hoglet67/RGBtoHDMI/kicad_AmigaAdapter/V2/deniseadapter_bom.ods

Manufacturer | Manufacturer Number | Designator | Qty | Description | Case | SMD/TH
Texas Instruments | SN74LVC86APWR | U1 | 1 | Quad XOR | TSSOP-14 | SMD
Texas Instruments | SN74LVC574APWRG4 | U2,U3 | 2 | Octal Flip-Flop | TSSOP-20 | SMD
Texas Instruments | TLV74333PDBVR | U4 | 1 | LDO Voltage Regulator | SOT-23-5 | SMD
any |  | R1 | 1 | Thick film resistor, 3.3k Ohm, 1% | 2012 | SMD
any |  | C1,C2,C3 | 3 | Ceramic capacitor 100nF | 1608 | SMD
any |  | C4 | 1 | Ceramic capacitor 1uF | 2012 | SMD
any |  | Jdenise1,JDenise2 | 2 | Precision IC-Socket, 24 pn | DIP-24 | TH
any |  | Jbutton1 | 1 | Angled pin header, 2 pins | RM 2.54 | TH
any |  | JP1 | 1 | Angled pin header, 3 pins | RM 2.54 | TH
any |  | JraspberryPiZero1 | 1 | Female pin header 20x2 pins | RM 2.54 | TH
Assmann | WSW AR 24-ST/T | JmainBoard1,JMainBoard2 | 2 | IC socket adapter | DIP-24 | TH
Remarks: Cut away the interconnects on the IC socket adapters before soldering. This allows you to reach the the solder points for the other side.
