hoglet67/RGBtoHDMI/src/scripts/Profiles/6-12_BIT_RGB/_Test/Test_12BPP-Composite.txt

sampling=6,6,6,6,6,6,6,0,1,0,4,0,0,0,0,0,0,5,0,0,100,256,100,256,100,256,0,256
geometry=188,33,640,256,720,280,1,2,1,2,16000000,1024,15000,312,4,0,0
hdmi_standby=1
palette=RrGgBb_(EGA)
overclock_core=50
powerup_message=0
