hoglet67/RGBtoHDMI/src/scripts/Profiles/3-12_BIT_BBC/_Test/Test_3BPP-Comp(B).txt

sampling=5,5,5,5,5,5,5,0,1,0,4,0,0,0,0,0,0,0,0,0,100,256,100,256,100,256,0,256
geometry=188,33,640,256,720,280,1,2,1,2,16000000,1024,15000,312,4,0,0
powerup_message=0
