hoglet67/RGBtoHDMI/src/scripts/Profiles/3-12_BIT_BBC_Analog/_Test/Test_3LVL_Term.txt

sampling=6,6,6,6,6,6,6,0,1,0,4,0,0,0,0,0,0,1,1,0,55,16,55,16,100,256,256,17
geometry=188,33,640,256,720,280,1,2,1,2,16000000,1024,15000,312,4,0,0
palette=RGBrgb_(Amstrad)
powerup_message=0
