hoglet67/RGBtoHDMI/src/scripts/Profiles/6-12_BIT_YUV_Analog/_Test/Test_3LVL_Term+Clamp.txt

sampling=4,4,4,4,4,4,4,0,1,0,4,0,0,0,0,0,0,1,1,1,65,26,55,16,100,256,10,17
geometry=188,33,640,256,720,280,1,2,1,2,16000000,1024,15000,312,4,0,0
palette=RGBrgb_(Amstrad)
powerup_message=0
