hoglet67/RGBtoHDMI/src/scripts/Profiles/6-12_BIT_YUV_Analog/_Test/Test_4LVL_Term.txt

sampling=4,4,4,4,4,4,4,0,1,0,4,0,0,0,0,3,0,2,1,0,55,34,55,34,100,15,15,15
geometry=188,33,640,256,720,280,1,2,1,2,16000000,1024,15000,312,4,0,0
palette=RrGgBb_(EGA)
powerup_message=0
