hoglet67/RGBtoHDMI/src/scripts/Profiles/6-12_BIT_RGB_Analog/_Test_/Multi_Test_Mono_/Mode3_3LVL_NoTerm-C.txt

sampling=6,6,6,6,6,6,6,0,1,0,4,0,0,0,0,0,1,1,0,0,122,60,256,256,256,10,256,256
geometry=180,35,640,256,720,280,1,2,1,2,16000000,1024,5000,314,4,6,0
palette=Mono_(3_level)
powerup_message=0
