hoglet67/RGBtoHDMI/src/scripts/Profiles/6-12_BIT_RGB_Analog/_Test_/Multi_Test_Colour/Mode3_3LVL_NoTerm-C.txt

sampling=6,6,6,6,6,6,6,0,1,0,4,0,0,0,0,0,0,1,0,0,134,68,134,68,100,256,256,87
geometry=188,35,640,256,720,280,1,2,1,2,16000000,1024,5000,314,4,6,0
palette=RGBrgb_(Amstrad)
powerup_message=0
