hoglet67/RGBtoHDMI/src/scripts/Profiles/6-12_BIT_RGB_Analog/_Test_/Multi_Test_Colour/ModeF_192Mhz_Test.txt

sampling=0,0,0,0,0,0,0,0,5,0,8,0,0,0,0,0,0,7,1,0,65,32,65,32,100,48,48,48
geometry=132,39,480,256,576,288,3,4,1,1,12000000,768,5000,318,4,6,0
palette=RrGgBb_(EGA)
powerup_message=0
