hoglet67/RGBtoHDMI/src/scripts/Profiles/6-12_BIT_RGB_Analog/_Test_/Multi_Test_Mono_/ModeF_192Mhz_Test.txt

sampling=4,4,4,4,4,4,4,0,5,0,8,0,0,0,0,0,1,1,1,0,65,36,256,256,256,12,256,256
geometry=132,39,480,256,576,288,3,4,1,1,12000000,768,5000,318,4,6,0
palette=Mono_(3_level)
powerup_message=0
