hoglet67/RGBtoHDMI/src/scripts/Profiles/6-12_BIT_RGB/_Test/Multi_Test/modeD_192Mhz_Test.txt

sampling=1,1,1,1,1,1,1,0,5,0,8,0,0,0,0,0,0,5,0,0,120,256,120,256,120,256,256,256
geometry=128,32,480,256,576,288,3,4,1,2,12000000,768,5000,314,0,6,0
palette=RrGgBb_(EGA)
teletext_deinterlace=2
teletext_scaling=0
powerup_message=0
