hoglet67/RGBtoHDMI/src/scripts/Profiles/6-12_BIT_RGB_Analog/_Test_/Multi_Test_/modeD_192Mhz_Test.txt

sampling=1,1,1,1,1,1,1,0,5,0,8,0,0,0,0,0,0,7,1,0,55,16,55,16,100,34,34,34
geometry=132,35,480,256,576,288,3,4,1,1,12000000,768,5000,314,5,6,0
palette=RrGgBb_(EGA)
powerup_message=0
