hoglet67/RGBtoHDMI/src/scripts/Profiles/6-12_BIT_RGB/_Test/Multi_Test/ModeC_TS9347_80-8LVL_NoTerm.txt

sampling=6,6,6,6,6,6,6,0,1,0,4,0,0,0,0,3,0,4,0,0,227,53,192,18,100,157,124,88
geometry=124,32,480,256,584,288,3,4,1,2,14318181,768,5000,312,0,6,0
palette=Mono_(8_level_RGB)
powerup_message=0
