hoglet67/RGBtoHDMI/src/scripts/Profiles/6-12_BIT_RGB_Analog/_Test_/Multi_Test_/ModeB_TS9347_40-8LVL_NoTerm.txt

sampling=4,4,4,4,4,4,4,0,1,0,4,0,0,0,0,3,0,7,0,0,227,53,192,18,100,157,124,88
geometry=92,29,320,256,384,288,1,1,3,1,9545454,512,5000,312,4,6,0
palette=Mono_(8_level_RGB)
powerup_message=0
