hoglet67/RGBtoHDMI/src/scripts/Profiles/6-12_BIT_YUV_Analog/_Test_/Multi_Test_/ModeB_TS9347_40-8LVL_NoTerm.txt

sampling=0,0,0,0,0,0,0,0,1,0,4,0,0,0,0,3,0,2,0,0,227,192,157,124,100,88,53,18
geometry=92,29,320,256,384,288,1,1,3,1,9545454,512,5000,312,4,6,0
palette=Mono_(8_level_YUV)
powerup_message=0
