hoglet67/RGBtoHDMI/src/scripts/Profiles/6-12_BIT_YUV_Analog/_Test_/Multi_Test_/ModeC_TS9347_80-8LVL_NoTerm.txt

sampling=3,3,3,3,3,3,3,0,1,0,4,0,0,0,0,3,0,2,0,0,227,192,157,124,100,88,53,18
geometry=124,32,480,256,584,288,3,4,1,1,14318181,768,15000,312,5,6,0
palette=Mono_(8_level_YUV)
powerup_message=0
