hoglet67/RGBtoHDMI/(threads)

Thread 9 (2018-11-18):

Use PLLA or PLLD as the GPCLK source

hoglet67, 2018-11-18:
Seems this should be possible.

Advantage is that the core clock speed can remain at 400MHz.

Not clear that it can be set via the firmware property interface.

So would need to include some code to set the PLL registers directly.

Possible code to do this here:
https://github.com/F5OEO/librpitx/blob/8d0ff49fa7d7dc5f98c83a9876000254ae9edbaf/src/gpio.cpp#L139

hoglet67, 2019-04-27:
Another thought: this would probably overcome the issue preventing us using the latest firmware:
https://github.com/raspberrypi/firmware/issues/1022

hoglet67, 2019-04-27:
I've made an attempt at this, in the end using PLLD.

I believe that:
- PLLA is the parent clock for: the audio and PWM outputs
- PLLD is the parent clock for: the camera clock

It would be good to make sure this is the case!

I picked PLLD as it's enabled by default, and gives a GPCLK source of 500MHz (prior to the GPCLK divider). I believe the PLL is actually running at 1000MHz in this case.

Rather arbitrarily, I've allowed the PLL range to be 1000MHz to 15000MHz, giving a GPCLK source of 500MHz to 750MHz. That should be sufficient range, given we can set the GPCLK divider to pretty much any integer value we like.

I couldn't find a mailbox set_clock call that worked for either PLLA or PLLA, so in the end I re-used the same code we've been using to set PLLH by writing to the registers.

I'll push this to dev now, and if you spot any issues Ian then please let me know. I've tested all the profiles, and none of them hang, but that's as far as I've been able to test.

There are two main benefits to making this change:
1. We can now set the core clock to 400MHz independently, which might help in some of the capture loops
2. We can now use the latest firmware (I did just quickly try this, and it's fine).

hoglet67, 2019-04-27:
Some links about the PLLs and/or clock tree:
https://patchwork.kernel.org/patch/8455241/
https://github.com/miegl/PiFmAdv/blob/master/src/pi_fm_adv.c#L409

IanSB, 2019-04-28:
This seems to work OK so far with the PC based profiles on the Pi zero.
It also seems to work a lot better on the PI3 and now works on the 3+ with new firmware:
Mode 0 double height no longer has glitches and I can even select double height and width with no glitches but strangely double width on its own has glitches.
On the PC side CGA mode (14.3Mhz clock) is glitch free in double width plus double height & width but has glitches in double height only which is different behaviour to BBC mode 0.

I can even get glitch free EGA (640x350) in double height & width on the Pi 3 and that doesn't work on the Pi zero although the Pi3 still won't work at VGA resolutions. Definitely something strange about the behaviour of the Pi 3 when some lower bandwidth things don't work properly and some higher bandwidth things do. I tried setting the core to 500Mhz and that helped a bit with VGA but CGA double height had exactly the same glitches so perhaps there is still some dynamic switching feature on the Pi3 that needs to be disabled.

Mode 7 on the Pi3 is still a bit glitchy but less so and I suspect some reworking of the capture loop might fix that so maybe I'll look at that someday.
Overall there seems to be more headroom as I suppose the core memory speed is no longer reduced to match the sample clock.  The Pi3 still won't run at the highest VGA speeds but it certainly has more potential to work with all the standard TV and PC CGA/EGA modes in some form or other if mode 7 can be fixed.
Seems like it's worth updating the firmware to the latest one now as well.

hoglet67, 2019-04-28:
Good to hear you've not hit any issues with this.

I'm still slightly nervous about what else might be using PLLD by default. I do wonder if it's being used by the SDRAM, and by changing it from 500MHz to (upto) 750MHz we are inadvertently overclocking it quite significantly.

Also, I suspect the PLL is actually running at 4x this rate. The documented range of the PLLs is 600MHz-2400MHz, so we should probably use 400MHz->600MHz, not 500MHz->750MHz.

The highest clock we need to generate is 192MHz isn't it? What other highish ones are there?

I'm going to investigate this some more today, and see if I can somehow dump the whole clock tree.

So in the mean time, hold off making any other changes that rely on this being in place.

IanSB, 2019-04-28:
The highest PC clocks are:
VGA text: 28.322Mhz x 6 = 169.932Mhz
VGA Graphics: 25.175Mhz x 6 = 151.05Mhz
I noticed that with the old code, the highest pixel clocks didn't necessarily produce the highest PLL clock speed due to the dividers selected so that may still be true
Some other pixel clocks used by PC = 16Mhz, 16.257Mhz,  14.318181Mhz , 14.161Mhz, 14.171Mhz, 18.013483 Mhz

hoglet67, 2019-04-28:
I'm fairly sure that PLLD is used as the parent clock source for the SDRAM PLL:

So I've been investigating using PLLA. My understanding is the PLLA is generally only used when you specify GPU clocks that are different to the core clocks.

These are the initial PLLA register values:
```
DEBUG: PLLA: 1200.000000
DEBUG: PLLA: PDIV=1 NDIV=62 CTRL=0002103e FRAC=524288 DSI0=256 CORE=2 PER=256 CCP2=256
```
There are four dividers following PLLA:
- DSI0 (for the flat panel displays)
- CORE (for the GPU etc if needed)
- PER (for peripherals)
- CCP2 (for the camera)

A value of 256 means the divider is disables.

This explains why trying to use PLLA_PER as a GPCLK source has not worked for people - it's off by default.

So, I've been messing around with some code that will do two things:
- Enable PLLA_PER and set the divider to 4
- Disable PLLA_CORE so we can see if it's actually being used.

It's a bit fiddly to do this, because it's all rather undocumented, and and there are various controls to prevent accidentally writing to the registers. The code to do (configure_plla) this is not long though:
https://github.com/hoglet67/RGBtoHDMI/blob/dev/src/rgb_to_hdmi.c#L839

Anyway, the result is:
```
CCP2=256
DEBUG: PLLA: 1200.000000
DEBUG: PLLA: PDIV=1 NDIV=62 CTRL=0002103e FRAC=524288 DSI0=256 CORE=256 PER=4 CCP2=256
```
So CORE is now disabled, and PER enabled with a divider of 4.

With these values, our system will run nicely using PLLA as the source.

The PLLA_PER clock range is currently 400MHz-600MHz - this should allow any clock we need up to 200MHz to be generated accurately with an integer GPCLK divider of >= 2.

Dave

IanSB, 2019-04-28:
This new version breaks high pc clock rates
The 28Mhz clock is unusable and the screen is more glitches than video
The 25Mhz clock has a few minor glitches
Some log snippets:

INFO:  Error adjusted clock = 28321714 Hz
INFO:         GPCLK Divisor = 3
INFO:  Target PLL frequency = 1019581728 Hz
INFO:  Actual PLL frequency = 1019581728 Hz
INFO:       Core clock freq = 400000000 Hz
INFO:       Lines per frame = 449, (448.998)

INFO:  Error adjusted clock = 25174627 Hz
INFO:         GPCLK Divisor = 3
INFO:  Target PLL frequency = 906286590 Hz
INFO:  Actual PLL frequency = 906286590 Hz
INFO:       Core clock freq = 400000000 Hz
INFO:       Lines per frame = 525, (524.997)

hoglet67, 2019-04-28:
I can look at that now.

Which profile exactly are these?

hoglet67, 2019-04-28:
I've just tried the TSEND ET3000AX/VGA Text.

The correct (ish) frequency clock is being output, i.e. ~170MHz, so I've not made a stupid error withe the dividers.

So this has to be something more subtle.

Forget for now yesterday's PLLD version, as the SDRAM could will have been very overclocked.

Did these profiles work perfectly in the previous version that varied the Core Clock?

IanSB, 2019-04-28:
Yes, although it would be nice to use the direct register code with the core clock PLL as that would allow the new firmware to be used and also confirm there is no other issue with the new PLL code.

hoglet67, 2019-04-28:
I've hacked an Atom profile to use a 28.63MHz clock, and that seems to work correctly for me:
```
sampling=1,1,1,1,1,1,1,0,6,1,0,0
geometry=268,11,1216,240,304,240,0,8,28636363,1824,0,262,4,0
palette=8
```
On the scope I can see it using a 171.8MHz clock, and there is no jittle/noise at all.

Each pixel is being sampled 4 times, so the horizonal capture width is 1216 pixels.

If I enable Double Height, I see a tiny amount of jitter. Double Width, and Double Height + Double Width seem better.

Let me see if I can make a version that uses the Core Clock PLL, but varies it with direct register access,

IanSB, 2019-04-28:
This is what I get with the profile that worked with the core clock:

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

The first few pixels on each line are good but as it progresses across the line, more and more PSYNC edges are missed.

hoglet67, 2019-04-28:
Which firmware are you using?

Can you include a this part of the debug boot log:
```
INFO: Profile = Atom_V6
INFO:
INFO:
INFO: **********     Raspberry Pi RGB to HDMI Convertor     **********
INFO:
INFO:
INFO:     FIRMWARE_VERSION : 5c9b9ad8
INFO:
INFO:          BOARD_MODEL : 00000000
INFO:
INFO:       BOARD_REVISION : 009000c1
INFO:
INFO:    BOARD_MAC_ADDRESS : baeb27b8
INFO:    BOARD_MAC_ADDRESS : 5f38074b
INFO:
INFO:         BOARD_SERIAL : eaba4b07
INFO:         BOARD_SERIAL : 00000000
INFO:
INFO:            EMMC_FREQ :    200.000 MHz    200.000 MHz    200.000 MHz state=1
INFO:            UART_FREQ :     48.000 MHz   1000.000 MHz   1000.000 MHz state=1
INFO:             ARM_FREQ :   1000.000 MHz   1000.000 MHz   1000.000 MHz state=1
INFO:            CORE_FREQ :    400.000 MHz    400.000 MHz    400.000 MHz state=1
INFO:             V3D_FREQ :    300.000 MHz    300.000 MHz    300.000 MHz state=1
INFO:            H264_FREQ :    300.000 MHz    300.000 MHz    300.000 MHz state=1
INFO:             ISP_FREQ :    300.000 MHz    300.000 MHz    300.000 MHz state=1
INFO:           SDRAM_FREQ :    450.000 MHz    450.000 MHz    450.000 MHz state=1
INFO:           PIXEL_FREQ :    148.500 MHz  -1894.967 MHz  -1894.967 MHz state=1
INFO:             PWM_FREQ :      0.000 MHz    500.000 MHz    500.000 MHz state=0
INFO:            CORE TEMP :  42.77 °C
INFO:         CORE VOLTAGE :   1.35 V
INFO:      SDRAM_C VOLTAGE :   1.20 V
INFO:      SDRAM_P VOLTAGE :   1.20 V
INFO:      SDRAM_I VOLTAGE :   1.20 V
INFO:             CMD_LINE : bcm2708_fb.fbwidth=1920 bcm2708_fb.fbheight=1080 bcm2708_fb.fbdepth=16 bcm2708_fb.fbswap=1 dma.dmachans=0x7f35 bcm2708.boardrev=0x9000c1 bcm2708.serial=0xeaba4b07 bcm2708.uart_clock=48000000 bcm2708.disk_led_gpio=47 smsc95xx.macaddr=B8:27:EB:BA:4B:07 vc_mem.mem_base=0x1fa00000 vc_mem.mem_size=0x20000000  sampling06=3 sampling7=0,2,2,2,2,2,2,0,8,5 info=1 palette=0 deinterlace=6 scanlines=0 mux=0 elk=0 vsync=0 vlockmode=0 vlockline=5 nbuffers=2 debug=0 m7disable=0 keymap=123233 return=1
```

IanSB, 2019-04-28:
I was using the most recent firmware that also worked with the PI3+ but I just reverted back to the standard version and that made no difference.
Here's the log:
```
INFO: **********     Raspberry Pi RGB to HDMI Convertor     **********
INFO:
INFO:
INFO:     FIRMWARE_VERSION : 5a9d7465
INFO:
INFO:          BOARD_MODEL : 00000000
INFO:
INFO:       BOARD_REVISION : 00900093
INFO:
INFO:    BOARD_MAC_ADDRESS : a6eb27b8
INFO:    BOARD_MAC_ADDRESS : 5f38b64e
INFO:
INFO:         BOARD_SERIAL : 3fa64eb6
INFO:         BOARD_SERIAL : 00000000
INFO:
INFO:            EMMC_FREQ :    250.000 MHz    250.000 MHz    250.000 MHz state=1
INFO:            UART_FREQ :     48.000 MHz   1000.000 MHz   1000.000 MHz state=1
INFO:             ARM_FREQ :   1000.000 MHz   1000.000 MHz   1000.000 MHz state=1
INFO:            CORE_FREQ :    400.000 MHz    400.000 MHz    400.000 MHz state=1
INFO:             V3D_FREQ :    300.000 MHz    300.000 MHz    300.000 MHz state=1
INFO:            H264_FREQ :    300.000 MHz    300.000 MHz    300.000 MHz state=1
INFO:             ISP_FREQ :    300.000 MHz    300.000 MHz    300.000 MHz state=1
INFO:           SDRAM_FREQ :    450.000 MHz    450.000 MHz    450.000 MHz state=1
INFO:           PIXEL_FREQ :    148.500 MHz  -1894.967 MHz  -1894.967 MHz state=1
INFO:             PWM_FREQ :      0.000 MHz    500.000 MHz    500.000 MHz state=0
INFO:            CORE TEMP :  41.16 °C
INFO:         CORE VOLTAGE :   1.35 V
INFO:      SDRAM_C VOLTAGE :   1.20 V
INFO:      SDRAM_P VOLTAGE :   1.20 V
INFO:      SDRAM_I VOLTAGE :   1.20 V
INFO:             CMD_LINE : bcm2708_fb.fbwidth=1920 bcm2708_fb.fbheight=1080 bcm2708_fb.fbdepth=16 bcm2708_fb.fbswap=1 dma.dmachans=0x7f35 bcm2708.boardrev=0x900093 bcm2708.serial=0x3fa64eb6 bcm2708.uart_clock=48000000 bcm2708.disk_led_gpio=47 smsc95xx.macaddr=B8:27:EB:A6:4E:B6 vc_mem.mem_base=0x1fa00000 vc_mem.mem_size=0x20000000  console=ttyAMA0,115200 kgdboc=ttyAMA0,115200 console=tty1 root=/dev/mmcblk0p2 rootfstype=ext4 rootwait
```

hoglet67, 2019-04-28:
I've created a test build in branch pllc_direct_access.

This uses PLLC with direct register access.

Changes are quite small: 1e909110

There are a few UART glitches when the frequency changes, but just ignore that.

It would be great if you could test this, with and without this line commented:
   // Enable the PLLA_PER divider
   //configure_plla(PLL_PER_DIVIDER);

IanSB, 2019-04-28:
OK I found the problem:
I had merged in my recent pull request when building and the problem is caused by uncommenting
// #define USE_PROPERTY_INTERFACE_FOR_FB
When the FB is created by the property interface call I get glitches, when it is created by the deprecated method it works.

hoglet67, 2019-04-28:
Great, that explains why I couldn't reproduce it at this end.

Shall I merge the updated pull request?

hoglet67, 2019-04-28:
I've just compared logs without  USE_PROPERTY_INTERFACE_FOR_FB. The only significant difference I can see is in the alignment of the frame buffer returned:
(1) Framebuffer address: DF7FD000 (without USE_PROPERTY_INTERFACE_FOR_FB)
(2) Framebuffer address: DE79AEAC (with USE_PROPERTY_INTERFACE_FOR_FB)

With my  Atom VX Test Profile (28MHz Pixel Clock, 6bpp sampling, Normal FM Size), I do see a big difference between them. (1) is perfect, (2) is definitely not:
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

Ignore the aspect ratio, the frame buffer is 1920x270

hoglet67, 2019-04-28:
If you force an alignment, the issue goes away!

IanSB, 2019-04-28:
>  Shall I merge the updated pull request?

Yes, it's only using  USE_PROPERTY_INTERFACE_FOR_FB on the Pi 3 now and I suspect a lot of the performance issues are down to that
However the latest PLLA build won't run at all on the Pi3, it just hangs during boot at:
```
INFO: RGB to HDMI booted
```
Any Ideas what's causing that?

It does run with the PLLC build so maybe the Pi3 is using something extra in PLLA

> If you force an alignment, the issue goes away!

I recall the early ARMs used paged mode access to RAM for a speed improvement (they had no cache) so maybe the unaligned buffer is causing a slowdown in RAM access to the uncached screen.

If we can get it running on the PI3 again I'd be interested in the performance difference with a forced alignment

hoglet67, 2019-04-28:
OK, I've added a 64KB Alignment, and gone back to USE_PROPERTY_INTERFACE_FOR_FB for all models. That's now working with my Atom VX test case with no jitter.

Regarding the Pi 3 issue, has it ever worked with a build that uses PLLA?

Is your log in Debug mode? I'm surprised you don't get a few more lines, e.g. the Cache being enabled.
```
INFO: ***********************RESET***********************
INFO: RGB to HDMI booted
DEBUG: enable_MMU_and_IDCaches
DEBUG: PLLA: 1200.000000
DEBUG: PLLA: PDIV=1 NDIV=62 CTRL=0002103e FRAC=524288 DSI0=256 CORE=2 PER=256 CCP2=256
DEBUG: PLLA: 1200.000000
DEBUG: PLLA: PDIV=1 NDIV=62 CTRL=0002103e FRAC=524288 DSI0=256 CORE=256 PER=4 CCP2=256
DEBUG: Setting up divisor
DEBUG: A GP_CLK1_DIV = 00000000
DEBUG: B GP_CLK1_CTL = 00000200
DEBUG: C GP_CLK1_CTL = 00000004
DEBUG: D GP_CLK1_CTL = 00000004
DEBUG: E GP_CLK1_CTL = 00000004
DEBUG: F GP_CLK1_CTL = 00000014
DEBUG: G GP_CLK1_CTL = 00000094
DEBUG: H GP_CLK1_DIV = 00006000
DEBUG: Done setting up divisor
INFO: CPLD  Design: Normal
```
I suspect disabling the PLLA_CORE divider is causing the problem. It's possible that it's used on the Pi 3 for the UART.

I don't have a functional Pi 3 to test with.

Can you try commenting out these lines:
```
   // Disable PLLA_CORE divider (to check it's not being used!)
   CM_PLLA            = CM_PASSWORD | (((CM_PLLA) & ~CM_PLLA_LOADCORE) | CM_PLLA_HOLDCORE);
   gpioreg[PLLA_CORE] = CM_PASSWORD | (A2W_PLL_CHANNEL_DISABLE);
```
Could you post a full debug log, regardless of whether this helps or not.

IanSB, 2019-04-28:
No, it's never worked with the PLLA build, just the PLLC and PLLD builds

Here's a debug log of the PI3 hang:
```
INFO: RGB to HDMI booted
DEBUG: enable_MMU_and_IDCaches
DEBUG: PLLA: 1200.000000
DEBUG: PLLA: PDIV=1 NDIV=62 CTRL=0002103e FRAC=524288 DSI0=256 CORE=2 PER=256 CCP2=256
DEBUG: PLLA: 1200.000000
DEBUG: PLLA: PDIV=1 NDIV=62 CTRL=0002103e FRAC=524288 DSI0=256 CORE=256 PER=4 CCP2=256
DEBUG: Setting up divisor
DEBUG: A GP_CLK1_DIV = 00014000
DEBUG: B GP_CLK1_CTL = 00000096
DEBUG: C GP_CLK1_CTL = 00000084
```

hoglet67, 2019-04-28:
Yes, I agree it's hanging in init_gpclk. So this line is interesting:
```
DEBUG: B GP_CLK1_CTL = 00000096
```
(bits 7, 4, 2, 1)
That's the initial value of the GPCLK1 control register before we do anything.

On a Pi Zero it's:
```
DEBUG: B GP_CLK1_CTL = 00000200
```
(bits 8)

The bits are:
```
3..0 are the clock source (0=disabled, 6=PLLD)
```
4 - CM_GP1CTL_ENAB
7 - CM_GP1CTL_BUSY
8 - CM_GP1CTL_BUSYD

So it looks like on the Pi 3 the GPCLK1 is running by default. I think that might be because it's used for the Ethernet Phy clock, so the firmware has already configured it.

Possibly I need to cleanly stop it first.

But that wouldn't explain why it starts up when using PLLC and PLLD.

So more likely, I think, is that PLLA_PER is not running (that caused me a hang, but later on  after the log line marked F.

I'll have a think.

IanSB, 2019-04-28:
> OK, I've added a 64KB Alignment, and gone back to USE_PROPERTY_INTERFACE_FOR_FB for all models.

I just tried adding the 64K alignment to the PLLC code to see how that ran on the PI3 and it doesn't work, it behaves exactly the same way as using the deprecated call on the PI3 so I assume that call is actually working but setting up a similar alignment which for some reason doesn't work properly on the PI3.
Using either the deprecated call or the official call with alignment results in a full initialisation and blank screen but the code then calls rgbtofb and hangs up in that so I think it must have an incorrect address for the screen buffer at least.

hoglet67, 2019-04-28:
I'm confused - I thought you had the Pi 3 "sort-of" working yesterday. What's different now?

IanSB, 2019-04-28:
> I'm confused - I thought you had the Pi 3 "sort-of" working yesterday. What's different now?

I was using the PLLC build and changed:
```
     RPI_PropertyAddTag(TAG_ALLOCATE_BUFFER);
     to
     RPI_PropertyAddTag(TAG_ALLOCATE_BUFFER, 0x10000);
```
and that's enough to stop it working with the same symptoms as using the deprecated call

hoglet67, 2019-04-28:
Try a smaller value of alignment, 0x1000 or 0x20 for example.

What framebuffer addresses are coming back.

hoglet67, 2019-04-28:
I've just pushed a change to dev that might get slightly further through gpclk_init() on the Pi 3.

Could you give it a try, and post a debug log please?

IanSB, 2019-04-28:
> What framebuffer addresses are coming back.
```
FD8B57E8 - no alignment
FF884000 - using 0x10, 0x100 or 0x1000 alignment
FF880000 - using 0x10000
FF800000 - using 0x100000
```
Only the unaligned one works
The hang appears to be in rgbtofb as that is called but it never returns, even when keys are pressed.
I'm not really sure what would cause a hangup in there unless writing to non-existant screen ram is causing an unhandled exception.
What happens when you write to unallocated memory space?

IanSB, 2019-04-28:
> I've just pushed a change to dev that might get slightly further through gpclk_init() on the Pi 3

It gets a little further:
```
INFO: RGB to HDMI booted
DEBUG: enable_MMU_and_IDCaches
DEBUG: PLLA: 1200.000000
DEBUG: PLLA: PDIV=1 NDIV=62 CTRL=0002103e FRAC=524288 DSI0=256 CORE=2 PER=256 CCP2=256
DEBUG: PLLA: 1200.000000
DEBUG: PLLA: PDIV=1 NDIV=62 CTRL=0002103e FRAC=524288 DSI0=256 CORE=256 PER=4 CCP2=256
DEBUG: Setting up divisor
DEBUG: A GP_CLK1_DIV = 00014000
DEBUG: B GP_CLK1_CTL = 00000096
DEBUG: C GP_CLK1_CTL = 00000086
DEBUG: D GP_CLK1_CTL = 00000006
DEBUG: E GP_CLK1_CTL = 00000004
DEBUG: F GP_CLK1_CTL = 00000014
```

hoglet67, 2019-04-28:
I wonder of PLLA is completely disabled on the Pi 3. Could you add the following to the start of gpclk_init():
```
log_debug("XOSC_CTRL = %08x", gpioreg[XOSC_CTRL]);
```
Bit 6 is A2W_XOSC_CTRL_PLLAEN

Bit 18 is A2W_XOSC_CTRL_PLLAOK

On the Pi Zero, I thing this defaults to 0x000ff0ff

On the frame buffer alignment issue, that's really weird. I'll need to do some more digging.

Not having a functional Pi 3 is going to make this a pain to debug!

IanSB, 2019-04-28:
> Could you add the following to the start of gpclk_init():

```
INFO: ***********************RESET***********************
INFO: RGB to HDMI booted
DEBUG: enable_MMU_and_IDCaches
DEBUG: PLLA: 1200.000000
DEBUG: PLLA: PDIV=1 NDIV=62 CTRL=0002103e FRAC=524288 DSI0=256 CORE=2 PER=256 CCP2=256
DEBUG: PLLA: 1200.000000
DEBUG: PLLA: PDIV=1 NDIV=62 CTRL=0002103e FRAC=524288 DSI0=256 CORE=256 PER=4 CCP2=256
DEBUG: Setting up divisor
DEBUG: XOSC_CTRL = 000ff0ff
DEBUG: A GP_CLK1_DIV = 00014000
DEBUG: B GP_CLK1_CTL = 00000096
DEBUG: C GP_CLK1_CTL = 00000086
DEBUG: D GP_CLK1_CTL = 00000006
DEBUG: E GP_CLK1_CTL = 00000004
DEBUG: F GP_CLK1_CTL = 00000014
```

hoglet67, 2019-04-28:
Hmm, thanks. That looks fine. I'm out of suggestions for now.

Tomorrow I'll dig out a Pi 2 that I have somewhere, and see if that also has the same problem.

hoglet67, 2019-04-29:
It seems I can actually use the Pi 2 to work on both of these issues.

So first the frame buffer address/alignment issue, when using the property tag interface.

I can confirm that frame buffer addresses that start with 0xFF are definitely bogus, because that maps to where the hardware registers are placed. Hence the nasty crash on clear_screen.

I can also confirm that when no parameter is specified to TAG_ALLOCATE_BUFFER call, then a random value is actually used, due to the way rpi-mailbox-interface.c is written. In my case, that seemed to be 0x02140704, hence the weird alignment you get. So a value definitely should be passed.

Based on this, I tried passing in 0x02000000 (32MB) and that actually worked. The frame buffer the started at  0xFE000000.

I also tried passing in 0x04000000 (64MB) and that worked as well. The frame buffer the started at 0xFC000000.

It would be interesting to see if you get the same results on the Pi 3.

This is definitely very weird behaviour, and no one else seems to be seeing it.

IanSB, 2019-04-29:
> It would be interesting to see if you get the same results on the Pi 3.

Yes that works on the Pi3 as well and there is definitely an improvement in performance once aligned with double height etc working in modes 0-6 and PC resolutions. Mode 7 is still glitchy with that stall we noted previously but overall a significant improvement in performance.

hoglet67, 2019-04-29:
I've pushed some more bit and pieces, mostly to do with making it easier to use different PLLs in the builds for each of the Pi models.

I've been doing some testing on the Pi 2, with PLLC and PLLD, using the Atom V6 profile. With both, I'm getting some very inconsistent results. There seems to be an issue with the code the measures the time for 100 lines.

Sometimes it works correctly:
```
INFO:         clkinfo.clock = 7159090 Hz
INFO:      clkinfo.line_len = 456
INFO:     clkinfo.clock_ppm = 0 ppm
INFO:     Nominal 100 lines = 6369500 ns
INFO:      Actual 100 lines = 6370742 ns
INFO:           Clock error = 194 PPM
INFO:  Error adjusted clock = 7157694 Hz
INFO:         GPCLK Divisor = 10
INFO:  Target PLL frequency = 1145231080 Hz
INFO:  Actual PLL frequency = 1145231080 Hz
INFO:       Lines per frame = 262, (261.999)
INFO: Actual frame time = 16691352 ns (non-interlaced), line time = 63707 ns
```
And sometimes it's way out:
```
INFO:         clkinfo.clock = 7159090 Hz
INFO:      clkinfo.line_len = 456
INFO:     clkinfo.clock_ppm = 0 ppm
INFO:     Nominal 100 lines = 6369500 ns
INFO:      Actual 100 lines = 3822446 ns
INFO:           Clock error = -399882 PPM
INFO:  Error adjusted clock = 11929488 Hz
INFO:         GPCLK Divisor = 6
INFO:  Target PLL frequency = 1145230848 Hz
INFO:  Actual PLL frequency = 1145230848 Hz
INFO:       Lines per frame = 262, (261.999)
INFO: Actual frame time = 10014818 ns (non-interlaced), line time = 38224 ns
```
What's weird is when it's out, it's always out by the same ratio (6/10) so it things the source rate is 100Hz, rather than 60MHz.

I'm guessing the ARM clock being used for the time measurements is somehow being modified.

What I don't understand is why it's not consistent. I have genlock off by default. Usually, just pressing the genlock button will fix it.

It's hard to debug, because it never happens with the debug build.

IanSB, 2019-04-29:
> It's hard to debug, because it never happens with the debug build.

I found this comment about the Pi2:
Regular dynamic downclocking of the CPU can occur due to USB power supply/cable issue

BTW I found the debug builds to be unusable with autoswitching because the debug messages printed during recalculate_hdmi_clock (which is called indirectly from the assembler frame loop) cause the measurement of a frame to vary which results in a drop out of frame capture and an attempt to select another profile repeatedly.
I think all debug messages in recalculate_hdmi_clock and your new pll code relating to the HDMI clock need to be optionally suppressed using a #define
One other thing: There is an error in the BBC_Micro.txt profile:
sampling=2,2,2,2,2,2,2,0,6,5,0
should be
sampling=2,2,2,2,2,2,2,0,6,0,5,0
due to the new mux setting

hoglet67, 2019-04-30:
I've fixed the BBC_Micro profile issue, thanks for spotting that.

Yes, it was indeed a power supply issue causing ARM throttling from 1000MHz down to 600MHz. I'm running the Pi 2 of a separate supply now and it's fine.

I've just updated the Pi firmware blob to the latest version, and that seems fine as well.

The TSENG ET3000AX/VGA Text suffers extreme jitter on the Pi 2, but that's to be expected I guess.

IanSB, 2019-04-30:
Very high pixel clock rates like the TSENG ET3000AX/VGA Text & VGA Graphics only work on the Pi zero but the 50 & 60 Hz TV standards + EGA can be made to work on the others. The only exception is mode 7 deinterlace which still doesn't work on the Pi3 (and I presume the Pi2) although I have some ideas to improve that which I might look at later as those speed up ideas would be needed for a further improvement to mode 7 deinterlace to eliminate the remaining 1 frame of 'fizz' when a character changes.

hoglet67, 2019-05-06:
Closing this issue, as I think everything I intended to do has been done.

The only outstanding part was I never managed to get PLLA to work as a GPCLK source on a Pi 2/3. I tried pretty much everything I could think of, but to no avail.

hoglet67, 2020-01-28:
See #134 for why PLLA didn't work on the Pi 2/3 (Thanks Ian)

Closed 2019-05-06.

Thread 40 (2019-03-10):

Calibration errors with half height frame buffers

IanSB, 2019-03-10:
Calibrating with double height off has cursor generated errors

hoglet67, 2019-03-10:
I'll have a go at fixing this now (and updating the cmdline.txt file)

hoglet67, 2019-03-10:
Fixed now.

Closed 2019-03-10.

Thread 43 (2019-03-11):

Screen capture extremely slow or not working

IanSB, 2019-03-11:
It takes about 40 seconds to write a capture to a sandisk card and it seems to hang up completely when writing to kingston or verbatim cards (waited a few mins).

hoglet67, 2019-03-11:
I'm in the middle of debugging this.

There seems to be two issues:

1. I'm seeing occasional SD command errors, which are resolved if I slow the SD Card clock down. It's currently fixed at 25MHz.

2. After each multi-block write command (of 8 512b sectors) there is a full re-initialization of the EMMC hardware and SD Card. This I think is taking ~100-200ms and is what's clobbering the write performance.

I need to test if both of these error also happen on Dom's Pi1MHzBus port of BeebSCSI.

The files are also currently huge (~1MB) as there is no compression. Switching to LodePNG will fix this I hope, but might mask the SD card write issue, which is more concerning.

Dave

hoglet67, 2019-03-11:
Above post edited.

For reference, some links related to bugs in John Cronin's SD Card Library:
https://www.raspberrypi.org/forums/viewtopic.php?f=72&t=94133

hoglet67, 2019-03-11:
Ian,

I've added a work around to the SDCard driver that really helps with the performance.

As far as I can tell Multi Block Writes (CMD25) were seriously broken, because the card ended up in the wrong state. It least for the cards that I have, this workaround really helps.

I'm going to have a play LodePNG library now....

Dave

hoglet67, 2019-03-11:
Ian,

I've now switched over to the LodePNG library (both are still available in the code).

I've also slowed the SD Card clock down from 25MHz to 20MHz. This seems to have helped a bit, but I'm still seeing occasional errors like:
```
EMMC: BCM2708 controller power-cycled
INFO: Screen capture starting, file = capture34.png
INFO: Screen capture PNG length = 10396, writing data...
SD: error sending CMD24, error = 01048576.  Retrying...
SD: error sending CMD24, error = 00065536.  Retrying...
```
Those error codes are 2^20 and 2^16 which correspond to:
#define CMD_TIMEOUT(a)      (FAIL(a) && (a->last_error & (1 << 16)))
#define DATA_TIMEOUT(a)     (FAIL(a) && (a->last_error & (1 << 20)))

See if this works any better for you.

I'll keep digging into these errors. I did read there were some bugs in the SD card driver code to do with setting the clock speed.

Dave

hoglet67, 2019-03-11:
Last word on this (I hope)...

I've just done some better fixes for the multi block write and timeout issues.

I've not seen any problems since, and I've tried a couple of different cards.

Closing for now.

Closed 2019-03-11.

Thread 54 (2019-03-12):

V3 Investigate possibility of adding half odd/even to CPLD

IanSB, 2019-03-12:
I've been testing mode7 at 192 MHz clock rate with a new mode 7 half odd/even sample loop and it seems to be completely stable. Although this is well out of spec it is potentially useful for those beebs with a very asymmetric 12 Mhz clock as it doubles the resolution and it removed the last twinking pixels on one of my systems. Unfortunately with double the psync rate there is no time to read memory and so deinterlacing doesn't work.
Could this be implemented in the CPLD with a switch that enabled half odd/even mode? (i.e. put every other pixel in the shift reg and halve psync)
This would work with the existing capture loop without any changes.

To get most benefit you would probably need to increase the offsets to 4 bits to make full use of the double resolution and there's not enough registers to do that but maybe worth some experimentation.
The odd/even bit would be acting as the global MSB of all offsets (or maybe acting as the global LSB would be better?)

hoglet67, 2019-03-12:
I've had a go at this: you can find it in the cpld_v4 branch.
https://github.com/hoglet67/RGBtoHDMI/tree/cpld_v4

I had a lot of trouble getting it to fit, and in the end had to trade extra macro cells for product term savings (by pipelining a couple of signals). This means that currently all macro cells are used. I could do with one more, to give psync an extra cycle of skew (i.e. 2 rather than 1, to be safe).

There's definitely not enough registers to increase offset to 4 bits. But you do have the full resolution, because of the choice between half-odd and half-even. Auto calibration would need to search both, and it's possible there are edge cases if the ideal sampling points straddle the boundary.

I thought about reducing delay, but doesn't that need to be 4-bits for the worst case alignment in Mode 7? On my beeb delay is currently 11. BTW, there was additional work in the CPLD so that delay works units of whole pixels in he half sampling mode. This cost an extra counter bit.

According to the timing analysis, it's guaranteed to work at ~90MHz (which is the same as before).

I'm far from sure we should go with this... it's consumed pretty much all the remaining resources in the CPLD. Hence it's currently in a separate branch. I want to see if it gives better calibration results for me as well, on Beebs that are artificially clobbered (i.e. change the capacitor back again).

By the way, did you do the capacitor mod to your problematic beeb? It would be good to see what's actually wrong with the 6MHz clock.

Dave

hoglet67, 2019-03-12:
Done a couple more changes, to allow for arbitrary skew on PSync, and save a register at the same time! Amazing what's possible with a bit of head scratching. I'm now warming to this version....

IanSB, 2019-03-13:
This is looking very promising.
In my case, when even is selected I get very poor calibration with every position having some amount of noise. When odd is selected I get excellent calibration with a wide band of noise free settings.
If we go with this, if one of the odd / even options is already selected in mode 7 then the calibration should try both and switch to the one with the best result.
I've also been trying this version with some TTL VGA signals and managed to get 640x480@60Hz locked cleanly at 6 bits per sample. I have a card with both analog VGA and TTL EGA type connectors but it only seems to output VGA timings on the EGA connector but after some further code optimisation I managed to get it to lock cleanly with no noise. This is with a pixel clock of 25.175Mhz so real EGA should work no problem.
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
settings were:
sampling=0,3,3,3,3,3,3,0,6,4,1 geometry=10,25,81,490,648,490,0,8,151050000,4800,5000,0
One issue is that we definitely need a sync inversion bit. I've added one as a test and it fitted OK but the other issue is that to make inverted sync detection easier I think that VSYNC should be separate from HSYNC (on the CSYNC line) so we need to remove the xor of the two and feed the VSYNC directly to the PI for software control.
I think this could be achieved by connecting the link through to the spare pin on the CPLD an then onto the GPIO 22 (making GPIO 22 an input instead of an output and making spare an output) or alternatively cut the track to GPIO 22 and feed VSYNC straight in.

hoglet67, 2019-03-13:
That's great news about TTL VGA, and rather amazing. That's a PSYNC clock speed of 6.29375MHz compared to the normal sampling Beeb rate of 2MHz (If I have my sums right). So more than 3x faster. That's pretty amazing. You should post that captured screen shot in thread!

On the half-rate sampling, something is now quite adding up for me here....

All that's happening in this mode with a double speed clock is that the sample positions are closer together. If you are seeing a wide band of noise free settings (i.e. say 3 or more) then in normal mode at least one position should also be noise free. If not, then something unexpected is happening.

I need to do some more testing with my Beeb with a socketed capacitor.

Dave

IanSB, 2019-03-13:
> All that's happening in this mode with a double speed clock is that the sample positions are closer together. If you are seeing a wide band of noise free settings (i.e. say 3 or more) then in normal mode at least one position should also be noise free. If not, then something unexpected is happening.

I think it's working more or less as expected.
With 96Mhz my best alignment was at around 5 +-1 but it wouldn't always give perfect results and there was still some twinkling.
With 192 Mhz most of the even alignment was poor which corresponds to the lower half of the 92 Mhz alignment (0-3) the odd alignment was good which corresponds to the upper half of the 92 Mhz alignment (4-7) since 5 is in the middle of that range it's not surprising that there is now a relatively good band around the centre of the offset range of 0-7 in 192 Mhz mode. Effectively I'm getting the equivalent of 5 +- half a pixel at 92 Mhz and that half seems to pick the best result.

hoglet67, 2019-03-14:
I think this can now be closed.

Closed 2019-03-14.

Thread 82 (2019-04-07):

Add protection to sync and rgb inputs

IanSB, 2019-04-07:
I think I just damaged a CPLD by plugging the 'hat' PCB back into an unpowered Pi while being connected to the computer RGB & sync source. (This was on a PC so Pi powered via 5v supply)

I have done this multiple times but after doing it this time, the Vertical sync was very jumpy, mostly when pressing the buttons but occasionally when it was just sitting there.
The source had +ve Hsync (mostly low) and -ve Vsync which would be mostly high so maybe allowed enough current to flow to cause issues.

I tried reprogramming the CPLD but that didn't help so I replaced it and so far that appears to have fixed it so we definitely need some protection on the inputs. Any thoughts on the best approach for this? Diodes or something else?

hoglet67, 2019-04-08:
In theory, it's possible to damage a XC9500XL CPLD input by feeding a 5V signal into it when the device is unpowered. There's a bit written about this on page 12 of the datasheet. So this might be unrelated to the act of plugging this back into the Pi.  With inputs > 3.5V you do need to be careful about power supply sequencing.

The only occasion I've damaged a RGBtoHDMI setup was a different case. The hat and the Pi were initially separate. The hat was connected to a switched Beeb. The Pi was connected to an LCD monitor that was in stand-by. All I did was plug the two parts together. Both were unpowered at the time. This ended up blowing the a GPIO input on the Pi, likely the pin that first made contact.
Because my monitor is un-earthed and the Beeb is earthed, it's possible for the monitor to float at quite a high voltage wrt ground. This voltage, I think, ended up being discharged via  the Pi's GPIO protection diode, which ended up causing damage.

I'm now very careful to disconnect the HDMI cable before plugging a Pi and a Hat together.

Your case may well be CPLD damage, but did you check by trying another Pi?

hoglet67, 2019-04-08:
I had a couple more thoughts about this.

**1. Driving an unpowered CPLD**

An unpowered XC9500XL series part should be able to handle up to 4V on it's inputs. Here's the reference:
https://www.xilinx.com/support/documentation/user_guides/ug445.pdf#page=17

It would be interesting to measure your VSYNC signal to see if it actually gets to much more than 4V. It really depends on the driver technology, but a 74LS TTL driver cannot drive much above this anyway, as there is a diode in the output path.

You say the issue seemed intermittent. In my experience damaged I/Os are usually permanently stuck, so I wonder if there is another cause...

**2. Intermittent connection between the Pi and the Hat**

It's interesting that you suggested the problem was intermittent was associated with pressing the buttons. I've had a problem exactly like this, and it turned out to be a poor/intermittent connection between the Hat and the Pi. In my case, the dodgy connection was on one or two of the pixel bus signals, and this would manifest as vertical lines on the screen that came and went as you flexed the boards.

Do you use spacer between the hat and the Pi?

Without spacers, I've found that over time (months) the slight flexing of the connector when you press the buttons causes damage to the socket on the hat. And after a while, you start to get bad connections.

The 0.1" female headers are not really designed for repeated insertions, especially cheap, unbranded parts. The harwin ones from RS are only rates for about 50 cycles. I'm sure I've exceeded this by now on my first board (which is now slightly dodgy) if not screwed together.

What make of headers did you end up using?

Bottom line, I actually suspect that you didn't have a problem with the CPLD after all. If it's the connector that is dodgy, then unplugging an re-plugging may help for a while, but eventually the problem will recur, especially if movement is possible in the connector.

IanSB, 2019-04-08:
> Your case may well be CPLD damage, but did you check by trying another Pi?

Yes I tried another Pi - no difference.
> What make of headers did you end up using?

The Harwin ones in your BOM. No spacers but I have some now.
I reseated the hat several times but it made no difference. I don't think I've cycled the connector 50 times yet.

The hat was connected to a powered PC and plugged into an unpowered Pi but that was connected to a monitor so it was earthed and the PC was earthed as well.

I tried moving / reseating the board again with the new CPLD but it remained completely stable.
The 'bad' CPLD came off physically undamaged so maybe I'll fit it to another board sometime to see if it still has the problem.

IanSB, 2020-05-06:
This has been addressed by the addition of the Extender board layouts.

Closed 2020-05-06.

Thread 90 (2019-04-16):

Update cpld_atom to use the standard capture line code

hoglet67, 2019-04-16:
1. Update Atom CPLD to pack into 6-bit wide pixels

Done but not pushed yet.

2. Update cpld_atom  to use:
- capture_line_normal_4bpp_table
- capture_line_normal_8bpp_table

Done but not pushed yet.

3. Resolve palette issue

The colour map used by the Atom CPLD is:
0x00 - Black
0x01 - Red
0x02 - Green
0x03 - Yellow
0x04 - Blue
0x05 - Magenta
0x06 - Cyan
0x07 - White
0x08 - Orange
0x09 - Bright Orange
0x0A - Dark Green (Text Background)
0x0B - Dark Orange (Text Background)

In 8-bpp mode, the palette is configured as per the above

In 4-bpp mode, capture_line_atom_4bpp did the following transformation on the fly:
- 0x08,0x09 => 0x03 (yellow)
- 0x0A,0x0B => 0x00 (black)

This was so only colours 0-7 were actually used, leaving bit-3 in the frame buffer free for the menus.

We need to think of a way to achieve the same net effect with the standard code.

Options I can think of:

1. In the Atom CPLD, change the color encoding to use bits 4 and 5, i.e.:
- 0x13 = Orange
- 0x23 = Bright Orange
- 0x10 = Dark Green
- 0x20 = Dark Orange

Now, simply ignoring the higher bits, the 4bpp capture code will get the right result.

Problem is, I don't think this will fit in the CPLD.

2. In the Atom CPLD, have a pin (or scan bit) to select between 3 and 6 bit capture.

Might fit, not tried.

3. Keep the custom capture code for 4bpp mode (yuk!)

4. Drop 4bpp capture mode for the Atom CPLD

We would need to add a way for the CPLD driver to indicate to the higher levels that only 8 BPP frame buffers are compatible.

Ian, any thoughts on this?

IanSB, 2019-04-16:
If you can get option 1 working then by all means do it but otherwise I think option 4 is sensible. There isn't any real need to operate in 4bpp mode as it requires 8bpp for correct operation. Same as all the PC stuff really, if I switch to 4bpp mode in 6 bit capture I get all wrong colours. They might be slightly less wrong than the Atom but wrong none the less. Setting the bit depth correctly is just part of the configuration, just like selecting the palette in the first place.

There isn't much left that uses 4bpp mode anyway, just mode 7 (which won't work in 8bpp mode at all so is similar to the Atom but the other way around). Even modes0-6 uses 8bpp by default now to support the 127 colour in band mode.

I wonder if I could use 8bpp for mode 7 and use the extra bits as the comparison buffer (their state has no effect on the ouput as the palette is programmed repeating the same 8 colours).

hoglet67, 2019-04-16:
I've managed to do option (1)

1a3b861b and ef8f4a75

It works very well in both 4BPP and 4BPP modes.

I'll push the updated profile tomorrow.

IanSB, 2019-04-21:
You might want to switch on double height and width for the Atom profiles.
Also are the Atom palettes technically correct?
The 6847 only outputs 4 luminance levels but the standard saturated 8 colour RGB part of the Atom palette converts to 8 separate luminance levels.

hoglet67, 2019-04-21:
Yes, I'll switch on double height/width.

The original Acorn Atom Colour Card output TTL-level RGB, which is why I'm using 100% R/G/B. None of them directly applied a analog YUV->analog RGB transformation.

There is a separate Atom Monochrome palette, which accurately reflects what you see if you just hook up the Y output to a monochrome monitor. i.e. just 4 levels.

It might be possible to calculate a colour palette such that when fed through the monochrome palette filter, results in the right luminescence levels. I have no idea what that would do to the colour levels thought.

IanSB, 2019-04-21:
> The original Acorn Atom Colour Card output TTL-level RGB

The 50Hz Mk II colour card certainly did a conversion to TTL RGB but the original colour card was just a PAL encoder that produced 60Hz PAL and worked with very few colour TVs.
See: https://stardot.org.uk/forums/viewtopic.php?t=11321
I don't know if that did a similar conversion.
You might find a 6847 palette in a tandy color computer emulator or maybe a dragon 32 emulator.

hoglet67, 2019-04-21:
Interesting that you found the "Acorn PAL Encoder" design - I had completely forgotten about it.

I've actually never seen one, so I don't really know what the colours look like in practice.

For reference, the schematic is here.
http://stardot.org.uk/mirrors/www.bbcdocs.com/filebase/hardware/circuit/atom_colour_encoder_cct.png

It uses 2x LM1496 balanced modulators. The Dragon 32 uses the LM1889.

I've just added two more Atom Palettes:
- One taken directly from XRoar
- The other made up by myself, such that the Y value is correct, but still using saturated colours.

Here's the XRoar one:
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

IanSB, 2019-04-23:
I had a look at this myself and I don't think you can ever get a perfect palette that both looks good and is a true representation of the intended colours at the same time.
You either end up with something that looks good but isn't reversible back to YUV due to clipping (like the Xroar one) or is reversible (to 4 level mono) but has poor contrast or poor saturation (like the Acorn PAL one).

The problem is that the maximum Y level output of the 6847 cannot be treated as 100% because you only get 100% Y with zero U and V and it uses 100% both for white and some bright colours which is why it's referred to as "Buff" and not white.
I created a YUV to RGB algorithm that converts the actual voltage levels from the 6847 YUV outputs as described in the datasheet to 0-255 RGB and that produces exactly the XROAR values when luma and chroma are set to 100% but the values have to be clipped as they go out of range which means they can't be reversed back to YUV.

However I may have come up with a compromise which gives reasonable brightness and saturation while still giving a good representation of the actual 6847 colours and it's reversible back to 4 levels of Y.

I've attached an experimental version of OSD.C & OSD.H which uses the above algorithm and allows adjustment of the luminance percentage by using the genlock line value (temporarily renamed as luminance%) while automatically desaturating each colour individually until the RGB values are reversible back to YUV and thus 4 levels.

[osd.zip](https://github.com/hoglet67/RGBtoHDMI/files/3105390/osd.zip)

Build using these files, call up the settings menu, change the palette to "Atom desaturated" and then adjust the LUMINANCE% value until you get a good looking result (around 80-85% seems a good compromise). Too high and colours like yellow get desaturated to white and too low and the image is too dim.

The calculated values are output in the serial log so once you select a suitable luminance value the output RGB values can be used in an updated OSD.C
With a luminance value of around 80-85 I think this looks better than Atom Pal and maybe Xroar and it's reversible to monochrome. It does tend to push the green and cyan close together but that might be improved by further tweaking of the saturation of those two colours.

Note due to rounding errors the Y value can be off by 1 on some conversions so the final RGB values may need some manual tweaking to get consistent Y results as even an off by 1 shows up when you switch the output colour to mono/green etc.

hoglet67, 2019-04-23:
That's a nice piece of work there Ian. We should try to keep this code in place, but with a hard coded luminance value of 80%.

One thing I would change though. I think the dark green/dark orange text background are way too bright. Looking at the code, you have them at the same luminance value as red/blue (i.e. 650mV). In practice, I they are actually black (720mV).

If you hook up just the composite video output of the Atom (pin 9 of PL4) to a suitable TV, you can verify there is no difference between the text background and true black (e.g. the border). I think the data sheet also confirms this. I'm pretty sure they only become visible because they have different UV values.

Out of interest, I've just dug out my old MK3.5 Atom Colour Card from Phill, schematic attached.
[AtomColour.pdf](https://github.com/hoglet67/RGBtoHDMI/files/3107192/AtomColour.pdf)
[LMH1251.pdf](https://github.com/hoglet67/RGBtoHDMI/files/3107193/LMH1251.pdf)

This looks a bit like your Atom desaturated palette, but not really the same. I think this is because the LMH1251 is expecting Rec. 601 U/V signals, which the Atom PA and PB are not.

I think the answer, ultimately, is that there is no right answer. i.e. it's all quite subjective, and which you prefer is probably influenced by what you are used to.

Dave

hoglet67, 2019-04-23:
If you set the Y value of dark green / dark orange to 720mV (same as block), but then change yuv2rgb
```
        double y = (double) (luma_scale * 255 * (770 - y1_millivolts) / (770 - 420))/100;
```
then it looks quite good (completely subjective!)

The reason I picked 770 is that's what the 6847 outputs during the back porch, which I think is then used by most systems as the black level reference.

You do have to reduce the brightness on the monitor though to compensate, so black is black, not grey.

But then you see the text background as a very dark green/orange. But if you then turn the color down to 0 in the TV settings, they become indistinguishable from black.

IanSB, 2019-04-23:
> I think the answer, ultimately, is that there is no right answer. i.e. it's all quite subjective, and which you prefer is probably influenced by what you are used to.

Yes, but at least this version produces correct monochrome levels which must mean it's somewhat close.
Perhaps we can get Fwapp from the stardot post linked above to post some screenshots of his pal encoder output (he's building one of these converters for a ZX81 so might be interested in helping)

Here's another test version with some more tweaks:
1. Changes suggested above
2. Converted to integer arithmetic to avoid some annoying rounding errors
3. restrict rgb range to 2-253 (also helps with rounding errors)
4. Add separate U and V scaling using the vsync indicator to switch it on and off:
Valid YUV signals have different max ranges for U and V (+-0.436 for U and +-0.615 for V)
The old code scaled both the same but you can now switch on the above using the vsync indicator to get unequal U & V scaling. This means that some colours can have a higher saturation without going out of range and in this case switching it on boosts magenta, cyan & green.

Have a try and see which one you prefer.
Note you selected 80 as the optimim value but that produces "off by 1" errors for the luminance.
With Unequal U & V off, 81 produces matching luminance values
With Unequal U & V on, 79 produces matching luminance values

Can you try both and let me know which one you prefer.
Also please post some screen grabs from the atom with those palettes as I've been testing with a BBC so only looking at the first 8 colours.
[osd-test-v3.zip](https://github.com/hoglet67/RGBtoHDMI/files/3108572/osd-test-v3.zip)

hoglet67, 2019-04-23:
Here's some snaps from osd-test-v3.zip:

With Unequal U & V off, 81:
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

With Unequal U & V on, 79:
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

Now, after quite a bit more fiddling, I think it's probably a mistake to have set the black reference level to 770. Main reason being black is very much grey, and I have to drop the brightness on my TV/Monitor from 50% to 20% to get it looking "right" again. Doing this only for the Atom is going to be annoying.

Instead, if we want to see a slightly difference colour for the text background, then I think I prefer upping the Y level from 720 to 710 or 700, for just the two text background colours. But this is technically incorrect, so probably we should include both options (like I did with normal and extended).

Here's two more snaps, with black reference back at 720, and 710 for the two background colours,

With Unequal U & V off, 81:
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

With Unequal U & V on, 79:
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

Here's two more snaps, with black reference back at 720, and 700 for the two background colours,

With Unequal U & V off, 81:
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

With Unequal U & V on, 79:
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

Also, I'm starting to wonder if we are doing something wrong with gamma. There's quite a difference between what you see on the screen (with a normal brightness level of 50%) and what you see in the PNG on another monitor. The biggest difference is perceived black level in the PNG is much lower. But then again, the black level on my TV changes massively with vertical viewing angle anyway.

Hope this helps, but I suspect it won't!

hoglet67, 2019-04-23:
When it comes down to it, I don't think I would ever choose to use a palette where the text background colour was anything other than black (same as the border).

I think this is just because I'm not used to seeing a difference between the border and the text background:
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
It's actually much more obvious than this when viewed on my TV, hence the earlier comment about gamma.

But I do very much like the rest of the colours, including buff rather than white, which is how it's described in the data sheet.

So, for me the best is probably a black reference level of 720, Y levels of 720 for all three of the "black" colours, a luminance of around 80%, and probably Unequal U & V off.

IanSB, 2019-04-23:
> probably Unequal U & V off.

Yes it looks like it's pushing the orange towards pink but it was worth a try (That option was trying to completely fill the YUV colourspace without going overrange)

> Also, I'm starting to wonder if we are doing something wrong with gamma.

Gamma is really under the control of the display device so we shouldn't be changing it.

>  I think it's probably a mistake to have set the black reference level to 770

Technically it's the right thing to do. NTSC has different levels for blanking and black so US TVs were adjusted to compensate for the offset. PAL has the same level for blanking and black so any NTSC source will always have a slightly grey background when displayed on PAL devices.

Sounds like we need maybe four Atom palettes:
Atom Mk1 (with black backgrounds on text)
Atom Mk1 full (with pedestal and dark green/orange backgrounds on text)
Atom Mk2 (with TTL RGB + orange)
Atom Mk2 full (with TTL RGB + orange + dark green/orange backgrounds on text)

There isn't any need for an Atom Mono as that is now covered by selecting mono on the Mk1 colour card settings. I don't think there is a need for an 8 colour Mk2 colour card palette as that can be created either by using the standard RGB palette which repeats every 8 colours or switch to 4 bpp mode with one of the Mk2 colour card settings.

I'll merge the yuv2rgb code back into the original osd.c

hoglet67, 2019-04-23:
I'd like to keep two additional ones:
- Atom Acorn - this is pure TTL RGB, with orange mapped to read
- Atom XROAR - because this is a useful data point for what the Dragon people think the 6847 looks like

IanSB, 2019-04-23:
> Atom Acorn - this is pure TTL RGB, with orange mapped to red. This is what the Acorn 202,006 card looks like.

I think you get that if you select the standard RGB palette because of the way you mapped the colours on the six bit capture side (the RGB entries repeat every 8 colours)

hoglet67, 2019-04-23:
Yes, I think you are right,

IanSB, 2019-04-23:
Actually just checked and it could be done but the two oranges are currently mapped to 0x0B and 0x13 which both map to colour 3 which is yellow. This also breaks the 4 bpp mode as well I think.
To map to red they should map to 0x09 and 0x11.

The dark green / orange map to 0x08 and 0x10 which will correctly map to black with the RGB palette and also in 4bpp mode.
Can this be fixed in the CPLD?

hoglet67, 2019-04-23:
Ah yes, that was a deliberate choice that I would rather not change.

Mapping of orange->yellow is (subjectively of course) much better (because it's a much brighter colour, so the text is clearer). I could happily use that mode for long periods, which is not the case when mapping orange->red.

Both "Atom Acorn" and "Atom XROAR" are mainly for reference use. I would not expect anyone to choose to use them. So I guess both of these need to stay.

Dave

hoglet67, 2019-04-24:
I think this issue is now all done.

Closed 2019-04-24.

Thread 91 (2019-04-17):

Allow CPLD driver to provide a default profile

hoglet67, 2019-04-17:
I regularly switch one system between a Beeb and an Atom.

When switching from Beeb to Atom, it's actually quite hard to change the profile from BBC_Micro to Atom_CPLD, because the menu is very flickery and barely visible.

(I think this is just because the Atom is running at 60Hz and the Beeb profile is 50Hz.)

Anyway, it would be nice if the CPLD driver could provide a default profile, that would be used as a fallback if profile.txt was missing.

I quickly tried this, and it doesn't work quite as expected, because file_read_profile() is called in a way that causes profile.txt to get written (even if there is no change of profile).

(I think as a general principle we should try to minimise unnecessary writes to the SD card, as you are more likely to end up with corruption if the use powers off the system at the wrong time).

Anyway, it would be good to only write profile.txt when the user actually changes the profile.

IanSB, 2019-04-24:
> When switching from Beeb to Atom, it's actually quite hard to change the profile from BBC_Micro to Atom_CPLD, because the menu is very flickery and barely visible.

I think this is because of the mode 7 auto switching code which works even when the menu is on screen.
For the PC style mode changes, I disabled auto switching when the menu is on screen to avoid loss of menu but it isn't disabled for BBC auto switching so when you feed Atom signals into a BBC profile it gets confused and starts switching between mode 7 and modes 0-6.
I think that the code that handles switching needs to be improved so it doesn't lose the menu on a false trigger. This is probably the last preparatory change required before implementing full BBC profiles.

IanSB, 2019-04-24:
Thinking about it, what's needed for the BBC side is to improve the robustness of the mode7 / mode 06 detection when fed non-bbc signals or if that's not possible, reducing the number of times it exits rgbtofb with a detection (e.g. delaying mode 7 detection for a few seconds after entering rgbtofb would at least reduce the period of menu flashing to once every few seconds.

hoglet67, 2019-04-25:
I've investigated this issue some more.

What's interesting is that it was specific to the Atom CPLD, and didn't occur when a Atom was connected via the Beeb interface (using the Normal CPLD).

What's happening is:
- Beeb profile accidentally selected, with autoswitch=mode7
- Atom timing looks like mode 7, so mode7 = 1
- If mode=7, the OSD is written just once (i.e. the mode 7 line capture code preserves the OSD bit)
- The Atom CPLD uses 6bpp sampling, but we don't have mode7 6bpp line capture code
- So instead, the default line capture code is used
- Which then clobbers the OSD

I've just committed a quick work around which forces autoswitch to off if the Atom CPLD is detected.

I was wondering if the CPLD should advertise whether autoswitch should be supported (e.g. by renaming cpld->old_firmware() to cpld->get_capabilities(), and defining some capabilities like
- SUPPORTS_CONTINUOUS_PSYNC
- SUPPORTS_PSYNC_DELAY
- SUPPORTS_AUTOSWITCH
I held off, because getting the right set of capabilities is important, otherwise we'll only make the problem worse.

IanSB, 2019-04-25:
Yes, I think cpld->get_capabilities() would be useful for supporting multiple CPLD variations.

IanSB, 2019-04-26:
Rather than disable autoswitching with the Atom CPLD, perhaps disabling mode 7 switching would be preferable as there is a possible use case for normal auto switching with the Dragon 32. If you connect the Atom CPLD board to a Dragon 6847 it will work at 50Hz so both 50 and 60 hz profiles could be put into an autoswitching set.

hoglet67, 2019-04-27:
That's a sensible suggestion, which I've just implemented (e5e5771)

hoglet67, 2019-05-06:
Done...

Closed 2019-05-06.

Thread 97 (2019-04-21):

New PCB ideas

IanSB, 2019-04-21:
I thought I'd start a discussion about a new PCB layout or layouts.
Minimal changes over current PCB:
Add a 9 way 'D' socket for BBC and PC use at the other end of the pcb so it fits into the current case. This will also involve moving the reset button. Using a 9 Way D means that PC users don't need a custom cable. BBC users will always need a custom cable as the standard 6 way connector won't fit in the case.
Add a link to switch pin 9 of the D connector between Vsync and +5v. Use in the vsync position for a PC and the +5v position for a BBC.  This does mean a potential hazard when plugging a BBC configured board into a PC as that will short Vsync to +5v but one possible way around this would be to fit the opposite gender D connector on the BBC only version.
You could treat the PC version as universal and just always power it externally even when connected to a BBC.
The alternative is to fit a high density 15 way "D" which has enough pins for 5v and maybe extra control lines for analog front end converters but that means custom cables for PCs as well and invites connecting VGA leads which could also result in damage.

Fit terminating resistors (also helps when some inputs are unused / floating)

Mux options: Using 6 bits means the Mux option no longer works although the pads for the buffer chip could remain with the option to fit it as long as PCs are never connected, perhaps using the reverse gender D connector mentioned above.
i.e. BBC build has +5v on pin 9, buffer chip and reverse gender D. Universal/PC version has vsync on pin 9, no buffer chip and standard D.

Other options:
Connect CPLD programming lines to the Pi so it can bring up a new system without a programmer. (Also saves the PCB space of the programming header)

Use SIL resistor packs instead of surface mount where possible. Optionally support through hole LEDs

I think that any analog versions will have to be separate PCBs like your Atom converter
Three current ideas:
Simple mono video using two comparators:
This could be implemented on a PCB the same size as the current one with a phono socket on the end of the board. The threshold voltages for the sync and video comparators could be set by D to A converters (I2C etc) so no trimmers required

Amstrad CPC464
Could be implemented on a PCB similar to the Atom board.

Composite colour
Again could be implemented on a PCB similar to the Atom board but would require a general purpose TV front end chip.

IanSB, 2019-05-06:
I've just been looking at the practical aspects of putting a 9 way dsub connector on the board.
I've mocked up a test using a piece of veroboard and it looks promising with the right type of connector although there won't be any mechanical support apart from the soldered legs:
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

hoglet67, 2019-05-07:
Ian,

Maybe I will pull my finger out and have a go at laying out a V2 PCB.....

Do you have a part number for the 9-pin DSUB connector that you used?

Looking at the photos, it seems to be protruding about 5mm beyond the case, due to having longish pins. Is that the case?

I was wondering whether this kind of D connector might better:
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
https://uk.rs-online.com/web/p/pcb-d-sub-connectors/0472764/

The pins, with a slight about of bending in, would I think  just touch either side of the PCB (a kind of surface mount).

The advantage is that it doesn't foul the reset pins on the Pi Zero.

IanSB, 2019-05-07:
> Do you have a part number for the 9-pin DSUB connector that you used?

https://uk.farnell.com/mh-connectors/mhdd9f-t-b-m-rbm/d-sub-connector-receptacle-9pos/dp/2533065
The male equivalent is
https://uk.farnell.com/mh-connectors/mhdd9m-t-b-m-rbm/d-sub-connector-plug-9pos/dp/2533069

> The pins, with a slight about of bending in, would I think just touch either side of the PCB (a kind of surface mount).

The main problem with that would be fitting in the current case as I think there would have to be a large slot cut all the way up the one end of the case and possibly into the top as well.
> The advantage is that it doesn't foul the reset pins on the Pi Zero.

The above farnell connectors don't seem to foul the reset connector either.
Here are some further pics of the above with the case cut to fit:
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

The end result is a little more clunky looking that I had hoped. It might be better to move the d sub further into the case so the plate is much closer or touching the end of the case which would also mean moving it upwards for clearance (i.e. pins pushed further through the pcb) and increasing the size of the case slot. That might also help with mechanical stablity.

The alternative is to do something like the Atom board in a bigger case which would allow some of the analog mono video options to be added and maybe even a beeb style video connector as well as a 9 way dsub but this off the shelf case is so suitable in other ways with all the precut holes that it would be a shame not to use it.

BTW getting the self programming working would also help with the layout as you could remove the programming header as well as the link and r6 which would free up some space in that area.

I'll try moving the dsub further into the case as mentioned above to see if that's feasible.

IanSB, 2019-05-08:
I moved the Dsub further into the case and it looks much better now:
(Doesn't appear to foul anything)

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
The metal part of the dsub should just be touching the PCB. (The end of the veroboard had already been cut away a bit but doesn't need to be so the Dsub will be clamped between the pcb edge, the top of the slot in the case and the bottom edge of the case. (Assuming the slot is cut correctly)

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
The back 5 pins of the connector need to be roughly in line with the two rightmost pins of the GPIO connector but getting this exactly right might require some trial and error. The bottom of the Dsub is exactly in line with the join between the top and bottom half of the case.
NOTE the pins on these Dsubs narrow at the end but the holes will have to be larger than the ends as the main part of the pin will have to pass through the PCB

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
I overcut the slot on the top part of the case so an unnecessary gap is visible.
Also about half each of the two clips that hold that end of the case shut have to be cut away but it still seems to hold securely

IanSB, 2019-05-08:
It might be worth adding some unmasked ground plane along the edge of the pcb by the Dsub so that it could be soldered to the Dsub body for additional mechanical strain relief (see ringed area):
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

IanSB, 2019-05-08:
> I'm not sure when I'll be starting to work on this

No problem, just discussing ideas for now.

> retain the 74LS08 (so it works with the older Elks which I think are more common)

I've been trying this with my issue 4 electron which doesn't have buffered RGB outputs and it seems fine, I couldn't see any difference with mux on or off. What was the problem you were seeing?

Using a right angle 5x2 IDC connector of some sort on the underside of the PCB at the current RGB end looks feasible in which case only the 10 way captive ribbon cable would have to come out of the case at the other end. This would mean the RGB signals could remain at  the same end they are at the moment thus avoiding most of the issues with rework you mentioned above.

I'm going to order some 5x2 connectors to see what is practical.
If that works, the minimum changes required would be:
Remove programming header (assuming self programming works)
Remove link & R6
Move CPLD closer to reset button using space freed up by the above
Change 6x1 rgb connector to 5x2
Add terminating resistors (possibly SIL 2x 5 pin or 1x 9 pin)
(uses space freed up by moving the CPLD a few mm)
Change leds to through hole.
This only leaves the 74LS08 and the options would be
Leave as is but only fit for an electron
Replace with a faster hex buffer / inverter to always buffer all 6 rgb signals.

IanSB, 2019-05-08:
[repost due to strange timestamp issue]
> I'm not sure when I'll be starting to work on this

No problem, just discussing ideas for now.
> retain the 74LS08 (so it works with the older Elks which I think are more common)

I've been trying this with my issue 4 electron which doesn't have buffered RGB outputs and it seems fine, I couldn't see any difference with mux on or off. What was the problem you were seeing?

Using a right angle 5x2 IDC connector of some sort on the underside of the PCB at the current RGB end looks feasible in which case only the 10 way captive ribbon cable would have to come out of the case at the other end. This would mean the RGB signals could remain at the same end they are at the moment thus avoiding most of the issues with rework you mentioned above.

I'm going to order some 5x2 connectors to see what is practical.
If that works, the minimum changes required would be:
Remove programming header (assuming self programming works)
Remove link & R6
Move CPLD closer to reset button using space freed up by the above
Change 6x1 rgb connector to 5x2
Add terminating resistors (possibly SIL 2x 5 pin or 1x 9 pin)
(uses space freed up by moving the CPLD a few mm)
Change leds to through hole.
This only leaves the 74LS08 and the options would be
Leave as is but only fit for an electron
Replace with a faster hex buffer / inverter to always buffer all 6 rgb signals.

hoglet67, 2019-05-08:
> I've been trying this with my issue 4 electron which doesn't have buffered RGB outputs and it seems fine, I couldn't see any difference with mux on or off. What was the problem you were seeing?

The "high" levels of R,G,B were only going up to about ~1.3v (IIRC), which isn't quite enough to reliably be treated as a '1' by the CPLD. This manifested as very obvious noise visible in large blocks of colour. Buffering through the LS08 worked, because its threshold is lower than the CPLD.

It might also depend on the instance of the ULA, the power supply voltage, what add-ons are present. I think I was using a Plus One at the time as well.

IanSB, 2019-05-10:
Using a 5x2 IDC connector looks feasible at the current RGB end of the PCB with a captive cable out of the case. Only bare 5x2 pins would be usable though as a shrouded connector like the one used in the Atom converter is too big:
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
Placement would have to be exact as there are pins from one of the switches on one side and the 40 way connector on the other but it looks like it should just about fit.
It fouls the serial debug port but that could be fitted on the other side of the board as long as the pins don't pass through the board. (The pads could be moved or removed entirely as the 3 pin serial debug connector could be soldered directly on to the 40 way header for those that need it)

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

The pins could be fitted at the other end of the PCB like the 9 way Dsub above to allow direct external connection but again clearance is an issue and also this means a large square hole would have to be cut into the case instead of a simple slot for the cable.

hoglet67, 2019-06-18:
Ian,

You'll be pleased to hear I've got the CPLD programming from the Pi working, and with no GPIO dedicated pins.

I ended up with the following mapping:
```
SP_CLK    => TCK
SP_CLK_EN => TMS
SP_DATA   => TDI
MODE7     => TDO
```
In normal use of the CPLD, SP_CLK_EN is high on every riding SP_CLK edge, which is exactly what's needed to hold the JTAG state machine in the reset state.

(I might revisit the use of MODE7 for TDO, as I just realised there is an LED attached to that signal.)

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

I've pushed some initial code to a branch:
https://github.com/hoglet67/RGBtoHDMI/tree/embedded_cpld_programming/src/jtag

A bit more work is required on the following:
- search the file system for CPLD files (currently hardcoded to cpld.xsvf)
- separate directories for Atom and Beeb versions
- generate progress updates on the OSD during programming

IanSB, 2019-06-19:
> I've got the CPLD programming from the Pi working

Looks good, I'll give it a try soon.

I found another raspberry pi case which might be a suitable alternative. It's aluminium and has a large cutout on the top (I presume for a heatsink) which could be used for a general purpose connector like a 10 way IDC socket although it's position might make routing of other signals to the 40 way header difficult.  (Holes for leds and switches would still have to be drilled.)

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

As mentioned above last month, the other idea is a 10 way header under the pcb and a captive ribbon cable which could end either in a BBC / PC / Spectrum128 etc connector or in a cable mounted 10 way IDC plug which would then allow different cables to be swapped around

hoglet67, 2019-06-20:
I'm not sure like the aesthetics of the cable coming out of the top.

On the subject of the subject of the Pi based CPLD programming, I've been doing some more testing, especially looking for ways to "brick" the system that are hard to recover from.

Here are some notes on what I've found....

(1) Once the four wires are in place, it's no longer possible to reprogram the CPLD using the cable because of interference from the Pi. To over come this, it's necessary to force the Pi's GPIO into a high impedance state. An easy way to do this is to boot the Pi without the SD Card Present.

(2) If the erasure step succeeds, but the reprogramming doesn't, then you ended up not being able to have another try because on reboot our software on the Pi detects an invalid CPLD and halts. I've now fixed this by detecting a blank CPLD (the 12-bit version comes back as FFF) and proceeding with a null CPLD driver. This allows access to the OSD menus, and you can try to re-program again. That said, the only time I have had this happen was with a duff .xsvf file that seemed to leave the device in the erased state.

(3) If you reprogram the Beeb RGBtoHDMI board with the Atom CPLD, then you end up with a nicely bricked system. You can't even reprogram it using the Xilinx Platform cable. This is because the CPLD pinouts are very different. It turns out the TMS and TDI end up being connected to CPLD outputs, not CPLD inputs, and the conflicts prevent the JTAG interface from functioning.

The last of these (3) is very nasty. I was able to recover by temporarily disconnecting the wires I had soldered to TMS and TDI. But if these connections has been made on the PCB itself, then the only course of action would have been to lift pins on the CPLD. In a new version of the PCB, there needs to be a means to temporarily disconnect Pi <===> Jtag signals from other pins on the CPLD.

hoglet67, 2019-06-20:
At the moment, I've got separate directories for the Atom CPLD and Beeb CPLD firmware files.

Which of these is uses by the Pi software is currently controlled by a new profile setting cpld_firmware_dir. The default is /cpld_firmware/bbc and this is overridden in the Atom CPLD profile to /cpld_firmware/atom.

I would have likely a way to make this more bomb proof. At the moment, on the Beeb RGBtoHDMI board, I can selected the Atom CPLD profile, and then reprogram the CPLD, which will seriously brick the board as described above.

If there is a CPLD already programmed, then we could infer the PCB type from that. But that doesn't help in the case where the CPLD is initially unprogrammed. Ideally we would have a way for the Pi to identify the PCB version that doesn't involve the CPLD. But I can't think of a way of doing that at the moment that works with the existing PCBs.

IanSB, 2019-06-20:
> I'm not sure like the aesthetics of the cable coming out of the top.

It's not great but I thought I'd mention the option.
My current preferred option is the 10 way header + captive cable from 10May above.

> I'm also wondering where to place the Update CPLD menu

Does this work on the Atom board?
Maybe rather than having a specific menu option, just detect a CPLD file in the root during bootup and prompt for an update. After a successful update, auto delete the file so the prompt is no longer seen.
Perhaps use a filename prefix convention so that the Atom CPLD is prefixed with Atom_ and BBC with BBC_and refuse to program the file unless it has the right prefix.

> In a new version of the PCB, there needs to be a means to temporarily disconnect Pi <===> Jtag signals from other pins on the CPLD.

Perhaps hard wired jumper pads so nothing needs to be fitted by default. If required you cut the track links then use solder blobs to repair afterwards. (Laid out on the underside of the board to avoid using up pcb space.)

BTW I thought of a way to use the MUX option without having to permanently buffer all 6 signals:
Use a 74LS125 as the RGB buffer. This has tristate outputs so could be switched to tristate when MUX disabled and the outputs would only be driven when MUX enabled.

IanSB, 2019-06-28:
I've tried this and it seems to work well, not had any programming failures so far.

IanSB, 2019-12-03:
New 6 bit board implemented so closing this now

Closed 2019-12-03.

Thread 118 (2019-12-21):

Seven bit mode

IanSB, 2019-12-21:
It should be possible to tweak this project:
https://github.com/c0pperdragon/A-VideoBoard
to output four or seven bit TTL for C64 and Atari respectively (C64 has 16 and Atari has 128 colour possible combinations).
This should be fine for the C64 but currently we are 1 bit short for Atari machines.

We should be able to get a 7 bit mode running without any hardware changes by using the VSYNC input as the seventh bit. (The 7 bits will fit into the 8 bit frame buffer without any problems as we only use 1 bit for the menu).

To do this without hardware changes would mean that only 1 seven bit pixel could be acquired per psync cycle as there are only 12 GPIO pins to transfer data which would halve the max pixel clock rate but as it currently maxes out at 28Mhz in six bit mode that would mean 14 Mhz in seven bit mode and the Atari has a ~7.16Mhz dot clock so there should be plenty of headroom.

There are a couple of registers left in the RGB CPLD so enough to add 1 bit to the capture mode setting but I don't know if the remaining logic could be squeezed into it.
In any case if it proves impossible, a new 7 bit CPLD could be designed.

hoglet67, 2019-12-23:
>  BTW do you think it would be possible to get a 7 bit mode implemented in the RGB cpld?
( see #118 )

I tried a simple experiment - just extend the scan chain by 1 bit (i.e. 1 extra register), and this failed to route (even with this exhaustive fit mode enabled).

The only way I could get it to route was ti unconstrain the pinout (by removing the .ucf file)

So I think it's unlikely this will ever fit unless the existing logic can be somehow simplified.

One thing I meant to ask you - one of the recent changes (swap_bits) has made the logic for the G functions a bit more complex. Can you explain what this is actually doing?

If you want to pursue this, I would suggest starting a new CPLD design that strips out the multiple sample offsets. That frees up a big chunk of space. As far as I'm aware, only Beeb Mode 7 has such an asymmetric pixel clock.

For future reference, here's the diff of what I tried:
```
diff --git a/vhdl/RGBtoHDMI.vhdl b/vhdl/RGBtoHDMI.vhdl
index 4c24da5..b45c3a6 100644
--- a/vhdl/RGBtoHDMI.vhdl
+++ b/vhdl/RGBtoHDMI.vhdl
@@ -68,7 +68,7 @@ architecture Behavorial of RGBtoHDMI is
     constant VERSION_NUM_RGB_ANALOG : std_logic_vector(11 downto 0) := x"C71";

     -- Sampling points
-    constant INIT_SAMPLING_POINTS : std_logic_vector(23 downto 0) := "000000011011011011011011";
+    constant INIT_SAMPLING_POINTS : std_logic_vector(24 downto 0) := "0000000011011011011011011";

     signal shift_R  : std_logic_vector(3 downto 0);
     signal shift_G  : std_logic_vector(3 downto 0);
@@ -105,7 +105,7 @@ architecture Behavorial of RGBtoHDMI is
     -- pixel clock is a clean 16Mhz clock, so only one sample point is needed.
     -- To achieve this, all six values are set to be the same. This minimises
     -- the logic in the CPLD.
-    signal sp_reg   : std_logic_vector(23 downto 0) := INIT_SAMPLING_POINTS;
+    signal sp_reg   : std_logic_vector(24 downto 0) := INIT_SAMPLING_POINTS;

     -- Break out of sp_reg
     signal invert   : std_logic;
@@ -166,7 +166,7 @@ begin
     half     <= sp_reg(18);
     delay    <= unsigned(sp_reg(20 downto 19));
     rate     <= sp_reg(22 downto 21);
-    invert   <= sp_reg(23);
+    invert   <= sp_reg(24);

     -- Shift the bits in LSB first
     process(sp_clk, SW1)

```

IanSB, 2019-12-23:
>  Can you explain what this is actually doing?

It is a roundabout way of making a 3 input to 2 bit encoder.
There are 3 comparators on the green input.
In one mode I use this as 2 video comparators (sensing 3 levels of video) and a sync slicer.
In the other mode I use this as 3 video comparators (sensing 4 levels of video)
The two options above are switched by the mux input

The lo comparator feeds the lo green bit and the hi comparator feeds the hi green bit with the third comparator feeding the vsync input.
When mux is low, the possible combinations on the green bits fed to the pi are:
00 when both comparators low
01 when the lo comparator is active
11 when both the lo and hi comparators are active.
Any sync detected by the G/Y sync comparator is available on the Vsync input

When mux is high, the possible combinations on the green bits fed to the pi are:
00 when all 3 comparators low
01 when the  lo comparator is active
10 when both the lo and Vsync comparators are active (Vsync going active caused 01 to become 10)
11 when all three comparators are active (Vsync being active causes 11 to swap but that is no change)

hoglet67, 2019-12-23:
Thanks, that makes sense, in a roundabout sort of way. ;-)

I built up the V2 analog boath this afternoon, and it's working nicely now with my Atom.

I'll create a new issue to record my experiences, so they don't get lost here.

IanSB, 2020-01-01:
If the proposed 7 bit mode used a new cpld design it could be increased to 8 bits per pixel by using the P19 pin as well (currently used for clamp and analog board detection).

Also it should be possible to capture three 8 bit samples in two psync edges, splitting the middle sample into the unused 4 bits of each psync edge.

That would imply a max clock rate of three quarters of the current maximum which would be around 21 Mhz. (3/4 * 28Mhz). I think that would be enough to capture the elan / enterprise which has 8 bit TTL RGB available internally. (3 bits G & R + 2 bits B).
see: http://enterprise.iko.hu/schematics/EP64-3~0.jpg

IanSB, 2020-09-08:
I think this has been covered by multiple commits for >6 bit support together with C64 and Atari support:

https://github.com/hoglet67/RGBtoHDMI/pull/154/commits/91564b9ed91b63f258ab2fcea3559bdb8b0df5b8
https://github.com/hoglet67/RGBtoHDMI/pull/156/commits/8ee368fdf21279c255e5a00607fa21b7032405bf

Closed 2020-09-08.

Thread 119 (2019-12-22):

Future changes to RGB/YUV interface

IanSB, 2019-12-22:
There are some potential changes to the next issue of the RGB/YUV interface:
1. Move the termination control from the DAC output to the CLKEN line. The CLKEN GPIO signal is used during updates of the CPLD register chain and the DAC plus reprogramming the CPLD but at other times its state is irrelevant so it could be used to control termination on/off. This means termination will 'blip' during CPLD and DAC updates but that could be mitigated by feeding it through an R/C network to filter out the blip and only leave the long term logic level.
This would free up one DAC to allow a fourth level for BR / UV comparators which might help in the case of the TI-994/a and allow 4 levels of RGB as there are already 4 levels available on the green channel. The extra hardware support required for this would be 2 comparators and probably 1 TTL logic IC to do the 4 level to 2 bit  encoding which wouldn't fit on the current board without moving to SOP packages and probably a 4 layer PCB so would not be implemented on the next issue of the current board but any future board with this would be software compatible with the current design if this change was made now. One minor problem I noticed when testing this is that the CLKEN GPIO line is pulled high for several seconds during Pi bootup which is undesirable as it means unterminated inputs get a termination load during that time. That could be fixed by using normally closed analog switches and inverting the switching and clamping logic.

2. Add clamping to the BR / UV inputs. This could be done in two ways: Add another switch IC and associated passives or reconfigure the existing termination/clamping design to have 3 clamping switches and 1 termination switch instead of 1 clamping and 3 termination.
The former would again not fit on the current board space without moving to SOP/4layer but the latter design would likely fit although it would mean a change in the termination functionality so that all 3 inputs would normally be terminated with a weak pulldown which was just enough to allow discrimination of the three RGB levels on the Amstrad and Spectrum and only the green/Y input could be terminated in 75R which would mean that could only be used in mono or maybe YUV mode.

IanSB, 2020-09-08:
#1 was addressed with the issue 3 analog board
#2 was not implemented

Closed 2020-09-08.

Thread 123 (2019-12-23):

Update on the new V2 Analog Frontend

hoglet67, 2019-12-23:
I thought I would create a issue to record my experiences with the V2 Analog Frontend, so I can find it again in the future.

I built up the V2 Analog Frontend board this afternoon and it's working nicely now with my Atom.

Firstly, here's your notes from the Stardot PM:

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

Here's what I'm seeing with the Atom:

With the RGB CPLD there is always a bit of occasional noise, no matter how I tweak the thresholds. I think you reported the same above. With the YUV CPLD that noise goes away, and everything is perfect.

Note, this currently running with Cx1 - Cx6 (DAC decoupling caps) not fitted.

In the YUV CPLD there are three features that might be helping, that you loose with the RGB CPLD:

1. the L and C noise filters are clearly making a difference. If you disable them the zero-error calibration window narrows dramatically (from 4 positions wide to 1 position wide).

2. the back porch clamp will do a better job of setting a refrence black level than a sync tip clamp, because the black porch level is very close to reference black.

3. the PR/PB signals are sub-sampled, and that sample is taken in the middle of the two pixels. On my original Atom experiments, sub-sampling in the middle made a significant difference. The reason being that on the Atom much of the noise on the 6847 video outputs is caused by the 6847 address bus outputs switching, and I think this happens to shift the sampling point away from this.

A couple of further comments.

Point (3) above (chroma sub-sampling) is only possible with the 6847 because the colour will never change more frequently than ever two pixel clocks (i.e. the effective chroma resolution is half the luma resolution). This is true across all screen modes. It does feel feel specific to the 6847. I'd be surprised if it were true on other systems.

Do you have any other systems that produce YUV (component) video?

One other feature of the original Atom CPLD were some tricks to avoid ever having to distinguish between the 6847's Black and WL levels. (The 6847 puts out 4 different Y levels, in the datasheet referred to as Black, WL, WM and WH). It turns out it's possible to determine each of the 6847's discrete colours with just two Y thresholds: one set between WL/WM and the other set between WM/WH. In the original design, this "logic" was directly implemented in the CPLD. Am I right in thinking it's now replicated in the way the palette is setup?

Anyway, I'm really liking this board. I'm probably going to strip down my V1 board and build up a second V2 board. I'll maybe also post a bit on Stardot, but that might have to wait until after Christmas.

Dave

IanSB, 2019-12-23:
> the PR/PB signals are sub-sampled, and that sample is taken in the middle of the two pixels

It would be useful if you could tweak the YUV cpld to make that switchable with a control bit on the register chain.

> Am I right in thinking it's now replicated in the way the palette is setup?

Yes, the palette replicates the VHDL logic.

> Do you have any other systems that produce YUV (component) video?

Yes, TI-994/a and 48K spectrum. I have had some interesting results with them so far but neither is really usable yet.
Both of these have many different luma and U/V levels which makes it difficult to discriminate between colours but I used similar tricks to your Atom luma threshold above to infer colours using incomplete data.
The TI video chip has published info for the YUV levels and I used that to create the following table:  (The first value is the luma voltage and the numbers in brackets are the U/V values that occur at each voltage)
0    (0,0)
0.40 (+1,-.132)
0.47 (-.321,+679) (-.453,-.642)
0.53 (-.509,-.755) (+.868,-.075) (-.377,+.868) (+.377,+.491)

0.67 (-.377,-.566) (-.377,+.868)
0.73 (+.434,-.887) (-.755,+.189)
0.80 (-.566,+.189) (0,0)

1.00 (0,0)

The blank lines show where luma discrimination is mandatory because the luma values either side of the blank line share the same U/V values. So in the above there must be at least 3 levels of luma discrimination. (These are at relatively wide voltage gaps)
The current interface only discriminates + , 0 and - for the U and V values so I set the thresholds to +.225 and -.225 such that anything between those values is 0, anything above is + and anything below is -. This results in the following:
0    (0,0)
0.40 (+,0)
0.47 (-,+) (-,-)

0.53 (-,-) (+,0) (-,+) (+,+)

0.67 (-,-) (-,+)
0.73 (+,-) (-,0)

0.80 (-,0) (0,0)

1.00 (0,0)

Due to U/V clashes in the above, actually 5 luminance levels would be needed to fully discriminate so I had to include the 1.00 (0,0) (white) in with the 0.80 which also has (0,0) (grey) as I only had 4 levels.

The main issue is that the thresholds between the luma levels in this configuration are very narrow and susceptible to noise. Using the original 3 levels above with more bits for U/V discrimination would probably be much better.

The spectrum 48K is similar, it has about 15 different luminance levels and it would be impossible to reliably discriminate those but using just 3 luminance levels and the +/0/- U and V levels it should be possible to reliably extract the 8 basic colours but not distinguish between their normal and bright variants. (Which would be the equivalent of connecting a Spectrum 128 or +2 to a beeb style TTL RGB monitor with no intensity input)
There is one remaining problem with the Spectrum: The R-Y (V) output inverts every other line presumably to make it easier to PAL code the signal in the colour encoder chip without any external PAL switch circuitry.
That inversion would have to be undone in the YUV cpld so another bit to enable the feature and some way of synchronising the PAL switch after field sync.

Here are the spectrum YUV signals from colour bars using normal and bright versions of each colour:
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
Yellow is Y (inverted) , Cyan is B-Y, Purple is R-Y

> In the mean time, if there is anything you would like me to try

Perhaps investigate if the Rx decoupling caps really make any significant difference. The other thing will likely be the termination mod as mentioned in https://github.com/hoglet67/RGBtoHDMI/issues/119 once I've tried it myself.

hoglet67, 2019-12-24:
Thanks for that info Ian, very interesting...

I've just been reading my copy of The Spectrum ULA by Chris Smith (do you have this?) and it's got some good diagrams on the YUV analog output. Detecting the base 8 colours should be very doable, with just three levels of UV, and probably just two levels of Y. But I think you are right, detecting the bright highlight will require far more Y resolution than we have. And looking at your diagram, if the 0 level of B-Y and R-Y are significantly different, then you are stuffed.

The YUV CPLD changes should be straight forward (assuming there is space):
- make the chrominance sub-sampling controllable
- handle the R-Y inversion on alternative lines

I'm not allowed back in the Lab until the weekend now, so I won't be doing much until then.

I had one other thought I had last night. For a future design, to increase the resolution without needing more DACs, you could use a chain of 1% resistors between pairs of DAC outputs to generate N regularly spaced thresholds. You still need multiple comparators, but this might be more flexible. It would allow R-Y and B-Y to have different offsets. It's an alternative to clamping I guess.

Dave

IanSB, 2019-12-24:
> The Spectrum ULA by Chris Smith (do you have this?)

No I don't but I have heard of it.

>  looking at your diagram, if the 0 level of B-Y and R-Y are significantly different, then you are stuffed

I did manage to get some reasonable results by specifying a wide band for the "0" level that encompassed the 0 level of both B-Y and R-Y and some of the lower levels of colour values but I was tripped up by the half chroma sampling.

BTW one other thing to look at is the effect treating G differently (by clamping it) has on the RGB noise performance.
It seems to be OK under normal circumstances but if you push the DAC thresholds to the edge of the noise band you get colour fringing indicating that the G is slightly phase shifted. I'm not sure if this is something to be concerned about.

hoglet67, 2019-12-28:
Hi Ian,

Hope you had a good Christmas.

I've done some work just now on the YUV CPLD in a new branch called spectrum:
https://github.com/hoglet67/RGBtoHDMI/commits/spectrum

There are three changes to the YUV CPLD VHDL:
- v4.0 adds a register to the scan chain that enables/disables chroma sub-sampling
- v4.1 reduces the macrocell usage (there is some risk this might have messed things up)
- v5.0 adds a register to the scan chain that enables/disables inversion of the R-Y channel on alternate lines

I've done some testing of this on my Spectrum 48K Issue 4B , and it's not yet working reliably.

The problem I think is that the inversion of the R-Y channel really needs to happen only on the even numbered lines within the 312 line field. At the moment, the CPLD does not see any kind of vertical sync pulse (at least, not the way I have it wired up), so it's not possible to synchronise this to the even lines.

I'm wonder whether we could feed a signal from the Pi into the CPLD (possibly overloading the mux signal) that could be used for frame synchronization. Alternatively, the I wonder if the CPLD could detect the field sync pulse itself somehow? But that would need a longer counter than we currently have space for. Did you have any thoughts on this?

Anyway, I thought I would push this up to github so you can take a look and have a play.

One thing to be wary of is that when the OSD is displayed I think the display is updated every two fields, and a consequence of this is that sometimes this interacts wierdly with the R-Y inversion, especially if this is out of sync.

Dave

IanSB, 2019-12-28:
> The problem I think is that the inversion of the R-Y channel really needs to happen only on the even numbered lines within the 312 line field

Yes, the PAL switch needs to be synchronised for things to work as mentioned in my first post above.

> possibly overloading the mux signal

Yes I think that's probably the way to go as the MUX in YUV mode currently controls the 3/4 level switch but blipping it after field sync shouldn't cause any problems as there is no video capture during that time.
I think the way to do it would be to expose a new "synchronise" method in the cpld driver(s) and call that method after field sync detection has finished. In other CPLDs that should do nothing but in the YUV cpld it should briefly invert the MUX line if config->alt_r is enabled and that should force the PAL switch (inv_R) to 0 or 1 (not sure which way round the logic would be)

> One thing to be wary of is that when the OSD is displayed I think the display is updated every two fields

With the longer menus, even the 8x8 font started dropping fields so I gave up on trying to keep 50Hz capture during menu display and defaulted to the mode 7 font even in 8 bit mode.
Making that work nicely with the PAL switch might get messy.

Perhaps we should look at getting some of the capture interrupt driven.

BTW do you see the same DC offset in R-Y and B-Y ?

hoglet67, 2019-12-28:
I've found a fairly efficient way to detect the FS pulse in the CPLD. It re-uses the counter to measure the width of the HS pulse. If the HS pulse is longer that 511 clock cycles (9us in the case of the Spectrum) then this clears the R-Y inversion signal.

This is pushed as CPLD v5.1.

It may not be the best approach (using mux might be more flexible), but it lets us see if there are father problems, which I think there are.

Here's what I'm seeing now:
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

The top 7 lines have black text, the bottom 7 have white text.

I think possibly the errors might be caused by the delay being introduced by clamping Y.

Dave

IanSB, 2019-12-28:
It could be tilt introduced by clamping being messed up during the field sync pulses.

hoglet67, 2019-12-28:
No, it's actually a bug I just introduced in trying to save some macrocells.

So I reverted that bit, and removed temporarily removed the filtering, and this looks better:

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

hoglet67, 2019-12-28:
I think I've found a way to fit everything in.

v5.2 now pushed.

This does need to be re-checked on the Atom, to make sure the filters are still working properly. I haven't done that yet.

IanSB, 2019-12-28:
I just issued a pull request for a few minor changes I made recently including a fix for the very small screencaps on the Spectrum (also affected other computers). You may want to merge this at the same time as merging the new branch back in to consolidate everything.

hoglet67, 2019-12-28:
I've merged everything back to dev now.

I'll do a bit more testing on the Atom tomorrow to make sure nothing has regressed.

I'm still not able to get a perfect picture on the Spectrum.

For example, with the following test program:
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

I can't get a perfectly stable picture:
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

Here are my current sampling settings:
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

I'll see if adding a decoupling capacitor to the DAC helps.

Dave

IanSB, 2019-12-29:
I've pushed an updated spectrum palette and profile directly to your spectrum branch
The palette now uses only 2 levels of luma discriminiation with some overlap which gives +-10 levels of noise free threshold. The U/V lo/hi adjustments seem to have +-5 levels of noise free threshold.
Only the G/Y lo adjustment is used now, the hi is set to 255 to disable it.

The main problem left is that there seems to be some vertical tilt which is affecting the sync separation. As I adjust the sync threshold I can get clean video at the top, middle or bottom but not reliably all at the same time. Not sure what's causing the tilt, it may be that the clamp circuit is loading the Y signal and affecting it's level or there may be an issue with the Spectrum itself.

IanSB, 2019-12-29:
Just had a thought:

There is a second sync separator on the clamped side of the Y signal feeding the Vsync input.
If the normal sync separation was used just to generate the clamp, the secondary sync input which would be clamped could drive the timing chain and that would hopefully eliminate any sync separation tilt.

However I don't think that would fit in as it would require 2 sets of timing counters, one for the clamp and one for the psync. This could be tested with sync tip clamping (i.e. drive the clamp directly from the sync input and drive the timing chain from the vsync input) as that would eliminate the need for the second counter.

hoglet67, 2019-12-29:
Hi Ian,

I've updated to the latest code and profile you pushed to the spectrum branch.

I'm not sure I'm seeing quite the same issue that you are seeing with vertical tilt.

Could you post a capture of the sort of artifact you are seeing (ideally with my small random test program)?

Do you have any scope pictures that show the vertical tilt?

To get a stable image, I needed to adjust three settings:
- Offset from 4 to 1 (this had a big effect)
- DAC-F (Sync) from 222 to 255 (this had a big effect)
- DAC-D (RB/UV Lo) from 125 to 138 (this had a minor effect on the last few twittering pixels)

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

I think the sync change is needed I think because there is a glitch on ULA Y output in the back porch region.

With these settings, the main part of the image is perfect.
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

The only artefacts are where the border changes to blanking, and this transition probably shouldn't be visible anyway (i.e. reduce the Max H Width Geometry to 344).

I can think of a few possibilities:
- there are differences between our Spectrums (what issue is yours?)
- there are differences between our cabling (I'm picking the signals directly off the ULA pins 15-17)
- there are differences in our analog adapter boards (did you definitely fit a 10uF cap as C3)

Dave

IanSB, 2019-12-29:
My Spectrum is an issue 3
I'm also picking up directly from the ULA
There is definitelty a 10uF capacitor fitted.

However I can see AC loading effects even when the spectrum is disconnected from the RGB/YUV board. e.g. if I change the border from 7 to 0 the video will move up/down on the scope and doing this when connected to the RGB/YUV board results in a clean image going noisy.

This is the signal I get on the Y output:
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
The large pulse is the field sync and the block of lines following it are a black border with line sync pulses followed by another block of lines with white video background (inverted video).
The ULA outputs are driving the internal circuitry and that might be affecting things.
Also my spectrum has been modded for video out on the RF modulator's phono connector and that might be affecting things although it's not connected to a video out at the moment.

hoglet67, 2019-12-29:
Here's a couple of similar scope shots....

Border 0

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

Border 7

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

The Y cursors are showing:
- Y1 = black = 2.422V
- Y2 = white = 1.469V

I don't see any perceivable shift in the black level when changing the border.

My FS pulse also appears much squarer than yours,

Can you try to quantify the black level shift you are seeing?

I'm wondering why our clamping circuit is not compensating for this shift.

Dave

hoglet67, 2019-12-29:
OK, I've tried another test, using my 6-line test program above.

With this, if I change the BORDER from 7 to 0 then I do see some disturbance, even though there is no perceivable shift in the waveform. What's happening in my case the R-Y inversion is occasionally taking the wrong phase with BORDER 0.

If I reduce the DAC-F sync threshold from 255 to 250, it goes away.

A couple more tests:
- with a white border, DAC-F needs to be 243-255
- with a black border, DAC-F needs to be 241-252

(otherwise the Y-R inversion occasionally glitches)

Can I just confirm that I have things connected in the same way that you do...

Specifically, I have the Y output of the ULA (pin 17) feeding both the G and Sync inputs of the Analog board.

(So clearly our clamping circuit doesn't come in to play regarding the Sync)

hoglet67, 2019-12-29:
Ian,

> However I don't think that would fit in as it would require 2 sets of timing counters, one for the clamp and one for the psync. This could be tested with sync tip clamping (i.e. drive the clamp directly from the sync input and drive the timing chain from the vsync input) as that would eliminate the need for the second counter.

Try this version of the CPLD and see if it helps:
[YUV_CPLD_vv53.zip](https://github.com/hoglet67/RGBtoHDMI/files/4008440/YUV_CPLD_vv53.zip)

I've remove the L and C filters, and added a second counter.

The HS input (DAC-F = Sync) is now used only to generate the clamp output.

The VS input (DAC-E  = G/Y Sync) is used for everything else, including the CSync output.

(I have both set to 215)

If this helps, I'll push it to a branch while we consider what next.

Dave

hoglet67, 2019-12-29:
Sorry, there was an error in v53, here's v54 that fixes that.

[YUV_CPLD_v54.zip](https://github.com/hoglet67/RGBtoHDMI/files/4008500/YUV_CPLD_v54.zip)

This doesn't seem to work particularly well for me (v52 and v52 seem better)

I'm rather confused what's going on here. I think I need to hook up some wires to the clamp signal and the clamped Y. But that will have to wait until tomorrow.

BTW, v53 and v54 are on a spectrum2 branch if you want to examine them.

Dave

IanSB, 2019-12-29:
> Specifically, I have the Y output of the ULA (pin 17) feeding both the G and Sync inputs of the Analog board.

Yes, that's right. Same here.

Your symptoms above are effectively a less severe version of what I'm seeing.
The sync threshold has a significant effect on results and adjusting it varies the sampling point by something like +- 1 pixel. As the DC level of the sync is itself varying across the frame I'm seeing the start point of the sampling vary vertically across the frame such that the video is clean at the top but noisy at the bottom or the reverse of that depending on the sync adjustment.

Also I noticed glitches in the sync pulses like we had with my Master 128 so maybe it would benefit from some deglitching on the sync pulse input like the RGB cpld.

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

Here is a comparison of border 0 and border 7:

Border 0
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

Border 7
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

There is a shift of ~150mV in the border area

hoglet67, 2019-12-29:
I've also notices those glitches, so yes, some filtering may help.

The sync pulse is a bit assymetic, specifically:
- the leading (rising) edge is ~50ns (from black to sync)
- the trailing (falling) edge is ~200ns (from sync to black)

So it may also be beneficial to use the leading edge as the reference, rather than the trailing edge.

Dave

IanSB, 2019-12-29:
> Sorry, there was an error in v53, here's v54 that fixes that.

I tried v54 but it didn't seem to help

However I did get the following result while varying the G/Y sync threshold which indicates the glitches are having an effect at some threshold levels:
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

Still getting left to right movement in the sample position:
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

One other thing I noticed is that the peak sync tip level is >3.3v at some points so maybe the regulator should be increased to 4v to allow full range adjustment (There is a similar issue with the TI99/4a where the chroma is sitting on a pedestal and is >3.3v)

IanSB, 2019-12-30:
I've pushed another updated spectrum palette and profile directly to your spectrum branch.
This won't help with the current problems but it adds detection of 2 levels of white as that can be done using the unused comparator on the luminance. As white is used for the default border and background this might be more useful than any of the other colours.
Note G/Y Hi should be set to the previous G/Y lo setting and the G/Y lo setting should be adjusted for detection of the two white levels: (The noise free adjustment is about +-7)

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
To disable it and revert to one level, set G/Y lo to 0

hoglet67, 2019-12-30:
Ian,

I've just pushed YUB CPLD v56 that is based off v52 (single counter) and adds a 2-bit HS counter. This should ignore glitches of 1, 2 or 3 samples (i.e. upto about 50ns).

I would have liked to use a 3-bit counter, but it didn't fit.

(On my Spectrum the glitch in the back porch is 35ns wide at it's base.)

This does significantly improve the range of Sync settings before the display starts breaking up:
- v52 I can use 242-253
- v56 I can use 196-253

Like you, I'm seeing a shift in sampling point when I switch from a black to white border:
- black border: offset 5 is best (not quite perfect though)
- white border: offset 3 is best (close to perfect)

I don't really understand why this shift in sampling point is occurring, because on my system the shape/position of the sync pulse is unchanged. Possibly there is some phase shift occurring across our clamping circuit, and this varies depending on the DC level.

Dave

hoglet67, 2019-12-30:
Ian,

One last exeriment for this morning...

I've just pushed YUV CPLD v57 that uses the leading (rising) edge of HS as the timing reference.

With this, I'm seeing far less of a shift in sampling point between the black/white borders.

I'll pause now, and see how you get on with v56 and v57.

Dave

hoglet67, 2019-12-30:
I think there's one more uncontrolled factor possibly coming into play here - the quality of the power supply. If I power the Spectrum from my bench power supply, there is generally less noise than when using the (non-original) 9V power brick. Just something to bear in mind!

Also, I'm now less worried about the mis-sampling at the edge of the border area. If you look on the scope, there does seem to be significany jitter in this transition. There is also jitter between the two edges of the sync pulse.

Dave
Dave

IanSB, 2019-12-30:
The 57 version is a lot more stable and I can get a good sampling point which works at all vertical positions:
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

Also changing the border to 0 doesn't affect it:
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

Does this version still work with the Atom?

hoglet67, 2019-12-30:
> Does this version still work with the Atom?

It should do (the Atom's sync pulse width is 4.61us (16.5/3.579545) which is almost identical to the Spectrum's 4.57us (32/7).

But I haven't actually tested it.

I've had an idea for a way to significalty optimize the YUV CPLD, saving 6 (or possibly 8) registers. This would allow the edge to be software selectable, and give us some room for future enhancements.

Dave

IanSB, 2019-12-30:
> I've had an idea for a way to significalty optimize the YUV CPLD, saving 6 (or possibly 8) registers

Sound good, lots of room for more features :)

I just tried your torture test above and that was also noise free:
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

I'm guessing your sampling values will be slightly different to mine but I think it should be possible to automatically optimise them similar to the sampling position as long as the optimisation starts from the assumption that they are approximately correct and only varies them up/down by a small percentage.
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

hoglet67, 2019-12-30:
One thing I noticed is that the auto calibration doesn't work.

I think it's because it's operating directly on the frame buffer, before the palette is applied.

IanSB, 2019-12-30:
Just tried the Atom and that worked OK

One problem I noticed with the current and other recent cpld versions is that you can get the system to lock up if you adjust the sync level incorrectly. I think this might be due to the psync pulses disappearing when sync is stuck high (or maybe low).

e.g. with the spectrum profile if you set the Sync value to
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

Thread 126 (2020-01-08):

Vsync detection issues

IanSB, 2020-01-08:
I've looked into the UK101's Vsync issues some more and this is what I've found so far:

The default Vsync detection determines whether the field is odd or even by checking the time between the last rising edge of the larger field sync pulse(s) and the rising edge of the first hsync pulse after field sync. If this is > ~32uS it is an even field, otherwise an odd field.

With 6845 generated sync pulses, the vsync starts either 1/3 or 2/3 of a line after the last hsync pulse and occupies 2 lines (128uS). As a result it obscures 2 hsync pulses in both fields. In order to get the video of both fields to line up with interlaced video sources, one extra line after field sync in the odd field has to be skipped before the start of active video. This vsync detection method also works for most non-interlaced video sources because both frames are either < 32uS or > 32uS so either all frames get the skipped line or none of them do.

The Electron causes a problem with this because although it outputs an interlaced video signal, the field sync pulse is 2 1/2 lines long (160uS).  One vsync starts early in a line and it still obscures 2 hsync pulses but the other vsync starts towards the end of a line and obscures 3 hsync pulses. As a result it doesn't need to skip the extra line in the odd field.
Ironically this option is required for the interlaced Electron output even though not skipping a line is the way to ensure that non-interlaced video is handled correctly.

The UK101's Hsync is derived from counter chain output C6 so the leading edge is derived from a crystal but the length and thus the trailing edge is determined by a monostable triggered by C6. This is also the case for the Superboard but with C7 instead of C6 (due to the approx half crystal speed).

I think this means we would get more reliable calibration by using leading edge hsync.

The UK101's Vsync is derived from counter chain output C15 but in this case it triggers two monostables, one to delay the position of the Vsync pulse and one to determine the length of the Vsync pulse. This means the Vsync can drift both in position and duration with respect to the Hsync and that can confuse the interlace detection code resulting in jumpy video.

The Superboard's Vsync is also derived from counter chain output C15 but it only triggers one monostable for vsync length so the start of the Vsync pulse will always be phase locked to the start of the hsync pulse and thus it is 50% less likely to experience problems.

For both the UK101 and the Superboard, if the time between the end of the vsync and the next hsync drifts to around 32uS then vsync will jitter between odd and even field detection with resulting jumpy video and that's why selecting Electron type sync eliminates vsync jitter.

So at a bare minimum, The UK101 and Superboard profiles should have leading edge hsync and Electron type Vsync.

However there still remains an issue when the end of vsync drifts close to the first hsync so there is a very narrow pulse at that time as that will cause jitter as one hsync pulse is randomly merged into the end of the vsync pulse. This would affect both the Superboard and the UK101 and switching to leading edge vsync detection wouldn't help as there would still be the random loss of the first hsync pulse.

The software currently determines the line length so a possible solution would be to measure the average time beween the last valid hsync before entering vsync and the first valid hsync after leaving vsync, dividing by the line length and ensuring the duration is the same for all fields by skipping hsyncs as required

Note: this means we will be using leading edge hsync with other computers/clock speeds, not just the Spectrum. As you are already looking at eliminating the psync delay, make the counter value the same for leading and trailing edges. This will mean a big shift when switching edges but that can be automatically compensated in the software by adjusting h-offset and as the software knows the clock rate it can do it accurately for all clock speeds.

hoglet67, 2020-01-08:
Some randon thoughts as I try to digest this....

> With 6845 generated sync pulses, the vsync starts either 1/3 or 2/3 of a line after the last hsync pulse and occupies 2 lines. As a result it obscures 2 hsync pulses in both fields.

Just one clarification...The Beeb and Master are implement this slightly differently. The Beeb uses a NOR gate, so behaves as you indicate above. The Master uses an XOR gate, so inverted hsync pulses are still visible.

> The UK101's Vsync is derived from counter chain output C15 but in this case it triggers two monostables, one to delay the position of the Vsync pulse and one to determine the length of the Vsync pulse. This means the Vsync can drift both in position and duration with respect to the Hsync and that can confuse the interlace detection code resulting in jumpy video.

Looking at the time constants of the two monostables:
- IC28a 74123 uses 27K and 220nF, which gives a time of 0.33 x 0.22 x 27000 = 1,960us = ~30 lines
- IC65a 74123 uses 10K and 100nF, which gives a time of 0.33 x 0.10 x 10000 = 330us = ~5 lines

With 5% tolerance components, the drift in the start of VSYNC will be upto 1.5 lines. So even switching to the leading edge, it's not clear this will work reliably, even this leading edge of VSYNC will move significanltly (i.e. the variation from the first monostable is dominant).

I would be tempted first to try replacing the resistors and capacitors with modern 1% tolerence types and see if this helps (if you haven't already done this).

Stepping back, it feels like we've already invested a lot of time/effort/testing in the current method of vsync detection. If I recall, it was quite painful to get this working with the Beeb, Master and Electron. I'm not against adding a second method, if that proves to be better in some situations. But I don't think we should be replacing what we already have. Especially if this is just to deal with one arguably poorly designed system.

> Note: this means we will be using leading edge hsync with other computers/clock speeds, not just the Spectrum. As you are already looking at eliminating the psync delay, make the counter value the same for leading and trailing edges. This will mean a big shift when switching edges but that can be automatically compensated in the software by adjusting h-offset and as the software knows the clock rate it can do it accurately for all clock speeds.

I would like to get rid of this delay, but I think there is a possible race condition when using the leading edge....

As far as I remember the software is currently doing:
1 - WAIT_FOR_CSYNC_0
2 - WAIT_FOR_CSYNC_1
3 - skip HOFFSET PSYNC edges
4 - start sampling on each PSYNC edge

The RGB CPLD is inserting a small delay between (2) and (3) where PSYNC is unchanging, but it's still enough that sampling is consistent.

The YUV CPLD currently inserts a much longer delay, so PSYNC is stable for longer after the end of HSYNC, regardless of which edge is used.

Now, if we update the YUV CPLD so that PSYNC starts toggling short time after that start of HSYNC, then it seems we have a race condition. More specifically, the skip PSYNC edge code (3) may now start at the same time as a PSYNC edge. Then we'll see significant sampling jitter.

I will make the CPLD change and try this out.

Dave

I

This makes sense I think.

IanSB, 2020-01-08:
> But I don't think we should be replacing what we already have.

Any new vsync technique would always be a switchable option.

IanSB, 2020-01-09:
I've updated the first post to correct an error in the Electron sync description

IanSB, 2020-10-08:
This was addressed in https://github.com/hoglet67/RGBtoHDMI/pull/154/commits/7f575bf138f9cf73b7a447691d87c0d5912df4a0

Closed 2020-10-08.

Thread 134 (2020-01-28):

Multiple Pi version support

IanSB, 2020-01-28:
I've been doing some work on improving the support for multiple Pi versions. This was mainly because the zero is often out of stock so it would be useful if it worked with the Pi 1 models A & B, especially as the Pi 1 model A seems to be well stocked by RS & Farnell at a reasonable price:
https://uk.rs-online.com/web/p/processor-microcontroller-development-kits/8332699/

The main issue is that the cpu clock is used for measuring the time on many things which wouldn't work at frequencies other than 1000Mhz (1nS) so I've made changes that auto adjust the measurements depending on the CPU speed. (My Pi1s wouldn't overclock to 1000Mhz)

I also found the PLLs weren't being calculated properly and are actually running at twice the speed we thought originally due to the prediv bit so the PLL code has been rewritten to take that into account. More info in this linux source code here:
https://github.com/torvalds/linux/blob/43570f0383d6d5879ae585e6c3cf027ba321546f/drivers/clk/bcm/clk-bcm2835.c
This also confirms the usage of the PLLs:
PLLA is the auxiliary PLL, used to drive the CCP2 (Compact Camera Port 2) transmitter clock.
PLLB is the CPU clock
PLLC is the core PLL, used to drive the core VPU clock and the UART etc
PLLD is the display PLL, used to drive DSI display panels. (not HDMI)

Along the way I found out why you couldn't get PLLA running on the Pi2 and Pi3 because the CM_PLLA register was defined as an absolute address rather than an offset from PERIPHERAL_BASE so that was only valid for the Pi 0 & 1.

As I had a Pi 4 I also did some work to get that running and it now boots up and displays output but it can't read the SD card or the HDMI registers (I assume the new video core has different register locations) so it can't load profiles or genlock but other than that it works with the default BBC values and doesn't glitch in mode 7 like the Pi2 & 3. I also did some work to improve mode 7 on the Pi2 & 3 and they are much better but still not perfect.

Config.txt now has entries for all Pi versions and you can change CPU/core and sdram speeds.

If you want to try it out, it's currently in the "multipi" branch on my Github:
https://github.com/IanSB/RGBtoHDMI/tree/multipi

hoglet67, 2020-01-28:
Hi Ian,

Some nice detective work there....

I do think we need to think very carefully about whether we want to officially support anything other than the Pi Zero. Multiple Pi Models has made release testing of PiTubeDirect an absolute nightmare.

Even the Pi 1B, with the same BCM2835, adds some complexity.  For example, the GPIO assignment  on the 40 pin connect changed between version 1.0 and version 2.0 of the Pi 1B.  What's the hardware revision number of your Pi 1B? (Reported during startup in debug mode).

Pimorani seems to be better at holding stocks of the Pi Zero 1.3 than anyone else:
https://shop.pimoroni.com/products/raspberry-pi-zero

Also, the Pi Zero WH is not limited to one per order.

Finally, this site is very useful:
http://www.thepilocator.com/

IanSB, 2020-01-29:
> What's the hardware revision number of your Pi 1B? (Reported during startup in debug mode).

BOARD_REVISION : 00000010

>For example, the GPIO assignment on the 40 pin connector changed between version 1.0 and version 2.0 of the Pi 1B.

Do you have a reference for that, I couldn't find any mention on the official page:
https://www.raspberrypi.org/documentation/usage/gpio/
In any event even if we don't officially support other boards, the above changes mean that the pi zero can be overclocked or even underclocked (to reduce temps)

> Pimorani seems to be better at holding stocks of the Pi Zero 1.3 than anyone else:

I noticed that all UK suppliers were out of stock for about a month before Christmas.

>I do think we need to think very carefully about whether we want to officially support anything other than the Pi Zero.

I think the only practical alternative would be the model A or 3A as they have the same width as the Pi zero but twice the depth so it might be possible to make a larger PCB with analog support and proper connectors. However neither of them work properly at the moment. The model A needs a mild overclock for glitch free operation and the 3A will suffer from the same issues with mode 7 as the 3B although I have an idea that might eliminate the mode7 problems with the pi2 & 3.

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

hoglet67, 2020-01-29:
> BOARD_REVISION : 00000010

OK, that's a Pi 1 Model B+

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

The GPIO pinout change was between version 1.0 and version 2.0 of the Pi 1 Model B. This was in my mind as we've just been doing lots of PiTubeDirect testing at ABUG.

These are of course the original 26-pin GPIO headers, so not at all relevant for RGBtoHDMI.

The B+ (which you are using) is the first with a 40-pin GPIO header, and all of these have the same pinout.

Sorry for the confusion!

IanSB, 2020-02-09:
Closing this as multi pi support merged back into dev

Closed 2020-02-09.

Thread 140 (2020-02-06):

Release candidate

IanSB, 2020-02-06:
I've just done some testing with the PC and that seems to be behaving itself.

Do you want to make up a release candidate zip and I'll do a run through of all the machines again and if that looks good we can go for a release on the weekend.

hoglet67, 2020-02-06:
https://github.com/hoglet67/RGBtoHDMI/releases/tag/20200206_53bd391

hoglet67, 2020-02-06:
My only thought was whether we wanted to prune CPLD versions that are included. I'm in two minds about this, as it's incredibly useful to us to be able to go back and forth.

Plus it's further work....

I fully expect we'll see issues, and need to make other changes over the next few weeks.

hoglet67, 2020-02-06:
One thing I need to check before we announce is that .jed files in the various vhdl directories reflect the latest version. I'm pretty sure some of them are stale.

I'd also like to delete the .xsvf files in the vhdl directories, as these duplicate the ones in the src/scripts/cpld_firmware directory.

Dave

IanSB, 2020-02-06:
> My only thought was whether we wanted to prune CPLD versions that are included. I'm in two minds about this, as it's incredibly useful to us to be able to go back and forth.

I think that might be confusing for new users especially when they are expected to switch between the YUV and RGB cplds on a semi regular basis.

How about putting them in "old" sub-folders in each cpld folder. They wouldn't show up normally in the menus but could be moved out into the main folder if required or you could make it so they showed up by enumerating the "old" sub-folders if debug was enabled in the settings menu.

BTW spoke too soon about the PC, I've just fixed a sync bug that was causing auto switch to get stuck sometimes. I'll send a pull request soon.

IanSB, 2020-02-06:
I've implemented the "old" folder for cplds when debug enabled.

hoglet67, 2020-02-08:
New release candidate:
https://github.com/hoglet67/RGBtoHDMI/releases/tag/20200208_dda4935

This morning I'm really just made 2 changes:
- create a RGB CPLD v72 that removes the swap bits functionality as suggested
- in CPLD Recovery Mode, automatically bring up the menu, and add further help/warnings

IanSB, 2020-02-08:
A few comments so far:

All the txt files (Profiles & Config.txt etc) are in unix LF format. Did you change that deliberately or was it done via Github? (I get warnings about eol conversions on my windows Github client)
Realistically, most users will be using windows to look at/ edit the txt files so maybe it is better to release in Windows CR/LF format so they can be edited with notepad.

After doing some tests, I think the UK101(TTL) and ZX80(TTL) profiles can be deleted from the RGB(TTL) profiles folder as I realised they will work at TTL levels with the YUV CPLD using the existing monochrome YUV profiles and at least for the UK101 this is preferable as that needs leading edge hsync to eliminate the drift/jitter of the hsync monostable on the trailing edge. (No leading edge option the the RGB CPLD)

They could also be removed from the BBC profiles but there is no alternative YUV option there.

BTW I just damaged another CPLD while testing the UK101. As usual the UK101 was playing up so I lifted the lid to flex the board and the end of an unconnected BNC cable was disturbed and dropped onto the board right on top of the pickup point for the TTL signals I was using for testing. Not really sure what happened but that killed the CPLD. I was powering the converter from the UK101 so there was no powered to unpowered issue.

However I realised I still had the vsync connected straight to +5V on the bbc 6 way TTL connector which I did to fix the issue with old CPLD testing.
Having CPLD pins tied directly to +5v is probably the cause and may have been the issue with the previous failure as well. (i.e. it works normally but under any adverse conditions it may be the cause of the failure)

hoglet67, 2020-02-08:
> All the txt files (Profiles & Config.txt etc) are in unix LF format. Did you change that deliberately or was it done via Github? (I get warnings about eol conversions on my windows Github client)

Almost all the files in the git repository have unix LF endings, and I'm pretty sure they always have done.

Probably what is happening is that your windows git client is locally converting text files to windows CRLF endings on check out, and back to LF unix line endings on check in.

Can you do:
```
git config -l
```
And see if there is a core.autocrlf property set, and what value it's set to.

> I get warnings about eol conversions on my windows Github client

When do you get these warnings exactlyI'll?

What I've done is update the release script to force the line endings to CRLF line endings in the next release candidate.

> However I realised I still had the vsync connected straight to +5V on the bbc 6 way TTL connector which I did to fix the issue with old CPLD testing.

Yes, having an input directly connected to +5V without a resistor can cause latchup.

This is because:
- the +5V supply will probably come up ahead of the +3V3 supply
- without a resistor, large amounts of current can flow (>200mA is needed to trigger latchup)

> After doing some tests, I think the UK101(TTL) and ZX80(TTL) profiles can be deleted from the RGB(TTL) profiles folder

Is there an argument for keeping them (even if they are sub-optimal) as it may minimise the CPLD reprogramming for someone who mostly uses the Beeb, occasionally uses a UK101? I'm thinking of BigEd specifically here.

hoglet67, 2020-02-08:
I meant to ask, are you able to rework the boards with the dead CPLDs?

And did the RGB_CPLD_v72 sort the issue for you in the 24MHz Mode?

IanSB, 2020-02-08:
> I meant to ask, are you able to rework the boards with the dead CPLDs?

Yes, I have a hot air station and have replaced several cplds over the past year although I didn't rework the first of the two recent failures as it was an issue 1 6 bit which could only run the 3 bit cpld. That was the only one I built before moving on to the issue 2 and it's obsolete so I stripped it for parts to use on another issue 2 instead.

> And did the RGB_CPLD_v72 sort the issue for you in the 24MHz Mode?

Looks like it has fixed it so far...

> When do you get these warnings exactly?

When pushing to github it mentions CR/LF to LF conversion in a dialog box and git config -l gives:
core.autocrlf=true

> Is there an argument for keeping them (even if they are sub-optimal) as it may minimise the CPLD reprogramming for someone who mostly uses the Beeb, occasionally uses a UK101? I'm thinking of BigEd specifically here.

I was thinking about user confusion as it looks like you should use that one for TTL output rather than the YUV one. They could stay in the BBC profile as there is no alternative.
Also getting TTL out of a UK101 isn't that easy as it isn't present normally. The required outputs are actually open collector driving the composite video resistor network.
To get TTL I had to solder a normal 74LS00 on top of the open collector one with it's inputs connected to the other chip and it's outputs bent out for pickup of the TTL signals.
(This mod is required for the Superboard as well I think)

hoglet67, 2020-02-08:
> When pushing to github it mentions CR/LF to LF conversion in a dialog box and git config -l gives:
core.autocrlf=true

I think this is how most windows git clients configure themselves by default. There are pros and cons with each way of doing this. I think it's actually working well, and we're not seeing bogus conflicts or lots os white-space only channged in the commits. So I wouldn't change anything.

It's easy to change the line endings in the release.sh file, so this is what I've done.

> Also getting TTL out of a UK101 isn't that easy as it isn't present normally.

OK, I see now that makes sense to delete the UK101 TTL profiles in both places I think. I'll do that now.

Is the same true for the ZX80?

IanSB, 2020-02-08:
> Is the same true for the ZX80?

Not really as it doesn't need leading edge and the TTL signals are available so the RGB or YUV versions should work equally well.

hoglet67, 2020-02-08:
Ian,

There is a set of files in src/scripts that I don't understand:
```
-rw-r--r--  1 dmb dmb   11623 Feb  6 17:56 'OLD cmdline.txt'
-rw-r--r--  1 dmb dmb    8368 Feb  6 17:56 'OLD config.txt'
-rw-r--r--  1 dmb dmb     311 Feb  6 17:56 'pc timings.txt'
-rw-r--r--  1 dmb dmb      13 Feb  6 17:56  profile_Atom.txt
-rw-r--r--  1 dmb dmb      18 Feb  6 17:56  profile_BBC.txt
-rw-r--r--  1 dmb dmb      26 Feb  6 17:56  profile_OBBC.txt
-rw-r--r--  1 dmb dmb      20 Feb  6 17:56 'profile_RGB(Analog).txt'
-rw-r--r--  1 dmb dmb      18 Feb  6 17:56 'profile_RGB(TTL).txt'
-rw-r--r--  1 dmb dmb      13 Feb  6 17:56  profile_YUV.txt
```
Do these need to be included in the release package, or are type obsolete?

There is also a ReadMe.txt there that is woefully out of date, and probably should be removed to avoid confusion.

IanSB, 2020-02-08:
The OLD files were from before I created the profile system and can be deleted now.
pc_timings was just a reminder about timings used by auto switching.
The profile_* files are what is saved to the root of the SD card when you change each CPLD from it's default profile. They don't need to be included in the release unless you want to make the default in each CPLD something other than the default built into the code.
The readme either needs to be updated or removed.

hoglet67, 2020-02-08:
OK, I'll tidy those up.

Just to be clear, the profile_* files can be deleted from git as well?

I'll delete the ReadMe.txt as I'd prefer all the documentation to be on the wiki.

I'm also wondering if we need to a Profile validation script.

For example, extracting the values of the palette= property, we get:
```
     21 0
      2 1
      2 Atom_MKII_Plus
      2 Colour_Genie_N25
      2 Dragon-CoCo_Full
      4 MDA-Hercules
     10 Mono_(2_level)
      1 Mono_(4_level)
      6 RGB
      5 RGBI_(CGA)
      1 RGBI_(Spectrum)
      1 RGBrgb_(Amstrad)
      1 RGBrgb_(Spectrum)
     14 RrGgBb_(EGA)
      1 Spectrum_48K_9Col
```
Is the numerical form still valid, or do these need to be changes to RGB and RGBI.

The palette=0 values are all in the Colour Test files. The palette=1 values are in the QL profiles.

I was also going to add some Atom CPLD firmware, as I think at least one person with the atom board has done the mod. I won't add it to the recovery folder, as the potential for bricking is too high.

IanSB, 2020-02-08:
>Just to be clear, the profile_* files can be deleted from git as well?

Yes I think so.

>Is the numerical form still valid, or do these need to be changes to RGB and RGBI.

No, it's not valid, they should be changed as the numeric values won't work and I think the QL should be RGB not RGBI anyway as it only has 3 bit RGB out like the BBC.

Actually just remove all the palette=0 & 1 lines because the default is RGB anyway, not sure why they were added in the first place. (The 6 RGB entries above are probably the default files)

IanSB, 2020-02-08:
I'm getting crashes on the Pi zero W
It boots OK but crashes when the menu button is pressed with Data Abort at 02101750

IanSB, 2020-02-08:
OK Can't reproduce this now. I was getting no HDMI output so it might have been screwed up HDMI registers due to bad HDMI contact. I reseated the HDMI connector and it's working for now.

IanSB, 2020-02-08:
Yes that was it, if you boot without a valid hdmi connection you will get a crash.
I think the code assumes sensible values for the HDMI registers and doesn't handle invalid values like 0 very well.
This isn't a show stopper for now but maybe we should handle no HDMI connection a bit better in future.

hoglet67, 2020-02-08:
I just tested self-programming on a modded Atom board, and it works fine.

There is a photo of the mod wires here:
https://github.com/hoglet67/RGBtoHDMI/issues/97#issuecomment-503212565

The only issue was if you start with a blank CPLD you are thrown into the CPLD Recovery Menu, which doesn't have an Atom image.

I'm rather nervous about adding an Atom image to the CPLD recovery menu, because you can badly brick a BBC board by programming the Atom image (and probably visa versa). I think any future Atom builders that are relying on this for bring-up will have to manually copy the image. Do you agree with this?

Are you ready for another release candidate, or shall I do that first thing tomorrow morning?

I'm not planning on anything else this evening.

Dave

IanSB, 2020-02-08:
> Are you ready for another release candidate, or shall I do that first thing tomorrow morning?

Yes I think so, I'll run it through all my machines this evening.

BTW the UK101 is a lot more stable with leading edge sync, it used to need recalibration every 30-60 mins with trailing edge.

hoglet67, 2020-02-08:
Here you go:
https://github.com/hoglet67/RGBtoHDMI/releases/tag/20200208_55a148e

IanSB, 2020-02-09:
> I think any future Atom builders that are relying on this for bring-up will have to manually copy the image. Do you agree with this?

Yes, definitely not a good idea to put it in the folder by default.

>Here you go:
https://github.com/hoglet67/RGBtoHDMI/releases/tag/20200208_55a148e

I've tested this latest release candidate with all my machines and not found any issues. I also programmed the 6 bit cpld into a 3 bit board and it successfully detected the wrong CPLD and brought up the recovery menu and there was no damage to the CPLD.

I also briefly tested on a Pi 1A+, Pi3 and Pi4 (The Pi4 is not fully working yet due to SD and HDMI issues but it does give a default 1080p picture with the Beeb)

There are a few untested profiles:
QL
Atom50Hz(TTL)
Nascom II
ZX80 composite
ZX81 composite

The first two I don't have. Most of their settings should be correct but the H and V offsets will need to be finalised.
I have a Nascom but it only has UHF out so I will have to mod it for TTL and composite.
ZX80 and ZX81 composite require converter boards, which I have, but not yet fitted. The timing for those profiles will be correct but the analog levels will need to be set. (Not really an issue at the moment as no-one except us has analog boards and there will probably be another pcb issue and/or release before that is finalised)

One minor thing:
Mux is not selected on the 3 bit Electron profile so it is using the standard inputs.
However I think it is a good idea to leave that in at least for this release to see if there are any issues reported because the 6 bit doesn't have the option anyway and we will get a good idea if that will be a problem in future.

BTW it looks like PCB way will build 20 boards for $30 plus parts and they use all the usual suppliers like Farnell & Mauser.

hoglet67, 2020-02-09:
> Atom50Hz(TTL)

I'll try to test this today.

IanSB, 2020-02-09:
> I think any future Atom builders that are relying on this for bring-up will have to manually copy the image.

You could create an "old" folder in the recovery folder and put the Atom image in that. Then selecting Debug in CPLD recovery mode will show the Atom image.
I just tried this and it works OK.

hoglet67, 2020-02-09:
Update on the Atom50Hz(TTL) profiles.

Hmmm, I've forgotton how awful the Acorn colour card is, which is what started me off down the path to Atom colour perfection. It's taken me quite a while to get the card working again, because I had done a couple of mods that needed reversing, and I also needed to make up a new cable and solder this in.

I've had it running for a couple of hours now, and it's very far from perfect. The main issue is there is no Y level clamping, and the threshoulds for video and sync are set with presets. It's pretty much impossible to get it working well in all modes.

There is also a significant glitch (~75ns) on the csync signal after some of the hsync pulses. This is way longer that our glitch filter will cope with, so it gets through.
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
You can attempt to tweak this out by adjusting the sync threshold preset, but it drifts:
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
I'm now of the view that we shouldn't be claiming to support this card, at least not in this release.

What I'm thinking of doing is renaming these profiles to remove the 50Hz bit, and re-use them as profiles for Phill's Colour Board, which works far better. This is the board that most people have, and there is at least one person (trixster) that is using this with the original RGBtoHDMI board.

Dave

IanSB, 2020-02-09:
> What I'm thinking of doing is renaming these profiles to remove the 50Hz bit, and re-use them as profiles for Phill's Colour Board, which works far better. This is the board that most people have, and there is at least one person (trixster) that is using this with the original RGBtoHDMI board.

Sounds like the best option.

hoglet67, 2020-02-09:
The Atom profiles in OBBC/BBC/RGB_(TTL) are all updated now, and I have tested every CPLD version. Only v6.0 is a bit off centre, and that's not a version that will be out in the field.

The only issue I've found is that with the 6-bit board (without the mux) the orange semi-graphics end up red, and are a bit noisy. This is expected, as the green level is 50%, which ends up right on the threshold of the CPLD input. Fitting of appropriate value termination resistors helps.

I also renamed the ZX80_(TTL) profile to ZX80 as it was the only profile in the OBBC/BBC/RGB_(TTL) folders that still had the redundant _(TTL) suffix

There's a new release candidate here:
https://github.com/hoglet67/RGBtoHDMI/releases/tag/20200209_3b8d96b

I'm done I think now.

IanSB, 2020-02-09:
> I'm done I think now

OK I think we can go with that as the release version.

I've been working on the wiki, currently the reference guide and then the tutorial, perhaps you could add the BOM for the 6 bit board as I sent you the info when you were building yours.

hoglet67, 2020-02-10:
> I've been working on the wiki, currently the reference guide and then the tutorial, perhaps you could add the BOM for the 6 bit board as I sent you the info when you were building yours.

I've done my best on the BOM for the 6-Bit board and Analog Frontend:
https://github.com/hoglet67/RGBtoHDMI/wiki/Bill-of-Materials-%286-Bit-Board%29
https://github.com/hoglet67/RGBtoHDMI/wiki/Bill-of-Materials-%28Analog-Board%29

Do check these over if you get a change.

Re: the analog board, some of the parts listed on the schematic are different to what we both have ended up building, so it's probably worth updating the schematic.

Were you planning a further revision of this board prior to release, to address the CL1 track cut / patch wire.

I think you also mentioned:
> One other change I intend to do for the next issue is to add a schottky diode in the +5v supply from the picoblade connector. That way a standard beeb 6 way DIN can be on the other end of the picoblade connector and it could still be plugged into an Amstrad without causing damage as that has mono video on the +5v pin.

IanSB, 2020-02-10:
> Do check these over if you get a change.

I changed the resistor networks in the 6 bit board to 4.7K to get more safety margin with the Electron but hadn't updated the schematic so I've sent a pull request for that and also edited the wiki.

I also added a screencaps gallery with caps made with screencap scaling set to "on" so they are 1920x1080. Perhaps you could add some more caps from the Atom and Superboard and anything else you have that works with it.

I know it's a bit late but now we are now referring to the boards as 3bit and 6bit in the documentation would it make more sense to change the profile folders and firmware names to match? (This may cause some truncated lines due to increase in length such as the confirmation of firmware update)

i.e. something like
BBC > 3BIT_RGB
OBBC > OLD_3BIT_RGB
RGB(Analog) > 6BIT_RGB(Analog)
RGB(TTL) > 6BIT_RGB(TTL)
YUV > 6BIT_YUV
and maybe prefix the firmware in the same way?

hoglet67, 2020-02-11:
> I know it's a bit late but now we are now referring to the boards as 3bit and 6bit in the documentation would it make more sense to change the profile folders and firmware names to match? (This may cause some truncated lines due to increase in length such as the confirmation of firmware update)

I'd rather get this right, and  I'm inclined to agree, the more constistent we are with naming things, the less confusing it is for end users.

Concerning the profile directory names:
```
BBC > 3-BIT_RGB
OBBC > OLD_3-BIT_RGB
RGB(Analog) > 6-BIT_RGB(Analog)
RGB(TTL) > 6-BIT_RGB(TTL)
YUV > 6-BIT_YUV
```
Firstly, I would be keen to remove some of the punctuation, since I don't think these are every rendered directly in the UI, and these end up needed escaping on Linux which is awkward:
```
3BIT_RGB
6BIT_RGB_TTL
6BIT_RGB_Analog
6BIT_YUV
Atom
OLD_3BIT_RGB
```
Secondly,  I question the current use of the _TTL and _Analog suffixes, where they they are only included where they are necessary for disambiguation. I'm wondering if we should be more explicit:
```
3BIT_RGB_TTL
6BIT_RGB_TTL
6BIT_RGB_Analog
6BIT_YUV_Analog
Atom
OLD_3BIT_RGB_TTL
```
But this is all starting to feel a bit clumsy, so lets try dropping _TTL completely:
```
3BIT_RGB
6BIT_RGB
6BIT_RGB_Analog
6BIT_YUV_Analog
Atom
OLD_3BIT_RGB
```
What I like about this is it's now pretty clear which of these apply when you have the optional analog frontend.

And finally, whether to rename OLD_3BIT_RGB:
```
3BIT_RGB
6BIT_RGB
6BIT_RGB_Analog
6BIT_YUV_Analog
Atom
Legacy
```
Sorry, I'm not being very decisive this morning!

We also present this to the user in the form of interface names, where we turn things about a bit.
```
static const char *frontend_names[] = {
   "TTL RGB (3 bit)",
   "Atom 6847",
   "TTL RGB (6 Bit)",
   "Analog RGB/CVBS (5259)",
   "Analog RGB/CVBS (UA1)",
   "Analog RGB/CVBS (UB1)",
   "YUV (5259)"
};
```
I don't think these necessarily should be consistent with the profile names, they can be longer, and more human readable, but they should probably convery the same information.  So I might be inclinded to change "YUV" to "Analog YUV".

Another question is whether we want to drop support for UA1/UB1, which might then allow the UA1/UB1/5259 to be dropped. (I stripped down my original v1 analog board for parts yesterday). A counter argument is that even if we do drop UA1/UB1, there may be other DACs used in the future.

I've got visitors arriving shortly, so I won't actually be able to do very much today.

I do think now is the right time to get this sort of thing right; it's a low risk change that doesn't require lots of retesting. And we're in the midst of writing documentation, so that's fluid as well.

Dave

IanSB, 2020-02-11:
> I'd rather get this right, and I'm inclined to agree, the more constistent we are with naming things, the less confusing it is for end users.

I've made some of your proposed changes to profile folders + cpld names although I ended up using "Legacy_3BIT" to emphasize which board used those profiles.
I also fixed a hang with h and v aspect set to zero.
(See recent pull request for commits)

Still looking at dropping the old analog board support.
Also I think you wanted to drop the return at end setting from the menu?

hoglet67, 2020-02-12:
I've merged, made a couple of further minor Atom profile changes, and created a Release Candidate 4:
https://github.com/hoglet67/RGBtoHDMI/releases/tag/20200212_e7f3716

I've also added a few Atom screen shots to the Gallery.

One thing I noticed just now when re-testing some of the legacy atom profiles (specifically CPLD 1.0) is that the horizontal centreing seems to be resolution specific. If the profile is centred at 1600x1200, it's offset a bit horizontally at 1920x1080. I don't see the same effect with the non-legacy Atom profile. I'm not too concerned about this if it only affects the lagacy profiles. The only thing that's different is that this profile uses the Half-Even sampling mode. I'm guessing when the capture size is being adjusted, this is causing a centering error to occur. If this raises any alarm bells with you, then I can create an issue and add some more information.

Dave

hoglet67, 2020-02-12:
> Also I think you wanted to drop the return at end setting from the menu?

I'd like to keep it as an option in the config file. The problem when you change it from the menu is that it then only affects the current profile. If you then end with some profiles with it enabled, and some with it disabled, then changing profiles gets very confusing (try it!).

I can't remember, did we have the notion of global properties, that when change are associate with the default scope rather than the profile scope? If so, then the return position should be one of these.

IanSB, 2020-02-13:
> I can't remember, did we have the notion of global properties

We decided to have default.txt as only manually editable at the time.

One thing that occured to me would be to split the contents of the preferences and settings menu into always global options and always per profile options and re-arrange the menus accordingly, calling them settings and global settings or something similar.
e.g. scanlines, debug, screencap scaling, return, font size and maybe the genlock stuff could be global and the rest per-profile. The global settings could be saved in a custom_default.txt file to override the default.txt

This is quite a radical change so I don't think it's suitable to do right now but it could be implemented in the next release. Ideally I'd like to get this release out by the weekend. There's going to be another one in a month or two anyway with the in band and ntsc artifact code finished so we don't really have to finalise everything now.

I've finished adding descriptions for all menu options in the reference guide.
I wasn't sure exactly what the Half setting in the sampling menu does so perhaps you could add that and maybe proof read them and edit / add anything extra you think is needed. The button options and button configuration also needs to be documented somewhere so can you look at that.

While documenting, I noticed we use R-Y and C &  L for some menu options and YUV elsewhere. Would it make sense to change these to be consistent in YUV and Atom menus.

Also I noticed that the Dragon, Tandy and Spectrum profiles had green/white borders in 1080p mode (not noticeable in 1600x1200 mode). This is because the Y is inverted in those profiles and it's fixed by altering their border colour settings which  I have done on my branch.

I also added some more screencaps but they are just placeholders for now and should be replaced with something more graphically interesting.

hoglet67, 2020-02-13:
> We decided to have default.txt as only manually editable at the time.

That's actually fine - I'm probably the only person who would want to change this.

> I wasn't sure exactly what the Half setting in the sampling menu does so perhaps you could add that and maybe proof read them and edit / add anything extra you think is needed.

I've just added some text for that.

> While documenting, I noticed we use R-Y and C & L for some menu options and YUV elsewhere. Would it make sense to change these to be consistent in YUV and Atom menus.

Yes, it probably does make sense to make these more consistent, for example:
```
C Filter
L Filter
Subsample C
R-Y PAL switch
```
would change to:
```
UV Filter
Y Filter
Subsample UV
PAL switch
```
>  Ideally I'd like to get this release out by the weekend.

Sorry, this might have to slip to next week, as we're away for a long weekend break, starting later today.

Dave

hoglet67, 2020-02-13:
> We decided to have default.txt as only manually editable at the time.

That's actually fine - I'm probably the only person who would want to change this.

> I wasn't sure exactly what the Half setting in the sampling menu does so perhaps you could add that and maybe proof read them and edit / add anything extra you think is needed.

I've just added some text for that.

> While documenting, I noticed we use R-Y and C & L for some menu options and YUV elsewhere. Would it make sense to change these to be consistent in YUV and Atom menus.

Yes, it probably does make sense to make these more consistent, for example:
```
C Filter
L Filter
Subsample C
R-Y PAL switch
```
would change to:
```
UV Filter
Y Filter
Subsample UV
PAL switch
```

IanSB, 2020-02-16:
I've been doing some work on the V3 analog board and it's software support.
The results are currently in the "gpio" branch on my fork.

I've been looking at the possibility of using GPIO 0 & 1 (SP_DATA_PIN & SP_CLKEN_PIN) to control the analog switches that switch in the termination resistance. These are obviously used to control the cpld and the DAC but they only 'blip' briefly and can be set to any logic level when not being used. Using an RC filter to filter out the 'blips' works and you end up with a steady logic level representing the termination state.
Also as there are two pins, separate termination control can be used on the Y and UV signals.
(e.g. The Atom 'Y' out should be terminated but not the U & V)

This also has the advantage of freeing up one DAC to use with a possible enhanced version of the interface
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

Thread 175 (2021-01-15):

Analog - Commodore CBM-II (Pet-II) not supported

Sch-LikA, 2021-01-15:
I just plugged my Commodore CBM-II B128-80 to my analog board. Loaded YUV firmware (not 100% clear in the doc btw) and tested profiles.

The best working one is the "Apple II", 60Hz, but I get a flickering screen with half fonts.

The CBM-II is outputing 80 columns luma+sync "composite" signal, 60hz (it is an American 110v-60hz machine plugged into a 220v-50Hz to 110v step-down converter). What can I tweak to get a working setup ?

Thanks a lot !!

IanSB, 2021-01-16:
Because it does pixel perfect sampling rather than general purpose sampling, the converter needs a profile which descibes the source signal in some detail with things such as the pixel clock, the number of pixel clock cycles per line (line length), number of lines per field and other things like the size and position of the active video within the frame.
Also for analog sources it needs info about the voltage levels of the signal.

Setting up a new profile is (mostly) decribed in the wiki:
https://github.com/hoglet67/RGBtoHDMI/wiki/Tutorial-on-Adding-a-New-Profile
I haven't completely finished that but there should be enough info for you to get a working image by adjusting things in the geometry menu and maybe the sampling menu.

I would start with a profile that gives best results such as the Apple II one above and then modify that, saving the resulting configuration. You might need to adjust the analog sampling levels to optimise their values but the Apple II ones are set up for 1vp-p 75R terminated video.

If you then drill down into the Saved_Profiles folder on the SD card you will find your saved Apple II config
Rename that to an appropriate name and move it to the equivalent folder in the Profiles folder.
Reboot and then you should be able to select your new profile from the Profiles option.

If you get a good result please post it here and I'll add it to the next release

Sch-LikA, 2021-01-21:
I am super close to having a profile working for my CBM-II. This is the closest I get :
[Commodore-CBM-II_60Hz.txt](https://github.com/hoglet67/RGBtoHDMI/files/5852605/Commodore-CBM-II_60Hz.txt)

Mostly works when adjusting values, but when getting back to normal mode, screen flickers regularly.

Here is a capture on the screen with some info :
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

The info I got are : only one video mode : 80x25 lines of text, characters are 8x8 pixels (8x14 for the model with integrated monitor, this seems weird) > 640x200 pixels ?

When showed on a CRT, characters are around 1/2.

Datasheet of the videochip is [here](https://archive.org/details/crtc6545/mode/2up)  :

I fired my gbs-control board, using yuv to vga I get a good output. I got the debug infos from it, I get (text after > is the variable name in the code since I cannot make sense of the acronyms) :

```
...
h: 428 v: 523 PLL:5 A:7b7b7b S:8f.10.00 H-   I:00 D:0584 m:1 ht:2345 vt: 246 hpw: 185 u:  0 s:ff S:14 W:-61
...

HT / scale   : 2402 512   > VDS_HSYNC_RST / VDS_HSCALE
HS ST/SP     : 16 144      >  VDS_HS_ST / VDS_HS_SP
HB ST/SP(d)  : 2322 340 > VDS_DIS_HB_ST / VDS_DIS_HB_SP
HB ST/SP     : 2248 208  > VDS_HB_ST VDS_HB_SP
------
VT / scale   : 750 683    > VDS_VSYNC_RST / VDS_VSCALE
VS ST/SP     : 1 6           > VDS_VS_ST / VDS_VS_SP
VB ST/SP(d)  : 750 26    > VDS_DIS_VB_ST / VDS_DIS_VB_SP
VB ST/SP     : 14 16        > VDS_VB_ST / VDS_VB_SP
IF VB ST/SP  : 8 10         > IF_VB_ST / IF_VB_SP
CsVT         : 246             > GBS::STATUS_SYNC_PROC_VTOTAL
CsVS_ST/SP   : 4 1         > getCsVsStart / getCsVsStop
```

Anything obvious for you ? Any setting I should tackle ?

Thanks !!

IanSB, 2021-01-21:
@Sch-LikA
>Any setting I should tackle

Assuming the pixel clock is set to 18Mhz in the menu and is actually 18Mhz in the hardware, the PPM error is too great which means the line length setting also in the geometry menu is wrong, adjust until the PPM value gets closer to zero and you see all clear or all noise on the screen

Thread 177 (2021-01-22):

Proof Of Concept: Audio Singnals into HDMI-Output (Muxing)

ZuiMelanieForno, 2021-01-22:
Hello.

I came here from the [Amiga-Digital-Video](https://github.com/c0pperdragon/Amiga-Digital-Video) @c0pperdragon, where I made a Featurerequest.

The Issue over there, was reopened and I was sent here to do further "investigation". ;)

What is the situation?

There ist the PCB what @c0pperdragon provides, und @IanSB are doing there Magic on the "Chip´s",
to intercept digitaly RGB into the RPi Zero.

What I saw is that there are unused Pins, that could possibly be connected to another Signalsources.
Like Audio, in form of digital Signals or maybe (not) amplified Analog Signals.

On the Amiga Side there are two differen Chip´s to do the Job.
The one for the RGB is the Denise and the Audio is on the Paula-Chip (Pins 30 and 31, digital).

@c0pperdragon mentioned that maybe the "thight timing" wouldn´t allow to add another (asychron/synced) Signal into the RPi Zero?

I have not the "expertise" in E-Engineering or "Amiga-Chip-Stuff" at all, but if I understand it correctly,
there could be a possibility to "mux-in" mor to the HDMI Output then it seems...

So my Issue or rather a Question is:

Can be different types of signals mixed into the HDMI, by muxing Audio into the HDMI-Data-Frames, for instance?

Maybe it could be achieved by using I²C or some AD/DA-Conversion IC´s as (drivers) additional Hardware for preprocessing (and if needed syncing) with the timing on the RPi Zero.

The Idea came from @Crushless to use I²C, so I dunno nothing about "Computahs"... ;)

@hoglet Thanks in advance and also many more thx for this nice Project and wunderfull work.

c.u Zui from Hamburg, Germany

hoglet67, 2021-01-22:
> @Hoglet Thanks in advance and also many more thx for this nice Project and wunderfull work.

FYI @IanSB is doing all the work now (and has been for at least a year),

I don't believe capturing audio on the Pi at the same time as capturing video is feaible. The memory timings are already incredibly tight, especially at higher bit depths.

There is also the issue of sample rate. As far as I understand, Paula supports variable sample rates (upto about 29KHz). HDMI audio needs to be at 48KHz. So a digital only solution would need sample rate conversion, which is not feasible in software. It would also likely add significant lag.

(I have implemented a HDMI audio pipeline in the BBC Micro FPGA port for the Spectrum Next. Without proper sample rate conversion it sounds awful)

That leaves using an ADC to resample the analog audio, somehow feeding that into the Pi (I2S), and then encoding and muxing this into the HDMI stream.  I just don't think there is the horse power to do this, without distrupting the video capture process. And it's unlikely to sound very good, as the ADC will be in a very noisy environment.

It's much easier just to take an analog audio cable from the Amiga to the monitor; most TVs support a seperate audio input. Or even better, use an external amplifier and speakers!

Unless @IanSB thinks otherwise, I think we should close this issue.

Dave

c0pperdragon, 2021-01-22:
I did some research on the matter, and the Amiga generates the analog audio inside he Paula chip, never exposing digital waveform data. So an ACD would be the only option.  I totally agree with Dave here that mixing audio into the HDMI is just not feasible with this special low-cost approach.

ZuiMelanieForno, 2021-01-30:
Hello.

I ordered two Raspberry Pi Pico Microcontrollers.

They have 3 Pins for Analog Input.
Maybe it could work out of the Box, but i assume there will be some extra Ciruit to make an Audio-Grabber.
When (If) I can get a decent Input, I will try to couple that with the RPi Zero to see if I can get somehow a Network of I²c or such... :)

@Jan Beta is willing to help, and if he can find the Time he will do a Oscilloscope Read of the Audio Pin´s.

So, stay tuned on 44.1 kHz for more Audio ;)

c.u. Zui

Breeffeehey, 2021-04-20:
Hello,

Sorry if that is a stupid idea, but... what about using a cheap USB Audio SoundCard to capture the audio output of the Amiga and pass it through the HDMI, along with the video?

In my setup, computers and consoles are plugged via HDMI to my 5.1 Home Theater System...  So, HDMI for Audio & Video is more simple...

What do you think?

I already have a USB Audio SoundCard ordered and on the way to test it, if someone is willing to help me figure it out...

c0pperdragon, 2021-04-21:
I don't think using USB is possible here. First reason is that the program is running on the "bare metal", which means, there is no operating system. that could handle the USB port. So everything would have to be re-implemented.
Second reason is that the single CPU core is already busy with reading the GPIO ports with little or no extra time to spare for additional tasks.

Breeffeehey, 2021-04-21:
Thanks, I will look for an alternate solution...

Would be nice if there was HDMI+R/L --> HDMI converter, but I can see how stupid this idea is...

I've seen DVI or VGA + R/L --> HDMI converter, which I could use with a DVI to HDMI adapter, to take the HDMI Video only from the RPi and mix in the the audio... but have not found those under $50 or $90...

Thanks again for the answer

IanSB, 2021-04-21:
@Breeffeehey
>Would be nice if there was HDMI+R/L --> HDMI converter, but I can see how stupid this idea is...

It isn't a stupid idea and such things exist. Look for HDMI Audio embedder or HDMI Audio inserter.

There are also older products that convert DVI + audio to HDMI such as this:
https://www.ebay.co.uk/itm/273936861003
I have one of those and it works OK

Breeffeehey, 2021-04-21:
> Look for HDMI Audio embedder or HDMI Audio inserter.

I will!

> There are also older products that convert DVI + audio to HDMI such as this

Yeah, I have a VGA + Audio to HDMI I use with a MacMini... those are cheap, but DVI + Audio to HDMI are $75 (CAD) and up...

I'm going to check when I get home... I have another VGA-HDMI with sound, but I don't remember which one-way it is (I don't remember if it's HDMI-->VGA or VGA-->HDMI...)  Depending which way it goes, I'll check my options...

Thanks again for the suggestions!

Breeffeehey, 2021-04-23:
Would there be a problem if I use the RGBtoHDMI Pi's USB port to power the 5V required by the VGA2HDMI in my A3000?
Could this work, or be totally out of question and might lead to problems?
(only problem I, in my somewhat limited knowledge of computers and electronics, can see would be some underpower of sorts in regions of the computer, including the Pi, but how much would it affect it?)

Thanks for your help, if it's not recommended, I'll have an external power source for the VGA2HDMI 5V requirement.

[reminder: I go from RGBtoHDMI-Pi's HDMI to an HDMI2VGA adapter, then through a gender changer to plug into a VGA2HDMI, with sound (guess that's where it needs the 5V USB), and this goes to my Amplifier, which distribute the sound to the speakers and the video, through HDMI, to my TV]

c0pperdragon, 2021-04-23:
The USB-port of the Pi directly carries the 5V rail of the Amiga mainboard. So it could work, but it will draw power through the Denise socket, the Pi adapter and then the Pi itself.
The Pi itself should also work when the input voltage is a bit lower, because it regulates its own internal power down to 3.3V anyway.

Breeffeehey, 2021-04-23:
I will try this weekend, then, and report my results!

Breeffeehey, 2021-05-29:
Conclusion (sorry, it took little bit more time than anticipated...) : it's Ninjaneering, and it all works fine!

RGBtoHDMI in video slot of the A3000
miniHDMI out to HDMI --> HDMI to VGA adapter --> VGA gender changer --> VGA+Audio to HDMI Adapter --> HDMI out of the case

R+L Audio cable take the sound from the R+L ports on the back of the case to the headphone jack in the VGA+Audio to HDMI Adapter

Mini-USB of the Pi0 is powering the VGA+Audio to HDMI Adapter!

Pictures to prove it!

Now, only have to solve that occasional line of pixel glitches, like Yan Beta use to get in his videos...  it comes and goes at random... will check for update on the software part and also check for the setting he used...
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

c0pperdragon, 2021-05-29:
What an amazing hack!
And it seems you pulled this off without doing any soldering at all! Just plugging together existing cables and adapters of all sorts.

Can you say anything about the video quality? Does converting the signal to analog VGA and back again cause any image noise or blurry edges?

Breeffeehey, 2021-05-29:
Actually, I can't tell the difference between straight RGBtoHDMI in TV vs through this ninjaneering... Only thing is the occasional line of glitch, which is random (timing, but always at the same line... maybe I should investigate...)

Maybe it doesn't switch to analog lonv enough (it's just to go through a gender-changer... Or maybe it is because VGA can handle higher resolutions?

Maybe on 4K we would see a difference, but straight VGA from the A3000 connector to a monitor on the side, or through this, it's the same quality... i.e.: sharp as hell!!

And I have sound!!

c0pperdragon, 2021-05-30:
When the visual glitches are caused by the Pi occasionally missing the sample points, this can sometimes be improved by slightly overclocking the Pi. You can do that directly from the settings menu.

By the way, I think the most amazing part of your "ninjaneering" is the abuse of the Pi's USB port to get power for the VGA-to-HDMI. Would never have thought of this possibility.

qbancoffee, 2022-07-07:
@Breeffeehey , thank you for this work around, I confirmed that it works with my CoCo and the picture is still flawless.
I bet the same idea but using a DVI to HDMI converter with audio in would be better since there is nothing done to the
video signal.
Anyhow I used an $8.00 VGA+audio to HDMI converter and a $12.00 HDMI to VGA converter and it worked. I put up a video of it in action if you want to see it.
https://youtu.be/lIacGn5m7bw

Breeffeehey, 2022-07-07:
@qbancoffee glad it works for you too!
I've checked your video, and it's nice that your adapters don't need a 5V input to work!
You want the funny part? I've undone my ninjaneering in my A3000... Since it can output directly in VGA, why go through the RGBtoHDMI, convert to VGA and back to HDMI? So, I plug in the TV directly via VGA... Or I could convert the VGA + sound to HDMI... I'm going to convert thi hack to my A1000 instead... eventually... with a way to combine the RGBtoHDMI and the PiStorm HDMIs...

Let's all keep having fun with our veteran computers!!

Breeffeehey, 2022-07-07:
@qbancoffee oh, I see... did not noticed on my phone... ;)
Yeah, I undid my mod in the A3000... Since it already does natively output a VGA signal, I found it redundant to have a card capturing the video signal, convert it to HDMI through the Pi, convert this HDMI to VGA just to be able to grab this VGA and the Audio and then reconvert it all to HDMI with Audio...  I'm going to grab the VGA coming from the computer directly, with the audio, and then convert it to HDMI... eventually...  I will see in a future setup where I'll have to find my 5V... for the moment, my TV have a VGA+R/L input, so that's where the A3000 is plugged...
Although, I do keep this mod in mind for the A1000...
Hey, I had a good idea, better put it to good use... who knows when I'll have another one!  ;) ;) ;)

Thread 188 (2021-02-22):

White screen ?!

francouai, 2021-02-22:
This project is crazy. Thank you to the team.
I'm re-using my Amiga500+ with Vampire since both are now HDMI.

I was playing with the game "Jim Power" and suddenly, my screen started to be white like snowing from the bottom then fully white.
I rebooted my A500+ and getting directly this same white screen.. 🥵
I was thinking to a corrupt config or bad config so I make a fresh micro SD card. Nothing changed.
Denise chip is still working fine via the RGB video output port, so no problem at all with it.
But picture is white/corrupted via the HDMI port

you can see the problem here:
https://youtu.be/FXDz4afmoY4

Any idea will be welcomed .

francouai, 2021-02-22:
due to unknown reason, my RPI burned.. very strange because it worked only 20mns.
I changed the RPI to a brand new one and it is all fixed.

benur75, 2021-02-22:
Good evening Francouai, I looked at your video. Don't you forget to remove your kickstart chip ? When using a vampire, you have to remove the KS chip.
bye

francouai, 2021-02-22:
Hi Benur75; my KS chip has been removed long time ago.

IanSB, 2021-03-14:
@benur75

One possibility that just occurred to me:
PIN 18 (GPIO 24) on the Pi is used to provide a text overlay input to support FFOSD.
When this pin is taken high it makes the screen output white and that is used to draw white text on the screen.
The Pi is normally configured to pull this input low but if that isn't working on your problem Pi then the input would be floating and randomly switch high resulting in a white screen or low resulting in normal operation.
You could work around that by soldering a 47K resistor from Pin 18 to ground.

See this thread for more details:
https://github.com/c0pperdragon/Amiga-Digital-Video/issues/26

Thread 190 (2021-03-08):

Test pattern for R1 board and A500 rev 5

turbidvisions, 2021-03-08:
On boot of my A500 rev 5 with the original RGBtoHDMI adapterboard and a Pi Zero W, I see only a test pattern with four squares (red, yellow, cyan and blue).  Monochrome video through the composite connector works fine.  I've tried both the latest stable release (20200504_d19df1c) and the most recent prelease (20210131_20ce5f0) with the same results.

Thanks!

IanSB, 2021-03-12:
@turbidvisions

Assuming that the SD card is written correctly, the most likely cause is that the PiCLK signal is missing. If you built the board yourself you need to make sure the link is fitted and check the 74LVC86 soldering and if possible look at the PiCLK signal on Pin 11 (GPIO17) with a scope.

To check the Pi is booting up, you can connect a USB TTL serial port to the TXD/RXD lines on the Pi (115200 Baud) and view the debug log in a terminal program.

kp73, 2021-03-12:
I get the same test pattern then a black screen (no response from pressing a momentary switch connected to the board), also a rev 5 motherboard A500.  I'm using this board from ebay https://www.ebay.co.uk/itm/RGB-to-HDMI-adapter-board-for-OCS-Commodore-Amiga-500/114719151179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.   I have a USB to TTL serial lead somewhere so I'll give that a try.

kp73, 2021-03-13:
I got this from the debug log, it all seemed reasonable;

`     Actual 100 lines = 6400126 ns
          Clock error = 35 PPM
 Error adjusted clock = 14187079 Hz
 Target PLL frequency = 2383429272 Hz, prediv = 1, PER = 4
 Actual PLL frequency = 2383429272 Hz
        GPCLK Divisor = 7
      Lines per frame = 313, (312.999)
Actual frame time = 20032350 ns (non-interlaced), line time = 64001 ns
Window: H=63680 to 64318, V=19931840 to 20131534, S=Comp, HW=4788, HT=9000
Width or Height differ from last FB: Setting dummy 64x64 framebuffer
Overscan L=240, R=240, T=0, B=0
Initialised Framebuffer
Size: 720x270 (requested 720x270)
Framebuffer address: DE000000
Modified display list word at 00000664 = 4F407801
RAM benchmark: Main memory = 798924 ns, Screen memory = 25515415 ns
Detected screen size = 1920x1080
Pitch=1440, width=720, height=270, sizex2=0, bpp=16
chars=89, nlines=270, hoffset=100, voffset=28, ncapture=-1
palctrl=0, samplewidth=5, hadjust=0, vadjust=0, sync=0x4
detsync=0x4, vsync=1, video=1, ntsc=0, border=0, delay=1
*PLL
Locked`

So I thought to try another monitor, and it just worked, debug output is very similar;

`     Actual 100 lines = 6400115 ns
          Clock error = 33 PPM
 Error adjusted clock = 14187103 Hz
 Target PLL frequency = 2383433360 Hz, prediv = 1, PER = 4
 Actual PLL frequency = 2383433360 Hz
        GPCLK Divisor = 7
      Lines per frame = 313, (313)
Actual frame time = 20032352 ns (non-interlaced), line time = 64001 ns
Window: H=63680 to 64318, V=19931840 to 20131534, S=Comp, HW=4795, HT=9000
Width or Height differ from last FB: Setting dummy 64x64 framebuffer
Overscan L=240, R=240, T=0, B=0
Initialised Framebuffer
Size: 720x270 (requested 720x270)
Framebuffer address: DE000000
Modified display list word at 00000994 = 4F407801
RAM benchmark: Main memory = 798882 ns, Screen memory = 25520973 ns
Detected screen size = 1920x1080
Pitch=1440, width=720, height=270, sizex2=0, bpp=16
chars=89, nlines=270, hoffset=100, voffset=28, ncapture=-1
palctrl=0, samplewidth=5, hadjust=0, vadjust=0, sync=0x4
detsync=0x4, vsync=1, video=1, ntsc=0, border=0, delay=1
Locked
*PLL`

I'll try and figure out why it isn't working with the first monitor.  Any ideas?

kp73, 2021-03-13:
More complete log from the monitor with the black screen..

RGB to HDMI booted
Simple board detected
Using PLLA as the sampling clock
PLLA: 2400.000000 ANA1 = 00144000
PLLA: PDIV=1 NDIV=62 CTRL=0002103e FRAC=524288 DSI0=256 CORE=2 PER=256 CCP2=256
PLLB: 2000.000024 ANA1 = 00144000
PLLB: PDIV=1 NDIV=52 CTRL=00021034 FRAC=87382 ARM=2 SP0=256 SP1=256 SP2=256
PLLC: 2400.000000, ANA1 = 00144000
PLLC: PDIV=1 NDIV=62 CTRL=0002103e FRAC=524288 CORE2=256 CORE1=256 PER=2 CORE0=2
PLLD: 2000.000024 ANA1 = 00144000
PLLD: PDIV=1 NDIV=52 CTRL=00021034 FRAC=87382 DSI0=256 CORE=4 PER=4 DSI1=256
PLLH: 1485.000000 ANA1 = 0000000c
PLLH: PDIV=1 NDIV=77 CTRL=0002104d FRAC=360448 AUX=256 RCAL=256 PIX=1 STS=528383
PLLA: 2400.000000 ANA1 = 00144000
PLLA: PDIV=1 NDIV=62 CTRL=0002103e FRAC=524288 DSI0=256 CORE=256 PER=4 CCP2=256
CPU speed detected as: 1000 Mhz
EMMC: BCM2708 controller power-cycled
CPLD update file not detected
Keycount = 0
CPLD  Design: Simple
CPLD Version: 0.0
Loading file /Palettes/Atari_800_NTSC.bin
Loading file /Palettes/Atari_800_PAL.bin
Loading file /Palettes/Atom_MKII.bin
Loading file /Palettes/Atom_MKII_Full.bin
Loading file /Palettes/Atom_MKII_Plus.bin
Loading file /Palettes/Colour_Genie_N25.bin
Loading file /Palettes/Colour_Genie_S24.bin
Loading file /Palettes/Colour_Genie_S25.bin
Loading file /Palettes/Commodore_64.bin
Loading file /Palettes/Commodore_64_Rev1.bin
Loading file /Palettes/Dragon-CoCo.bin
Loading file /Palettes/Dragon-CoCo_Emu.bin
Loading file /Palettes/Dragon-CoCo_Full.bin
Loading file /Palettes/MDA-Hercules.bin
Loading file /Palettes/Mono_(2_level).bin
Loading file /Palettes/Mono_(3_level).bin
Loading file /Palettes/Mono_(4_level).bin
Loading file /Palettes/Mono_(6_level).bin
Loading file /Palettes/RGB.bin
Loading file /Palettes/RGBI.bin
Loading file /Palettes/RGBI_(CGA).bin
Loading file /Palettes/RGBI_(Spectrum).bin
Loading file /Palettes/RGBrgb_(Amstrad).bin
Loading file /Palettes/RGBrgb_(Spectrum).bin
Loading file /Palettes/RrGgBb_(EGA).bin
Loading file /Palettes/Spectrum_48K_9Col.bin
Loading file /Palettes/TI-99-4a.bin
Loading file /Palettes/Tea1002.bin
Loading file /Palettes/Test_4_Lvl_B_or_U.bin
Loading file /Palettes/Test_4_Lvl_G_or_Y.bin
Loading file /Palettes/Test_4_Lvl_R_or_V.bin
FOUND RESOLUTION: 640x480
FOUND RESOLUTION: 720x576
FOUND RESOLUTION: 800x480
FOUND RESOLUTION: 800x600
FOUND RESOLUTION: 1024x600
FOUND RESOLUTION: 1024x768
FOUND RESOLUTION: 1280x1024
FOUND RESOLUTION: 1280x720
FOUND RESOLUTION: 1280x800
FOUND RESOLUTION: 1360x768
FOUND RESOLUTION: 1440(1920)x1080
FOUND RESOLUTION: 1440x1080
FOUND RESOLUTION: 1440x900
FOUND RESOLUTION: 1600x1200
FOUND RESOLUTION: 1600x900
FOUND RESOLUTION: 1680x1050
FOUND RESOLUTION: 1920x1080
FOUND RESOLUTION: 1920x1200
FOUND RESOLUTION: 2560x1440
FOUND RESOLUTION: Auto
Standard EDID lowest vertical refresh detected as 48 Hz
Reading EDID extension block #1
EIA/CEA-861 EDID SVD lowest vertical refresh detected as 50 Hz
Manufacturer = 4DD9, year = 2008
Lowest vertical frequency supported by monitor = 50 Hz
Loading file /config.txt
overscan_left: 0
overscan_right: 0
overscan_top: 0
overscan_bottom: 0
#auto_overscan: 1
HDMI drive: 1
Read refresh: 2
Read resolution: Auto
Match resolution: 19 Auto
Read scaling: 0
Setting Integer Sharp
Read scaling_kernel: 8
Read interface_1 = 1
Loading file: /Profiles/Simple/../Default.txt
FOUND SUB-FOLDER: Amiga
FOUND SUB-FOLDER: Amiga_Blk-Scanlines
FOUND SUB-FOLDER: Amiga_Var-Scanlines
Loading file /profile_Simple.txt
WARN: Failed to open /profile_Simple.txt (result = 4)
Setting saved config number to 0
Setting profile to 0
Loading file: /Profiles/Simple/Amiga/Default.txt
Loading file: /Profiles/Simple/Amiga/Amiga_50Hz.txt
Autoswitch timings 0 (Amiga_50Hz) = 63679, 63999, 64318, 313, 4
Loading file: /Profiles/Simple/Amiga/Amiga_60Hz.txt
Autoswitch timings 1 (Amiga_60Hz) = 63237, 63555, 63872, 263, 4
Loading file: /Profiles/Simple/Amiga/Amiga_60Hz_PAL.txt
Autoswitch timings 2 (Amiga_60Hz_PAL) = 63819, 64140, 64460, 263, 4
Jit0
Single button mode enabled
Setting subprofile to 0
Single button mode enabled
Profile = Amiga
Detected polarity state at startup = 4, Comp (Separate H & V CPLD)
Keycount = 0
Setting Integer Sharp
-----------------------LOOP------------------------
Detected polarity state = 4, Comp (Separate H & V CPLD)
        clkinfo.clock = 14187580 Hz
     clkinfo.line_len = 908
    clkinfo.clock_ppm = 5000 ppm
    Nominal 100 lines = 6399900 ns
     Actual 100 lines = 6400162 ns
          Clock error = 40 PPM
 Error adjusted clock = 14186999 Hz
 Target PLL frequency = 2383415860 Hz, prediv = 1, PER = 4
 Actual PLL frequency = 2383415860 Hz
        GPCLK Divisor = 7
      Lines per frame = 313, (312.998)
Actual frame time = 20032378 ns (non-interlaced), line time = 64001 ns
Window: H=63680 to 64318, V=19931840 to 20131534, S=Comp, HW=4786, HT=9000
Looking for autoswitch match = 64001, 313, 4
Autoswitch match: Amiga_50Hz (0) = 63679, 64318, 313, 4
Setting subprofile to 0
Single button mode enabled
Detected polarity state = 4, Comp (Separate H & V CPLD)
        clkinfo.clock = 14187580 Hz
     clkinfo.line_len = 908
    clkinfo.clock_ppm = 5000 ppm
    Nominal 100 lines = 6399900 ns
     Actual 100 lines = 6400134 ns
          Clock error = 36 PPM
 Error adjusted clock = 14187061 Hz
 Target PLL frequency = 2383426276 Hz, prediv = 1, PER = 4
 Actual PLL frequency = 2383426276 Hz
        GPCLK Divisor = 7
      Lines per frame = 313, (313)
Actual frame time = 20032388 ns (non-interlaced), line time = 64001 ns
Window: H=63680 to 64318, V=19931840 to 20131534, S=Comp, HW=4733, HT=9000
Width or Height differ from last FB: Setting dummy 64x64 framebuffer
Overscan L=240, R=240, T=0, B=0
Initialised Framebuffer
Size: 720x270 (requested 720x270)
Framebuffer address: DE000000
Modified display list word at 00000664 = 4F407801
RAM benchmark: Main memory = 798813 ns, Screen memory = 25488075 ns
Detected screen size = 1920x1080
Pitch=1440, width=720, height=270, sizex2=0, bpp=16
chars=89, nlines=270, hoffset=100, voffset=28, ncapture=-1
palctrl=0, samplewidth=5, hadjust=0, vadjust=0, sync=0x4
detsync=0x4, vsync=1, video=1, ntsc=0, border=0, delay=1
*PLL
Locked

IanSB, 2021-03-14:
@kp73

That monitor probably doesn't like the non-standard 50Hz output coming from the Pi zero in auto detect mode or alternatively it doesn't like the DVI compatible HDMI signal.

To check for the first case, hold down the menu button during power up and that will temporarily set the output to 60Hz and you might get an image to allow you to change the menu settings.
If that doesn't work then you will have to try changing the HDMI mode on the main menu from another monitor.

You can force a more standard 50Hz mode by changing the resolution to 1920x1080 and refresh to 50Hz in the main menu.

Even then it will still be slightly off frequency due to the genlock so it that doesn't work the next option to try is disabling the genlock in the settings menu but that will mean the output is not locked to the input and you will get frame drops or repeats. (Save the config after changing this setting)

kp73, 2021-03-14:
@IanSB thanks very much for the help, it was 50Hz output.  Switched to 60 and it's all good with the old monitor.  @turbidvisions is it possible that the same thing is causing your issue?  Apologies anyway for hijacking your issue a bit, at least you know that at least one other rev 5 Amiga 500 works, and the 50Hz output isn't specific to the rev 5 Amiga motherboard.

turbidvisions, 2021-03-17:
@kp73, @IanSB Thanks for your help!  I'll definitely try playing with output frequency and report back.

shred, 2021-03-20:
I found this issue because I had the same problem with the latest stable release (20200504_d19df1c). I tested on different monitors, but only got a 60 Hz picture with four colored rectangles. The RasPi also didn't react on button presses.

However, it was resolved for me after I updated to the most recent prelease (20210131_20ce5f0).

turbidvisions, 2021-03-20:
Still no luck on my side, trying again the 20210131_20ce5f0 release, but this time capturing the debug log with looks similar to that of @kp73 except for large reported clock error:

          Clock error = 611664 PPM
WARN: PPM error too large, using nominal clock
 Error adjusted clock = 14187580 Hz

[debug_log.txt](https://github.com/hoglet67/RGBtoHDMI/files/6175851/debug_log.txt)

IanSB, 2021-03-21:
@turbidvisions

The old stable release doesn't support the Amiga board so you must use the latest dev release 20210131_20ce5f0 or later.

The debug log shows detected video lines as 103uS long with 102uS hsync pulses instead of  64uS & 4.7uS respectively. It also shows the number of lines per frame detected as 316 instead of 313 which indicates very messed up sync signals so there maybe a problem with the board construction.

You need to check the soldering around the pixel clock and sync signals as they pass through the board and if possible look at those signals with an oscilloscope.

Thread 200 (2021-04-17):

FF OSD on RGBtoHDMI CPLD version by LinuxJedi

solarmon, 2021-04-17:
Hi,

I suppose this is really a question for @IanSB

I'm currently testing @LinuxJedi 's A500 RGBtoHDMI CPLD board (https://github.com/LinuxJedi/AmigaRGBtoHDMI)

Whilst it is working,  I am also trying to get FF OSD working on it. I can get it working using c0pperdragon 's RGBtoHDMI board, but it seems the LinuxJedi RGBtoHDMI CPLD board does not seem to work.

Using the same FF OSD setup and the the same Raspberry Pi, I'm connecting to Pin 18 (GPIO24) and using the sync signal from Denise on pin 32 - this works with the c0pperdragon RGBtoHDMI board, but not the LinuxJedi RGBtoHDMI CPLD board.

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

Does there need to be any extra/special setup/configuration to support FF OSD when using the CPLD version of the Raspberry Pi  firmware?

IanSB, 2021-04-17:
FF_OSD isn't currently supported in CPLD mode on the release software.
One potential problem is that the FF_OSD GPIO (24) is also used to program the CPLD so there might be a conflict.
I have now implemented it in order to test if there are any problems. This also contains other fixes for single button mode.
You will still need the 1K resistor to stop the FF_OSD signal interfering with CPLD programming.

Download the beta18.zip from my fork and let me know if it works OK for you:
https://github.com/IanSB/RGBtoHDMI/releases/tag/3313630

Note this is a standard software release so you will need to edit the file /profiles/default.txt and change to "single_button_mode=1" to force single button mode and also change the profile line to "Amiga" in the main menu
To test a clean install, delete the file:
/cpld_firmware/Delete_This_File_To_Erase_CPLD.txt
This will force the CPLD to be erased on the next reboot and so you can test recovery mode.
It would also be useful to test CPLD programming when there is FF_OSD text on the screen.

solarmon, 2021-04-18:
@IanSB

Thanks! I'm out all day, so I'll try the beta later on.

BTW, what other button modes are there? What GPIO pins could be used for more buttons? I'm going to do a re-spin of the CPLD board and can add more buttons to give the user more options. Controller the menu with more buttons will be a better user experience.

LinuxJedi, 2021-04-18:
> BTW, what other button modes are there? What GPIO pins could be used for more buttons? I'm going to do a re-spin of the CPLD board and can add more buttons to give the user more options. Controlling the menu with more buttons will be a better user experience.

The default is three button mode. So you have:

* SW1 - GPIO16 (what we currently use)
* SW2 - GPIO26
* SW3 - GPIO19

They are pulled high so short to ground to activate. You then have up, down and select buttons. The buttons also do more things when the menu is off, such as SW1 turns scanlines on/off.

I originally designed my CPLD version to have the three buttons but reduced it to one when IanSB told me it was possible so that it was familiar to people who used the c0pperdragon design. My A2000 CPLD design (currently untested) gives the option of using either 1 button or 2 button mode.

solarmon, 2021-04-18:
@IanSB

I tried beta18, and the first time I tried it on a brand new SD card, deleting the "Delete_This_File_To_Erase_CPLD.txt" file, I initially saw the screen that says it is trying to recover and was rebooting, but then the screen was just blank and flickering every now and then, and every so often I could see a white text but could not read it quickly enough.

I tried again and deleted everything on the SD card and boped over the beat18 files again, without deleting the "Delete_This_File_To_Erase_CPLD.txt" file. This time I could see the white text menu that asked to select the CPLD profile, which I did and chose the 12-bit RGB 92 one. It rebooted and once I then changed the profile from Amstrad to Amiga, it was all stable again.

I connected up FF OSD and it was indeed working! Woohoo!

Thank you! Now that I know FF OSD is working (albeit still wavy/jaggy) I can add that to the remix board I'm working on, along with the three buttons.

solarmon, 2021-04-19:
@IanSB Question regarding the buttons again. Would the same GPIO pins work as extra buttons in the original RGBtoHDMI (non CPLD) design?

IanSB, 2021-04-19:
@solarmon
Yes, the non-CPLD design can be switched into 3 button mode but it is untested

The single_button_mode setting in default.txt is inverted for simple (c0pperdragon) mode so when editing it:
single_button_mode=0 means 3 buttons for CPLD and 1 button for non-CPLD
single_button_mode=1 means 1 button for CPLD and 3 buttons for non-CPLD

There is a slightly updated beta19 here:
https://github.com/IanSB/RGBtoHDMI/releases/tag/fddfad7

This has slightly lower CPU usage when FF_OSD is not being used so can you check the FF OSD still works.

solarmon, 2021-04-20:
@IanSB I can confirm that FF OSD is still working with beta19

Regarding the buttons, maybe in the future, a rotary encoder mode could also be supported? This would make it even easier to navigate the menu.

LinuxJedi, 2021-04-20:
> Regarding the buttons, maybe in the future, a rotary encoder mode could also be supported? This would make it even easier to navigate the menu.

I like that idea. It would make things like profile editing when you need to change large numbers much easier.

IanSB, 2021-04-20:
@solarmon

A rotary encode might be possible but it would have to use the GPIOs for the up & down buttons

IanSB, 2021-06-07:
Fixed in this release:

https://github.com/hoglet67/RGBtoHDMI/releases/tag/20210529_777ea4f

Closed 2021-06-07.

Thread 203 (2021-05-07):

TI-99/4A status

Sch-LikA, 2021-05-07:
Hi again !

I built a "full" board including U7 to test TI-99/4A support. It is not far from working, I just have strange black artifacts but other than that it looks kinda good !

What is there left to have a fully working setup and how could I help ?

Thanks !

IanSB, 2021-05-07:
@Sch-LikA

The analog board works by thresholding the incoming video signal at several user set levels so that any voltage above a preset level is a logic 1 and below it's a logic 0 and this is how it is able to extract a noise free image from a relatively noisy analog signal.
However it only works if there is a big enough voltage difference between the two levels so that it is not affected by noise or variations in the output levels between machines.

This seems to work well with most supported systems but it is very marginal with the the TI-99/4A as the levels from the TMS9929A video chip are just a little too close together. This results in the need to fine tune the voltage levels for each machine and reliability depends on how much noise is in the signal and how much those voltage levels drift with temperature.

I have included some test palettes to aid with setting up the voltage levels and you should try the following:
(When setting voltage levels it is a good idea to increase and decrease the levels until the image is incorrect and set the final value half way between those two settings)

1. Select the U7-TI-99-4A profile and ensure the TI startup screen is displayed:
Note the screen will probably blank after a while when you are making the adjustments but you can recall with QUIT (press FCTN and = keys)
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

2. Go into the palette menu and change the palette to "Test 4Lvl G or Y"
3. Go into the sampling menu and adjust the "Y Hi", "Y Mid" and "Y Lo" voltages until you get the following image:
Note the noisy blocks can be either of the colours shown but noisy may be better. (The noise isn't shown on the final palette)
Also The Hi voltage must be higher than the Mid voltage which must be higher than the Lo voltage.
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

4. Go into the palette menu and change the palette to "Test 4Lvl R or V"
5. Go into the sampling menu and adjust the "UV Hi", "UV Mid" and "V Lo" voltages until you get the following image:
Again The Hi voltage must be higher than the Mid voltage which must be higher than the Lo voltage.
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

6. Go into the palette menu and change the palette to "Test 4Lvl B or U"
7. Go into the sampling menu and adjust the "U Lo" voltage and maybe "UV Hi" & "UV Mid" until you get the following image:
Note the "UV Hi" and "UV Mid" settings are shared between "Test 4Lvl B or U" and "Test 4Lvl R or V" so if you have to adjust them to get a clean image you will need to go back to step 4 and check to see if it is still OK
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

8. Go into the palette menu and change the palette back to TI 99-4A
9. Go into the sampling menu and manually adjust the sampling phase for a noise free image (Auto calibrate isn't reliable due to the marginal signals).
10. Save the configuration in the main menu

You may have to repeat all the above to optimise but I can't guarantee that you will get a noise free solution as things are just too marginal. Also you may find that you get a good result when warmed up but it is a bit noisy at first when switched on from cold.

I think the only other options to improve this would be to modify the TI 99/4A to reduce any noise by giving the video chip it's own separate power supply and maybe connecting directly to the chip.

BTW the same video chip is used in MSX-1 machines so it might work with them as well but I haven't tested that.

Let me know how you get on.

Sch-LikA, 2021-05-26:
Wow !! These are what I call great instructions ! I have a 99% flicker-free setup now, thanks a lot ! Took some time to find the correct settings, but wow it looks awesome !

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

Never saw such a crisp image from any TI-99/4A !

Thanks again !!!

Closed 2021-05-26.

Thread 206 (2021-05-12):

HDMI-monitor blinking / display not usable as long as the Amiga (3000) system is not in workbench mode.

LouisAtGH, 2021-05-12:
Hello,
I combined The RGB to HDMI card with a Amiga 3000 having kickstart 3.1 ROM 40.068.  It only  working in workbench mode, however not in other situations. My findings are:
-	The display is flashing each second during the amiga boot-sequence card as long as the workbench is not yet started;
-	The same behavior if the boot sequence fails;
-	Or the system is booted without any floppy- or hard- disk;
-	Or the system is started using a game disk.
During the “flashing” about 1 seconds on and about 1 seconds off the Amiga is running properly and you can even control the Amiga (but it is very hard due to the intense flicker)
And strange enough, if I activate the RGBtoHDMI control menu …….. the flicker stops and the Amiga screen behaves normal. The flicker returns as soon as I leave the (Raspberry) control menu.
I tried to fix the problem by changing settings in the Raspberry setup and also, trying the problem by using a different Denise jumper setting and switching A3000 flicker fixer on and off. Nothing works. I am back to defaults (50Hz Amiga).
These findings are observed using latest software (20210322_f771e51 Release). I own the board for just two weeks and do not have any experience with earlier software versions.
I am sure it can be fixed in software, since the simple thing as calling the Raspberry setup menu is enough to let the problem disappear.
I hope this behavior triggers a bell and someone can fix it.
Sincerely,

Louis

IanSB, 2021-05-12:
Try the latest beta:
https://github.com/IanSB/RGBtoHDMI/releases

LouisAtGH, 2021-05-13:
Thanks!

 �

That solves the problem !!

 �

 �

Louis

 �

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

Zucky16, 2021-05-13:
Want to add my experience as well. Very similar situation and results.

System: Amiga 500 NTSC/PAL - I'm in Canada, so NTSC standard and 60Hz
Using RGBtoHDMI in NTSC all good no problems at all
Switch to PAL and screen flicker/blink with black screen every 1 second or so, made no difference booting from disk or SCSI same result
Press the menu button on the RGBtoHDMI, screen refresh is confirmed at 50Hz and is stable including faded Amiga 500 output in background, so long as the menu is on the screen all is good
Leave menu, back to flashing again
No amount of config seemed to help the matter at all

Following the direction of using the latest beta solved it, perfect PAL modes can switch to NTSC and back again, no problems
**_Installed Beta21 and everything is great._**

Thanks to all the devs and people putting time into this project it is a miracle!

IanSB, 2021-05-13:
This is caused by the machine having an NTSC crystal fitted but being configured to output a PAL signal. Because the crystal is the wrong frequency for PAL all the line and frame timings are wrong so it didn't match the profile. I added an extra profile with these slightly wrong timings.

IanSB, 2021-06-07:
Fixed in this stable release:

https://github.com/hoglet67/RGBtoHDMI/releases/tag/20210529_777ea4f

Closed 2021-06-07.

Thread 209 (2021-05-27):

Question on Apple IIc TTL support

timmcross, 2021-05-27:
I noticed Apple IIc TTL support in Beta30. Is that for the non-plus version? If so, that sounds awesome! What would the pinout be from the IIc to the RGB2HDMI?

IanSB, 2021-05-28:
@timmcross

Apple IIc DB15	<->  RGBtoHDMI 12 way header
3 Sync		     8 Sync       -> Composite sync
10 GR		     4 Intensity    -> Enables the auto NTSC Artifact Color Decoding
11 SEROUT            9 Green3        -> Video Data
13 GND                 3 Ground       -> Ground

timmcross, 2021-05-29:
So I tried Beta 30 and the text mode was inversed.  HGR seemed to be correct.  I noticed Beta 31 was out.  Switched to that and wow.  Works perfectly.

This project has allowed me to end my search for retro monitors and not be forced to live with composite video.  I can't thank you and the other contributors enough!  Analog parts are coming next week for the IIgs.  Awesome work!

IanSB, 2021-05-29:
>I noticed Beta 31 was out. Switched to that and wow. Works perfectly.

Yes, there were a couple of bugs in Beta 30 that stopped IIc support from working.

Also Beta 31 added line by line switching of NTSC artifacts so that the four lines of text in mixed modes stay sharp white and don't get artifacts. If you use the analog interface on the composite video output you will get exactly the same quality but the four lines of text in mixed modes will get artifacts as there is no way to automatically detect that mode although full text screens will still be sharp white because the colour burst is switched off.

Note for PAL systems, the PAL encoder must be disabled to use the composite output and you may have to manually switch artifacting on and off using long presses of SW2.

>Analog parts are coming next week for the IIgs

The IIgs is unlikely to work properly with the analog interface as that can only discriminate 64 analog levels (2 bits / 4 levels each of RGB) but the IIgs can output 4096 levels (4 bits / 16 levels each of RGB). It should be possible to connect the 12 bits + sync directly to the IIgs motherboard instead to pick up the 4 bits each of RGB instead much like the Amiga and Atari ST but appropriate profiles will have to be created.

However there is a further complication with the IIgs because it uses two different pixel clocks, one of 14.31818Mhz to display the Apple II compatible modes and the other of 16.3636Mhz to display the new IIgs hires modes.
Because the pixel perfect sampling needs to know the pixel clock frequency in use, two separate profiles would be needed to capture the above modes and preferably some way to auto detect which clock is in use so that the software can auto switch between the two profiles.

There is a similar problem with the BBC micro which uses pixel clocks of 12 and 16 Mhz and that is auto detected by looking for a slight timing variation in the sync signals. I don't think that will work with the IIgs but there may be other signals on the motherboard which could be used to infer which frequency is in use but as I don't have a IIgs it is rather difficult to investigate this any further at the moment. Wost case you would have to manually switch between the profiles depending on which mode is in use but that is not ideal.

timmcross, 2021-05-30:
Ah, ok.  Thanks for the information.  I wasn't aware of that issue with the IIgs.  I have used it with a 15kHz VGA monitor splitting the sync signal as well as with a GBS8220.  I was thinking I could just send RGBS to the RGB2HDMI and it would work.

If you need someone to do testing, I have a ROM01 IIgs.

IanSB, 2021-05-30:
@timmcross
>If you need someone to do testing, I have a ROM01 IIgs.

Thanks, that would be very useful.
I'm pretty confidant that I can create appropriate profiles for the two pixel clocks and if you are willing to solder up the 12 bits to your IIgs motherboard you can try them but as mentioned we really need to determine if there is a signal on the motherboard that can be used to infer which pixel clock is in use. The vertical sync input would normally be unused so that could be connected to such a signal to auto select the right profile.

If you are able to use an oscilloscope to look at some IIgs signals that would help a lot.

Unfortunately it doesn't look like there is a simple logic level available indicating the clock speed but one possible way might be to look at some of the signals coming out of the Mega II chip (which emulates the Apple II functionality).
One of the signals out of the Mega II is SEROUT which is the mono video signal and that goes to TP154 and another is WINDOW which goes to TP155. If these are active in Apple II modes but 0V in IIgs modes they might be a possible signals to use.

NJRoadfan, 2021-06-06:
> Unfortunately it doesn't look like there is a simple logic level available indicating the clock speed but one possible way might be to look at some of the signals coming out of the Mega II chip (which emulates the Apple II functionality).
> One of the signals out of the Mega II is SEROUT which is the mono video signal and that goes to TP154 and another is WINDOW which goes to TP155. If these are active in Apple II modes but static in IIgs modes they might be a possible signals to use.

There is likely a way to determine if SHGR or classic Apple II modes are running on the IIgs. There was a clip-on VGC adapter available at one time that gave the ROM3 IIgs HDMI output: [http://tulip-house.ddo.jp/DIGITAL/gsdvi/index.html](http://tulip-house.ddo.jp/DIGITAL/gsdvi/index.html)

The ROM 01 wasn't compatible since it has a socketed VGC. Looks like the adapter compensated for the horizontal width difference by increasing the border size on the left and right sides in 14.318Mhz mode.

IanSB, 2021-06-06:
@NJRoadfan

There is this comment on the web site you linked:

>Since this auto detection is not perfect, you can also use the adapter in manual mode

So it looks like it is inferring the state from some other signal or signals

IanSB, 2021-06-07:
@NJRoadfan

Thinking about it, a standard Apple II video line is 912 clock cycles long. AIUI the IIGS VGC video clock is supposed to be 8/7 times the 14.318 Mhz clock which is 16.3636Mhz but if you multiply 912 by 8/7 you get 1042.285 so the line length and thus sync timing may vary slightly in the IIGS modes as it can't use a fractional line length. Maybe that's why it's not reliable as the detection is looking for a very slight sync timing change.

NJRoadfan, 2021-06-07:
@IanSB

The SHGR modes on the IIgs were a bit fussy to adjust/capture using both the OSSC and directly with a RGB frame-grabber (Epiphan DVI2PCIe). I could get 640x200 mode dialed in pixel perfect, but always had a problem when the machine switched to 320x200 mode and had to re-adjust.

IanSB, 2021-06-07:
@NJRoadfan

That might be an issue with the 640 pixel modes using a different clock phase to the 320 pixel modes. Something similar happens with an original IBM CGA card where the pixels for text and graphics modes are 180 degrees out of phase so sampling has to be set to 90 or 270 degrees as a compromise value. The Atari ST also has that sort of problem as the phase relationship between the sync pulse and the pixels shifts by 180 degrees randomly on power up so again a 90 or 270 sampling phase has to be used.

As I don't have any IIGS hardware this is going to be difficult to investigate any further.

timmcross, 2021-06-09:
I see what you are saying with the number of colors.  With the YUV CPLD, I can get a picture using the Apple II preset but the colors are off, even in the control panel.  Cycling through those colors doesn't show up correctly.  Red for example does not show up.  This is my only IIgs (ROM01) so let me know if you need me to check something.  Now that you have solved the IIc and Laser 128, this would be my last display issue to solve.

IanSB, 2021-06-09:
@timmcross

Logging some info to start with would be useful.
Could you try the following:

Hook up your board to the IIGS composite output as above and display an Apple II compatible mode.
Then display the source summary page in the info menu and screencap it by pressing SW2 & SW3 simultaneously.
Switch to one of the IIGS super hires modes, exit and redisplay the source summary page and screencap it again.
(You must exit the menu and redisplay it as it might not get updated othewise)
Then use the save log and EDID option.
Finally post the two screencaps and log.txt from the SD card.

timmcross, 2021-06-09:
No problem.  For clarification, should I use what I already tested, connecting to the 15 pin video expansion or should I make a new cable and connect directly to the composite video out of the IIgs?  What would the cable pinout be to connect directly to the composite RCA jack to the analog board?

IanSB, 2021-06-09:
@timmcross

It doesn't really matter as long as you are getting a locked image as I'm only interested in the sync timing.

timmcross, 2021-06-09:
Here are the files.  I used Copy II plus for the Apple II compatible mode, then I used the super high res test from the iigs dealer diags for the other mode.  Let me know if this helps.
[Captures.zip](https://github.com/hoglet67/RGBtoHDMI/files/6625762/Captures.zip)

IanSB, 2021-06-09:
@timmcross

Thanks for those.

It looks like the sync timing is identical for 14.318Mhz and 16.363Mhz pixel clocks which means that sync timing must always come from the 14.318Mhz clock and there must be a phase discontinuity in the 16.363 Mhz pixel clock during horizontal sync as one line would be 1042.285 clock cycles long.

That in itself isn't an issue because the sample clock on RGBtoHDMI is run at 8x the pixel clock and is phase locked to the beginning of each line but the calculation of the actual sample clock frequency will have to be altered to take into account the additional fractional part of the line length.

How exactly have you connected the IIGS at the moment? (Which signals & which interface?)
If the analog interface did you fit U7 on the rear of the board?
Which profile and did you make any changes to it?

I should be able to give you a profile to test 16Mhz sampling with you current connection and if that works then 2 profiles could be created for 12bits per pixel at the two clock frequencies but in order to test that you would have to wire up the RGBtoHDMI directly to the motherboard to pick up the 12 bits directly from the hybrid DACs

timmcross, 2021-06-09:
I have the 6/8 bit RGBtoHDMI board with the Issue 3 Analog board.  I have R,G,B,S, and ground connected to the analog board from the DB15 connector on the IIgs.  I haven't fitted the 3rd chip on the rear of the analog board but I can add that.  I believe the Apple II profile was selected and I was trying different settings so I am not 100% sure where it stands.  I can reset the SD card and try it again if there is a certain profile you would like me to try.

IanSB, 2021-06-09:
@timmcross

Unzip the attached file, overwrite the existing kernel.img file on the SD card with this one and copy the two AppleGS profiles into:
\Profiles\6-12_BIT_RGB_Analog on the SD card.

Then program the RGB CPLD and try selecting the two profiles as appropriate:

Apple IIGS HR for 14.3 Mhz Apple II compatible modes
Apple IIGS SHR for 16.3 Mhz Apple IIGS super hires modes

These are setup for 3 levels each of RGB so you will only get a vague approximation of the source image but the object at the moment is to get a clean image with no pixel jitters or flickering (Like your Apple II compatible screencap above).
At a minimum you will need to do an auto calibration but you may have to tweak the DAC voltage levels in the sampling menu as well as I have guessed the values.

Best test results will be achieved with peak white images only so if you have a mono SHR test image please use that.

As before if you can do two screencaps and a log save and post them that will let me analyse the results.

[GS_Test_1.zip](https://github.com/hoglet67/RGBtoHDMI/files/6626936/GS_Test_1.zip)

NJRoadfan, 2021-06-10:
@timmcross

The GS/OS Finder desktop is a good test for 640 SHR mode. Load up a graphics program like Platinum Paint to test 320 SHR and create test patterns.

timmcross, 2021-06-10:
I copied the files over from the zip.  Reprogrammed the CPLD for RGB and switched to HR to test in Copy II plus.  Looks like it couldn't find sync.  I also started up GS/OS with SHR and it also couldn't find sync.  I tried the auto calibrate but no change.  Take a look at the screen caps and let me know what you think.  Also, if you have some guidance on adjusting the DAC levels, that would be great.
[Captures_061021.zip](https://github.com/hoglet67/RGBtoHDMI/files/6633088/Captures_061021.zip)

IanSB, 2021-06-10:
@timmcross

First try adjusting the DAC-E Sync level to see if you can get the image to lock
If that doesn't work you can try sync on green by setting "Sync on G/V" to "On" then adjust DAC-F GV Sync to try for a locked image. (If you were using the Apple II profile originally, that was effectively setup for sync on green)

If you get a locked image you can try adjusting the Hi and Lo levels to threshold the incoming RGB video. The Lo value sets the voltage at which 50% RGB is displayed and the Hi level adjust the level at which 100% RGB is displayed. The Lo value should always be less than the Hi value for each colour. Note the red and blue channels share a setting but the green channel is separate.

Run the Auto calibration or manually adjust the Sampling Phase for noise free results.

Use the save configuration option after finishing

timmcross, 2021-06-10:
Messing with DAC-E didn't seem to help.  Turning on Sync on G/V and then adjusting DAC-F to even 0.00 got the sync to lock.  I tried increasing the voltage a little but wasn't sure how high to set it.  I did that for both HR and SHR modes.

Colors are still incorrect so I wasn't sure if I should fit the other IC on the back of the analog board now?  I took some more captures and saved the log again.  Auto calibrate couldn't get the picture perfectly stable and it seemed like the brightness or contrast was too high.  I didn't mess with those settings yet.  Let me know what you think.
[Captures_061021-2.zip](https://github.com/hoglet67/RGBtoHDMI/files/6634913/Captures_061021-2.zip)

IanSB, 2021-06-11:
@timmcross
>Messing with DAC-E didn't seem to help

That probably means you haven't connected the sync input to the right pin or there is something wrong with the sync input on your analog board

>DAC-F to even 0.00 got the sync to lock

It looks like the IIGS outputs sync on green so that's why it works.

I can see there are some pixels that are purple which should be white so you probably need to tweak the G Hi and G Lo levels.
However the red and yellow vertical stripes across the screen look clean and stable enough to indicate that the sampling clock is working properly so we could proceed to the next stage:

This would involve soldering a ribbon cable from the 12 way IDC header on the main RGBtoHDMI board directly to pins on the motherboard, specifically the H2, H3 & H4 hybrid DACs which are the yellow resin SIL packages next to the VGC (they look like SIL resistor packs).

With your existing board you would only get 9 bits per pixel instead of 12 but most images would look pretty close with only the least significant bit each of RGB missing.

If that works OK you will need to get a 12 bit RGBtoHDMI board with 12 bit extender and wire that up instead to get all bits sampled correctly.

You would still have to manually change the profile until we found a suitable signal to control auto switching.

If you want to try the above, I'll create a couple of profiles for the direct connection and detail the wiring instructions.

timmcross, 2021-06-11:
Yeah, that sounds fine.  I will check the sync coming out of the 15-pin connector on the IIgs.  I wonder if that is no longer working.  I had it connected to a LM1881 and connected to a VGA monitor which worked fine for a while but then stopped.  As you said, it sounds like sync is also going out on green too.

I will order the 12 bit board and the extender if you could post the profiles and wiring instructions.  They will probably take a couple of weeks to come in.

NJRoadfan, 2021-06-11:
@timmcross
Pin 3 is composite sync and Pin 12 is composite video on the DB-15 video port on the IIgs. Sync-on-Green should work as well.

IanSB, 2021-06-11:
@timmcross

Here are the profiles for 9 bits per pixel (for your existing board) and 12 bits per pixel (for a new board):
[GS_Test2.zip](https://github.com/hoglet67/RGBtoHDMI/files/6640856/GS_Test2.zip)
(I also included the updated kernel.img file but it's the same as the last one)
Put the profiles in \Profiles\6-12_BIT_RGB and reboot

Looking at the IIGS schematic, the bit order of the RGB signals is unclear as the 12 bits coming out of the VGC are only labelled Vid0 - Vid11
https://mirrors.apple2.org.za/Apple%20II%20Documentation%20Project/Computers/Apple%20II/Apple%20IIGS/Schematics/Apple%20IIGS%20ROM%2001%20Schematics.pdf

It is likely that pins 2-5 of H2 are the blue bits, pins 2-5 of H3 are the green bits and pins 2-5 of H4 are the red bits but I'm not sure which end is the most significant bit (i.e. is it 2,3,4,5 or 5,4,3,2) so you will have to do some investigation and experimentation.

For 9 bit per pixel connection with your existing board:
Make up a 12 way ribbon cable with a 12 way IDC header on one end to plug into P2 on the RGBtoHDMI board.
(make sure to get pin 1 the right way around)
Solder the wires on the other end as follows, probably best to do on the underside of the motherboard as all signals are on through hole components:

DO NOT USE THIS WIRING FOR THE 12BPP BOARD AS THE WIRE NUMBERS ARE DIFFERENT!

Red Channel
Wires 7, 5, 1 to H4 pins 2, 3, 4 OR pins 5, 4, 3 depending on the bit order

Green Channel
Wires 9, 4, 10 to H3 pins 2, 3 ,4 OR pins 5, 4, 3 depending on the bit order
(Note this uses the Vsync input on RGBtoHDMI as one of the green bits in 9 bit mode)

Blue Channel
Wires 11, 6, 2 to H2 pins 2, 3, 4 OR pins 5, 4, 3 depending on the bit order

Sync
Wire 8 to H1 pin 3 (H1 appears to be green, not yellow)

GND
Wire 3 to H3 pin 7

+5v
You can connect Wire 12 to +5v on the motherboard if you want to power the RGBtoHDMI from the motherboard instead of using a separate USB power supply but then you must make sure never to connect the USB power as that will feed +5v backwards into the motherboard.

I suggest wiring up just one of the RGB channels plus the other signals first to find out which order is correct.
There is a video test program disk image here:
https://manilagear.com/downloads/
If you run the super hires 320 mode you can check the bit order for the channel you wired up which will look like this if you got it the right way around (except every pair of blocks will be the same colour due to missing bit)
https://manilagear.com/wp-content/uploads/2016/12/IMG_2364.jpg

Wiring up the 12 bit version is very similar but uses all 4 bits per RGB and the wire numbering is different as the extra 4 bits are wires 1 - 4 and the Vsync input is not used as one of the green bits.
To avoid confusion I will post 12 bit wiring details later if you manage to get the above working and want to try the full 12 bit board.

timmcross, 2021-06-12:
OK thanks for the info.  I have ordered the 12 bit boards.  I also checked the connection and found that the sync wire I was using wasn't making the connection.  I replaced it with a different wire and was able to turn off sync on green.  Not sure if you need me to send you more screen captures or logs at this point.

While I wait for the boards, I will look into wiring up to the DACs on the motherboard.  It doesn't look like it would be that hard.  It might take me a few days though as things are coming up.  Thanks again for the guidance!

IanSB, 2021-06-12:
@timmcross

It would be useful to wire up your existing board as a 9 bit test so we can determine if it's going to work at all before wasting any time building up the 12 bit boards. (That would also determine the bit order so I can finalise the 12 bit wiring instructions - the first option in my RGB instructions above is the most likely bit order)

I've implemented manual switching between the 14Mhz and 16Mhz timings by pressing SW3 so even if we can't get auto switching working it will be easy to toggle between the two modes without having to call up menus.
I'll post the updated software in a few days once I've finished testing it.

BTW do you have an oscilloscope? That would be useful for looking at potential signals to use to determine if  a 14Mhz or 16Mhz mode is in use.

timmcross, 2021-06-13:
Sure, no problem.  It might take me a few days to find time to tear my GS apart but I will see what I can do.  And I recently purchased an oscilloscope so let me know what you need.

timmcross, 2021-06-16:
So I hooked up the red channel, sync, and gnd as you directed and copied over the profiles.  Here are some screen caps using the video test program you linked.  Let me know if it seems I am on the right track.
[061521.zip](https://github.com/hoglet67/RGBtoHDMI/files/6659696/061521.zip)

IanSB, 2021-06-16:
@timmcross

Yes that looks correct so I guess the first option in the RGB wiring bit order above is the right one.
In the SHR capture0.png image the red blocks are twice as tall as in the example photo linked above due to the missing bit in 9 bit sampling mode.

If you can hook up the green and blue channels we can next look at the sampling:
The SHR 640 pixel mode in capture2.png looks clean but the SHR 320 pixel mode in capture0.png & capture1.png looks ragged on the right hand side columns so there may be an issue with the sampling clock or sampling phase although the PPM error might indicate some issue with the timing calculation

Here is updated software which has manual switching support added and improved sample timing calculation:
Wipe your SD card and install the new files.

[AppleIIGS_test.zip](https://github.com/hoglet67/RGBtoHDMI/files/6662318/AppleIIGS_test.zip)

There are now only two profiles:
Apple IIGS (This is the 12 bit version)
Apple IIGS 9 bit (The one you should be using with your existing board)

To switch between Apple II compatible mode and SHR mode you can either press SW3 on the converter or select "Set1" or "Set2" from the "Timing Set" option in the main menu (Set1 is SHR & Set2 is Apple II)

As before, post some screencaps including the source summary

timmcross, 2021-06-16:
Looking great so far!  I had Set1 and Set2 backwards for a bit.  SW3 worked great.  Let me know if you need anything else.  The 12-bit boards I ordered from China have been made but not shipped yet...
[061621.zip](https://github.com/hoglet67/RGBtoHDMI/files/6664443/061621.zip)

IanSB, 2021-06-16:
>Let me know if you need anything else.

They look great and the timings in the source summary menu now look correct unlike the earlier SHR ones.

I think the only technical thing I'd like to see is a screencap of SHR 320 pixel mode with "busy" detail rather than the plain blocks to confirm that it is sampling pixels correctly and there is no issue like the one mentioned by njroadfan above.
Generally some good looking 320 and 640 pixel graphics screencaps including the desktop would be nice as well to see what the SHR results look like.

@timmcross

I've added the 12 bit Apple IIGS wiring info to the cables section:
https://github.com/hoglet67/RGBtoHDMI/wiki/Cables

Next thing is to investigate if there is a signal available on the motherboard that can be used to auto switch between Apple II and SHR modes.

I've already added an auto switching option that switches between the two sets depending on the state of the VSYNC input. If that is low it selects set 1 and if it's high it selects set 2 and that might be all that is required if we can find a signal like that.

However it is also possible that the signal might vary in a different way:
e.g. a "busy" signal with lots of transitions per frame in Apple II mode and static in SHR mode or vice-versa which would require some additional software support to monitor.

There doesn't appear to be an explicit signal to switch between the modes as I think that is just a register bit in the VGC so it would have to be another signal that changes in some way when switching modes.

I think you will just have to probe the VGC and Mega II chip pins to see if anything repeatable happens when changing from an Apple II mode to an SHR mode.

Here are a few suggestions after looking at the schematic here:
https://www.applefritter.com/files/2021/03/18/Apple%20IIgs%20schematic.pdf

The Mega II chip ouputs  SERVIDEO on pin 21 (TP154) and WINDOW on pin 49 (TP155) and these might be busy in Apple II mode and static in HGR mode

The VGC has FLIP6 on pin 49 (TP24) and FLIP7 on pin 48 (TP25) which appear to change address bits to alter the memory map and I understand that the memory map is different in Apple II mode so those are other possibilities.

We really need someone who is familiar with the IIGS hardware to help with this.

timmcross, 2021-06-17:
OK, I was able to take some more screencaps tonight.  I will get out the oscilloscope tomorrow and see if I can take some readings.

Some other questions (forgive me if they are listed elsewhere in the Wiki):
- I noticed that some screens seem to start drawing the border near the top right of the screen.  The capture of the blue screen shows that pretty well.  Just curious what that is?  Would we not see it on a CRT monitor?
- Is there a good way to shut the pi down gracefully?  I feel removing the power abruptly may affect the SD card.  Looks like SW4 reboots the pi.  Could it be used to power down?
- Does the PI Zero handle this well enough or would it be better to use a PI3 or higher?
- I think I remember reading that systems with faster graphics would be too much for the RGBtoHDMI.  Could this be used with say a NES or other console?
[061621-2.zip](https://github.com/hoglet67/RGBtoHDMI/files/6667073/061621-2.zip)

IanSB, 2021-06-17:
@timmcross
Thanks for the images, they look really good

>I noticed that some screens seem to start drawing the border near the top right of the screen. The capture of the blue screen shows that pretty well. Just curious what that is? Would we not see it on a CRT monitor?

Part of the video signal that is normally hidden off the top of the screen is being captured and that shows a few black video lines before the border starts. The capture values were just a best guess and have to be optimised on actual hardware.

You can adjust the capture area and position by adjusting the settings in the geometry menu as follows:

Change the Setup mode to "Set Min/Offset" (this will crop off most of the border)
Adjust the V and H offsets until the main part of the screen is visible and centred (The horizontal position will only be to the nearest 4 pixels)
Change the Setup mode to "Set Maximum"
Adjust the Max H Width and Max V Height for the maximum values that will capture the whole border without any black lines or columns around the edges

You need to do this twice, once in an SHR mode and once in an Apple II mode

When complete, save the configuration in the main menu and post the resulting file which will be in /Saved_Profiles on the SD card. I'll put that version in any new release.

IanSB, 2021-06-17:
@timmcross

>Is there a good way to shut the pi down gracefully? I feel removing the power abruptly may affect the SD card. Looks like SW4 reboots the pi. Could it be used to power down?

The software is bare metal and there is no operating system. Once the software has booted, the SD card is only accessed when reading or writing a saved setting from the menus so there are no open files and nothing to 'safely shut down'. It essentially behaves like an 8 bit computer in this respect.

>Does the PI Zero handle this well enough or would it be better to use a PI3 or higher?

The Pi2 and Pi3 are actually slower with this application because uncached memory access is slower with them and the extra cores don't help. It doesn't currently work properly on the Pi 4 as some of the integrated peripheral hardware has changed.

>I think I remember reading that systems with faster graphics would be too much for the RGBtoHDMI. Could this be used with say a NES or other console?

Probably not as it is limited to 12 bits per pixel and those 12 bits must be available digitally, not just an analog RGB voltages coming out of a chip. (It can handle up to 6 bits per pixel in analog mode)

timmcross, 2021-06-18:
@IanSB
Thanks for the info.  I think I located a 5V connection on OS1 which is here next to the DACs.  I will use that when the 12-pin boards show up.

I played with the geometry settings and attached some captures and the profile.  Let me know if I scaled it correctly.  I wasn't sure how much border to leave.
[061721.zip](https://github.com/hoglet67/RGBtoHDMI/files/6674380/061721.zip)

IanSB, 2021-06-19:
@timmcross
Thanks for the tweaked profile

>I think I located a 5V connection on OS1 which is here next to the DACs

I think there is +5v on Pin 10 of H1

IanSB, 2021-06-19:
@NJRoadfan

Now it's basically working I've been looking at auto detection:
From the converter you linked above, it seems that most of the PLCC pins have been removed and it looks like only the following pins are in use:
62-68 & 1-6 (12 bits RGB + sync)
8    (VDD)
59  (VSS)
10  (14.3Mhz clock)

That doesn't leave many options for auto detection and the only two I can think of are:
1. Comparing the 14.3Mhz clock phase with the phase of
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

Thread 211 (2021-06-12):

AKAI PG1000 CRT issue

jczmok-iag, 2021-06-12:
Hi, i've got an old Akai PG1000 here where i try to get the rgbtohdmi running with.
I shortly see the AKAI logo "partly", it does not seem be in sync.

https://www.acc.umu.se/~polarn-p/irr/99musik/Akai_dokument/Akai_Digital_Matrix.pdf
-> MZ1000 tech data (is the original monitor).

as it is DB9 i would assume it is CGA, but i would to verify:
- cable is correct => does the numbering on the MALE adapter on the solder side start with 1 on right top ? It's a bit unclear in the documentation what the CGA DB9 wiring should be.
- - profile is CGA on the rgb clpd

Thanks for helping me out.

jczmok-iag, 2021-06-12:
This looks like when i am using CGA mode ( AKAI logo shortly appears, but does not look right)

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

I've used this wiring:
https://github.com/hoglet67/RGBtoHDMI/wiki/Cables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

however what seems odd to me, when i am looking up CGA wiring, there is some discrepancy:
http://brassicgamer.blogspot.com/2017/06/cga-ega-serial-modems-difference-how-to.html
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

Please avise...

IanSB, 2021-06-13:
>however what seems odd to me, when i am looking up CGA wiring, there is some discrepancy:

The wiring for RGBtoHDMI supports EGA as well as CGA. In CGA mode, Pin 6 is intensity and pins 2 & 7 are ignored. In EGA mode Pin 6 is secondary green, pin 2 is secondary red and pin 7 is secondary blue

>I shortly see the AKAI logo "partly", it does not seem be in sync.

The pdf documentation says that the monitor sync input is 5v digital TTL level negative going composite and the RGB inputs are 0.8v level analog.
In the CGA standard, the sync levels are 5v digital TTL level positive going separate H & V and the  RGB signals are also 5v digital TTL levels like the sync so the output of the AKAI isn't CGA at all, it just uses a similar connector and that is why it doesn't work because RGBtoHDMI is expecting approx 5v RGB signals not 0.8V analog signals and separate syncs instead of composite sync.

To get the image to lock you could go into the geometry menu and change the Sync Type to composite but that won't help with the wrong level RGB values (Save the config before exiting the menu)

You might be able to get it working using the analog addon board but it would depend on how many levels of analog video were being output by the AKAI.

Are there lots of shades of colour/grey on the output or is it just peak RGB / White?

jczmok-iag, 2021-06-13:
Originally (by looking at -> https://www.acc.umu.se/~polarn-p/irr/99musik/Akai_dokument/Akai_Digital_Matrix.pdf ) I only see b/w. Okay, then time to get the analog board ordered and testing then. I keep you updated!

jczmok-iag, 2021-07-07:
Okay, analog board is mainly assembled. Any wiring idea ? (and see my other question about D1)

IanSB, 2021-07-07:
@jczmok-iag
>. Any wiring idea ?

CGA pin 1 to 6 way Pin 1 (GND)
CGA pin 8 to 6 way Pin 2 (Composite sync) - Possibly CGA Pin 9 to 6 way pin 2 instead if composite on Vsync instead of Hsync
CGA pin 5 ro 6 way Pin 3 (BLUE)
CGA pin 4 to 6 way Pin 4 (GREEN)
CGA pin 3 to 6 way PIN 5 (RED)

Pin 6 of 6 way (5v in) not connected, power the Pi zero with a 5v usb adapter

After connecting: copy this profile into the /Profiles/6-12_BIT_RGB_Analog on the SD card, reboot the Pi zero and select it with the profile line:
[AKAI PG1000.txt](https://github.com/hoglet67/RGBtoHDMI/files/6779740/AKAI.PG1000.txt)
This profile is set up for CGA timing with 5v composite sync and 75R terminated .8v RGB signals as described in the Akai manual

You may need to tweak some of the RGB Hi & Lo levels in the sampling menu but give it a try and post some screencaps and the System summary menu

jczmok-iag, 2021-07-09:
Finally found a quiet minute to finish the wiring (according to your setup): IT'S WORKING.
Startup looks a bit washy, but once it's started, Display works. You can now officially add this setup to "supported" list.

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

IanSB, 2021-07-09:
@jczmok-iag

Did you run an auto calibration to set the optimum sampling point?
If so what sampling phase number was chosen?
(I'll make that the default)

jczmok-iag, 2021-07-10:
Well as the Message was blinking , nevertheless i did try a auto calibration but nothing changed. seems to be good so far.

IanSB, 2021-08-04:
I've added the profile to the RGB Analog set but it's called 'Analog_CGA' as it might be useful on other systems with similar analog outputs with CGA timing.

Closed 2021-08-04.

Thread 212 (2021-06-14):

Sparklies on the Tandy Color Computer 2 model 26-3026 NTSC

qbancoffee, 2021-06-14:
Excellent project!

I built V4 of the rgb to hdmi board and V3 of the analog 6 bit board and I tested with several versions of the firmware with
the same results. The versions were 20201126, 20210529 and 20201126.
I wired the analog board to the VDG chip to capture YUV signals and selected the Tandy CoCo 1/2 profile.

I get a very nice image but there are sparkllies all over the screen particularly the non-green screens. I've cleaned up the wiring and tested with to CoCo 2's.

I don't know if this is relevant but things seem to clean up when there is more green on the screen.
I have tweaked things in the sampling menu like AC/DC coupled with some improvement but not a perfectly clean image.

Is there something that I should look for or tweak?

Thanks, and once again, excellent project!!!!

IanSB, 2021-06-14:
@qbancoffee

If there are sparklies on flat areas of colour then you should try adjusting the Hi & Lo voltage thresholds for Y and UV (mainly Y). If the sparklies are on transitions between different coloured pixels then try running an auto calibration or manually changing the sampling phase.

Posting a screencap might help. (Short press of SW2, file on SD card)

qbancoffee, 2021-06-14:
Yes, a screencap would have been helpful...
Here are some I took. the sparklies show up quite a bit but it's hard to get a good screencap but these do have some.

-boot1.png : Regular green startup screen no cartridge loaded.
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

-cls4_0.png & cls4_1.png: When issuing the cls commandd followed by a number you can change the screen color.
   These two images show how the screen color alternates until I hit a key on the keyboard that causes the cursor to move and add  more green.
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

-megabug_0.png: loaded megabug cartridge and you can see sparklies.
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

-megabug_1.png: next screen with sparklies.
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

IanSB, 2021-06-14:
Can you do a screencap after running the line of BASIC shown in the gallery example:
FORI=32TO255:?CHR$(I);:NEXT
https://github.com/hoglet67/RGBtoHDMI/wiki/Gallery-of-Screencaps

qbancoffee, 2021-06-14:
I made a video that I though would better show what is happening.
https://youtu.be/5N2qXr0cjP0

IanSB, 2021-06-14:
Also are you powering the converter from a USB supply or from the coco?
There seems to be a lot of noise in the system as it is normally really difficult to get sparlikes on red as the thresholds for the analog voltage are >1V and I have only seen that kind of problem when using a very noisy USB 5v supply.

qbancoffee, 2021-06-14:
I am powering it straight from the coco but initially I was using an external power supply with the same problem. It have cleaned up the wiring since so I'll go grab a power supply and test again.

qbancoffee, 2021-06-14:
I just tested it with two canaKit power supplies with the similar results.....
I think I may have to build another analog board to rule out any damage or bad components.

IanSB, 2021-06-15:
You mentioned trying another coco, was that the same model?
I have an NTSC coco 26-3134, a PAL micro colour computer, a Dragon and an Atom, all which use the 6847 and produce clean results but maybe some coco revisions are more noisy than others although as mentioned, most colours should be robust with only green & orange being more susceptible to noise. (I'm powering the converters from the machines.)

Try soldering some decoupling capacitors across the 6847 power pins.
Another thing to try would be to put low value capacitors on the YUV lines to add a small amount of filtering (maybe a few hundred picofarads).

>I think I may have to build another analog board to rule out any damage or bad components.

Make sure your decoupling capacitors are the right values (10uF & 100nf)

qbancoffee, 2021-06-15:
Well, technically yes they are the same model ,26-3026 NTSC, except that one is a motherboard that I cloned and assembled from
scratch. I based it on the same schematic so except for how the board is routed they are the same. However, The info I'm providing here is from the original Tandy coco not my clone.

I'll double check the capacitor values and try adding decoupling capacitors across the 6847 power pins and some low value caps from YUV to ground.

Thanks for the advice!

qbancoffee, 2021-06-15:
I confirmed that the caps are not switched and then went ahead and replaced the CPLD and the MAX5259EEE .
Unfortunately the results are the same. I'm currently testing with decoupling capacitors and filters with capacitors I have
available to see if I can get any improvement.

qbancoffee, 2021-06-15:
I have made some progress in that I'm pretty sure it isn't the RGB2HDMI solution...... I decided to wire it into my CoCo 1
and after calibration and switching to AC coupled, the picture is absolutely flawless.
It seems that the CoCo2 is a little noisier than the CoCo 1 and this means that I now need to see if I can find out why.

Again, thanks for this excellent project and your help!

qbancoffee, 2021-06-15:
Here is a video of the same boards but with longer messier wires connected to my CoCo1
https://youtu.be/vix40zV71jA

qbancoffee, 2021-06-15:
I guess this issue is still valid because it's an issue with these boards on the CoCo 2. Should it remain open?

IanSB, 2021-06-15:
>It seems that the CoCo2 is a little noisier than the CoCo 1 and this means that I now need to see if I can find out why.

That is the main issue with the thresholding approach to A to D conversion, it either works very well if there is enough noise margin or terribly if there isn't as it has a 'digital cliff edge' effect. It isn't all CoCo 2s though as mine is fine but it's a different model number so different PCB layout etc.
Unfortunately I don't have a large enough sample size to know how much of an issue this is.

I assume you have tried varying the DAC lo & hi values as the optimum values will vary from machine to machine.
Varying those is an alternative to the AC coupled option.

BTW the other issue you had with cls0 changing colour when you add more green is a bug in the auto NTSC artifact detection.
It's meant to switch on NTSC artifacts if the screen is only monochrome and switch off again when there is any colour on the screen but it switches on when the screen is mostly monochrome instead of completely monochrome.
I have fixed that and there will be a new beta to try soon.

qbancoffee, 2021-06-15:
Yes, I have tried varying the DAC lo & hi values on both of my CoCo 2's with mixed results. If I lower the Y hi when one of my games is loaded, the picture produced is perfect. However, when I return to BASIC with those settings the picture is discolored and bouncy.
I'll continue testing but my I'm kind of guessing at values so it might take a while......

Good to know that you have a fix for the the auto NTSC artifact detection.

IanSB, 2021-06-15:
>Should it remain open?

Yes for now.

It looks like the service manuals are available for both your problem one:
https://colorcomputerarchive.com/repo/Documents/Manuals/Hardware/Color%20Computer%202%20NTSC%20Service%20Manual%20(26-3026%20&%2026-3027)%20(Tandy).pdf
and my working one:
https://colorcomputerarchive.com/repo/Documents/Manuals/Hardware/Color%20Computer%202%20NTSC%20Service%20Manual%20(26-3134%20&%2026-3136)%20(Tandy).pdf

A few suggestions:
Try isolating the YUV pins on the 6847 from the rest of the circuitry so they only feed the RGBtoHDMI (Maybe remove the modulator?)

Change the comparators on the analog board from MAX9108 to MAX9144 (MAX9144ESD+). They are pin compatible slower parts (40ns instead of 25ns) which might have the effect of filtering out any high frequency noise. I have tested these on on some of my analog boards so they will work but I don't know if they will help with the noise.

qbancoffee, 2021-06-15:
Thank you for the links.

I've  tested my CoCo's with and without the RF modulator but the results are the same. I'll purchase the other comparator
and see what that does and for the moment 'll study the schematics to see If I can see any differences that might help.

fingers crossed.

qbancoffee, 2021-06-16:
What I forgot to ask you is what are the settings you are using for your CoCo 2?

IanSB, 2021-06-16:
@qbancoffee
>What I forgot to ask you is what are the settings you are using for your CoCo 2?

The default values in the profile.

The Y Hi & Lo settings are quite marginal but only affect white, green and orange. The UV Hi and Lo settings have a wide range and affect all other colours (yellow, blue, red, cyan and magenta etc)
There are some test palettes that allow you to examine the individual channels so perhaps you could try the following:
First run the for/next loop to get some colours on screen:
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

Then go into the palette menu and select:
Test_4_Lvl_B_or_U
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

Try adjusting the UV Hi and UV Lo settings (Hi must always be greater than Lo
UV Hi adjusts the white level
UV Lo adjusts the blue level
The range of values that are noise free on my setup are
UVHi 113-142
UVLo 76-109

Repeat the test with:
Test_4_Lvl_R_or_V
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
UV Hi adjusts the white level
UV Lo adjusts the red level
The range of values that are noise free on my setup are
UVHi 113-142
UVLo 76-109
(Same as the first one)

The optimum values will be half way between the two extremes

Note these values are shared between the two channels so if there is any difference then an average value will have to be selected.

Finally select
Test_4_Lvl_G_or_Y
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

Y Hi adjusts the yellow
Y Lo adjusts the white

The range of noise free values for me is:
Y Hi: 41-45
Y Lo: 21-36

The interesting thing is that all the above are virtually identical for my PAL micro colour computer and my NTSC CoCo 2 which are two very different machines which is why I'm surprised there is much more of an issue with your CoCo 2 and reproduction.
I can't really see a significant difference in design between the working and problem revisions.

qbancoffee, 2021-06-16:
Things are not perfect but I was able to improve things dramatically by bypassing the CoCo 2's transformer with a clean DC power supply and by powering the raspberry pi with a separate power supply.

I'll try what you described and replace the software with artifact fix you just sent and see how it goes.
Thanks for detailed instructions!

qbancoffee, 2021-06-17:
There was some stability by  just using this new version of the software even though there should not have been?

I went through your instructions and I can get a very clean screen with all colors until I load one of my games cartridge or tape.
I'll try and make a video to demonstrate it.

qbancoffee, 2021-06-17:
I went through everything as you described it and I now have a better understanding oh how it works. Thanks!
Here is a video sort of demonstrating what I'm talking about.
https://youtu.be/5f4k-8KudQ8

IanSB, 2021-06-17:
@qbancoffee

When you get sparklies around colour transitions like the characters at 2:30 rather than on solid blocks of colour you need to adjust the sampling phase. Note that the sparklies on the blue or orange areas in megabug are actually on transitions because those colours are actually hi res mono dot patterns with artifacting switched off.
You may have to go 'around the loop' a few times tweaking the levels and sampling phase

qbancoffee, 2021-06-17:
o.k. I'll experiment some more when I get home tonight.

IanSB, 2021-06-17:
@qbancoffee

Also put the setting back to DC coupled before making your DAC and phase adjustments. You are picking up a DC coupled signal so AC coupling can cause more problems than it solves. With a DC coupled signals the only use for the AC coupling is to remove any mains hum in the signal caused by hum in the power supply and that is unlikely to be the case with your bench PSU.

qbancoffee, 2021-06-18:
O.k. I've tried everything you've mentioned including using a second pi. I can get my games to look good or I can get the VDG green screen to look good but I can't have it both ways and I'm dizzy from trying all the combinations phase,DC/AC, HI LO's ect.
The board seems to be working but I can't help but wonder that there is a bad component. I've already swapped out
the A/D on the analog board and I've swapped out the CPLD. At this point I think I might just make another analog board just as a sanity check. If there is component that's bad which one would you say has the highest likelihood of not letting the board zero
in on a configuration.

The Maddening part is that it's so  close.

IanSB, 2021-06-18:
Other than some build issue with the analog board there is one other thing I can think of:

Are all the problem games artifact ones?

If so try disconnecting the artifacting circuit from the VDG which can be done by lifting one end of R9 (1K).
This circuit puts a low(ish) impedance load one of the VDG lines during the back porch to make the colour encoder generate a colour burst in hires mono mode but I have found VDGs don't like low impedance loads on the video outputs and it is not present on the CoCo 1.

Alternatively if the VDG is socketed bend out the 3 video pins so they are completely isolated from the rest of the circuitry as the luma channel has a capacitor on it which is not present on the CoCo 1 either.

qbancoffee, 2021-06-18:
Just got home and hopefully I can test all this out.
The problems do seem to be artifact related however I'm not sure. I was contemplating removing R9 already but wasn't sure that would help but now that you mentioned it it's the first thing I'm going to try. I hadn't thought about C59 because I could have sworn that was there on both! Thanks I'll try that as well.

qbancoffee, 2021-06-18:
I think lifting R9 and C59 did the trick at least with the pi beng powered externally.
Here is a video so you can see the results.
https://youtu.be/DYkkNiKiXAw
When I power the pi from the board I get mixed results that I can correct but for some reason the profile isn't always saved.
For example if I save as phase 10, the pi restarts phase 2 and the same happens with other phases. Is the program just loading
a multiple? I'll try adding caps or something to the pi to see if that helps.

IanSB, 2021-06-18:
@qbancoffee

Do you have to change both R9 & C59 or is it specifically one or the other mods that are required?

It looks like the saving problem is a bug which is saving the value modulo 8. I've not noticed that before as the values I use are less than 8 but I will fix it and post an update.

qbancoffee, 2021-06-18:
I experimented with one or the other attached but the best results are with both disconnected from the circuit.
I'll test the patch as soon as you have it up.

I'm currently testing some more and it seems that when pi is powered from the CoCo there is more noise.....

IanSB, 2021-06-18:
Ok here's the update with the saving fix:

[Phase_Save_fix.zip](https://github.com/hoglet67/RGBtoHDMI/files/6679640/Phase_Save_fix.zip)

Wipe the SD card and write the new files (make a note of any working DAC & phase values as you will lose them after the update and have to modify and resave them.

It might still be worth building another analog board using the 9144 chips I mentioned above.

qbancoffee, 2021-06-19:
The patch works. I can get excellent results when I power the pi with it's own power supply but varying results when powered from the coco. I'll post a video soon

qbancoffee, 2021-06-19:
It's pretty much flawless when using an external power supply. Here is a video of it in action
https://youtu.be/gLXZYFm6bKM

I removed R9 & C59 and powered the pi with an external PSU to get these results.
Do you need the final working configuration? is there a settings file I can copy for you?

IanSB, 2021-06-19:
@qbancoffee
>Do you need the final working configuration? is there a settings file I can copy for you?

Yes, it would be interesting to see how much difference there is. The file will be in /Saved_Profiles on the SD card

Are you using the original PSU for the CoCo now instead of your bench PSU?

qbancoffee, 2021-06-20:
I completely forgot to get that for you before I left on my trip.I'll send it over as soon as I get back.

qbancoffee, 2021-06-26:
I can't seem to get a completely clean picture using the original PSU, I have to use a separate on for the pi.
Here is the profile for my working setup.
[Tandy_CoCo_60Hz.txt](https://github.com/hoglet67/RGBtoHDMI/files/6720651/Tandy_CoCo_60Hz.txt)

I just got home and I do have a box of parts that arrived so sometime tomorrow I'll build a new analog
board with the alternate comparators.

qbancoffee, 2021-06-28:
I've built a second analog board using the max9144 instead of the max9108 comparators and it seems much more stable.
However, in order to get a clean picture  I had to lift C59 and R9 and use a separate PSU for the pi.
This is the case for both of my CoCo 2's 26-3026 NTSC.

Attached is the config file and a link to a video showing it in action.
This is an excellent project and again thank you for all of your work!
[Tandy_CoCo_60Hz.txt](https://github.com/hoglet67/RGBtoHDMI/files/6722988/Tandy_CoCo_60Hz.txt)
https://youtu.be/Ijkw9JX44r8

IanSB, 2021-06-28:
@qbancoffee
>I've built a second analog board using the max9144 instead of the max9108 comparators and it seems much more stable.

I had been considering changing to that chip in the BOM because I was already using the MAX9142 (half of a MAX9144) in the redesigned boards I'm getting assembled (the boards are functionally identical but use different chips due to availability issues) but as you have seen an improvement, I've made my mind up and now changed the BOM:
https://github.com/hoglet67/RGBtoHDMI/wiki/Bill-of-Materials-%28Analog-Board%29

My 26-3134 CoCo 2 was a 16K version without extended Basic so it has been difficult to test with actual software but today I upgraded it with an 8K extended basic, 64K of RAM and a CoCo SDC and I've been able to run Megabug and other software and I can report that there are still no issues with it so I am still at a loss to explain the problems you are seeing.

A few things I noticed:
The transistor connected to R9 is a different part number in the 26-3134 and the diode connected to that might be different as well.

It would be useful if we can find someone else to try this on a 26-3026

BTW I think I have already fixed the black & white bug you mentioned in your video as there was a known issue around that.
It will be available in the next beta release shortly

Here are a couple of screencaps (The Pi is powered from the CoCo):
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

qbancoffee, 2021-06-28:
Well, I'm glad I could help by testing the 9144's, those are really nice screen images.

I just looked in the service manuals for both the 26-3134 and the 26-3026 (at least the ones I have) and they both
have the same part number for the transistor and the diode. I wonder if we're maybe looking at different manuals??
I see 2N3904 for both transistors and 1KF20-4 for the diodes in the color artifacting circuitry on page 33 for the 26-3134
but Q2 isn't listed in the parts list, at least not specifically. One of those switching transistors might be Q2.

I don't have another CoCo2 but I'll ask on coco discord to see if anyone has a coco 2 like mine and is willing to test so that maybe I could mail one of the boards.

I think the noise might be related to the transformer/power regulation circuitry because I powered both the pi and the CoCo 2 from the pi's PSU and it's really clear.

I disconnected the transformer, removed the SC77527(SALT chip) soldered a wire from a 5V pin on the RGBtoHDMI board  and connected it to the 5V rail on the CoCo and the result is really good. I only had to change the coupling to AC from the configuration I was using.

Removing he SALT chip means that there is no RS232 or zero crossing circuit to load/save programs but that can be fixed.
I've already made a salt chip replacement that works so not a big deal if it came to that. I'll keep investigating though.

Great to hear that there's a fix for the black and white image.

IanSB, 2021-06-28:
>I wonder if we're maybe looking at different manuals

I'm looking at the circuit diagrams on the PDF manuals I linked above.
The 26-3134 shows 2SC945 or 2SC536K on the schematic
The 26-3026 shows 2N3904

However I think that the R9 and C59 mod makes a very marginal difference and the real problem is a noisy power supply.

I would normally suggest recapping but you new build board also has the problem and the 26-3134 has the same PSU circuitry anyway. Maybe your AC supply is really noisy. The 26-3134 has the AC transformer in a screened can

The only difference with my AC supply is that I'm running from 240V 50Hz via a 110v step down transformer.

I just remembered one issue I had:

I normally use 1600x1200 HP LCD monitors for my retro computers but for some of the smaller sized ones like the CoCo I used some 10" monitors I got from ebay:
https://www.ebay.co.uk/itm/164896147615

The first one was OK but another two I bought later induced terrible noise on the RGBtoHDMI's output which was caused by those two being supplied with different low quality "wall wart" 12v PSUs and they were inducing noise back into the computer or analog card. I fixed that by replacing the PSUs with better ones. I can see you are using a Dell monitor so that isn't likely to be the cause but maybe there are some other bad wall warts inducing noise in your AC supply.

qbancoffee, 2021-06-28:
Well, in an interesting turn of events, I am powering the pi from my Coco 2's power supply and it is perfectly clean. I'm not sure what I did to make this so clean. I'll have to keep investigating to see if I inadvertently made a change.

qbancoffee, 2021-06-28:
That's interesting that you noticed dirty power supplies in the monitors. I'll look out for that and check my AC Supply. One interesting note is that my cable and internet went out at the exact moment I got to clean display at the moment I have no internet and no cable so I can test that theory out even though it's a bit of a stretch.

qbancoffee, 2021-06-29:
I don't know why but it works powering the pi from both coco psu's
https://youtu.be/AFoeUqsYpfw

IanSB, 2021-06-29:
Perhaps the interference source got switched off.

I suppose the main advantage to running the pi on a separate PSU is that you don't have to wait for it to boot up when you cycle the coco's power.
BTW you can switch off the startup message in the preferences menu
Also in NTSC artifact mode, some programs suggest you power cycle the machine if the blue/orange are swapped as the order is random but you can correct that in the menus by adjusting the artifact phase setting in the palette menu instead.

IanSB, 2021-06-29:
I haven't finished the next beta yet but the alpha test version (AppleIIGS_Auto_Test_Alpha1.zip) posted at the end of this thread has the fix for the mono screen as well:
https://github.com/hoglet67/RGBtoHDMI/issues/209

qbancoffee, 2021-06-29:
Well, I think the real big difference at least on my end was the comparators and clipping c59 and r9.
I'll download the latest alpha and test it out.

o.k. thanks for the message disable tip. I think I want to hook it up to my CRT monitor and test it out.

> Perhaps the interference source got switched off.

Now I'm going to crazy looking for it!

qbancoffee, 2021-06-29:
I updated to the latest alpha and switched to AC coupled and all was fine until I restarted.
Instead of VDG green the background is black and white when running off of the cocos power supply but when I use a separate psu, the VDG green comes back occasionally after a restart.

https://youtu.be/LBKLxdv9zi0

qbancoffee, 2021-06-29:
In this video I can reproduce the problem I'm experiencing. I don't know if this is the same bug you patched or if it's even a bug at all but at least you can see it and maybe make some sense of it.

https://youtu.be/l_a9kyk9IvU

IanSB, 2021-06-29:
@qbancoffee

That was the bug I thought I'd fixed but my fix was incorrect. I think I have fixed it now but I can't test anymore as I managed to damage my coco 2 while testing and it's no longer booting :(
(I think I plugged or unplugged the cart with the power on but I'm now just getting a screenfull of garbage text)
Anyway here is the updated file to try:
[kernelrpi.zip](https://github.com/hoglet67/RGBtoHDMI/files/6734374/kernelrpi.zip)
Just unzip and overwite the kernel.img file on the previous alpha version.

qbancoffee, 2021-06-29:
It's absolutely perfect now. Do you need anything from me in terms of configuration and testing?
Thank you for all of your help!

IanSB, 2021-06-29:
@qbancoffee
>Do you need anything from me in terms of configuration and testing?

I don't think so at the moment.
One other thing that occurred to me about powering from the CoCo is that the power goes through a schottky diode on the analog board to protect from reverse power if you power up the Pi zero at the same time. There is a small voltage drop but if the power on the CoCo is already low that might result in the 5v supply to the Pi being too low.

>Hopefully it's a simple fix....... Do you have spare parts?

I have some RAM, 6847, 6821, EPROM adapters for the ROMs and the TTL. I can test the SAM and 6809 in my Dragon but I don't have any of the other ICs.

qbancoffee, 2021-06-29:
> One other thing that occurred to me about powering from the CoCo is that the power goes through a schottky diode on the analog board to protect from reverse power if you power up the Pi zero at the same time. There is a small voltage drop but if the power on the CoCo is already low that might result in the 5v supply to the Pi being too low

I actually thought about bridging the diode yesterday in order to power the coco via the 6 pin plug but ultimately decided against it.

> I have some RAM, 6847, 6821, EPROM adapters for the ROMs and the TTL. I can test the SAM and 6809 in my Dragon but I don't have any of the other ICs.

I can't say I'm an expert on the coco but I had a similar problem twice. One was a burnt SAM although I don't see how removing the cart while powered on would burn the sam...... The other was when I burnt a PIA. Luckily I found a still made new replacement for the 6821 and the 6822 it's the W65C21N6TPG-14.
https://www.mouser.com/datasheet/2/436/w65c21-661.pdf

And it's what I have in my new coco 2 board

Good luck on the repair hopefully it's something you have on hand and I'll reach out if I think of anything.

BTW I was thinking of including this design as part of a coco2 board I'm making or a maybe Ill make an RF can replacement board or something so that all one would need is to provide a pi.
I don't think it would sell much if at all, but If I do sell it I would like to give your project some of the money.

qbancoffee, 2021-06-29:
>the luma channel has a capacitor on it (C59) which is not present on the CoCo 1 either.

If you are doubting whether to recommend removing C59 for my version of the coco 2, I have some more evidence that C59 should be removed. I remembered this video by AC where his coco 2 has this capacitor removed to improve the image for a composite video mod he did.
https://youtu.be/tayGsz7Xs3A?t=3274

IanSB, 2021-06-30:
@qbancoffee
>Good luck on the repair hopefully it's something you have on hand and I'll reach out if I think of anything.

Back in business! The BASIC 1.2 ROM was dead. I noticed that it was completely cold when other chips were warm.
Fortunately I had bought a couple of 2764 EPROM adapter PCBs, one to use on the Extended Basic to get the CoCo SDC working and one spare although I was already thinking of using it to upgrade from BASIC 1.2 to 1.3 which I have now done.

>I don't think it would sell much if at all, but If I do sell it I would like to give your project some of the money.

Thanks, any contributions would be put towards purchasing more vintage computers so I can add support for them.

>I remembered this video by AC where his coco 2 has this capacitor removed to improve the image for a composite video mod he did.

Yes it's probably a good idea to remove it as it isn't there on the CoCo 1

I've decided to power my Pi externally now because you get instant video when power cycling the CoCo

qbancoffee, 2021-06-30:
should I close this issue?

The board works with an MC10 I recently purchased but I had to cut C33, 150pF cap, to get a clean picture.

qbancoffee, 2021-06-30:
> Back in business! The BASIC 1.2 ROM was
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

Thread 213 (2021-06-22):

Are the kits available for sale? Need to convert 3-bit RGB into HDMI

alex3331, 2021-06-22:
Are the kits available for sale? Need to convert 3-bit RGB into HDMI

IanSB, 2021-06-26:
They will be shortly.
I'll update when available.

alex3331, 2021-06-26:
Please do. I am interested

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
--
Alex Shakhnovich

jczmok-iag, 2021-07-03:
If that helps, i have some RGB2HDMI pcb's and and analogue pcb's and most parts for those. If there's interest...

alex3331, 2021-07-03:
Will you have assembled RGB2HDMI boards? How much will this cost?

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

--
Alex Shakhnovich

jczmok-iag, 2021-07-03:
Only parts. I ordered bare PCB and 99% parts from the sources. Approx (unassembled) it is around 25 EUR each with most parts (shottky diode missing)

alex3331, 2021-07-03:
I need just a PCB., on which xc9572 is mounted
I have parts.

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

--
Alex Shakhnovich

jczmok-iag, 2021-07-04:
i'd say 30 EUR but i need to have most parts mounted in order to test CLPD function. contact me off list jan (at) czmok (dot) de

hougaard, 2021-07-18:
Any updates on the availability of kits (or even better, complete units), I've paused several projects in anticipation of getting my hands on a few boards.

Thanks!

jczmok-iag, 2021-07-18:
Am 2021-07-18 06:53, schrieb Erik Hougaard:
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

Hi, i have about

12 unpopulated analog board here
8 rgb2hdmi boards (but waiting for cpld's)

i can provide fully assembled & tested rgb2hdmi boards
or a kit with all parts, but cpld soldered.

let me know what you need and i can provide you totals (and include your
location) regarding
shipping costs.

when those things are sold, they are sold. i am not reordering. just
needed to fill the minimum
shipment requirements.

--jan

hougaard, 2021-07-18:
That sounds amazing!!

I'm in North Vancouver, British Columbia, Canada.

I really need two fully assembled boards. One for doing CGA (out of an IBM Color Graphics Adapter) and one for "others". If I understand rgb2hdmi correctly, the CGA can be done without the analog board?

So two boards, one with analog?

Cheers

hougaard, 2021-07-18:
Let's move this out of Hoglet's issue thread, email me on erik at hougaard dot com - thx!

Closed 2021-08-04.

Thread 221 (2021-07-11):

Apple LISA Image Centering

ElectricApple, 2021-07-11:
Absolutely brilliant project, great work.
I'm having difficulty getting the image centered from an Apple LISA using the latest software release and 12-bit board - see grey bar on right in photo.
It's a strange resolution of 720 with 176 blanking pixels x 364 with 15 blanking lines @ 20MHz
I've tried tweaking all the geometry and sampling settings.
When I increase the H offset too far the stable image becomes unstable and repeats across the screen.
Is there something else I can try?

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

IanSB, 2021-07-11:
Can you post a screenshot of the source summary page in the info menu and also use the save log function in the info menu and post log.txt from the SD card

ElectricApple, 2021-07-11:
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

[Log.txt](https://github.com/hoglet67/RGBtoHDMI/files/6797468/Log.txt)

IanSB, 2021-07-11:
It looks like the geometry settings are triggering a bug in the integer scaler, I'll have a look at that.
In the meantime a couple of things to try:
1. set the FB Size to Normal and see if that helps with adjusting the h offset (Dont forget to save the config before trying No.2 as that will cause a reboot losing your changes)
2. Change the scaling from integer to interpolated (keep FB size at Normal)

ElectricApple, 2021-07-11:
Thanks Ian.

I've adjusted those settings and whilst looking better, I'm still unable to centre the image in the screen

IanSB, 2021-07-11:
Can you post your lisa.txt profile file

ElectricApple, 2021-07-11:
[LISA.txt](https://github.com/hoglet67/RGBtoHDMI/files/6797696/LISA.txt)

IanSB, 2021-07-11:
After reviewing the logs, it looks like the problem is the Hsync pulses which are 15uS long instead of the typical 5 uS (in the Lisa, video lines are about 44uS long).

I think the leading edge of the sync pulse is probably in the right place but the trailing edge which is used by the software to determine the start of the line actually occurs after the start of video so the left hand edge is getting cut off.

The latest beta already supports switching from trailing to leading edge sync pulse triggering so can you download beta36 from my fork:
https://github.com/IanSB/RGBtoHDMI/releases
Wipe the SD card. put the new files on and add your LISA.txt profile.

After rebooting, go to the sampling menu and change the sync edge from trailing to leading.
Then try adjusting the hoffset again.
Also

Note this will require a CPLD update to v94 and if you revert to the old software you should manually downgrade back to the old CPLD version.

ElectricApple, 2021-07-12:
I've updated to the Beta release, and it's decreased the size of the grey bar and moved it over to the LHS, but unfortunately I still can't quite line up the image before it becomes unstable. I've attached screenshots of the output and the log file.

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
[LISA.txt](https://github.com/hoglet67/RGBtoHDMI/files/6798880/LISA.txt)
[Log.txt](https://github.com/hoglet67/RGBtoHDMI/files/6798881/Log.txt)

ElectricApple, 2021-07-12:
This may or may not be useful, but here's a capture of the video signals from PulseView

[LISA Timing.sr.zip](https://github.com/hoglet67/RGBtoHDMI/files/6798950/LISA.Timing.sr.zip)

IanSB, 2021-07-12:
>This may or may not be useful, but here's a capture of the video signals from PulseView

Yes, that confirms my suspicions: The hsync pulse is actually wider than the blanking period.

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

In this case the leading edge starts before the end of the video line and the trailing edge ends after the start of the video line so there is no suitable edge to trigger capture of the video line itself, you will either get one end or the other end of the video cut off depending on which edge you trigger from.

Normally the hsync pulse sits entirely within the blanking period so you can trigger off either edge.

I notice that the Lisa monitor schematic refers to this signal as horizontal drive so it is not a standard hsync pulse:
https://www.applefritter.com/content/schematic-video-board-lisa-050-4012-h

Looking at the lisa schematic:
https://www.applefritter.com/content/schematic-cpu-lisa-5-5-050-4009-h
This shows !VSYNC, !HSYNC and !CSYNC going to J1 so it might be worth checking out the !CSYNC signal to see if it has different sized horizontal sync pulses that fit within the blanking period in which case that signal could be used instead. (You might have to experiment with changing the sync setting in the geometry menu although CSYNC could still be used as a form of HSYNC combined with the existing VSYNC. (Also worth checking the !HSYNC to see if it is the same signal you are picking up because it is inverted and your signal is non-inverted)

The other alternative would be to delay the hsync pulse by a few uS so that the leading edge fell within the blanking period. It might be possible to fit such a delay within the CPLD but it is rather full already.

ElectricApple, 2021-07-12:
Thanks again for looking into this Ian

I am able to centre up the image when using !CSYNC as the reference, my issue being that only H Drive, VSync and Video are presented to the video board connector which is located in the 'front' of the Lisa, with the remaining boards in the 'back'.

I am currently taking these signals off the video board due to it's more convenient location for solder-free testing, meaning i've had to thread a wire through the back of the chassis to get a sniff of !CSYNC off a chip, which isn't ideal.

Would it be possible to have an attempt at delaying HSYNC, as this would lead to a neater solution by only neededing to clip onto various points of the video board, unfortunately there's nowhere convenient to obtain !CSYNC from.

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

[LISA_CPU_CARD.sr.zip](https://github.com/hoglet67/RGBtoHDMI/files/6802896/LISA_CPU_CARD.sr.zip)

IanSB, 2021-07-13:
@ElectricApple
>Would it be possible to have an attempt at delaying HSYNC

After some effort, I've managed to fit a limited delay option into the CPLD which should work with the Lisa:
[LisaSupportAlpha1.zip](https://github.com/hoglet67/RGBtoHDMI/files/6811794/LisaSupportAlpha1.zip)

As before, wipe your SD card and copy the files, adding your lisa profile
During first bootup, the CPLD will be erased so you can then program the v94_Lisa1 CPLD

After wiring up the separate H & V signals and selecting your Lisa profile, change the following settings in the sampling menu:
Clock Multiplier: x4
Sync Edge: Leading + Delay
Sample Mode 3 Bits Per Pixel

(The delay only works in 3bpp mode as there was a spare combination of bits in that mode to select it - The video will still be 1pp as that is controlled by the 2 level mono palette)

Then change these Geometry Settings:
H Pixel Aspect: 2
V Pixel Aspect: 3
FB Size: Double Height
Sync Type +H+V

And finally adjust the H Offset to centre the image.

The added delay is 255 sample clock cycles where the sample clock is the pixel clock times the multiplier setting
So with a pixel clock of 20.373351Mhz x4 that gives approx 3.12uS of delay

After setting up, you can try the x6 multiplier which gives 2.086uS of delay which is very marginal but might still work.
(Based on your PulseView timings, the minimum delay required is around 2.05uS)
Any multiplier above x6 will not give enough delay.

The above aspect settings will ensure correct integer scaling on a 1600x1200 or 1920x1200 monitor but a 1080p will still look a bit letterboxed as there aren't enough vertical pixels for 3x integer scaling so interpolated will look better.
You could get integer scaling working on a 1080p monitor by reducing the vertical capture by 4 lines (360x3 = 1080)

If you get a good result, please post your profile and I'll add it to the next release

ElectricApple, 2021-07-13:
Ian
Thanks for your sterling efforts, they are much appreciated especially as the tube in my Lisa is starting to wear out considerably.

I can confirm that your additional delay has allowed the Pi to sync correctly to the Video board signals and allow the image to be centered! It works at both x4 and x6 multipliers as suggested.

I've included two profiles, one for integer and one for interpolated.
I personally prefer the interpolated so will probably stick with that.

Thanks again!

[Apple_Lisa.zip](https://github.com/hoglet67/RGBtoHDMI/files/6812101/Apple_Lisa.zip)

IanSB, 2021-07-13:
@ElectricApple

Thanks for the profiles.

Can you do a few screencaps for the gallery using the built in screencap function (short press of SW2, files on SD card)

ElectricApple, 2021-07-14:
No problem. Here's a few to choose from
[Apple_Lisa Captures.zip](https://github.com/hoglet67/RGBtoHDMI/files/6813626/Apple_Lisa.Captures.zip)

IanSB, 2021-07-25:
@ElectricApple

All those changes are now available in beta 37 release:
https://github.com/IanSB/RGBtoHDMI/releases

This contains a single "Apple Lisa  TTL" profile that should automatically select the height as appropriate so that integer scaling works reasonably well on a 1080p monitor.

i.e.
with integer scaling on 1080p you will get 360 lines captured (2 missing from top & 2 from bottom)
with interpolated scaling on 1080p you get the full 364 lines
with integer scaling on 1600x1200 or 1900x1200 monitors you will also get the full 364 lines

Can you check that works OK for you.

BTW I saw this video on Youtube about the Lisa2 / Mac XL which shows a composite video output on  the back:
https://youtu.be/7TOh_W6EUOc?t=200
It should be possible to use that output directly with the analog addon board with identical quality to the internal TTL pickup so I am going to add a speculative profile to support that as well although it will likely need some tweaking.

Is there such a connector on your Lisa?

ElectricApple, 2021-07-26:
Ian

Thanks for tweaking the modes to auto adjust the height etc.
Appears to work perfectly on the Lisa

My machine does indeed have a video out socket.
No idea how I forgot about that, it would make a lot more sense!
I haven't made up any analog boards, but I have a couple of other machines I'd like to test out so when i get around to making one i'll try the analog Lisa profile and report back.

Closed 2021-07-14.

Thread 226 (2021-07-26):

Flash Floppy OSD on 12bit board

Croccy22, 2021-07-26:
I can't find a definate answer to this. Does the flash floppy OSD input on pin 18 work on the 12bit board? Or does it only work on the copperdragon board for the Amiga?

I've looked at the 12bit board and it appears pin 18 actually links to the CPLD so is probably used for something else?

Can someone confirm?

Thanks, Matt.

IanSB, 2021-07-30:
Pin 18 does work with FFOSD on the 12 bit board but only in 12 bits per pixel mode. This is because the pin is sampled in software during video capture and it can only sample at the pixel rate in 12bpp mode. In 1,3 or 6 bpp mode the CPLD buffers the pixels and transfers them at a lower data rate so the software would only be able to look at the FFOSD input every 8, 4 or 2 pixels respectively.
Pin 18 is also used to program the CPLD which is why the FFOSD signal must be connected via a 1K resistor so it can be overridden during programming.

Croccy22, 2021-07-30:
Thanks for the reply. I assume this means it won't work with the Sam Coupe profile with that being 7bit?

G4DDS, 2021-08-15:
I have one of Croccy22's board for my SAM Coupe and have been in (private) contact with Croccy22 to discuss the use of the OSD pin.

Currently, it is linked up to pin 18 using a 1K Ohm resistor and I managed to to get the OSD overlay working using an Amiga profile (just to test that the OSD was working). The next step was to switch to the supplied SAM Coupe profile and make some adjustments to enable the OSD:

Sampling Menu - Sample Mode changed from 9 Bits to 12 Bits Per Pixel.
Geometry Menu - FB Bits/Pixel changed from 8 to 16.

This resulted in a horizontally squashed screen so I played around with the width setting and changing this appeared to fix the aspect ratio:

Geometry Menu - Max H Width changed from 608 to 728

However, not knowing enough about how it all works I don't know whether this is correct or it was just a fluke and there is something else I could (or should) have changed. Any thoughts?

The real problem I have though is that the palette seems to be off with a pinkish tinge since swapping to 16 FB Bits/Pixel. Is there an alternative palette profile that can be used to fix this?

On my setup I created a SAM_Coupe directory containing two profiles called Sam_Coupe_FF_OSD and Sam_Coupe_No_FF_OSD to allow me to easily swap between the two profiles for maximum flexibility especially as there is no easy way to enable and disable the OSD display. It seemed odd to me that there is no option in the settings menu for this?

IanSB, 2021-08-15:
@G4DDS

The main problem at the moment is that it is very difficult to provide a general purpose capture loop that works with all options at all bit depths as that causes performance issues so in many cases separate capture loops are provided for separate options and combinations of options but this means that the number of capture loops required can increase exponentially as the number of options increases so only capture loops required for supported profiles are implemented and so some options like FFOSD only work at certain bit depths.

One longer term solution would be to create additional capture loops to support those options at other bit depths but working around it like you are trying by using the 12bit into 16 bit frame buffer is another viable solution.

The reason for the pink tinge is that the intensity bit is only connected to the R1 input but that adjusts all RGB levels on the SAM Couple palette. When you use the 16 bit frame buffer there is no palette and the RGB values are used directly so the intensity bit is only affecting the R1 input, hence the extra red added to all high intensity colours. To get more correct colours you have to connect the Intensity bit also to the B1 and G1 inputs so it affects all 3 simultaneously. You can achieve this by connecting R1 to B1 (adjacent pin 2 on P2) and G1 (Pin2 on the P5 connector holes at the other end of the board next to R0,G0,B0)

Note the direct colours in 12bpp mode will be dimmer than the SAM Palette:
In the palette:    bit 3 = 0x92, bit 2 = 0x49, bit 1 = 0x24 (So all bits on = intensity 0xff or 255)
In 16bpp direct: bit 3 = 0x88, bit 2 = 0x44, bit 1 = 0x22 (So all bits on = intensity 0xee or 238)

If you connected the intensity bit to R0,G0,B0 as well then the maximum level would be boosted back to 255:
In 16bpp direct: bit 3 = 0x88, bit 2 = 0x44, bit 1 = 0x33 (So all bits on = intensity 0xff or 255)
Closer but not an exact match for the SAM palette.

>no easy way to enable and disable the OSD display. It seemed odd to me that there is no option in the settings menu for this?

Beta 40 in my fork has FFOSD on/off in the menus
https://github.com/IanSB/RGBtoHDMI/releases

It also has an option for two sets of sampling/geometry settings which can be toggled by pressing SW3 so you could toggle between the standard profile and the the above tweaked on if the different palette was objectionable.

Not sure about the aspect ratio change, I'll have to look into that.

G4DDS, 2021-08-15:
That's given me something to think about. To try and get the SAM palette correct (and see whether it is really that much dimmer that it is noticeable) I do have Xilinx ISE Design Suite 14.7 installed (for messing around with FPGA boards) which I believe can be used with the VHDL projects to rebuild the CPLD files. Looking at the VHDL sections that reference B1_I and G1_I  we have:

shift_G <= R2_I & G3_I & G0_I & B1_I;             -- 12 bpp

shift_B <= R3_I & R0_I & G1_I & B2_I;             -- 12 bpp

Would replacing the occurrences of B1_I and G1_I with R1_I be the equivalent of doing the hardware mod you described to link R1, G1 and B1 together?

I also notice that B1_I is also used to generate signals B2 and B3:

    B3 <= B2_I when B1_I = '1' else B3_I;
    B2 <= B3_I when B1_I = '1' else B2_I;

But here I think I can leave these alone as B2 and B3 appear to be used to in the 6 bpp profiles only.

I have just seen your edit about the aspect ratio problem - it's too late to digest but looks like I have worked around it anyway.

IanSB, 2021-08-16:
@G4DDS
>Would replacing the occurrences of B1_I and G1_I with R1_I be the equivalent of doing the hardware mod you described to link R1, G1 and B1 together?

Yes, in fact you should replace R0_I , B0_I and G0_I with R1_I as well in all three shift_R/G/B lines to get the best result with intensity more closely matching the  original as suggested above.

>I also notice that B1_I is also used to generate signals B2 and B3:

That is only used in analog mode as part of a 3 line to 2 bit encoder and not used in normal digital capture

Here is a slightly tweaked version of the code which fixes the width issue and also does some internal bit manipulation on R1 and B1 as I think the standard SAM profile might not work properly once B1 gets tied to R1 with the old software.
Download Beta40 from here
https://github.com/IanSB/RGBtoHDMI/releases
Then overwrite the kernel with the file in this zip:
[kernelrpi.zip](https://github.com/hoglet67/RGBtoHDMI/files/6989737/kernelrpi.zip)

If you are using the above software then download the latest RGB VHDL (V9.4) from the dev branch

After that you just need to change sample mode to 12bpp and FB bit depth to 16bpp and tie R1 to B1,G1,R0,G0,B0 either physically or by changing the CPLD.
If that all works I'll include those updates in the next stable release due soon.

I looked at adding FFOSD to 8bpp frame buffers and the bit detection is simple enough but it also requires the palette to be dynamically reprogrammed when FFOSD is detected and restored when the signal is dropped and that is a little more complex due to some timing issues adding that code in the relevant place, so if the above works it is the best option for now.

G4DDS, 2021-08-16:
I don't think the FF OSD setting is working as intended - with it off the OSD is not displayed but the screen still dims when it detects the OSD on pin 18.

I made the changes to the 12 bpp sections of the VHDL (took me a while to work out how to generate a xsvf file):

shift_R <= R1_I & G2_I & B3_I & R1_I;             -- 12 bpp
shift_G <= R2_I & G3_I & R1_I & R1_I;             -- 12 bpp
shift_B <= R3_I & R1_I & R1_I & B2_I;             -- 12 bpp

And this took the pink tinge off and the palette looked OK to me.

One thing though I had an error during the fitting stage saying it had run out of space so I removed the 1, 3 and 6 bpp settings (as it was just an experiment anyway) just to get it to generate. I will leave it upto you to work out how to fix that but thinking about it would you not need a specific 12 bpp setup for the SAM Coupe profile anyway (i.e. a specific CPLD firmware just for the SAM)?

IanSB, 2021-08-17:
@G4DDS
>I don't think the FF OSD setting is working as intended

Yes that was a bug which I have now fixed

>One thing though I had an error during the fitting stage saying it had run out of space

The CPLD is very full with not much room for even minor tweaks

Anyway I have now managed to figure out a simple way to update the palette for FFOSD to work with 8bpp frame buffers so here is an updated kernel which should work with the original SAM profile and standard CPLD, no hardware changes required:
[kernelrpi.zip](https://github.com/hoglet67/RGBtoHDMI/files/7001074/kernelrpi.zip)

Overwrite the existing kernel with this version, reprogram the CPLD back to the default 9.4, restore the profile back to default, switch FFOSD on in the settings menu and see if it works.

G4DDS, 2021-08-18:
@IanSB

I started again with Beta40 and the latest kernel from the previous post, programmed v9.4 in and I am happy to say it all looks as though it is working with the standard SAM profile (9 bpp sampling and 8 FB Bits/Pixel). I can confirm that the FF OSD setting has also been fixed.

On a un-related point but still to do with the SAM profile (so if an update is needed it could potentially be included in the next release), when using the SCART output the border on the left and right is a lot wider than when it is output on the HDMI. I have attached a couple of screenshots. Is there a simple tweak needed to the profile that can give us a wider border?

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

IanSB, 2021-08-18:
@G4DDS
>Is there a simple tweak needed to the profile that can give us a wider border

Try this version:
[kernelrpi.zip](https://github.com/hoglet67/RGBtoHDMI/files/7010028/kernelrpi.zip)

With a 1920x1080 monitor, more than the 4:3 section (which would be 1440x1080) can be used to zoom in slightly if the top and bottom borders are unused for normal video which is the case with most computers that have 192 or 200 pixels vertically.
The extended width was limited to 1600x1080 but I have now increased it to 1800x1080 and that should result in an increased border but it is untested. (This is all due to the SAM having a non-square pixel aspect ratio which scales by odd numbers compared to most computers so fitting it with integer scaling is difficult)

BTW  This uses integer scaling for a very sharp image but check that your TV is configured for 1:1 pixel mapping otherwise the sharpness will be lost as many TVs will zoom into the image by 5% or so by default. The name of the option varies depending on TV manufacturer and should be in with the aspect ratio controls but may be something like "just scan", "exact scan" "PC mode" etc although some TVs don't have the option at all and you are stuck with a permanent zoom.

G4DDS, 2021-08-18:
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

That looks better what do you think @Croccy22 - maybe you could check this out on your setup and see what you think? By the way I had to change the Horizontal offset to 120 so the image was more central so a little update to the profile in the distribution may be needed.

IanSB, 2021-08-19:
@G4DDS
>I had to change the Horizontal offset to 120 so the image was more central

I increased the width slightly more to 1824x1080 which fixes a rounding error that resulted in uneven black borders in the above.
Please try this version:
[kernelrpi.zip](https://github.com/hoglet67/RGBtoHDMI/files/7011535/kernelrpi.zip)
It should be centred correctly although you may need to further adjust the h offset (in geometry) and pixel h offset (in sampling) to get the image exactly centred to pixel accuracy.

G4DDS, 2021-08-19:
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

I left the horizontal offset at 120 and offset at 6 - I think it looks OK. Also attached the profile file I am using in case you want to put that in the next release (it has the FF OSD setting in I see as well).

[Sam_Coupe_update.txt](https://github.com/hoglet67/RGBtoHDMI/files/7016587/Sam_Coupe_update.txt)

G4DDS, 2021-09-01:
@IanSB

Just wondering when you think the next stable release is likely to be?

IanSB, 2021-09-01:
@G4DDS

Beta41 in my fork is a release candidate for the next stable version so if all goes well it should be soon
https://github.com/IanSB/RGBtoHDMI/releases

Please give it a check with your system and report back.

G4DDS, 2021-09-02:
@IanSB

I tried beta 41 and it all looks OK to me.

One thing though and I may add I saw this on the original stable release software is that very occasionally I get some distortion/corruption of the bottom part of the screen that covers the final bottom few pixels of the actual screen and I assume the border as well (but since it's all one colour won't be noticed). It only does it very occasionally and only appears on screen (the captured images are fine) and switching the SAM off and on is normally enough to fix it. Do you have any ideas what might be the problem?

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

Croccy22, 2021-09-02:
Have you tried on a different TV/Monitor? I've never seen this issue on my TV and have obviously tested a lot of interfaces :)

G4DDS, 2021-09-02:
I have only seen it on my smaller HD ready, not on my 43" LG but I have noticed that there is also some interference pattern at the bottom right:

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

I don't know why I didn't try this before but I have just discovered that power cycling the RGBtoHDMI interface (and leaving the SAM powered up on the above screen) also appears to solve the problem.

IanSB, 2021-09-02:
@G4DDS

Those lines look like they are only one HDMI pixel high and the software doesn't generate pixels that small. The frame buffer stores the source pixels at much lower resolution (either the resolution of the source computer or double the resolution depending on the FBsize option) and they are scaled up by the GPU.

A likely explanation is that the signals on the HDMI interface are marginal resuting in some sync issues especially if you are using a mini HDMI adapter rather than a lead with the correct connectors and resetting the Pi forces the HDMI interface to reinitialise so try another HDMI lead and/or adapter or even another Pi zero.

You can also try increasing the HDMI signal strength by adding a line to the config.txt file under "Common video settings":

config_hdmi_boost=7

Valid values are 0-11 and it defaults to 5. Do not use very high values unless absolutely necessary.

Thread 230 (2021-08-06):

Barebones digital RGBHV input

jbshelton, 2021-08-06:
I've been tinkering with the source code to this project in order to get it to work with very simple digital RGB signals meant for an LCD (specifically signals from the Gameboy, Gameboy Color, Gameboy Advance, etc.), without the use of a CPLD.
At first I had trouble properly configuring the vertical resolution because the firmware wouldn't allow anything below 250 lines per frame, but I modified geometry.c in order to accommodate for it. The OSD behaves kind of funky, but I can live with that.

One problem I need to solve is vsync: I need to have hsync, vsync, and psync on separate pins. All I could glean from the source code is that either vsync and hsync are XORed together in the CPLD for mixed/composite sync, or they are multiplexed onto the psync pin (though with wording for separate hsync and vsync, it's kind of confusing.) Ideally, there would already be an option for a separate vsync pin, but I couldn't find one; I wouldn't mind having to use an external XOR gate, but would like to know if I'm missing something in the source so I can just change the firmware.

I also am not completely sure how to configure the input signal resolution, based on exact measurements- I'm testing with the GBA at the moment, and I know the physical frame size is 308x228, and the visible size is 240x160, and the pixel clock frequency is 4194304Hz. I'm not sure if it's because currently don't have a way to feed vsync into the Pi, but the source detection does not want to abide by the parameters I put in.

Basically, I'm trying to add support for devices where the exact pixel clock frequency and resolution is known, and the output is in digital RGB with separate horizontal and vertical sync signals.

IanSB, 2021-08-08:
When we were first experimenting with adding support for additional computers beyond the BBC micro, some support for separate H and V sync was added by XORing the two signals inside the CPLD and then feeding composite sync to the Pi. This worked OK as far as the sync signals themselves were concerned but it caused a problem because in order to support automatic detection and selection of sub-profiles for the various IBM PC modes, the polarity of the H & V sync pulses had to be determined and that info was lost when they were XORed together.

To work around this, the VSYNC input was fed to the PSYNC pin on the Pi when the VERSION output from the Pi was taken low (not enough spare pins for a direct connection). This means that the PSYNC signal is unavailable during VSYNC detection but it isn't required at that time so not a problem.

The references to mixed sync have been left in primarily to support old CPLD builds. Note the BBC CPLD doesn't support VSYNC at all so it gets detected as a mixed sync CPLD but never works with separate syncs.

If you have put the software into simple (non-CPLD) mode by tying a 3K3 resistor from the VERSION line (Pin 12 / GPIO 18) of the Pi zero header to ground (like the Amiga boards) then that only supports standard negative going composite sync so your best bet for now would be to xor the H and V signals and feed the resulting composite sync into the csync input (making sure it's the right polarity). You could always make custom changes later for separate vsync on another GPIO if you get it working.

Closed 2022-12-20.

Thread 236 (2021-09-03):

Colour issue with Amstrad CPC464

Imperious685, 2021-09-03:
I've just built one of these RGBtoHDMI with a version 4 12 bit board and version 3 Analog board. So far I have only tested with an Amstrad CPC464 but have some Colour issues. First of all I have checked thoroughly that all components are correct values and soldering is good with no bridges or dry joints. The CPC is good as it is all ok with my OSSC. I've tried every adjustment and nothing seems to fix this. Maybe a faulty chip or even one of the pcbs. I have yet to do a full circuit test with multimeter.  I have attached photos. Someone at CPCwiki said it looks like CGA except RGB are all there just wrong in places. Any help much appreciated.

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

hoglet67, 2021-09-03:
Can you confirm the above photos are with a fresh installation of the latest stable software (20210529_777ea4f)

Do you think you could post screen captures saved by RGBtoHDMI instead of photos?

Some more infomation would be helpful:
- A log file (the option to save one is in the INFO menu)
- A photo or screen capture of your Info/Source Summary Menu
- A photo or screen capture of your Info/System Summary Menu
- A photo or screen capture of your Palette Menu
- A photo or screen capture of your Samping Menu

hoglet67, 2021-09-03:
The Amstrard has three levels for each of R, G and B: 0%, 50% and 100%, giving 27 total colours.

On your photos it looks like the 50% and 100% values for each of the colors are being merged together, the end result being the images only contain 8 colours.

One thing that would cause this is if there was a problem with the programmable 75R termination circuit on the analog board. The Amstrad CPC profile enables termination, and this is needed to get the required voltage levels to match the profiles. If the termination was always off, then that might cause a problem like this.

Schematic is here:
https://raw.githack.com/hoglet67/RGBtoHDMI/master/kicad_analog_6bit/V3/analog.pdf

I'd be checking U3, C9 and R5 as they are common to all channels.

Imperious685, 2021-09-03:
Thanks Hoglet67. I'll do all that checking on the Analog board tomorrow and report back. If I can't find a problem there I'll post some screengrabs as well. The 75R termination does work as I've already tried it off and on and it looks terrible off.
I have used the latest software (20210529_777ea4f)

hoglet67, 2021-09-03:
Thanks. Please make sure when take the screen shots that all the settings have their default values. Ideally start by wiping the SD card and re-installing the software.

Imperious685, 2021-09-05:
I've had a good look at my Analog board and did find a short between pins 1 and 2 on U4, once removed made no difference at all. One more likely thing I should mention is that due to lack of availability I used a CD4066BM instead of a 74LVC4066. I'm going to say this could be the problem as the LVC part is designed for lower operating and input voltages. The CD4066BM is at the lower limit of operating at 3.3v. The only other thing Is I have not installed U7 but nothing I can find tells me that I have to add that with a 12bit board?

hoglet67, 2021-09-05:
> One more likely thing I should mention is that due to lack of availability I used a CD4066BM instead of a 74LVC4066.
Yes, this would have been good to meantion earlier ;-)

The CD4066BM on resistance is typically 470 ohms (at 5V), higher still at 3.3V.

The 74LVC4066 on resistance is is typically 6.5 ohms (at 3.3V)

The 75R termination is not going to work well with a CD4066BM, which is what's screwing up the levels.

That's almost certainly the issue here.

Dave

hoglet67, 2021-09-05:
What country are you in?

hoglet67, 2021-09-05:
DigiKey have these in stock:
https://www.digikey.com/en/products/detail/nexperia-usa-inc/74LVC4066D-118/2763168

Imperious685, 2021-09-05:
Thanks Hoglet. I'm in Australia so might just order from Aliexpress and hope for the best. My Bad with that part, I was paying more attention to the pinout when ordering. The LVC parts not available until 2022 from RS components here. I can get 74HC4066 but expect that won't cut it either. There are some other Aussie based suppliers so will check them out.
Well I guess if anyone else makes this mistake the answers here.

hoglet67, 2021-09-05:
DigiKey Australia show them in stock as well.

hoglet67, 2021-09-05:
Are you only using this with the CPC?

If so, you could just short out the termination switches:
- Short U3 pins 3 and 4
- Short U3 pins 8 and 9
- Short U3 pins 10 and 11

That will permenantly enable termination.

Imperious685, 2021-09-05:
Thanks I'll do that.  Digikey Aus and Mouser Aus all parts come from USA.

IanSB, 2021-09-09:
@Imperious685

The resistance of the analog switches is added to the 75R resistor when termination is enabled so you were terminating in several hundred ohms instead of about 81R with the correct chip. The analog RGB output output of the CPC relies on the termination resistor as part of it's output circuit and if that is very wrong or missing then all the RGB voltages will be wrong.

>Atari 2600 with RGB mod

There isn't a profile for the Atari 2600 with RGB mod so you will have to create one.
Also I think the 2600 has 128 colours and the analog board can only distinguish 27 colours or 64 colours with the U7 fitted.
It may be possible to get a usable output by setting up your profile but some colours will be a shade wrong.

> ZX spectrum +2A and possibly my RGB modded C64

Both of these also requires termination so should be OK with hoglet's workaround above (assuming the c64 is using c0pperdragon's mod).

Imperious685, 2021-09-10:
Thanks IanSB.
I've ordered the correct 74LVC4066 ic's from Aliexpress, until them shorted pins will suffice.
It's quite ironic one of the oldest consoles has 128 Colours. Think I'll just try see how I go with the OSSC, otherwise I have a GBS8200 that I can use with the Control mod. It ends up being a case of Horses for Courses, some adaptors are better for certain applications. My C64 does have the Copperdragon mod.

Closed 2021-09-10.

Thread 244 (2021-11-02):

Analog Board on C64

lolof70, 2021-11-02:
Hello,

I soldered an analog board for my C64 (with FPGA video mod).
It does not work well, missing colours or something like that.
I built the board following the BOM made by Kicad.
Trying to get the board working, I saw a bom on the wiki right now...
There are not both the same (both boms)....
On my board :
- R1 is 100 Ohm,
- U6 is TS5A3159ADBVR
- U1 and U2 are MAX9108ESD+
All those are coming from Kikad BOM.

Can it be that I have a problem with the analog board because one or more of those are not correct ?

Here pictures from the RB2HDMI in action.

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

lolof70, 2021-11-03:
Just put R1 with 470 Ohm. It does not help.... :-(

lolof70, 2021-11-03:
Oh yea.....

Problem solved. When I built my fpga video board for the C64, I replaced 2 resistor with lower value one  to reduce the colours saturation....
I put the original value back and all is working. Perfect !

I also tested with the bridges on U3 removed. Still work perfectly.

Thank you for this very nice adaptor.

IanSB, 2021-11-04:
@lolof70
Sorry, I only just noticed your post, glad you got it sorted out already.

As you discovered, the RGB values have to be at predictable levels which are set either by reprogramming the colour tables (with older c0pperdragon firmware) or by putting the fpga board into the special RGBtoHDMI mode (with newer c0pperdragon firmware).

The analog board level slices the RGB values to extract the bit-exact digital data from the C64 and by changing the resistors you messed up the digital extraction.

>I built the board following the BOM made by Kicad.
Trying to get the board working, I saw a bom on the wiki right now...
There are not both the same (both boms)....

The wiki is correct, the values got changed (to improve performance or because components were not readily available) without requiring a PCB update so the kicad files didn't get updated

lolof70, 2021-11-04:
Thank you very much for the reply.
I must say, it's working very good with the bom from Kicad and R1 with 470 Ohm.
It's just perfect, at least with the C64..
Thanks for all.

Thread 252 (2021-11-17):

CPLD successfully programmed: no menu after booting

bzeiss, 2021-11-17:
Hi, I have soldered my own board, so likely this is not a real issue with the project, but more a user mistake. As there is no discussion forum, I figured this would be the right place to ask for help before I spend more time trying to figure this out by myself.

So I have soldered the issue 4 12-bit board. I have checked for shorts on the cpld, no issues so far. When plugged the hat into a Pi Zero (no W, the cheap one), I see the rainbow screen and I can successfully program the CPLD. After programming and booting, the rainbow screen appears, but the menu does not appear, but the green led's go out on both the hat and the Pi Zero (with nothing plugged in). If I boot holding button 1 or two, I do get a screen with the resolution, no sync detected etc, but the screen hangs and I cannot do anything. Pressing all three buttons, I can reprogram the CPLD.

Do you have any ideas what I may have done wrong? Thanks so much for any pointers!

IanSB, 2021-11-19:
If you can get to the menu after holding buttons, select the "save log and EDID" function in the info menu and post the log.txt file from the SD card.
Alternatively:
Do you have a USB TTL level serial adapter?
If so , you can connect it to the serial debug port on pins marked GND and TxD (Rx input of USB adapter to TxD)
Run a serial terminal program set to 115200 baud 8 data bit no parity
This will show what's going on

bzeiss, 2021-11-19:
Hi Ian,

thank you very much for taking the time. Those pointers were very helpful. In the meatime, I have soldered a second board that works perfectly. So I had something to reference it against. The serial interface was helpful for that. The USB serial interface reported the following which stuck out when I diffed the logs between the good and the bad board:

CPLD  Design: Legacy_3_BIT
CPLD Version: 0.0

This is what is reported after I have programmed the CPLD. So I started transplanting a new and fresh CPLD to the bad board and programmed it. It started to work. Then I made a third board and transplanted the CPLD from the bad board to it. Same problem. So I guess the CPLD is defective. The odd thing is that the programming seems to work well and after a very brief "verifying" / "verification" or so success is reported. So I assumed that the programming went well.

Closed 2024-11-09.

Thread 253 (2021-11-19):

Pi4 remaining issues

IanSB, 2021-11-19:
I though I'd document the remaining issues with Pi 4 support to help in tracking down the required info:

1. Genlocking doesn't work.
This is due to the HDMI PLL registers moving or changing
Also the interrupt controller has changed so the Vsync flag can't be read (used for genlock and displaying the red sync bar)

2. Screecaps don't work
lodepng genrates error 55

3. 16bpp display modes don't work properly because the mailbox will only select 5:6:5 RGB and the display list gets modified to switch this to 4:4:4:4 ARGB. The display list and associated registers have moved or changed so that trick no longer works.
This could be worked around by reverting to the original 5:6:5 capture code. The reason for the change was to speed up the capture loops as almost no logical masking and shifting was required for 4:4:4:4 ARGB compared to 5:6:5 RGB.
However due to the new GPU capture code the loss of speed by reverting may not be an issue especially if it is only done for the Pi 4

4. The PLLs need further experimentation.
I've managed to get it working using PLLD but all the PLLs seem to be in use so this needs to be looked at further as it currently runs the PLL higher than it's default rather than lower (running lower causes the Pi to lose display or lockup.)

5. Mode7 is glitchy
Mode 7 is glitchy even with GPU capture. However this can be fixed by reducing the capture width by a few pixels (it's already wider than the active screen so nothing is lost).
This is very likely due to higher memory latency than on the other Pi versions.

IanSB, 2021-11-24:
Update:

Issue 1: The interrupt register for the SMI interrupt (fake vsync) is now in IRQ0_PENDING1 on the Pi4 at offset 0x00B204. After changing that the vsync red bar now works (genlocking still not working)

Issue 5: Mode7 is now OK it was using the cached screen option but the memory area wasn't actually set as cached which caused the glitches.

IanSB, 2021-11-24:
Issue2: Screencaps are now working after changing the compiler options to target arm v6 (like the universal Pi0-3 build) instead of arm v8 so the compiler output for Arm v8 has some issues, perhaps something isn't set up correctly like unaligned access.

IanSB, 2021-11-25:
Update:

16bpp display modes now work properly:

The display list has moved from offset 0x402000 to 0x404000
Also the structure of the list has changed so that the start of video entry is at offset 6 instead of offset 5
Finally the values representing the bit order in the first word of the list have changed:
#define PIXEL_ORDER 2   // ABGR in BCM2711
#define PIXEL_ORDER 3   // ABGR for all others

hoglet67, 2021-11-25:
Nice work Ian....

Have you found some secret source of information, or are you just figuring this out by trying lots of different things?

IanSB, 2021-11-26:
>Have you found some secret source of information

Just the Linux source. I looked through for references to bcm2711 or vc5 or just an additional '5' in all the vc4 related files.
I found a header with the display list referenced as SCALER and SCALER5
https://elixir.bootlin.com/linux/latest/source/drivers/gpu/drm/vc4/vc4_regs.h#L491
#define SCALER_DLIST_START                   0x00002000
#define SCALER5_DLIST_START			0x00004000

So I tried that offset. It didn't work but I dumped the display list to the serial port and it was immediately obvious that the screen start address had moved by one word compared to a Pi zero so I changed the code for that and got a working image but with the colours reversed so I then changed the PIXEL_ORDER value in our defs.h and got the correct image.

The only remaining issue is the HDMI clock (or clocks as there are two outputs)
The existing HDMI PLL has been removed but I can't find any reference to any other new PLLs
In this file:
https://elixir.free-electrons.com/linux/v5.7.19/source/drivers/clk/bcm/clk-bcm2835.c#L1835
PLLH is listed as SOC_BCM2835 but the other four PLLs above it are listed as SOC_ALL which means both BCM2835 and BCM2711 and there are no other new PLLs listed so I think the HDMI clocks may be derived from the existing PLLs in some way.

BTW I think it would be useful to compile a wiki page with all the bare metal resources like the above source files, datasheets, the SMI tutorial, the display list tutorial, raspberry pi forum posts etc which we could add to as we find them.

IanSB, 2021-11-26:
Some relevant info:

https://github.com/tianyoujian/MZDPI/blob/master/common/bcm2711-rpi-4-b.sh
https://github.com/torvalds/linux/blob/master/drivers/gpu/drm/vc4/vc4_hdmi_regs.h
https://github.com/torvalds/linux/blob/master/drivers/gpu/drm/vc4/vc4_hdmi.h
https://github.com/torvalds/linux/blob/master/drivers/gpu/drm/vc4/vc4_hdmi_phy.c

IanSB, 2021-11-28:
Screencaps are still randomly hanging or throwing error 55 on the Pi4 when calling lodepng and it seems to be build or memory content sensitive as adding logging or making any unrelated change can alter the behaviour.

I've disabled unaligned access in the compiler but it hasn't helped with this issue although I will leave it disabled because there can be different behaviour between Arm v6, v7 or v8 which might affect a universal binary.
Armv6 has the old model of unaligned access
Armv7 has the new model of unaligned access but can be switched to Arm v6 compatibility (which is done in _enable_unaligned_access)
Armv8 only has the new model

I'm building the Pi4 version with the compiler targeted at Armv8 with cortex A72 optimisation so it should be building with the correct instructions. I also tried updating lodepng to the latest version.

IanSB, 2021-11-29:
Possible location of registers affecting pixel clock at base_address + 0xf00f00 (base of hdmi0 phy according to the above links)
```
Dump of registers for 1920x1080 @60Hz: with pixel clock of 148.5Mhz
00000000 = 00000030
00000004 = 00000010
00000008 = 0909090C
0000000C = 00094A58
00000010 = 00050003
00000014 = 000865C8
00000018 = 80000000
0000001C = 0001E060
00000020 = 008A7800
00000024 = 00000000
00000028 = 00000300
0000002C = 00000000
00000030 = 00000000
00000034 = 00000001
00000038 = 3E0FFC1F
0000003C = 01F07C00
00000040 = 00007C1F
00000044 = 00000000
00000048 = 001A5A0F
0000004C = 00003210
00000050 = 30000000
00000054 = 00000000
00000058 = 00000003
0000005C = 0E14E147
00000060 = 00A50000
00000064 = 0000D0FF
00000068 = 0800C800
0000006C = 00000003
00000070 = 00000000
00000074 = 00000000
00000078 = 00000000
0000007C = 00000000

Dump of registers for 1600x1200 @ 50Hz with pixel clock of 135Mhz:
00000000 = 00000030
00000004 = 00000010
00000008 = 0909090C
0000000C = 00094A58
00000010 = 00050003
00000014 = 000865C8
00000018 = 80000000
0000001C = 0001E060
00000020 = 008A7800
00000024 = 00000000
00000028 = 00000300
0000002C = 00000000
00000030 = 00000000
00000034 = 00000001
00000038 = 3E0FFC1F
0000003C = 01F07C00
00000040 = 00007C1F
00000044 = 00000000
00000048 = 001A5A0F
0000004C = 00003210
00000050 = 30000000
00000054 = 00000000
00000058 = 00000003
0000005C = 0E14E147
00000060 = 00960000
00000064 = 0000D0FF
00000068 = 0800C800
0000006C = 00000003
00000070 = 00000000
00000074 = 00000000
00000078 = 00000000
0000007C = 00000000

Only difference is register 0x60 which is 0x00960000 for 135Mhz and 0x00A50000 for 148.5Mhz

148.5 *  0x00960000 /  0x00A50000 =  135 so this appears to be directly correlated with the pixel clock.

```

IanSB, 2021-12-02:
I now have Pi4 genlocking working on 1080p50 by altering the value in 0xfef00f98 (HDMI_RM_OFFSET) but I still need to work out how the value in that register relates back to the pixel clock value (at the moment the code assumes 148.5Mhz).

IanSB, 2021-12-02:
Pi 4 genlocking is now fully working

Remaining issues:

lodepng crashing

I also noticed a problem during startup where the sd card doesn't work properly after a power cycle. It does work after the second power cycle but the error does delay bootup by a few seconds.

```
...
PLLD: 3000.000092 ANA1 = 00118000
PLLD: PDIV=1 NDIV=55 CTRL=00021037 FRAC=582544 DSI0=256 CORE=4 PER=5 DSI1=256
CPU speed detected as: 1000 Mhz
EMMC: BCM2708 controller power-cycled
SD: error sending SEND_SCR
WARN: Failed to initialize file system
SD: error sending CMD17, error = 01048576.  Retrying...
SD: error sending CMD17, error = 01048576.  Retrying...
SD: error sending CMD17, error = 01048576.  Giving up.
Re-creating /cpld_firmware/Delete_This_File_To_Erase_CPLD.txt
EMMC: BCM2708 controller power-cycled
Keycount = 0
CPLD  Design: 3-12_BIT_BBC
CPLD Version: 7.9
```

I tried adding extra delays around the power cycle but that didn't seem to help.

IanSB, 2021-12-03:
The reason why lodepng is crashing is that malloc() is returning garbage addresses:
```
Pi0-3:
malloc 0282E358
malloc 0282E350
malloc 0282E340
malloc 0282E338
malloc 0282E2E8
malloc 0282E2A0
Which are sensible addresses in the heap at the end of the code

Pi4:
malloc 6584BAD0
malloc 6584BA80
malloc 6584BA38
malloc 6584B9E8
malloc 6584B9A0
malloc 6584B950
```

Might be a bug in the compiler or a buffer overrun which is corrupting the memory allocation tables that only happens on the Pi 4?

hoglet67, 2021-12-03:
That's very interesting...

Honestly I have no idea about how malloc is meant to work in a bare-metal environment, what region of memory it is using, and how that is controlled.

This issue likely also affects PiTubeDirect

I'll do some digging tomorrow (if I'm not feeling too grotty after being boosted today).

If you find the answer in the mean time, do update this thread.

hoglet67, 2021-12-03:
Just confirming here what I think you already knew (but I didn't).

It  seems the default implementation of malloc in GCC looks for a symbol called _end that usually follows the bss region and starts the heap there.

If I build on the Pi 4, then do a nm I see
```
arm-none-eabi-nm  rgb-to-hdmi | sort | tail
027c4008 B xsvf_data
027c4010 B display_list
027c4014 B capinfo
027c4018 B clkinfo
027c4030 B RPI_GpioBase
027c4034 B errno
027c4038 B __bss_end__
027c4038 B _bss_end__
027c4038 B _end
027c4038 B __end__
```
So it looks like the heap should start at that point.

On the Pi 0-3 build the address is similar: 027d0038

So the Pi 0-3 addresses you see look like they are within the heap, where as the Pi 4 addresses look wrong.

I'm not sure how best to track this down.

GCC includes heap consistency checking tools, but I don't expect these are available in an ARM Embedded environment:
https://www.gnu.org/software/libc/manual/html_node/Heap-Consistency-Checking.html

The most likely cause of this is something unrelated to lodepng overflowing an array (or similar) and corrupting the memory allocators view of the heap.

Dominic's been using a static analysis tool called cppcheck to improve the code in PiTubeDirect. It might well spot possible causes. I've never used this myself, so I can't really advise you on how to run it.

hoglet67, 2021-12-03:
Something like this might help:
https://mcuoneclipse.com/2021/05/31/finding-memory-bugs-with-google-address-sanitizer-asan-on-microcontrollers/

IanSB, 2021-12-04:
I found out where it is happening but it's not fixed it yet:
I created test_png() to compress a png without saving it and inserted that at various points in the code to see what happened.
After some experimentation I found the critical part where the corruption was occurring which appears to be the first time the SD card is accessed and it looks like it only happens  after the SD error I mentioned a few posts above occurs. This error never happens on the other Pi versions which expains why they never crash.
Sometimes the SD error doesn't happen on a Pi4 and in that case screencaps work normally.

The first time the SD card is accessed is in cpld_init() when the "/Delete_This_File_To_Erase_CPLD.txt" is checked

```
I modified the code from:

   int check_delete_file = check_file(FORCE_BLANK_FILE, FORCE_BLANK_FILE_MESSAGE);
   int force_update_file = test_file(FORCE_UPDATE_FILE);

To:

   log_info("1: Trying first png encode");
   test_png();
   log_info("2: Trying check_file()");
   int check_delete_file = check_file(FORCE_BLANK_FILE, FORCE_BLANK_FILE_MESSAGE);
   log_info("3: Trying test_file()");
   int force_update_file = test_file(FORCE_UPDATE_FILE);
   log_info("4: Trying second png encode");
   test_png();
   log_info("5: Finished test");
```
When it works you get:

```
1: Trying first png encode
Scaling is 1 x 1 x=512 y=256 sx=512 sy=256 px=512 py=256
Encoding png 01EFFFA0, 01EDFD80
2: Trying check_file()
EMMC: BCM2708 controller power-cycled
3: Trying test_file()
4: Trying second png encode
Scaling is 1 x 1 x=512 y=256 sx=512 sy=256 px=512 py=256
Encoding png 01EFFFA0, 01EDFD80
5: Finished test
```

When it doesn't you get:
```
1: Trying first png encode
Scaling is 1 x 1 x=512 y=256 sx=512 sy=256 px=512 py=256
Encoding png 01EFFF98, 01EDFD80
2: Trying check_file()
EMMC: BCM2708 controller power-cycled
SD: error sending SEND_SCR
WARN: Failed to initialize file system
SD: error sending CMD17, error = 01048576.  Retrying...
SD: error sending CMD17, error = 01048576.  Retrying...
SD: error sending CMD17, error = 01048576.  Giving up.
Re-creating /cpld_firmware/Delete_This_File_To_Erase_CPLD.txt
EMMC: BCM2708 controller power-cycled
3: Trying test_file()
4: Trying second png encode
Data Abort at 0215C390 on core 0
Registers:
  r[00]=FE000000
  r[01]=026D2668
(the error varies and sometimes just hangs)
```
If you move the second png encode to between the check_file() and test_file() calls it works so it looks like the error on the check_file() call leaves things in an indeterminate state and the subsequent call to test_file() actually trashes the allocator info.

BTW I've sent a pull request with the latest version that will build on v10.3-2021.10 of the compiler.
(above logging changes not included)

IanSB, 2021-12-04:
@hoglet67
>I'll do some digging tomorrow (if I'm not feeling too grotty after being boosted today).

If you want to look at this, note that EMMC_DEBUG is disabled by default even in the debug build as it made startup times very long (see line 52 of src/fatfs/sd_card.c)

hoglet67, 2021-12-04:
I've enabled EMMC_DEBUG and there does seem to be an intermittent failured during the SD Card initialization sequence.

A good startup looks issues the following command
```
SD: issuing command CMD0
SD: issuing command CMD8
SD: issuing command CMD5 (timeout expected)
SD: issuing command ACMD41
SD: issuing command ACMD41
SD: issuing command ACMD41
SD: issuing command CMD2
SD: issuing command CMD3
SD: issuing command CMD7
SD: issuing command ACMD51
SD: issuing command ACMD6
SD: issuing command CMD13
SD: issuing command CMD17
...
```
A bad startup looks like:
```
SD: issuing command CMD0
SD: issuing command CMD8
SD: issuing command CMD5 (timeout expected)
SD: issuing command ACMD41
SD: issuing command ACMD41
SD: issuing command ACMD41
SD: issuing command CMD2
SD: issuing command CMD3
SD: issuing command CMD7
SD: issuing command ACMD51 (timeout)
```
At this point the EMMC driver just gives up and bails.

The logging around the failed command is:
```
SD: issuing command ACMD51
SD: error occured whilst waiting for data ready interrupt
SD: error issuing command: interrupts 00000000: TIMEOUT
SD: error 00000000 sending SEND_SCR
```
This is the first command in the initialization sequence which uses data transfer, to transfer a 8-byte block (which includes the SD Card version and data bus width).

I've tried a number of things:
- increasing the timeout
- adding a delay before sending the command
- multiple retry attempts
- additional _data_memory_barrier() calls

None of those things worked...

I suspect this is a bug in the EMMC emulation in the Pi 4 which ends up with some data transfer state machine being stuck somewhere.

I did spot the malloc bug, which is in sd_card_init():

The emmc_block_dev structure can either be malloced, or passed in
```
    // Prepare the device structure
   struct emmc_block_dev *ret;
   if(*dev == NULL)
      ret = (struct emmc_block_dev *)malloc(sizeof(struct emmc_block_dev));
   else
      ret = (struct emmc_block_dev *)*dev;
```
In the case of errors in cd_card_init it's always freed:
```
   sd_issue_command(ret, SEND_SCR, 0, 500000);
   ret->block_size = 512;
   if(FAIL(ret))
      {
         printf("SD: error %08lx sending SEND_SCR\r\n", ret->last_error);
         myfree(ret->scr);
         myfree(ret);
         return -1;
      }
```
So you end up freeing memory which was statically allocated, which is a big no-no and is likely

A fix for this in commit: cab728b6

The only workaround I could think of for the SD Card issue was to retry the whole initialization sequence.

That's in a seperate commit: d879a81a

What's interesting is the bug only seems to happen once!

```
EMMC: BCM2708 controller power-cycled
SD: error sending SEND_SCR
******************************************
* Reinitializing SD Card Driver          *
******************************************
EMMC: BCM2708 controller power-cycled
Keycount = 0
...
```

There are a couple of improvements that could be made from here:
1. Fix some memory leaks - not everything that is malloced in sdcard.c is freed
2. Be a bit more systematic about the initialization retry fix, i.e. apply it to all points where the initialization bails, and try it a maximum of say ten times.

IanSB, 2021-12-04:
Thanks for that, it looks like Pi4 support is now complete!

IanSB, 2021-12-12:
@hoglet67

One strange thing I noticed with the Pi4:
Although the GPIO benchmark indicates reading the GPIO registers is much faster on the Pi 4 (~15ns) it doesn't result in a usable performance increase compared to the zero2W / Pi3 and still requires reading the GPIOs from the GPU. (i.e. the ARM build still doesn't work with 12bpp samples)
This seems to indicate that ARM is reading a latched copy of the GPIO state which is only updated at a similar rate to the zero2W.

IanSB, 2022-12-20:
Pi 4 now supports the enhanced CGA artifact emulation

Closed 2022-12-20.

Thread 254 (2021-11-20):

Investigate audio support

IanSB, 2021-11-20:
Now that the zero 2W is available it seems a lot more viable to add audio support and that might even work on the original Pi depending on how it is implemented.

The first thing to try is generating an audio tone using sine wave data to confirm that we can at least produce audio.

If that works the next thing is to investigate getting audio into the Pi.

There are several possible solutions:

1. There is a peripheral built into the Pi which can receive PCM audio data but the GPIO pins are already in use so this would be a radical re-design

2. Use something like a Pi pico (which has on board A to D converters - but are they audio capable?) to capture and reformat the data to be passed into the Pi.
Actually getting the data in is going to be the biggest problem as there aren't really any spare GPIOs.
There is GPIO24 (formerly mux) which is currently used for FFOSD and also the GPIO driving the mode 7 LED could be sacrificed.
There are also a couple of GPIOs on the camera interface which could be used as general GPIOs but connecting to them would require a flexi cable.
The data requirement for 2 channel PCM audio is 48000 samples/sec x 16 bits x 2 channels which is 1536000bits/sec which could be bit banged on a single GPIO and sampled with the video so not impossible.

3. Use a usb audio dongle like this:
https://www.amazon.co.uk/Sabrent-External-Adapter-Windows-AU-MMSA/dp/B00IRVQ0F8
This is a very attractive option as it can just plug into the USB connector but would require a lot more software support to get working.
There is a bare metal USB stack for the Pi here:
https://github.com/rsta2/uspi
whic was derived from an early version of circle, a bare metal environment:
https://github.com/rsta2/circle
which could be implemented to run on one of the Pi zero2W's cores but it is just the stack and doesn't have an audio driver so that would require further investigation.

Sch-LikA, 2021-11-21:
I guess the i2s pins are already in use ? Something like this [Hat](https://github.com/skiselev/i2s_audio_phat) could be a good option too.

MarkieV, 2021-12-11:
To synchronize audio/video you need to use some sort of buffer, as video takes more processing time then audio, big change you need to buffer the video and this produces delays...
My scart RGB to HDMI converter (which has audio) clearly! has more delay then the PI RGBtoHDMI solution.

c0pperdragon, 2022-01-03:
I would of course very much prefer the USB approach, as it would allow me to keep my existing hardware. Switching to a Pi Zero 2 is no problem, but keeping my existing Pi Zero would be nicer.

emanuelelaface, 2024-04-05:
I return on this topic because it seems that someone experimented with bare metal and audio on HDMI on this project:

https://github.com/kumaashi/RaspberryPI/tree/master/RPIZEROW/Sample_HDMI_DMA_Audio_03

IanSB, 2024-04-06:
@emanuelelaface

Thanks for that link, that looks really interesting and I will definitely be following this up.

IanSB, 2024-05-01:
@emanuelelaface

Well that worked! I now have HDMI audio output and can play WAVs but that's only half the solution, I still need to work out how to get the audio in to the Pi in the first place.

emanuelelaface, 2024-05-02:
oh wow, that is amazing. For the input part there was the USB driver (https://github.com/rsta2/uspi) that probably solves the issue of having a GPIO available.
Anyway, thanks a lot for your work on this, it would be great to have audio directly on HDMI.

emanuelelaface, 2024-05-02:
@IanSB I noticed that in a list of Circle comments there is a tentative of USB audio with also the code for bridging two devices in streaming.
It is the example in this thread at the end: https://github.com/rsta2/circle/issues/222

And the implementation is the one attached here.
[soundbridge.zip](https://github.com/hoglet67/RGBtoHDMI/files/15186513/soundbridge.zip)

I do not know how helpful can be.

IanSB, 2024-05-03:
@emanuelelaface
Well that thread indicates that the support only works on the Pi4 and getting it working on the zero etc would be difficult so I don't think USB audio is going to be viable for now and I will investigate some of the alternatives.

Anyway I have uploaded an Alpha test version with a HDMI audio test menu if you want to give it a try:
https://github.com/IanSB/RGBtoHDMI/issues/29

It works with the TVs/monitors I have tested so far but others have reported problems with some TVs so let me know if it works for you.

emanuelelaface, 2024-05-03:
Oh, that is amazing, I tested and I have the audio demo! I saw that the USB input is for Pi4, it is a pity because probably to use USB is readily available with the current RGB2HDMI board, while to use GPIOs will require a new design, but I understand that if there are GPIOs available probably can be much easier.
Anyway, thanks a lot for the work!

Thread 255 (2021-11-22):

Teletext clock fixer

IanSB, 2021-11-22:
The problem with asymmetric teletext clocks does seem to be quite frequent and although this can be fixed by changing capacitors experimentally it would be nice to have a small clock board that generates a perfect 6mhz clock which would guarantee a fix when fitted.

Also such a board could be fixed from the top without having to remove the motherboard

There are a couple of approaches to this:
Use a 96 Mhz clock and some dividers to create a 16 Mhz clock and a phase locked 6Mhz clock.
(Might be possible to use a 48 Mhz clock but the 16 Mhz clock will be asymmetrical).

Direct generation of a 6 Mhz clock using a phase locked loop solution if a suitable chip exists.

IanSB, 2021-11-22:
Idea: Use a Pi pico to synthesize the 16 Mhz and phase locked 6 Mhz clocks
It's ridiculous overkill but financially it makes some sense as the pico costs about the same as just the parts for an oscillator/divider and there is no custom pcb or assembly required.

Closed 2022-12-20.

Thread 258 (2021-12-04):

Thoughts on a different way to connect a C64

c0pperdragon, 2021-12-04:
@IanSB

While my C64 component video mod is actually working nicely with the RGBtoHDMI, the new Kawari project that implements a complete VIC-II replacement got me thinking.
I envison a slimmed-down version of the Kawari that would directly fit into the VIC-II socket and just works as a normal VIC-II generating the luma/chroma signals without any additional interfacing options and relying on the original C64 circuitry to get the video signal out through the A/V port.
While this seems disappointing at first (still nothing better than s-video), it would allow for a very interesting possibility:

Support an output mode where the luma signal changes at double the pixel clock and sets the output to 1 of 4 different luma levels (chroma is completely silent to not introduce disturbances). Combining two values gives 16 different color possibilities. This can then be fed into an external RGBtoHDMI which does it usual magic to again get pixel-perfect HDMI.

The one question on the RGBtoHDMI side of things is how to receive 4 different luma levels. I am not totally sure I understand the analog board  schematics, but it seems that there are three comparators on the green input that could do this. To also the the sync tip, I would probably have to connect the ASYNC input to the green input line in the cable.
If my assumptions are correct, the RGBtoHDMI could be easily made to accept the proposed signal, but I guess it would require some progamming on your side.
I also could rather easily modify my component video mod to generate this signal to test this approach.

If this works out, I would propose the whole scheme to the developer of the Kawari board.

IanSB, 2021-12-05:
@c0pperdragon

This should be possible.
As you noticed, there are 3 comparators on the green input already so no need to fit U7 on the other side of the board.
One of the comparators can be configured either to do sync separation or increase the number of levels of green/luma that can be discriminated to four, however as once in this mode it can't do sync separation.

The workaround as you suggest is to connect both the green input and the sync input to the source and then you will have four level discrimination with sync separation as well. One potential problem with this is that you might get reflections on the cable with such an arrangement so you would have to keep it short. Alternatively the green/Y cable could be looped back into the 6 way IDC in place of the sync cable.

If you prototype this in your existing adapter you could see what it looks like using the attached profile:
[C64_Kawari_50Hz.txt](https://github.com/hoglet67/RGBtoHDMI/files/7654971/C64_Kawari_50Hz.txt)
This should have everything setup correctly for double rate 4 level capture but I haven't been able to test it.
You will need to set the DAC levels correctly for Sync, Ylo, Ymid, Yhi (note Yhi>Ymid>Ylo) and once you have the levels set and run the calibration you can check for noise (calibration should show 0 errors if the signal is clean)

If you screencap the result you should be able to view it zoomed in on a PC to manually decode the pixel pairs to see if it is working.
The palette is the Y test palette which has the following colours:
0=Black
1=Green
2=Yellow
3=White

It would require a new capture mode similar to the Atari one to decode this profile.

c0pperdragon, 2021-12-05:
Thank you for this profile.
I have set up everything as you specified, and it is working flawlessly. The simple color sequence produces just the expected half-pixel colors:
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

There was no need to change my RGBtoHDMI hardware setup, as I had already hard-wired the analog board to a TRRS jack with the Y input going to both the G and SYNC lines. So this a very nice proof of concept.
Of course my signal source is now extremely clean. I can not really guess what would happen with a regular Kawari install that feeds the luma through the original C64 amplifier.

With me having a bit too much time in lockdown here in Vienna (yes, one lockdown yet again) I really consider designing a VIC-II replacement myself. As I specified above, I want to use a form factor identical to the VIC. This is a _really_ hard squeeze and I am not sure if I will be able to actually build this, using BGA packages and all...
Just in case, it would be better to not use the name "Kawari" for this C64 profile in the future (given that you want to eventually include it in the official release). Something more generic like "C64 Semi-digital or C64 single-wire" could work.

IanSB, 2021-12-05:
@c0pperdragon
Yes that looks clean, but as you say it really depends on what it looks like when it's passed through the original C64 luma video path as that is double the bandwidth it's expecting.

I called the profile C64_LumaCode_50Hz for now.

IanSB, 2021-12-05:
@c0pperdragon
If you have an unmodified C64 you could route the signal from your board (on another C64) through it's video path to see if you get a noise free result.

IanSB, 2021-12-23:
@c0pperdragon
Do you intend to pursue this any further?

>If this works out, I would propose the whole scheme to the developer of the Kawari board.

Have you suggested this to the Kawari developer?

c0pperdragon, 2021-12-23:
not yet. but feel free to contact him yourself.

c0pperdragon, 2021-12-24:
I have given the whole topic more consideration. What I now intend to build is a downsized variant of my C64 component video mod. This should combine all necessary parts into a board that goes under an existing VIC-II (which is still necessary to drive the system, just like before). But it would then generate the discussed luma-only signal exclusively. The original signal paths of the VIC-II (digital as well as analog) would be completely unaffected by this and work as before. The newly generated luma signal would be brought out of the C64 through the re-purposed RF output jack. This could even be possible without soldering, by just cutting the RF output wire and attaching the new signal with a clip.

By the way: I did not find an official way to do feature-requests on the Kawari, also there is no e-mail address of the developer easily available.

c0pperdragon, 2021-12-24:
Of course all these plans are purely theoretical by now, and I don't expect the necessary semiconductor parts to become available soon...

c0pperdragon, 2022-01-06:
I have worked a bit on this topic and I could design a board of the same form factor as the pickup-board for my original component video mod. It will support the luma-coded signal exclusively and I dropped even the video amplifier. As it turns out, the FPGA can quite comfortably drive the video line directly using only a few resistors. I also built a simple cable to bring the signal from the RCA jack to the 6-pin analog board.
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

Lacking actual hardware, I modified one of my component video boards which can now only output this specific signal, so it is of not much other use currently.
@IanSB , maybe you could look into implementing the necessary sampling code in some time?  I would be very grateful.
The encoding I use is specified in this table:
[lumacode.ods](https://github.com/hoglet67/RGBtoHDMI/files/7824415/lumacode.ods)
I specified an encoding for all the colors in a way to make the average luma of both half-pixels to roughly match the brightnes of the corresponding C64 color. So you can directly plug this signal into a TV and get a kind of grayscale image.
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

Using the current RGBtoHDMI firmware with your provided profile gives a super-stable image showing the half-pixels.
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

IanSB, 2022-01-07:
@c0pperdragon

Try this:
[LumaCode-Alpha1.zip](https://github.com/hoglet67/RGBtoHDMI/files/7825594/LumaCode-Alpha1.zip)

Install the latest stable release then overwrite kernel.img with the one in the zip and add the C64_LumaCode folder to
/profiles/6-12_BIT_YUV_Analog

Use the YUV CPLD and select the C64_LumaCode profile. You will probably need to adjust the voltage levels and also the Pixel H Offset in the sampling menu (to get the lo/hi bit order correct).

This is mostly untested as I don't have a way of producing the required signals.

c0pperdragon, 2022-01-07:
Wow!  That was fast!
It worked immediately after calibrating just the voltage levels without touching the Pixel H Offset:
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

For my purposes I then increased the minimum vertical size to get more overscan for use in demos. Specifically the "Edge of Disgrace" demo - which could be considered the gold standard - is perfectly aligned now.
[C64LC_50Hz.txt](https://github.com/hoglet67/RGBtoHDMI/files/7828564/C64LC_50Hz.txt)

Many thank for the quick implementation.

IanSB, 2022-01-07:
@c0pperdragon
>C64LC_50Hz.txt

Are you sure you posted the right file as that one is the same as the original.

c0pperdragon, 2022-01-07:
Silly me. The saved profiles of course go to the folder "Saved_Profiles".
So now, this should be the correct one:
[C64LC_50Hz.txt](https://github.com/hoglet67/RGBtoHDMI/files/7829857/C64LC_50Hz.txt)

c0pperdragon, 2022-01-09:
@IanSB

Hi Ian! As I currently can only do theoretical work on the matter, I came up with yet another possible thing concering the C64.
I guess it would be also a nice option to allow an internal installation of the Pi, similar to what we did on the Amiga. As this would cause more current draw on the PSU and also some extra way to route the HDMI cable out of the case, I consider this as the advanced option. But not as advanced as de-soldering the RF modulator as for my original component mod. As this would not require any specific hardware on the Pi side of things, it would also be cheaper, I guess.

For this to work, my FPGA board (which goes under the VIC) provides a pin header for a 6-wire ribbon cable that carries:
pixel clock, csync, lum0, lum1, GND and connection to a 3.3K resistor.
I imagined that it would be possible to connect this cable  to pins 11 - 16 of the Pi where most of the relevant inputs are already located in one spot. Power to the Pi should come through the USB power plug.
I am not sure about pin 13 (genlock?) and pin 15 (analog?) which I did not use on the Amiga adapter. Maybe they can indeed be used as pixel data input when configured correctly? If yes, there would surely be some coding necessary on your part.

One other open question here is how this ribbon cable should best be attached to the Pi. Normal plugs can not be put on a longer header because they mechanically interfer with the pins on the side. One option is of course cutting way these pins on the Pi (would also prevent later miss-alignments of the plug), but I would not recommend such a destructive treatment.
Maybe you have some better idea here?

c0pperdragon, 2022-03-29:
I have released a new firmware (2.11) for the C64 Component Video Mod. This now exclusively creates the LumaCode output when switched to its RGBtoHDMI mode:
https://github.com/c0pperdragon/C64-Video-Enhancement/releases/tag/2.11

Your recent RGBtoHDMO beta release already contains the decoding logic for the LumaCode and it works fine after again adjusting the voltrage levels. Instead of my previous confiiguration file which was adjusted to my experimental hardware, this now has different levels on my original hardware. I will try to also use these levels for future developments, so minimal adjustments should later be necessary.
[C64LC_50Hz.txt](https://github.com/hoglet67/RGBtoHDMI/files/8374635/C64LC_50Hz.txt)

It would be great if you could include this in future stable relases.

c0pperdragon, 2022-05-21:
I can not currenty proceed with my intended C64 luma-code solution, so there is no hurry to integrate the luma-code profile to the stable official release. But I guess, I will be able to come up with a cheap  - and more importantly - easy install that repurposes the RF-out jack of the C64 to produce this signal at least at some time in the future.

To not confuse the matter unnecessarily, I have withdrawn my 2.11 firmware, for the C64 Component Video Mod, so the latest 2.10 will just generate the well-established high-contrast YPbPr signal to be fed into the RGBtoHDMI.

IanSB, 2022-12-13:
@c0pperdragon
Yes I have made up cables the same way and it is better than using separate wires for the same signal

Will you be looking at the C64 luma-code again sometime?

c0pperdragon, 2022-12-13:
Yes, I am designing a new board for the C64 to generate the luma-code signal from the digital VIC pins. It will be just as big as the pick-up board of my original component video mod. The FPGA will directly fit on this. Maybe I can just run a single wire from the FPGA to the RF output jack, but probably I need to also have a shielding ground on this as well.
Installation will be solderless by inserting the board between VIC and its socket and attaching the output wire to the RF jack using a clip. The only destructive thing would be to cut the original wire to the RF output.

Unluckily FPGAs are still not available. I decided to go with one specific FPGA that is small enough but still has enough pins and logic cells to do the job. When I first looked, this had a delivery date from mouser for April. But when I was finally sure that this would be the right part, everything from this batch was already preordered and now I placed my order for a July batch.

This whole contraption will deliver luma-code only besides the original analog signals. So the RGBtoHDMI + analog board (or something with equal capability) will be mandatory to use it.

Closed 2025-08-07.

Thread 262 (2021-12-12):

Commodore 128 80 column 60Hz

buzbard, 2021-12-12:
Hi,
I'm using my new RGBtoHDMI with a flat Commodore 128 in 80 column mode.
I've selected the "Commodore 128-80" Profile, "60Hz" for the Refresh and for the Sub-Profile I've selected "Cmd 128 60Hz" because the default 50Hz causes the screen to flash.
I've saved the profile. But when I reboot the RGBtoHDMI or power cycle, it always reverts back to 50Hz.

In the root of the SD card is a file named "profile_6-12_BIT_RGB.txt", I assume it's my selected profile configuration. It contains the following 2 lines:

profile=Commodore_128-80
saved_profile=0

The only way I've discovered to get around this issue is to go into the "\Profiles\6-12_BIT_RGB\Commodore_128-80" folder on the SD card and rename or delete the "Cmd_128_50Hz.txt" file.

If there's a better way, I'd like to know.
Thanks.

IanSB, 2021-12-12:
Flashing indicates that it can't find a timing match which in turn means there is likely something wrong with the 60Hz profile.
Can you post a screencap of the source summary in the info menu (press up and down buttons - file will be on the SD card)

buzbard, 2021-12-12:
Screen capture with the menu (btn2+btn3) only seems to capture screen without menu.
But here's a pic from my phone
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
.

IanSB, 2021-12-12:
That all looks sensible, can you also use the save log option and post log.txt from the sd card

buzbard, 2021-12-12:
Sure, here ya go
[Log.txt](https://github.com/hoglet67/RGBtoHDMI/files/7700081/Log.txt)
.

IanSB, 2021-12-13:
It looks like there is a mistake in the profile.
You need to set "Auto Switch" to "Sub-profile only" and then save configuration

buzbard, 2021-12-13:
Ok, that did the trick. I restored the "Cmd_128_50Hz.txt" file and now it stays with 60Hz, no more flashing!! Yah!

Thanks

IanSB, 2021-12-13:
Ok that will be fixed in the next stable release due shortly

Closed 2022-02-13.

Thread 264 (2021-12-22):

Auto NTSC artifact color doesn't work on Apple IIe

anpage, 2021-12-22:
I have an enhanced Apple IIe and while manually enabling NTSC artifact color does work (and looks great, by the way,) leaving it on "Auto" never switches to color.

Using the default Apple II profile, launching The Oregon Trail leaves the output in monochrome mode. Is there something specific about my IIe or The Oregon Trail that breaks this feature?

IanSB, 2021-12-23:
If you have an NTSC IIe, I would expect it to work but I've only tried on my standard IIe which is an NTSC model. You could try experimenting by adjusting the Y Lo DAC setting a little in the sampling menu as that sets the threshold for the burst detection. Also if you have an oscilloscope you could look at the video signal to confirm if the colour burst signal is present.
Note that long cables may reduce the burst level to the point that it isn't getting detected properly.
You could also try using the internal pickup option detailed in the cables section.

It should also be noted that the auto option doesn't work on the PAL Apple IIe because it doesn't seem to produce the required colour burst signal when the PAL encoder is disabled. (The PAL encoder can't be left enabled because the PAL subcarrier interferes with the pixel sampling.) The PAL IIe should also work with auto switching if you use the internal connection option.

I believe the later models sold in PAL areas actually used Apple's proprietary "International NTSC" which was a form of NTSC encoding with a different subcarrier frequency and that required a special Apple monitor for colour display. I think that should work but I don't have one of those either. (These were basically NTSC models with a different clock frequency and 50Hz refresh rate.)

anpage, 2021-12-23:
I'm sure my machine is an NTSC model, so PAL shouldn't be an issue. I'll try adjusting those settings and see if it helps. My cable is fairly short ~15cm IDC->ribbon->RCA homemade one, but there might be some high resistance, so I'll double check that too. If those still don't solve the problem, I do have an scope I can use to check the color burst. For all I know, there's a fault with the computer itself.

I missed the internal pickup option. I might try that next either way. I've been planning on building a second RGBtoHDMI board just to leave off the analog board and use for digital.

anpage, 2021-12-23:
Adjusting Y Lo 2 or 3 levels lower fixed the problem. Thanks!

Is it worth adding a note about adjusting that threshold setting to the artifact color section of the wiki?

IanSB, 2021-12-23:
For now I've added a note to the troubleshooting section but it maybe that the video levels on the enhanced boards are slightly different. The values in the sampling menu have been set based on my NTSC IIe and PAL II+ but it really needs someone with a wide range of Apple variants to go through and look at the optimum settings.
If the DC level of the entire video signal is shifted on the enhanced model then perhaps it needs a separate profile for those models but it could equally well be an issue with your board where the burst level is too low.

Closed 2022-12-20.

Thread 266 (2022-01-09):

Sub Profile setting not being saved in the menu

Pontiac76, 2022-01-09:
I think I've found a bug with saving the sub-profile.

I had a similar issue as in #262 with my Commodore 128.  The hint about the screen flashing because it can't find a lock took me down the line that there's frequency problem.

Here's what I did to fix my problem.
HARDWARE:
- Using Raspberry Pi 3B+
- Initially used an HDMI to DVI-D cable to hook up to an old monitor.  (4:3?  3:4?  I don't know the ratios)
- Switched to an HDMI wide screen 1920x1080 TV
- Commodore 128 NTSC
- Ultimate2+ to load the D81 image.

When I first booted this bad boy up, I started the 128 in 40-col mode and noticed the converter announcing its initial status screen, but everything was still black on the 128, which is expected, so I didn't notice that it was flashing black on black (theoretically? heh)

I then hit the 40/80 col button on the 128 and kicked the power.

The Basic 7 screen came up with the green on black text, but it was scrolling like mad.

I eventually found the Profile line and eventually switched it to the Commodore 128-80.  This fixed the Basic 7 screen.  It was rock solid and pixel perfect.

I then kicked up Petscii Robots, but found that the HDMI screen was flashing on and off at about 1hz. (Nod to #262)

I eventually found that in my case, I had to switch OFF the Auto Switch, and set the Sub-Profile to Cmd 128 60Hz.  The flashing stopped.

I saved the profile, it stated it saved to a 60hz text file, and all is good.  Or so I thought.

I restarted the HDMI board, with the 128 still running the game, and found that it came back up and was flashing again.  The startup screen said it was running at 50hz again?  I go into the menu, and sure enough, Auto Switch was still off, but Sub-Profile was back at 50hz.  I switched to 60, returned to the game, no flashing, went back into the menu, saved the profile, back to the game, restarted the HDMI board, and back to 50hz I went.

IanSB, 2022-01-12:
@Pontiac76
>Auto Switch was still off, but Sub-Profile was back at 50hz. I switched to 60, returned to the game, no flashing, went back into the menu, saved the profile, back to the game, restarted the HDMI board, and back to 50hz I went.

Strictly speaking, this isn't a save bug as the selected Sub-Profile is never saved by design and it will revert to the first file in the list which is CMD 128 50Hz on next reset. Normally the only reason to switch off auto switch when using multiple profiles is so that you can manually select a profile to tweak and save it before re-enabling auto switch. When you get a flashing screen it means that something is wrong with the profile set because none of the available profile timings match the incoming signal.

In your case it looks like Petscii Robots is using a mode with custom timing that doesn't match any of the sub-profiles so another sub-profile has to be created to match it.
As it appears to work with  Cmd 128 60Hz, the most likely explanation is that the petscii robots timing is only slightly different from the actual Cmd 128 60Hz timing.
Can you post a screenshot of the Source Summary page in the info menu when running petscii robots (you can screencap that by pressing the Up and Down buttons -  file in /Captures on the SD card)

Maybe I will add a feature to save the sub-profile setting when auto switch is off in future but it would only be hiding the real problem which is a missing timing file.

Pontiac76, 2022-01-12:
I take back that the Basic 7 screen alone doesn't flash.  It does flash.  I don't remember what the exact situation was when I saw that it wasn't flashing, then loading the game it did flash.

Would the quick-fix be just remove the 50hz profile?  (Or rename it to something else that goes further on?)

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

[Log_Basic7_60hz.txt](https://github.com/hoglet67/RGBtoHDMI/files/7858506/Log_Basic7_60hz.txt)
[Log_Basic7_50hz.txt](https://github.com/hoglet67/RGBtoHDMI/files/7858507/Log_Basic7_50hz.txt)
[Log_Petscii_50hz.txt](https://github.com/hoglet67/RGBtoHDMI/files/7858525/Log_Petscii_50hz.txt)
[Log_Petscii_60hz.txt](https://github.com/hoglet67/RGBtoHDMI/files/7858526/Log_Petscii_60hz.txt)

Pontiac76, 2022-01-12:
You might notice a LITTLE bit of speckles on the Basic 7 screens, but, I've just discovered that the long length serial cable I'm using (It's the only one I could find) is temperamental when plugged into the back of the 128.  If I wiggle it around a bit, the image clears up and things look perfect.  I didn't notice that artifacting the other day, but it was really pronounced today.  Held my tongue right, so, that fixed that.  Unsure if that'll affect the above results, but, with or without the artifacting, I'm getting the flash at 50hz.

I'm using the serial cable for a couple of reasons.  This game has an adapter for the SNES game pad that plugs into the User port, and with the HDMI cable coming out, it's sitting a little awkward.  I want the ribbon that comes off the board to the serial plug to be solid and not risk "pulling" or "tugging" so I'm working on trying to make this thing sit in a solid case.

UNFORTUNATELY, the cable is a 10 foot cable, so I can understand if there's some noise that's introduced.  If you need me to redo this with the device plugged in directly, no problem.

IanSB, 2022-01-12:
The 60Hz ones have the correct timing for Basic 7 so I don't know why that's flashing now, did you set Auto switch back to sub-profile only and save the configuration?

If you look at the source summary, petscii robots is generating frames with 262 lines instead of 264 lines and that's why it can't match and so flashes the screen;

Here is an alternate 60Hz profile with 262 lines:
[Cmd_128_60Hz_Alt.txt](https://github.com/hoglet67/RGBtoHDMI/files/7858613/Cmd_128_60Hz_Alt.txt)

Put this in \Profiles\6-12_BIT_RGB\Commodore_128-80 on the SD card
Then delete the \Saved_Profiles folder on the SD card to remove any tweaks you may have made and reboot the Pi

If things work then you should notice the sub-profile change when you switch between normal and petscii modes

Pontiac76, 2022-01-12:
I understand that the cable isn't ideal.  I only wanted to make sure I had an alternative option in case things got a bit crowded in behind the machine.  With the discovery of the noise, I'll be looking to redesign the case so the cable remains protected.  I just need to figure out the orientation and physical support so I don't add stress to the PCB in the computer.

Regarding the file, yes, that seems to automatically take me where I am.  I would have expected the _alt text to show up, but its showing me 60hz at least.  No flashing, or anything of the sort.

I'll look over the previous screen shots and what this alt file has and see if I can find whats what.  I'm looking at all three files (Original 60hz and 50hz vs your alt) and there's a bunch of differences.  I'll just have a look at the two 60s later.

Thanks for the effort.  I appreciate it.  REALLY happy with this thing.

IanSB, 2022-01-13:
@Pontiac76

Not sure why you can't see the Alt profile name but I'll add the alt profile to the next beta release.

I wonder if there is a similar difference with petscii robots on 50Hz machines?
Unfortunately I don't have a C128 myself which makes it difficult to check for this type of problem.

Can you post a few screencaps of Petscii robots and I'll add them to the gallery next time I do an update

Pontiac76, 2022-01-13:
Absolutely.  Although a bit of a mess, I'll throw some camera shots at you as well showing both monitors up and going.

Pontiac76, 2022-01-13:
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

Pontiac76, 2022-01-13:
Re-opened for visibility.  I consider this closed.

IanSB, 2022-01-13:
@Pontiac76

Thanks

BTW You can actually get a second RGBtoHDMI with analog interface to work on the 40 column (VIC II) output if you fit the C128 variant of c0pperdragon's C64 mod but that's a really advanced mod.
Someone has actually done that:
https://www.youtube.com/watch?v=mvTGewKlmK4

Pontiac76, 2022-01-13:
Very interesting.  At this time though, my CRT is doing me just perfectly.  I love how my kids can hear the CRT whine, while I can't.  The image is crisp and clean, but, absolutely I'll be keeping my ear to the rail on that particular project.

Thread 268 (2022-01-26):

Atari MegaSTE  60mhz NA machine

Biker1bob, 2022-01-26:
I have built one of the devices up with a 12bit board I purchased assembled - its an IanSB board.

This is the topic thread I am getting my info from https://www.atari-forum.com/viewtopic.php?t=40201

My situation is - in LOW or MEDIUM resolution - where I would use the RGB colour (AKA NOT MONO)  Green is substituted for Black - I cannot get the device to produce a BLACK - It is using the STE 50hz profile. My monitor is able to do 50hz. EVERYTHING else looks fine except where a black should be there is Green.

I have adjust every setting in the software I can think of. I have rechecked all my wiring 10+ times.. I am at a loss. Any suggestions would be appreciated
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

IanSB, 2022-01-26:
It seems likely that one of the four green bits is stuck high.
Based on the brightness of the green it looks like the highest bit G3 is stuck on so maybe check your soldering around that signal or try disconnecting it entirely.
Are some other colours a bit 'off colour'? (White would still be white but colours would have some green added to them)

I don't have an STE but is there any video test program that displays the full colour test patterns for that machine.
I have a program like that for the Amiga which makes it easy to work out which bit is the problem. It produces an output like this:
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

Which shows the full 16 levels of red, green & blue and that makes it easy to confirm which bit is stuck.

Even if you can't find a program, if you post a screencap (Short press of SW2 - file on the SD card) as I can look at the RGB level of the black background with a paint program.

Biker1bob, 2022-01-27:
There is the colour test that the Diagnostic cartridge shows. I have tried removing the connections.. not sure that I did it one at a time.. aka just G3.. I will do a screen shot of the Diagnostic screen and post. Thanks for the response.

Biker1bob, 2022-01-27:
Ok, so I did some screen captures.. I also undid all the connections.. re-examined all the solder joints.. everything is good. There is another interesting development. - when the HDMI device is wired up and powered.. it does modify the output of the Monitor port. see the attached pics for the colour bars and the changes when output to Monitor power <> VGA on monitor.
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

IanSB, 2022-01-27:
@Biker1bob
>it should not effect the output correct?

Correct.
The green value in the above PNGs is 68 which implies that it is G2, not G3 that's the problem. (it would be double that for G3, half for G1 and a quarter for G0)

So repeat the disconnection test with G2.

How are you picking up the signals? directly from the chip pins or via the resistors that are connected to those pins. (if the latter, make sure you are on the right end of the resistors which might not always be the same on all resistors)

If the pickup points are OK then it is possible that the G2 signal is shorted to a logic high somewhere in the converter

First disconnect the converter from the Atari (unplug the 16 way cable) and try powering it with a USB power supply (USB connector nearest the 16 way connector)
If you get a green screen then it means G2 is shorted to a logic high signal on one of the boards or possibly a faulty CPLD.

If you get a black screen then it's more likely that G2 is shorted to another input signal like the HSYNC or VSYNC inputs
The Hsync input has composite sync which is normally high during video (this is less likely as it would affect the sync)
The Vsync input normally has the MONO signal and I think the MONO signal is high when the RGB signal is in use.
(you can check that by disconnecting both G2 and MONO from the STE)
Check the CPLD board and extender board separately for any solder bridges or use a multimeter if you have one

Don't forget to unplug the USB power supply before reconnecting to the computer.

Biker1bob, 2022-01-28:
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
Just did this.. NOTHING changed. G2 did not affect anything on the HDMI OUT OR the Monitor out.

> How are you picking up the signals? directly from the chip pins or via the resistors that are connected to those pins. (if the latter, make sure you are on the right end of the resistors which might not always be the same on all resistors)
>
> If the pickup points are OK then it is possible that the G2 signal is shorted to a logic high somewhere in the converter

Yes from the legs of the resistors just after the chip - aka before the resisted values. Several others have done in just this place so I am very sure I am correct.

> First disconnect the converter from the Atari (unplug the 16 way cable) and try powering it with a USB power supply (USB connector nearest the 16 way connector) If you get a green screen then it means G2 is shorted to a logic high signal on one of the boards or possibly a faulty CPLD.
>
> If you get a black screen then it's more likely that G2 is shorted to another input signal like the HSYNC or VSYNC inputs The Hsync input has composite sync which is normally high during video (this is less likely as it would affect the sync) The Vsync input normally has the MONO signal and I think the MONO signal is high when the RGB signal is in use. (you can check that by disconnecting both G2 and MONO from the STE) Check the CPLD board and extender board separately for any solder bridges or use a multimeter if you have one

OK, so we have a green screen with just external USB power.. so I will start checking my soldering again.. and check for shorts with the multimeter

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

Biker1bob, 2022-01-28:
Think I found it.. On the clpd - it also had continuity with G2
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
.

IanSB, 2022-01-28:
>Think I found it.. On the clpd - it also had continuity with G2

Yes, that's almost certainly it, that's pins 35 & 36 which are +3.3V and G2 respectively

Biker1bob, 2022-01-28:
YES, that was it IanSB - BLACK screen now. Thankyou so much for pointing out the G2 issue.. it allowed me to follow your steps and start investigating with the multimeter knowing a start point! :)

Closed 2022-01-28.

Thread 273 (2022-02-10):

Dedicated luma-code input cable

c0pperdragon, 2022-02-10:
As discussed in https://github.com/hoglet67/RGBtoHDMI/issues/258 ,  it is a viable method to use this specific encoding to transfer all image data on the luma line alone.
For this purpose a full-blown analog board is actually a bit of an overkill. Especially because I can guarantee tight tolerances on the signal levels and manual calibration should be unnecessary.

I envision an adapter cable with an RCA plug on one side and a 12-way connector on the other side to plug into the regular 12-bit board. Directly soldered to the connector is a small PCB that carries just one MAX9144 comparator and a few passives. With a suitable zener diode and a few resistors, I should be able to create the necessary comparator input voltages.
This would surely be much cheaper than an analog board and with the electronics in the cable itself it reduces the number of things to plug together.

My question now here is how this cable could fit into the overall RGBtoHDMI infrastructure. Can this simply be treated like a regular digital signal source? Will this cause confusion with the solution that uses an actual analog board?

With no FPGAs in view for a long time, this is the only side of the equation I can actually do some work on right now. That's the reason I come up with these kind of ideas all the time.

IanSB, 2022-02-11:
That should work and it would be seen as a digital source with an additional digital profile.
I actually built something like your suggestion as my first experiment to capture the ZX81:
https://stardot.org.uk/forums/viewtopic.php?p=226513#p226513

It might even be possible to add the components on the main PCB for a fully dedicated board.

c0pperdragon, 2022-02-11:
I also throught about such a combined board just for the sake of the lume-code input. But this would actually not safe many components. Just a few pin headers and sockets. All the ICs still need to be there.
So the 12-input CPLD-board is surely the most versatile building block.

c0pperdragon, 2022-02-16:
After a bit of measurements, I must admit that creating a signal that can be reliably used without further calibration is nearly impossible. So even for this a programmable voltage reference is needed.
This makes a dedicated luma-only board looking sensible again.

Closed 2022-03-27.

Thread 277 (2022-02-15):

Can simple (non-CPLD) handle odd frequencies

e8micke, 2022-02-15:
Hi,

Anritsu spectum (MS8604A) analyzer (and some other equipment) have a "Separate video output" or VIdeo Output Separate".
This was supposed to be connected to a video (signal) printer, but could be
5 digital signals:
1. ~21.04908MHz video clock
2. ~56.4Hz VSync (normally high, with low pulses illustrated as red in the attached image)
3. ~24.85kHz HSync  (normally high, with low pulses illustrated as blue in the attached image)
4. Video data (valid on falling video clock)
5. A ~4ms low pulse when you push "print screen"

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

Image was generated by Saleae logic analyzer and a Python/PIL script.
Do you think it would be possible convert that signal to HDMI with or without CPLD?
I do think I have understood an external XOR is needed on a non-CPLD solution.

IanSB, 2022-02-16:
@e8micke
>Do you think it would be possible convert that signal to HDMI with or without CPLD?

It should work with the CPLD but it may be problematic with the simple c0pperdragon style connection.

Simple mode is limited to about 16MHz pixel clock and to get any higher you have to de-serialise the incoming video and pass pixels in parallel as well as divide the clock by 2 and xor the syncs.

It would be a lot simpler to use the CPLD version but if you are interested there is a discussion of this type of solution used by the Atari ST mono mode:
Starts here:
https://github.com/c0pperdragon/Amiga-Digital-Video/issues/6#issuecomment-918614705
Continues here:
https://github.com/c0pperdragon/Amiga-Digital-Video/issues/56

For the CPLD interface you would connect the Hsync & Vsync outputs to the appropriate sync inputs and the video to the green3 input

The genlock would make the output rate track the input by default which might upset some monitors as 56Hz is not one of the standard refresh rates but you can always disable the genlock and set the output to 60 Hz.

Here is a starting profile based on the above info but the width, height and offsets will need to be adjusted. Put this file in \Profiles\6-12_BIT_RGB on the SD card:
[Anritsu_spectrum_analyzer.txt](https://github.com/hoglet67/RGBtoHDMI/files/8080931/Anritsu_spectrum_analyzer.txt)

e8micke, 2022-02-16:
Thanks for the fast and long answer!
I think I will start to put some thoughts on the non-CPLD solution, for the fun of it... :-)
All signals are 5V, so I will need some 74LVC anyway.

Is the "AtariST-Alpha3.zip" still untested to your knowledge, it seems to fit like a glove.
Video clock (GPIO17 I think), which edge is used by the RPi Zero, is it programmable (rising or falling)?
Is 4ms sufficient for a "keypress" (screensave) on SW1 input, or is there a debounce filter?

IanSB, 2022-02-16:
@e8micke
>I think I will start to put some thoughts on the non-CPLD solution, for the fun of it... :-)

Ok in that case the test profile above should be put into the /Profiles/Simple folder instead and you will need to select 1 Bit (R3 & G3) in the sampling menu.

>Is the "AtariST-Alpha3.zip" still untested to your knowledge, it seems to fit like a glove.

I've not had any feedback on that and it's now quite old but the current stable release supports 1 Bit (R3 & G3) so I suggest you use that as you don't need support for the other bit depths.

>Video clock (GPIO17 I think), which edge is used by the RPi Zero, is it programmable (rising or falling)?

It uses both edges so you have to divide the video clock by 4. Make sure both edges of the new clock (psync) change state with the falling edge of the video clock.

I think it's divide by 4 because you have to divide by 2 to get the basic psync signal for the 21Mhz clock (due to it using both edges) and divide by 2 again because you are clocking in 2 pixels at a time.

>Is 4ms sufficient for a "keypress" (screensave) on SW1 input, or is there a debounce filter?

The keys are only checked at the start of each frame so the pulse would have to be significantly greater than 20ms for reliability.

e8micke, 2022-04-24:
Took a while to get the parts and have the time to put it together, but finally it happened :-)
I works sort-of, but there are some kind weird  syncronization/data error.
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

Pixel clock is as earlier mentioned about 21049080Hz.
But after the division by 4 the incoming clock frequency is about ~5.3MHz (into PiCLK/GPIO17).
What Frequency is correct to state in the Profile file, is it really 21049080?
I could imagine that the vertical sync could jump in even steps,  but it seems like even odd steps is possible, which feels a bit wierd due to the 2-bits per clock data shuffling.
My best bet is that the PLL does not get proper information for it's lock.
`Detected polarity state = 4, Comp (Separate H & V CPLD)
       clkinfo.clock = 21049080 Hz
     clkinfo.line_len = 848.000000
    clkinfo.clock_ppm = 5000 ppm
    Nominal 100 lines = 4028600 ns
     Actual 100 lines = 4028761 ns
          Clock error = 39 PPM
 Error adjusted clock = 21048238 Hz
 Target PLL frequency = 2020630912 Hz, prediv = 1, PER = 4
 Actual PLL frequency = 2020630912 Hz
        GPCLK Divisor = 4
      Lines per frame = 440, (440)
 Actual frame time = 17726379 ns (non-interlaced), line time = 40287 ns
 Window: H=40086 to 40488, V=17637748 to 17815010
 Sync=Comp, Det-Sync=Comp, Det-HS-Width=37211, HS-Thresh=9000
 Width or Height differ from last FB: Setting dummy 64x64 framebuffer
 Overscan L=0, R=0, T=0, B=0
 Initialised Framebuffer
 Size: 800x480 (req 800x480). Addr: 1E000000 (DE000000)
Screen size = 800x480
Pitch=800, width=800, height=480, sizex2=0, bpp=8
chars=96, nlines=416, hoffset=6, voffset=19, ncapture=-1
palctrl=0, samplewidth=2, hadjust=16, vadjust=32, sync=0x4
detsync=0x4, vsync=0, video=0, ntsc=8, border=0, delay=2
Display startup message
*PLL
*PLL
Locked
`

IanSB, 2022-04-24:
@e8micke
It's not the PLL as that isn't used in simple capture mode. (The PLL generates a clock to feed to the CPLD but that isn't connected in simple mode)

The clock error is very low which means the profile is set up correctly so the problem might be some issue with the simple two bit capture code as that hasn't really been tested other than some promising results from the Atari experiments but the most likely cause is some issue with your capture circuit.

The image is the right width so the absolute value of the divided sample clock is correct but the most likely cause is some sort of phase issue with the sample clock divider as the start state of the two bits of the flip flops would be random. You may need to reset the sample clock divider at the start of each line using the hsync pulse. Even then you would have to be careful to get the relative phases of everything correct.

Do you have a schematic you can post or link to?

e8micke, 2022-04-30:
Here are a schematic:
[anritsu_adapter.pdf](https://github.com/hoglet67/RGBtoHDMI/files/8596621/anritsu_adapter.pdf)

The physical circuit is a "rats-nets" type (not a PCB), so there are many error sources (grounding, inductance in wires, etc) .
(image has difference to the schematic):
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

As the pixels per row are even I don't think I need to resync the 2bits in series to two bits in parallel circuit.

The error have seen in not (purely) shifting errors, but will connect a logic analyzer after all latches and logic and check that the signal into the Raspberry Pi is as expected, and render the image, once more in Python+PIL.

e8micke, 2022-04-30:
It seems to be related to the "rats-nest", I get a very similar image using the logic analyzer. Clock glitches seems to happen, so some better grounding/decoupling is needed.

IanSB, 2022-04-30:
@e8micke
> I get the impression that the e.g. level of G3 is not strictly sampled at the edge. It might happen 12ns from the edge. There are some glitches which are visible via RGBtoHDMI, but are ignored by the logic analyzer

That is very likely because it takes the GPU ~30ns to read the GPIOs which means that worst case it would be 30ns after the clock edge and an average of 15ns which corresponds to your estimate.

IanSB, 2022-04-30:
@e8micke
Also LVC parts are probably too susceptible to noise in such a rats nest. You could try VHC parts instead which are slower (similar speed to HC but 5v tolerant.)

e8micke, 2022-05-01:
Very close to OK now: (cropped captured using RGBtoHDMI)
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

As a note, I have seen "R3 and G3 (R3 is leftmost)" as a comment, but I think G3 (GPIO9) is leftmost (is presented as the left pixels of the two).
You have mentioned that there are 30ns max from edge to read, but can it happen earlier than the edge? (due to some kind of phase lock software)
 I currently use shift register that only gives stable data for ~44ns.

IanSB, 2022-05-01:
@e8micke
>Very close to OK now: (cropped captured using RGBtoHDMI)

Yes looking much better. You need to increase the geometry sizes to avoid cropping

>can it happen earlier than the edge? (due to some kind of phase lock software)

No, all the GPIOs are all read into a single register at the same time in a loop and if the clock bit has changed state then the data bits already read at the same time as the clock bit are used.

e8micke, 2022-05-01:
I think I have managed to replicate the way your software sample the signal, and it looks perfect in the logic analyzer (when converted to an image), and I can't see glitches or jitter using oscilloscope either.

But I can't remove the (small) jitter errors.
I get the impression that the Raspberry is simply not (always) quick enough to fetch GPIO before the logic level changes.

You mentioned 30ns as max time for fetching after clock edge change. I think I have ~40ns stable data after clock edge at the moment.

Is that (30ns max) independent of the input signal, like video clock frequency? And is it truly a max value?
I starting to think that the data needs to be stable just as long as the clock signal (~88ns).

IanSB, 2022-05-02:
>Is that (30ns max) independent of the input signal, like video clock frequency? And is it truly a max value?

The benchmark code indicates it takes 36ns which is very close to your ~40ns stable

>I starting to think that the data needs to be stable just as long as the clock signal (~88ns).

It probably does.

e8micke, 2022-05-04:
Noted!
I thought it was some kind of "hardware acceleration" (DMA) involved, but now I understand it is purely "bit-banging" on steroids. :-)
I will do a redesign of latches and logic, thanks Ian!

Thread 278 (2022-03-06):

Flashing screen from PC in Hercules or MDA mode

oraclejedi, 2022-03-06:
I've seen a few thread on the RGB2HDMI flashing the screen on and off every half second or so.   I've tried the suggested fixes but so far nothing has helped.

I have a generic PC clone.   It has an NSI "Smart EGA" graphics adapter that can out CGA, EGA, MDA or Herc.   I have the monitor switch block set for MDA/Herc and Checkit confirms that it was it thinks the system has.

I followed "Nerdly Pleasures" blog on setting the system for Hercules.  If I have the RGB2HDMI menu up, I can see a stable crisp image from the PC.   But as soon as I exit the menu the whole screen flashes on and off.

The monitor is a Samsung TW215.  It expects 1680x1050@60Hz.  The MDA/Herc is outputting at 50Hz I believe.   Auto-callibrate ran and reported no errors but the Sync LED is still flashing.

Note:  The system works great in EGA or CGA mode.

Anyone got any pointers on how to stop the flashing?

IanSB, 2022-03-07:
Flashing like that means that the timings from the video source don't match any of the timings in the sub-profile folder.
Sometimes this is because the card is actually outputting non-standard timing which would work on a normal analog monitor but that won't work with RGBtoHDMI because it needs precise info in order to do pixel perfect sampling although in this case I didn't have MDA or Hercules cards so those profiles were based on published info which might not be correct.

Can you post screencaps of the source summary page in the info menu for each problem mode. To screencap, press the up and down buttons together and the captures will be on the SD card.

oraclejedi, 2022-03-07:
Thanks for taking a look at this.

Below should be the Source Summary.   At this point the PC image in the background is 100% stable.

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

oraclejedi, 2022-03-07:
I applied the settings from Nerdly Pleasures' blog.   Basically the Sync-Type and Clock Freq.  Without these the image is shaky.   I think the H-Offset had to be reduced to zero from the original setting of 12.

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

oraclejedi, 2022-03-07:
The main menu setting.

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

oraclejedi, 2022-03-07:
I don't want to declare victory prematurely, but I just set "Auto Switch" to OFF and I have a stable image, no menu.  Looks great.   Further testing needed....

IanSB, 2022-03-07:
>I just set "Auto Switch" to OFF and I have a stable image

Switching auto switch off disables the search for a matching sub-profile which will stop the flashing but it still means that the profile is not a perfect match for the source.

A profile is determined to be a match when three conditions are met:
1. Number of lines per frame match. This is 370 in the source and profile so that is good.
2. The sync types match. This is +H-V in both the source and the profile (after adjustment?) so again good.
3. The PPM error is less than the Clock tolerance (set to 4500 in the profile) and close to zero . The PPM error is 20870 so that is not correct.

The PPM error is determined by a combination of the Line Length and Clock Frequency settings so they need to be adjusted.
As you are not using an original hercules card there is some chance that both of the above values are non standard so you will need to adjust them as follows:

The line length may already be correct if there is no visible noise in the image but to confirm that you need to fill the screen with text all the way to the right hand side. Any noise will appear as alternating vertical bars of noisy and stable pixels and you need to adjust the line length until all the image is all clean (or all noisy if the sampling phase is set incorrectly)
Try adjusting the line length setting a few values either way to get a feel for the results.
Once you have set the line length correctly you need to adjust the clock frequency to reduce the PPM error close to zero. As you adjust it the PPM error is displayed at the top of the screen.

Once these settings are correct, save the config, re-enable the auto switch and save config again and it should select that profile.

oraclejedi, 2022-03-09:
Here's a grab of an Infocom adventure using most of the screen.    This using the settings from before - the clock at 16257000 and a line length of 864.   The image is rock solid but requires the profile auto-switch to be disabled to prevent flashing.

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

And here is a DOS utility that shows a screen full of text.   I have set scan lines on as it yields a more authentic looking output.   I am not seeing any distortion with these settings.

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

oraclejedi, 2022-03-09:
I also experimented with adjusting the clock and the line length.   Without much success.   But I did get down to 0 PPM with a line length of 883.   Auto-switching enabled did not cause flashing but the left most columns of text shimmered and were partially distorted.   I will keep experimenting to see if I can get a perfect image with a low or zero PPM error count.

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

IanSB, 2022-03-09:
@oraclejedi

You adjust the line length for zero noise bars and the original 864 seems to be OK. Then adjust the clock to get the PPM close to zero so you will probably have to adjust the clock to 16000000 which is the correct value for a real hercules card but it might be some other value.
If you hold the up or down button the increase or decrease will accelerate.

IanSB, 2022-03-09:
@oraclejedi

The published info on hercules was line length of 864 for graphics mode and 882 for text mode but your card might use only one value for both. When adjusting the line length around the correct value, as you increase from the correct value the bars will get more numerous and similarly when you decrease from the correct value the bars will get equally numerous so by monitoring the effect of increasing and decreasing you can determine the centre point where everything is clean. It is also very likely that the number will be an even value so odd numbers are probably wrong.

IanSB, 2022-03-27:
@oraclejedi
Can you give the Alpha54E version of the software a try:
https://github.com/IanSB/RGBtoHDMI/issues/10
This has a separate PC_Hercules profile and has been confirmed to work on real hercules hardware.

oraclejedi, 2022-03-28:
Hi Ian,
Will do.   The PC1 is back on the shelf right now but I will pull it down and try the new code.  It will be an interesting exercise in upgrading the RGB2HDMI too which I have not tried before.
Should have some results by the weekend.
Thanks!
Graham

    On Sunday, March 27, 2022, 02:44:51 PM PDT, IanSB ***@***.***> wrote:

@oraclejedi
Can you give the Alpha54E version of the software a try:
IanSB#10
This has a separate PC_Hercules profile and has been confirmed to work on real hercules hardware.

—
Reply to this email directly, view it on GitHub, or unsubscribe.
You are receiving this because you were mentioned.Message ID: ***@***.***>

oraclejedi, 2022-03-30:
I've applied Alpha 54E and it has helped a great deal.

Upon start up the RGB2HDMI goes to CGA mode which yields a corrupted display, but manually switching to PC MDA mode delivers a clear stable image from the NSI in Mono mode, albeit offset to the left.   When this is manually adjusted to an H offset of 12 the picture is centered, stable and appears to be fully rendered.

I am able to leave the auto-switch at sub+manual and I do not get the constant flashing.

Starting a game that uses Hercules mode results in the display shifting to the right with the right-most part of the display now cropped.  Manually adjusting the H offset back up to 32 shows the whole image.

Manually switching the RGB2HDMI to Herc mode yields a wobbly image with distortion visible as vertical bands in 4 locations.  The NSI hercules mode seems to much prefer the MDA settings to the Hercules ones.

The D1 LED flashes continuously.

Thread 279 (2022-03-19):

Cannot revert to stable configuration

alex3331, 2022-03-19:
I am using the board with Sharp MZ-700 computer (RGBS, Acorn Atom configuration; 320x200 , 15,625 Hz/60  Hz). Until recently everything was working fine.
I accidentally changed  some setting and vertical synchronization is no longer working - the screen is scrolling at ~1 Hz rate. Horizontal synchro and RGB seem to work fine.
I changed the SD card for a newest version of software, but it did not help. I do not know where this information is stored.
The RGBS output of my computer works fine when plugged in RGB to VGA adapter.

Any idea on how to reset everything or make this work?

IanSB, 2022-03-19:
@alex3331
Looking at the MZ-700 schematic it appears to have RGB TTL output with composite sync so I assume you are using the Atom (TTL) profile, not the analog Atom profile?

Use the save log option in the info menu and post log.txt from the SD card. Also post a screencap of the source summary menu.

Do you have a link to any specs for the the MZ-700 video modes (PAL/NTSC resolution/refresh pixel clocks etc)  as it seems a suitable machine for a dedicated profile.

alex3331, 2022-03-19:
Somehow the VSYNC started working. Now I have an artifact in the leftmost pixel column - it is unstable. The rest of screen ic perfect. Still do not know what caused it.

I saved the files and they are in the attachment; However the file dated are  4/9/2016, although the software confirmed that the files are recorded. I had to rename EDID.bin to EDID.txt.
Source menu:
Pixel Clock : 7159030 Hz
CPLD Clk: 57272184 Hz(x8)
Clock error 9 ppm
Line duration 63695 hz
Lines per frame 262
Frame rate 60 Hz (59.92)
Sync type composite
Pixel aspect 1:1
Capture size 320x216  (640x432) - SCREEN is 320x200 and it is shown correctly
H&V range 14-333 x 24x239
Frame buffer 768x432 (768x432)
FB bit depth 4
Pi resolution (1920x1280) (1920x1280)
Pi Frame rate 60 Hz (59.92 Yz)
Pi overscan 0x0 (1x0)
Scaling 2.50 x 2.50

I will provide you with MZ-700 /MZ-800 video profiles sometime next week. MZ-800 has 2 modes RGB 320x200 and RGBI 640x200. I am sure all our user group will be very happy to use RGBtoHDMI

[EDID.txt](https://github.com/hoglet67/RGBtoHDMI/files/8309864/EDID.txt)

[Log.txt](https://github.com/hoglet67/RGBtoHDMI/files/8309857/Log.txt)

Thread 280 (2022-03-22):

no display - bbc model B 12 bit board 1360x768 60hz raspi zero

smith844, 2022-03-22:
I got a bbc model b and thought i would build a rgb to hdmi adaptor but have hit a wall.
I built as per the instruction,  I connected my RGB plug to the 12 way as per the cables page and put on the latest software.
the pi powers on, the monitor detects an input and the D2 led lights on the board but i get no output.
I tried a previous version of the software and get a 4 coloured square briefly when it appears to boot, but no output beyond.

I have tried several combinations of pressing the buttons but to no avail.

Do i need to set the resolution in the config files ?
Otherwise can anyone help.....

IanSB, 2022-03-22:
@smith844

No, you don't need to setup anything prior to initial bootup.
If you have a TTL serial to USB adapter, you can connect the serial input of that to TxD and Gnd marked on the 40 way connector and display the debug log on a PC. You will need to run a terminal program set to 115200 baud, 8 data bits, one stop bit, no parity and this will show what is happening during bootup.

Assuming there are no shorts/assembly errors, one other possibility is that the CPLD you have is already programmed with some other code that stops the system from booting properly.
Where you get your CPLD? If you got it from ebay/ali express etc there is a possibility of that happening because they sometimes sell surplus stock which has been pre-programmed with other code. There are procedures to recover from that so let me know and I'll detail them.

IanSB, 2022-03-22:
@smith844
>Could it be my CPLD is not working on the board. I used a solder station with reflow heat gun, the connections seem ok.
I can only select Amiga on the profile page as well... is this related ?

This can happen when using a CPLD pre-programmed with unrelated code so where did you get your CPLD?

smith844, 2022-03-23:
@IanSB
Thank you for the quick reply.  I did indeed get my CPLD from Aliexpress.  I have a TTL to USB adaptor so could get some debug information but would it do me any good.  I have checked and rechecked the connections and they appear to be OK.  I had to guess the connections for to DIN plug as i couldn't find a useful pin out.  If i had somehow reversed the connections to the DIN plug i am guessing the board just wouldn't power up.

IanSB, 2022-03-23:
@smith844
I have seen similar reports over the past year and suspected that the issue was pre-programmed CPLDs but I only recently got some chips from Ali Express myself and confirmed this. Note I don't think these are recycled chips (i.e. salvaged from old boards) and I think it is more likely that they are surplus chips sold on by the original purchaser into the grey market but after they had been pre-programmed with the original purchaser's firmware.

One issue I discovered is that the firmware is write protected and the existing programming code didn't override that so reprogramming always failed.

Here is a test version of RGBtoHDMI which will override the write protection:
[Alpha54A.zip](https://github.com/hoglet67/RGBtoHDMI/files/8333316/Alpha54A.zip)

It also has other changes to ensure that an erase is successful but also to ensure that it works you need to cut the three "JPx" solder bridges on the back side of the PCB. This is because the reprogramming GPIOs are also connected to other inputs and if the rogue firmware makes them outputs they will conflict with the GPIOs and these cuts isolate those pins.

You can try reprogramming from the CPLD recovery menu using the three button hold down but again sometimes the software will not get that far due to the rogue firmware so another way to erase the firmware is to go into the cpld_firmware folder on the SD card and delete the file "Delete_This_File_To_Erase_CPLD.txt".
After deleting this file, on the next reset the CPLD will be erased and the file will be re-created.

So the full procedure with the most likelyhood of success is the following:
1. Installl the above alpha software
2. Cut the three "JPx" solder bridges (make sure you actually have broken the connections)
3. Delete "Delete_This_File_To_Erase_CPLD.txt" from the cpld_firmware folder on the SD card
4. Reset / repower RGBtoHDMI

If successful you should get the recovery menu to select the correct firmware
After programming, re-make the three "JPx" bridges with solder blobs (The converter will not work without them remade)

You can try skipping the solder bridge cutting the first time in case you are lucky and the 3 signals don't conflict but if that doesn't work you have to re-delete the file as it is always re-created on each reset.

Let me know how you get on.

smith844, 2022-03-23:
@IanSB
Sorted.  I followed the instructions, and did indeed need to cut the solder links.  All soldered back and working as expected. Thank you so much for the help.   Do i need to put the new software back on the SD card or will it run ok on alpha ?

IanSB, 2022-03-23:
@smith844
The alpha should be OK but it's just a snapshot of my work in progress and hasn't had much testing so you can revert to the most recent beta or stable if you want to.
I will be releasing this code soon as a new beta once it's been tested a bit more but you have helped to speed up that process by confirming the recovery procedure works. (I had run out of pre programmed CPLDs to test before finalising the code so haven't been able to fully confirm it works until now)

luciust, 2022-05-09:
@IanSB Thanks man, this is exaclty what I needed:

1. Got Ali chips
2. No bueno :( Simple v0.0
3. Found your Alpha software, deleted te file for erase, cut the three JPs: JP2, JP4 and JP1
4. And it... works - CPLD got finally programmed!

IanSB, 2022-05-10:
@luciust

Beta54 now has the updated erase code as well:
https://github.com/IanSB/RGBtoHDMI/releases

Also if you are thinking of building an analog board, don't get MAX9144 chips from Ali Express as they may not work:
https://stardot.org.uk/forums/viewtopic.php?p=358072#p358072

luciust, 2022-05-28:
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

Thanks on both accounts! I'll on Beta54 and confirmed two more CPLDs got erased nicely.

Now - I'm in process of adapting the STE and have 3 questions:
1. The standard Shifter Pickup board is 9-bit compatlible, right? I want to use it since I'm even more concerned with having a proper bus transciever designed by you to protect both STE Shifter and the RGB2HDMI.
2. I'm asuming that STE would work with just 9-bits?
3. Are you going to create 12-bit pickup board for STE - but not as addon, but just as a slight modification of the ST/9-bit board? I would just like to solder all of the 12 cables from STE resitors and have the signal protected. Seems we have exact the number of gates on 74HC245 to do that?

IanSB, 2022-05-28:
@luciust
>I'm asuming that STE would work with just 9-bits?

Yes but obviously colours using those missing least significant bits will only be displayed approximately

>Are you going to create 12-bit pickup board for STE - but not as addon, but just as a slight modification of the ST/9-bit board?

The main problem is that I don't have an STE so it's difficult to create a suitable PCB of the right shape without having something physical to experiment with.
e.g. depending on the STE layout and number of PCB variations it might be possible to design a pcb that sits on top of the resistors with the pickup pads in the right order so that it only requires a short jumper from each resistor.

> I would just like to solder all of the 12 cables from STE resitors and have the signal protected. Seems we have exact the number of gates on 74HC245 to do that?

If you are looking for a generic pcb then you could use the Amiga external pickup PCB which is the same principle as the Atari board but already picks up all 12 bits plus composite sync:
https://github.com/hoglet67/RGBtoHDMI/tree/master/Kicad_Amiga_12Bit_Buffered_Pickup/V1
(The readme.md is wrong for that and refers to the Commodore 128 for some reason)
Note this board is not the same as the c0pperdragon boards designed for use with an internal Pi zero.

Here is the schematic:
[Amiga_External.pdf](https://github.com/hoglet67/RGBtoHDMI/files/8791447/Amiga_External.pdf)

You would still need to modify this board slightly by lifting up Pin 7 of U3 (G1_I) and connecting it to the mono input so that it ends up on the VSYNC signal. (G1_I is also on U2 but was fed to the Vsync buffer as there is an option for 9 bit capture with G1 on vsync). Cutting the track is not so easy because the G1_I signal passes on to U2.

The best solution would be for someone with an STE to design a suitable pick up board

luciust, 2022-05-28:
@IanSB
Thanks again for tips!

1. I think that there's no need for the pickup board that would "sit" on STE. Mainly because the PSU is on top of the resistor ladder, and the fit would be nearly impossible (thigh fit, heat).

2. Great idea with Amiga pickup! I have them in shipping, so in meantime I used the RGB0-RGB2 approach and the results are not bad! You can notice the cyan tint for sure in color mode but it's NOT THAT bad.

MONO:
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
COLOR:
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

(Lotus STE version by: https://github.com/jonathanopalise/lotus-ste)

luciust, 2022-05-29:
@IanSB
> You would still need to modify this board slightly by lifting up Pin 7 of U3 (G1_I) and connecting it to the mono input so that it ends up on the VSYNC signal. (G1_I is also on U2 but was fed to the Vsync buffer as there is an option for 9 bit capture with G1 on vsync). Cutting the track is not so easy because the G1_I signal passes on to U2.

OK, I get it - lift it and put a kynar wire (doable under microscoper) to i.e. unused pin and connect MONO there. I think I'll use two cheap sockets to get the the connection.

luciust, 2022-06-09:
@IanSB
The boards came (in yellow this time) - can you confirm - the PIN 7 on the chip should be lifted and soldered to MONO signal from STE? The pad on PCB should not be connected?
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

IanSB, 2022-06-09:
@luciust
>can you confirm - the PIN 7 on the chip should be lifted and soldered to MONO signal from STE? The pad on PCB should not be connected?

Correct.
There is another signal on the track going to the other chip

I think I will design a general purpose buffer board some time that can be used with the STE and maybe other systems but this should work for now.

luciust, 2022-06-10:
@IanSB
Is there a Amiga Pickup board pinout description? I can of course run the multimeter to find the right holes, but maybe there's an easier way?

IanSB, 2022-06-10:
@luciust

The schematic is posted above (Amiga_External.pdf)

luciust, 2022-06-10:
Right! Got it.

luciust, 2022-06-11:
@IanSB
How about HSYNC signal? I've checked the SYNC_I - it seems to be the BLANK (don't know Amiga that well - it seems that Denise has NC here on most schemas). What is the STE equivalent?

IanSB, 2022-06-12:
@luciust

Composite sync from the Atari STE should connect to pin 32 of the Amiga board

luciust, 2022-06-12:
OK, so I got STE with modulator which gives out Composite signal. I think I need - for the Amiga board at least use the Composte Sync generator just like this one:
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

luciust, 2022-06-12:
Hmm... It seems that PIN 2 of U403 (the MC1377P on STE) with modulator has the H-SYNC and V-SYNC mixed, which seems to be a good composite sync candidate!
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

luciust, 2022-06-12:
Yup, this is it!
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

luciust, 2022-06-12:
OK, I got picture, but it's not really 12-bits, checking with the latest build

Thread 283 (2022-04-03):

Feature request: Luma-only analog board

c0pperdragon, 2022-04-03:
I am currently thinking of a cost-reduced version of the analog board with a very limited feature set: https://github.com/c0pperdragon/RGBtoHDMI/tree/master/kicad_luma_2bit/V1

It uses much fewer components and only a cheaper 2-channel DAC. The input is a simple RCA cable (maybe even directly soldered to the board to save a plug and a jack). It should work with the C64 (luma-code output) as well as the ZX80, ZX81, Apple II (I guess), as well as some others (Maybe even CGA composite).

Most of this is just the analog board with components removed, but the main difference is the DAC. The SPI interface is physically identical, but it will need a different data stream to be initialized. Unluckily, there is no obvious way to let the PI software know that this luma board is present. So there are bascially two possibilities to handle this:
1. Let the user select the board type in the sampling menu
2. Generate a data stream that will correctly set up any of the two DACs, without the Pi needing to know which one it targets. I don't know if this is even possible, but I will try to figure it out.

In any case, a modification to the Pi software would be necessary. As I don't know anything about the code, this would just be a feature request from my side.
For my first attempt, I will configure the DAC with a simple Arduino program, but in the end this of course needs to be properly integrated into the RGBtoHDMI project.

Please let me know what you think.

IanSB, 2022-04-05:
>Unluckily, there is no obvious way to let the PI software know that this luma board is present. So there are bascially two possibilities to handle this

Actually it is possible to detect the DAC type using resistors on the SPI lines which are probed during bootup and this is already used as the software auto detects three different DACs:

MAX5259 (Used by the DIY boards)
M62364 (Used by pre-assembled boards)
BU2506 (Alternative used by pre-assembled boards)

The code also still supports a couple of DACs which were used on early prototypes but you have to edit the config to select them
(They are also available as a menu option but that is disabled in release builds to avoid users accidentally selecting them):

tlc5260 / tlv5260
dac084s085

However I'm not sure about supporting a 2 channel DAC in this way because it would need custom profiles for the DAC settings and wouldn't be able to share the existing profiles DAC values.

A lower cost 4 channel DAC might be more feasible.

c0pperdragon, 2022-04-05:
It is not easy to actually find available DACs currently. The part BH2227FV is still available which is a reasonably priced, but only 2€ cheaper than the MAX5259 - so maybe not worth the hassle.

One advantage of my proposed 2 channel DAC is the fact that it has a built-in voltage reference, so there is no need to add a regulator.

IanSB, 2022-04-06:
@c0pperdragon
Thinking about it, the profiles would mostly be compatible, enough for the ZX81 / Apple II etc as only refsync and refgyhi are needed and those are covered by the two channels.

I'll have to see if there are any remaining combinations of resistors that would be detectable but in any case the manual menu selection option already exists.

c0pperdragon, 2022-04-06:
A manual menu option would be very nice already. Autodetection is of course even better, if this is possible.

I am not sure about how to go with the voltage levels themselves. I guess all other variants probably are referenced with 3.3V and do a 256-step subdivisition of this. The MCP48FVB02 on the other hand can use an internal voltage reference (1.22V or 2.44V), and also has 256 steps.
So to keep the rest of the Pi software and config compatible, a linear translation would be necessary as last step when sending data to the DAC. This would introduce a slight linearity error, but maybe this is of no big relevance. I also expect that the smaller possible range (2.44V) is still sufficient.

c0pperdragon, 2022-04-09:
@IanSB
I have tried to understand the code for auto-detecting the device configuration, but I can not quite figure out how this process works in the case of a Rev5 board. It seems it uses some active component that responds to a query signal.
Maybe this can be extended to also detect yet another board, but I am not sure about this.
Because I can not predict how this may eventually work for my board (if at at all), I will go ahead and build a board that detects as the Rev3 analog board (normally using the MAX5259), but actually has another DAC that will be configured by an arduino for a start.

IanSB, 2022-04-12:
> I can not quite figure out how this process works in the case of a Rev5 board. It seems it uses some active component that responds to a query signal.

There is a 4.7K resistor between CLK and STB on Issue 5 boards

c0pperdragon, 2022-04-13:
I already guessed that there would be some resistor between CLK and STB. But with 4.7K pull-downs on both lines on the digital board, I assumed there would be something like a 1K resistor between CLK and STB to overcome this pull-down.

After some more study of the auto-detection code, I think that one more analog board variant can be supported. I can just place a 2.7K resistor going to +5V from the CLK line. This should cause a voltage of about 3V on the CLK line when not being driven  by the Pi (as a result of the 4.7K of the digital board pulling the voltage also to GND). As all other analog boards seem to just pull CLK to GND in idle state, this should be detectable without issue.

In fact, I was so positive about this auto-detection method, that I already ordered my prototype PCBs with such a pull-up possibility.

c0pperdragon, 2022-05-21:
I have decided to cancel this attempt as it is seems not be be versatile enough to be of much use. Instead a consolidated version that combines the analog board with the a CPLD into a single PCB would be the best option from my point of few.
Unluckily of course all necessary parts are still running out everywhere so I put all my attempts in this direction on hold.

Closed 2022-05-21.

Thread 286 (2022-04-13):

Sampling phase not changed between 14/16MHz modes on Apple IIGS

rharke, 2022-04-13:
When using the RGBtoHDMI with an Apple IIGS, there are two video clocks that you have to deal with, the 14.xMHz clock and the 16.xMHz clock. I'm very pleased to see that RGBtoHDMI has handling for this!

However, there's one issue I've observed- each clock may need its own sampling phase. In fact, you can run calibration in each mode, and the two phases (along with the rest of the sampling parameters) are indeed serialized, stored, and restored separately and correctly to/from disk when you save. But, when the mode switches, the appropriate sampling phase does not appear to be put into effect. Opening and closing the OSD (without actually making any changes) fixes the issue.

Since the machine boots up into a 14MHz video mode, if you're booting into GS/OS, then the display goes wobbly until you frob the menu button so that the 16MHz sampling phase is picked up.

Any chance this could be applied automatically?

IanSB, 2022-04-14:
It should be applied automatically so it's likely a bug. The main problem is that I don't have an Apple IIGs myself which makes it difficult to track down such issues. Do you have a USB to TTL serial adapter as that might be useful to monitor the debug messages on the Pi serial port. (You can also view the log using the save log option but it is sometimes better to monitor it live at the time the mode changes)

The Vsync signal is connected to 'Flip 6' which is an address bit invert signal that can be used to infer if 14 or 16 Mhz modes are in use and maybe that detection has been broken in some way.

Can you try Beta33 - Beta40 as that was the time that IIGS support was added and tweaked
If some or all of those versions work then by progressing through the versions to the current release you might be able to find when it got broken. (If the early versions don't work either then maybe it never worked properly or on on some board revisions)

NOTE you will have downgrade the firmware to V9.3 on at least some of the above in order to run them.

https://github.com/IanSB/RGBtoHDMI/releases?page=3
https://github.com/IanSB/RGBtoHDMI/releases?page=2

rharke, 2022-04-14:
I do have a serial adapter, yes. I'll try to give it some testing - I do feel like this worked on an earlier version but I could be wrong. I built a little board to capture all the right signals, which I'm pretty sure worked without any issues when I originally tested it last year. I believe I compiled from source at that point in time so perhaps something changed.

Fair warning that I may not be able to do the testing quickly as I have a number of things on my plate right now but I will keep you posted.

IanSB, 2022-04-24:
@rharke

I think I found and fixed the problem but can't fully test it so can you test beta54:
https://github.com/IanSB/RGBtoHDMI/releases

rharke, 2022-04-25:
Thanks! I can confirm that beta 54 fixes the issue (tested 53 and 54, 53 doesn't switch automatically, 54 works fine)

Closed 2022-12-20.

Thread 290 (2022-05-10):

RP2040 a good candidate for cheaper version?

raszpl, 2022-05-10:
https://github.com/Wren6991/picodvi
480p60 and 720p30 possible with ~half the resources utilized, additionally deterministic PIO state machines mean there is no longer any need for CPLD.

IanSB, 2022-05-12:
I have already looked at that project and it is interesting as it may well be possible to implement a cut down version of RGBtoHDMI on it. However one of the main attractions of RGBtoHDMI is the integer scaling which requires a high resolution output matching the LCD's native resolution and the Pico can only support 640x480@60Hz so would have to rely on interpolated scaling in the monitor. Also 50Hz computers might be a problem as 640x480@50Hz is usually too low for most monitors to lock to so the next highest resolution would have to be used which is 720x576@50Hz and that has a higher pixel clock (27Mhz vs 25Mhz) so that might not work either.

hoglet67, 2022-05-12:
The other issue is memory: the PICO only has 256KB (ish) of RAM and a 640x480 8-bit frame buffer needs 300KB.

The PICO DVI project supports 720p, but only has a QVGA (320x240) frame buffer.

So you would have to either reduce the bit depth stored, or dispense eith the frame buffer and "chase the beam", which is only possible in certain circumstances.

It's a lot of work for something that's ultimately much more limited than the current platform.

bzuidgeest, 2023-03-24:
What you are talking about is already being done
https://sites.google.com/view/lorentek-rgb2hdmi/home
It has its limitations but it works and is indeed based on work from wren6991. The firmware is not open-source yet, but the author recently mailed me he plans to open it up around august after presenting it on some convention

IanSB, 2023-03-29:
@bzuidgeest
>It has its limitations but it works and is indeed based on work from wren6991.

Thanks for the link. Looking at the specifications on the site it does seem to have the sort of limitations we pointed out above (i.e. not enough memory for a full size frame buffer, limited HDMI resolutions so not much scope for integer scaling etc) but it is an interesting project and maybe I will contribute if it is open sourced.  It also appears to use a fixed frequency HDMI output (60Hz) which likely means no genlocking so any video is going to have judder (frame drops or repeats) and tears on any motion especially from 50Hz sources.
Genlocking the Pico is very difficult because the Pico's internal phase locked loops have very coarse adjustment so you can't make the small frequency adjustments necessary to accurately track the incoming video signal. (That might also makes sampling digital video like CGA directly by the Pico without any external hardware equally difficult as the sampling PLL might not be able to be adjusted with enough precision)

bzuidgeest, 2023-03-30:
Personally I was looking at it because of the fact that giving some of the more vintage consoles like the videopac/odysee2 en the pong stuff a full pi to digitize the video to display on hdmi only tv is a little insane. Somthing cost effective like the zero feels more acceptable to me. Upscaling to 4K makes no sense in those cases. Just getting a progressive signal would be enough for me. Cerntainly for the two times I feel nostalgic. (I could use a single rgbtohdmi and analogue swithers, but that also feels clunky)

The videopac is ttl-rgb i believe. So I hoped I could strip out everything but the conversion and get a real small dedicated solution, that is easy to reproduce by getting a rp2040 base board and programming it. No fpga's, no cpld's, no dacs. I don't care in that case if timing is a little wonky, the RF signal is worse.

raszpl, 2023-03-30:
> Genlocking the Pico is very difficult because the Pico's internal phase locked loops have very coarse adjustment

Would massively oversampling help? PIO/Pico wont have problem sampling at 160MHz and figuring out phase in software.

Another option mighty be reusing whatever is generating video clock in the computer to directly clock RP2040 (max clock input 50MHz).

How capturing video was done back in the day: 1995 Snappy Video Snapshot, afaik designed by one of NewTek engineers (Video Toaster) after Paul Montgomery left and founded Play inc (https://en.wikipedia.org/wiki/Paul_Montgomery#Play_Inc.)

https://www.youtube.com/watch?v=CwzDjR-Vcyw
https://mobile.twitter.com/TubeTimeUS/status/1301991371947925504
reverse engineered diagram https://mobile.twitter.com/TubeTimeUS/status/1302704667143544833

Amiga flickerfixers also used field memories https://gitlab.com/MHeinrichs/multifix-aga

IanSB, 2023-03-31:
@raszpl
> Would massively oversampling help? PIO/Pico wont have problem sampling at 160MHz and figuring out phase in software.

The current Pi zero also does massive oversampling in order to find the centre of each pixel but it still requires an accurate lock.
Using  a non synchronous oversampling clock probably even higher than 160Mhz might work but the phase is going to vary across each line and be different on every line so keeping track of the fractional variations might be difficult.

> Another option mighty be reusing whatever is generating video clock in the computer to directly clock RP2040 (max clock input 50MHz).

That would likely work for systems where signals have to be picked up internally anyway but not much use as a general solution.

> How capturing video was done back in the day: 1995 Snappy Video Snapshot, afaik designed by one of NewTek engineers (Video Toaster) after Paul Montgomery left and founded Play inc (https://en.wikipedia.org/wiki/Paul_Montgomery#Play_Inc.)

I designed a slow scan video digitiser something like that back in 1983 for the BBC micro, see here:
https://www.beebmaster.co.uk/CheeseWedges/VideoDig.html

... and used it to make this demo back in 1984:
https://www.youtube.com/watch?v=5fDHjmke2sU

(Not my web page or youtube upload - looks like the flag one got corrupted)

I will probably have another play with the Pico after finishing the current RGBtoHDMI development cycle (mainly improved CGA artifact decoding on the Pi zero which only works on multicore Pi models like the zero 2W at the moment)

raszpl, 2023-03-31:
How about clocking rp2040 with Si5351A? $2 in small quantities, $5 whole dev board. Available for cheap manufacturing at jlcpcb https://jlcpcb.com/parts/componentSearch?searchTxt=SI5351A same as $1 rp2040.

raszpl, 2023-05-22:
"working" example https://blog.qiqitori.com/2022/09/raspberry-pi-pico-15-6-khz-analog-rgb-to-vga-adapter-part-1-poc-wip/

Thread 292 (2022-06-05):

Amiga 500 -colors are displayed incorrectly | black is dark red

sascha70, 2022-06-05:
Hello community,

unfortunately a bug is driving me crazy with the Amiga 500.

Unfortunately, the colors are displayed somewhat incorrectly for me. What should be black is dark red. I used the Beta54 version from JanBeta and the version from main tree 20211224_c97f06a release. All have the same problem. The adapter is from LinuxJedi (https://github.com/LinuxJedi/AmigaRGBtoHDMI/tree/main/Amiga500CPLD).

Do you have a solution?

Thanks

sasch
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
a

abrugsch, 2022-06-05:
Who built it as that looks like one of the data lines isn't soldered
correctly on the CPLD. It might just need a re-flow. I doubt it's a
firmware bug as when I've built these, a slight colour shift usually means
one pin hasn't made a proper joint.

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

sascha70, 2022-06-05:
Thank you for your tip. It is indeed the connector of the Pi Zero!

With a Pi 3 A+ it works wonderfully.

Greetings

Sascha

Closed 2022-12-20.

Thread 297 (2022-07-23):

Raspberry PI Zero V1.2

jarek090, 2022-07-23:
Hello ,
I have raspberry PI Zero V1.2 (2015 year). Any chance to run on it ? Right now I have black screen and it seems it is not loading. ACT diode not blinking.
Thank you!
Jarek

EDIT:
It works...
For someone who is facing issue:

Raspberry Pi Zero Ver 1.2 (2015) works fine.

I had HDMI connected to amplituner which does not support 50Hz refresh rate.
Connecting directly to monitor or setting 60Hz output in OSD config menu solves issue.

Thank you for real good nice project ! Image is saturated and sharp !

abrugsch, 2022-07-23:
That's the exact one that's perfect for RGBtoHDMI.
Have you checked:
* That it works with a regular Pi OS Sdcard
* That it is connected to the the interface board properly
* That there are no soldering issues on the interface board (where did you
get it/did you build it yourself/what computer is it for?)

Soldering issues in particular cause the stated problem as if the pi
doesn't see a valid sync signal, it won't initiate the boot sequence and
appear 'dead'

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

Closed 2022-12-20.

Thread 303 (2022-11-30):

Selling assembled boards

lazaj, 2022-11-30:
Hello,

It's not an issue, but it can be interesting for others, so I post it here.

I have build some 12 bit boards, I saw that some people sell them (link on wiki) but senders are not in my country.
I want to know if I can sell these boards on my Tindie shop ?

Best regards.

64rulez, 2022-12-01:
Hi, I've tried to buy 2 of them today (one TTL bundle and one Atari/Amiga bundle) from the link on the wiki (SellMyRetro) but, unfortunately, the order was cancelled as I did not went to check my mail sufficiently fast. The seller don't show any more on SellMyRetro (and I don't know/understand why - it's my first use of this place).

Definitely, I'm interested .... At least, for a pair of 12 bits boards and, if possible, TTL board.

Regards - Hervé

IanSB, 2022-12-01:
@64rulez
>I've tried to buy 2 of them today (one TTL bundle and one Atari/Amiga bundle) from the link on the wiki (SellMyRetro) but, unfortunately, the order was (automatically ?) cancelled as I did not went to check my mail sufficiently fast. The seller don't show any more on SellMyRetro (and I don't know/understand why - it's my first use of this place).

I don't know why your order was cancelled but all items are showing as available when I checked just now.

lazaj, 2022-12-02:
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

I know that they ship to France but from Great Britain but since Brexit shipping to EU from GB is fu**ng expensive and taxes amounts are random. A lot of retrocomputers fan in EU doesn't buy goods from GB anymore because of Brexit.
This is why I want to sell my boards.
I'am a senior electronic et embedded software engineer, my board are tested and are premium quality.

So I change my question :

Am I breaking the license by selling my cards on Tindie (regarding license files I'm shure I don't ?

lazaj, 2022-12-02:
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

@64rulez I will let you know where to buy it

IanSB, 2022-12-04:
@lazaj
>I know that they ship to France but from Great Britain since Brexit shipping to EU from GB is fu**ng expensive and taxes amounts are random. A lot of retrocomputers fans in EU doesn't buy goods from GB anymore because of Brexit.

That was certainly the case in the first 6 months or so but I understand the EU implemented the same VAT rules for selling platforms as the UK in the middle of last year so now when you buy something from a major selling platform like ebay, the VAT rate of the buyer's country is included in the final selling price and there shouldn't be any further tax charges or large handling fees payable on delivery:
https://pages.ebay.com/vat-eu/

If you only want to sell a few extra boards you have already built I guess that doesn't matter so much but if you want to do it on an ongoing basis then you may harm the project because it has progressed way beyond it's original purpose and become very expensive to maintain and add support (buying additional retro computers, getting prototypes of new interfaces made etc.) and the donations I get from the supported sellers help to pay for that.

BTW the boards from those sellers are actually improved designs with additional features such as protection components and increased analog bandwidth.

64rulez, 2022-12-10:
... As an update, I've finally managed to buy my pair of boards from the official UK seller (that had banned me by mistake in my first attempt). As of now :
- I've been able to buy "official" boards at a "normal" price
- I have no idea about VAT at arrival (bad, but it's the game)
- So far, Royal Mail tracking says that they've got the packet and that it's supposed to go to France (nice) but no more update since one week. May be strikes or whatever, I just cross fingers. Getting items from UK was (and is still) always a kind of russian roulette

Closed 2022-12-20.

Thread 305 (2022-12-19):

12-Bit Extender on Rev. 3 CPLD board

c0pperdragon, 2022-12-19:
I want to use my Issue 3 CPLD board to create an external upscaler for the Amiga. The obivious solution would be to use the 12-Bit extender board that would fit to an Issue 4 CPLD board.  As I don't have this board, I would just add the missing pin-socket to my Issue 3 board and wire up 4.7K resistors from the signals to GND.
The necessary holes for the headers seem to be already available on my board, even if they seem to have served a different purpose (JTAG programming) then.

So the question is of course,: Would there be any issue with this?
I would just fit a 5 pin socket to the holes (4 signals, 1 GND), an use 4 SMD resistors and some wire for the termination.
The extender board itself, I would try to simply etch myself.

IanSB, 2022-12-20:
@c0pperdragon

As you noticed, the issue 3 board doesn't support the 12 bit board and the extra holes on that board are for an external JTAG reprogramming header which was removed on the issue 4 board to add support for the 12 bit extender board but it would be technically possible to modify the issue 3 board.

You would have to cut the tracks to pins 3-6 of the JTAG header to free up those holes and fit a 4 way socket.  Then cut the existing tracks to pins 18, 21, 40 & 42 of the CPLD (B0, R0, G1, G0).  Finally wire those CPLD pins to the appropriate pins on the JTAG header.  (Some of the connections to the CPLD pins were used by earlier firmware but are not used by later firmware so the tracks can be cut and the signals re-allocated.)

You can wire the 12 bit pickup directly to the Amiga but it would be preferable to use the external Amiga pickup board which is here:
http://github.com/hoglet67/RGBtoHDMI/tree/master/Kicad_Amiga_12Bit_Buffered_Pickup/V1

You can actually fit both your internal board and the external pickup board at the same time (which I do for software testing):
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

Closed 2023-02-15.

Thread 309 (2023-02-15):

Combined analog/digital board?

c0pperdragon, 2023-02-15:
Would it be feasible to make a board that has a 16-pin digital connector as well as all the circuity of the analog board? With a little slider switch on the end where the SD card is (to be accessible through the hole in the case). This board would then behave either like the analog board, or like a simple 12-bit extender board. The input signals R3, G3, B3 would then be treated accordingly.
Combining both data paths could be done with some MUXes (the 74AHCT257 comes to mind). These MUXes would also act as a protection for the CPLD.
Using this board, a single RGBtoHDMI device (Raspberry Pi + CPLD board + analog/digital board) would then be usable for all supported machines, without the need to disassemble the RGBtoHDMI.  Legacy cables could be attached with adapters (12 pin to 16 pin, 6 pin to 16 pin).

IanSB, 2023-02-18:
@c0pperdragon
>Would it be feasible to make a board that has a 16-pin digital connector as well as all the circuity of the analog board?
The input signals R3, G3, B3 would then be treated accordingly.
Combining both data paths could be done with some MUXes (the 74AHCT257 comes to mind).

There is a potential issue::
The system is very sensitive to unequal propagation delays because the sampling position is set at multiples of the pixel clock so all 14 video and sync signals would have to be routed through switches rather than just the 10 on the main header to ensure they were co-timed and that would increase the number of ICs and resulting complexity of the pcb layout.
Also there might be a similar issue at the front end:
You could either switch the pins shared between analog and digital inputs which would introduce a similar delay problem or connect those pins to both the analog and digital inputs simultaneously which might inject digital noise into the analog inputs when used unterminated in analog mode or the capacitive loading of the analog circuitry might have an effect on propagation delay for those inputs when used in digital mode.
I don't think it would be possible to get four of the above switching packages and pulldown resistors onto the underside of the board as clearance is limited but even if it was possible using a 4 or 6 layer board that still doesn't address the shared inputs.

As the converters were originally pretty cheap to build with Pi zeros costing £5 and CPLDs about £3, the idea was to build one for each required interface rather than continually swapping boards.
In my case, I am currently running 25 RGBtoHDMI converters simultaneously which are a mixture of Digital, Analog and PC connected to 25 computers and 14 monitors with 2 inputs each and that does allow me to test release versions quite quickly on a variety of configurations. (This project is getting quite expensive to maintain!)

Of course at the moment with CPLDs at £10+ and Pi zeros going for £30 on ebay things are no longer as cheap and I have been thinking about a universal solution but more along the lines of a larger single board and that might be more attractive now although it does look like supply issues are beginning to improve and I think raspberry Pi have indicated that availability should be much better in the next 3-4 months.

Closed 2023-08-03.

Thread 317 (2023-03-13):

No good CPLD programming

LejonD, 2023-03-13:
I got a RGBtoHDMI for the Amiga CDTV and it starts ok with the CPLD boot screen (empty CPLD).
But when i program it with the menu (Pi Zero 2) then the named file is different than the selected file.
Im trying to program the 6-12_BIT_RGB-CPLD_v94.
and im getting the 3-12_BIT-BBC_v94.

What could be the problem?

[Log.txt](https://github.com/hoglet67/RGBtoHDMI/files/10962116/Log.txt)
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

IanSB, 2023-03-14:
@LejonD
There is a 12 bit bus (Q00 - Q11) that passes video data from the CPLD to the Pi and it also transfers the CPLD type number and version number.
The version number is correct for the RGB CPLD but the type number is incorrect so it mistaking the RGB CPLD for the BBC CPLD

The type numbers are:
BBC 0x0XX
RGB 0x4XX

So it is likely that Q10 on the 12 bit bus is faulty in some way as it is stuck low. This is connected as follows:
Pin 3 of the CPLD to Pin 32 of the 40 way GPIO connector so check for continuity or shorts in that area (pin 4 of the CPLD is GND so it could be shorted to that)
Also it might be an intermittent contact on the 40 way header
Finally it could be a faulty GPIO pin on the Pi itself so if everything else looks OK then try another Pi if you have one.

This will also appear as one of the video bits stuck at zero.

LejonD, 2023-03-14:
Hello IanSB,

I did an resolder of the CPLD and a full continuity check of all the pins.
I don’t measure strange shorts or disconnected lines.
Pin 3 is connected to pin 32 on the GPIO connector. Also checked that it is connected to the Pi. Looks like all is ok. Cant check the pi because its to small.
But every thing else works, but it will not program the CPLD with the RGB version.
Will see that a neighbour has a spare Pi Zero2.

Is there a way to monitor what is happening?

IanSB, 2023-03-14:
@LejonD
It's also possible that the CPLD itself is faulty and pin 3 is dead.
Try measuring the resistance to ground of pin 32 both on the CPLD board and the Pi (after separating them). It should be in the megaohms range. If it is a low value in the tens or hundreds of ohms range that indicates a failed pin.
If you have an oscilloscope or logic probe you could check to see if there is any activity on pin 32 during bootup.

I managed to reproduce your problem by temporarily shorting pin 32 to ground with a 5.6 ohm resistor which seems to confirm my theory.  The CPLD has RGB v9.4 programmed into it but when shorted and rebooted it reads as BBC v9.4 like yours:

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

(The video is messed up because the software is trying to control the RGB CPLD using the BBC driver).

>Is there a way to monitor what is happening?

There is a debug serial port that outputs the log at 115200 baud 8 data bits no parity.
Connect the RX input of a USB to TTL serial adaptor to the pins on the header marked Gnd and TxD

What happens when you try to reprogram? Does it show an error or complete the programming and reboot?
As far as I can tell it is running the RGB CPLD because the version number is read back from the CPLD and that is displayed as 9.4.
If one of the other CPLDs was programmed the version number would show as 7.9 or 9.1 and it would take a lot of wrong bits to misread that which is why I think it's a problem with reading the bit on pin 32.

This is what the log output should look like when reprogramming:

```
Read xsvf file /cpld_firmware/6-12_bit/6-12_BIT_RGB_CPLD_v94.xsvf (length = 53373)
Programming....
CPLD programming: JTAG command = 0xfe (IDCODE)
CPLD programming: JTAG command = 0xff (BYPASS)
CPLD programming: JTAG command = 0xe8 (ISPEN)
CPLD programming: JTAG command = 0xec (UNKNOWN)
CPLD programming: JTAG command = 0xed (FBULK)
CPLD programming: JTAG command = 0xf0 (CONLD)
CPLD programming: JTAG command = 0xf0 (CONLD)
CPLD programming: JTAG command = 0xff (BYPASS)
CPLD programming: JTAG command = 0xfe (IDCODE)
CPLD programming: JTAG command = 0xff (BYPASS)
CPLD programming: JTAG command = 0xe8 (ISPEN)
CPLD programming: JTAG command = 0xea (FPGM)
CPLD programming: JTAG command = 0xf0 (CONLD)
CPLD programming: JTAG command = 0xe8 (ISPEN)
CPLD programming: JTAG command = 0xe8 (ISPEN)
CPLD programming: JTAG command = 0xee (FVFY)
CPLD programming: JTAG command = 0xe8 (ISPEN)
CPLD programming: JTAG command = 0xff (BYPASS)
CPLD programming: JTAG command = 0xf0 (CONLD)
CPLD programming: JTAG command = 0xff (BYPASS)
SUCCESS - Completed XSVF execution.
Successful, rebooting in 5 secs
Successful, rebooting in 4 secs
Successful, rebooting in 3 secs
Successful, rebooting in 2 secs
Successful, rebooting in 1 secs
```

Thread 320 (2023-03-24):

Palette for Apple ][ wrong?

JPT77, 2023-03-24:
Hi,

RGBtoHDMI works fine with my Apple II, except for the color palette.

calibrating the two color pots at J14 and F14 only made the R2H lose sync, it did not change the color at all.
So, I was able to remove a little noise but not fixing the colors.

see screenshot:
https://mega.nz/file/SNhmmAiJ#byOo3IAM_FqQixnz0xiefSuFsWKIq_Tz501ee_x1Rcg

do you have any idea what could be the problem?

btw, there is no difference if I use PAL or NTSC quartz. Either way R2H detects 60 Hz input.

thanks

timmcross, 2023-03-24:
I have an Apple II Plus I would like to connect to a RGB2HDMI.  Is this a II+ or a IIe?  I already have several IIe's outfitted with this device.  I just can't find the cable diagram for a II+.

JPT77, 2023-03-24:
It's an Apple IIeuroplus which is a II+ except b/w PAL. I modified it to NTSC, so I get a colored image.
Cable diagram?
https://github.com/hoglet67/RGBtoHDMI/wiki/Cables
it's just pin 4 Video, everything else GND.

IanSB, 2023-03-24:
@JPT77

You have to set the chroma phase quadrant (one of four possible options will be correct for your hardware).

Either:
Press SW3 to cycle through the four phase quadrants
or
Change the Artifact Phase in the palette menu

Save your configuration when complete

JPT77, 2023-05-10:
Works fine, thanks.

Closed 2023-05-10.

Thread 321 (2023-03-27):

Support for older Analog boards?

hoglet67, 2023-03-27:
Hi Ian,

I have a couple of V2 analog boards that I would like to bring back into use.

I'm currently testing with an RGBtoHDMI issue 2, the BBC CPLD v7.9, the BBC Profile and the latest Beta56.

I've hit a couple of issues.

**Issue 1: The analog board is incorrectly detected as a V3 board this can't be changed manually.**

Looking at the code, it seems that it's not possible to differentiate between the following boards:
```
   FRONTEND_ANALOG_ISSUE3_5259
   FRONTEND_ANALOG_ISSUE2_5259
   FRONTEND_ANALOG_ISSUE1_UA1
   FRONTEND_ANALOG_ISSUE1_UB1
```
That's fine, except there is no longer a way to manually set the interface, because the interface setting is now hidden due to:
```
 HIDE_INTERFACE_SETTING
```
Would it be possible to decide at run time whether to hide the interface setting, based for example on whether the frontend info returns a range of possible interfaces?

For now, I've commented HIDE_INTERFACE_SETTING in defs.h so I can continue testing.

**Issue 2: The green clamping is not working on the V2 Analog board with the latest BBC CPLD**

What's happening is the CLAMP signal on pin 4 of the P2 connector is always ow:
```
        clamp_int <= not(csync1 or csync2) and sp_data;
        analog <= 'Z' when version = '0' else clamp_int;
```
In this case it's sp_data (GPIO0) that low.

Looking a cpld_rgb.c I think this is happening because of the supports_bbc_9_12 flag.
```
          switch(config->rate) {
                      default:
              case RGB_RATE_3:
              case RGB_RATE_6:
                    if (supports_bbc_9_12) {
                        RPI_SetGpioValue(SP_DATA_PIN, 0);   //no ac coupling
                    } else {
                        RPI_SetGpioValue(SP_DATA_PIN, coupling);
                    }
                    break;
```
So it looks like V 7.8 of the BBC CPLD uses SP_DATA to enable 9/12 bit capture modes rather than controlling AC Coupling?

Is this all expected?

I've got a couple of workarounds:

- Revert to a version of the BBC CPLD older than 7.8
- Switch to the RGB CPLD and use the Electron profile (as the BBC profiles are not present)

What's the main use case for the 9 and 12 bit modes with the BBC CPLD? VideoNuLA?

Dave

IanSB, 2023-03-28:
@hoglet67

As mentioned above, if you add the following to the bottom of config.txt replacing any existing #interface values, that should permanently set the configuration to an Issue 2 board on a standard software install and it should show in the system summary menu as issue 2.
(Interface_3 is YUV and Interface_C is BBC / RGB)

#interface_3=12
#interface_C=6

(The numbers might change if any further interface designs are added)

IanSB, 2023-03-28:
>What's the reason the clamp output of the CPLD needs to be enabled/disabled under software control? What would break if it were enabled all the time?

On the issue 3 boards the clamp is permanently connected to the video path via C1 irrespective of the setting of the AC/DC switch U6 and I recall it introduced a noticeable disturbance in the DC level of the green/Y channel when DC coupled if the source was high impedance.

Thread 327 (2023-05-31):

Support of Amiga 50 Hz ECS clock frequencies?

mutedsounds, 2023-05-31:
Can the RGBtoHDMI support the Amiga ECS Super High-Res modes, 1280x256 and 1280x512 ?

According to this thread [https://eab.abime.net/showpost.php?p=1251298&postcount=13](https://eab.abime.net/showpost.php?p=1251298&postcount=13), the ECS Super High-Res pixel clock frequency is doubled, to 28375160 Hz.

Creating a new profile derived from the Amiga_2000_50Hz.txt profile, doubling the clock frequency and setting the clock multiplier to x6 doesn't seem to be sufficient to get a stable image using auto-calibration. Did anyone succeed to define working settings to support the Super High-Res modes?

IanSB, 2023-06-01:
@mutedsounds
>Can the RGBtoHDMI support the Amiga ECS Super High-Res modes, 1280x256 and 1280x512 ?

In theory it should be able to support higher resolutions like that and 640x480 but only with CPLD based hardware (not the c0pperdragon style board) and then only at 6 bits per pixel or less rather than the 12 bits per pixel of of 640x256 / 640x512 interlaced.
I don't have any ECS type hardware myself so I've never been able to test it but if someone with suitable hardware and a CPLD based RGBtoHDMI wants to do some tests,  I could create a few profiles to try.

IanSB, 2023-06-02:
@mutedsounds

Here is an experimental profile:

[Amiga_1280-test-v1.zip](https://github.com/hoglet67/RGBtoHDMI/files/11636266/Amiga_1280-test-v1.zip)

Unzip and put the Amiga_2000-1280 profile in the /Profiles/6-12_BIT_RGB/Commodore folder (Assuming latest stable release which has a new folder structure)
Then select the Amiga_2000-1280 profile from the select profile menu.

You will probably have to adjust the h offset in geometry and h pixel offset in sampling to get horizontal alignment especially if using a 1280x1024 monitor.

If the screen flashes then there is something wrong with the timing.
Post the source summary page and also read the Help flashing screen page in the info menu.

mutedsounds, 2023-06-02:
@IanSB Impressive. It is stable. Thanks a lot.
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

At this resolution, is it possible to raise the number of bits per pixel to 12?
Or is there a way to avoid manually changing the profiles when an app lowers the width to 320 or 640?

IanSB, 2023-06-02:
@mutedsounds
>At this resolution, is it possible to raise the number of bits per pixel to 12?

No, the max clock for 12bpp is around 16Mhz, (32Mhz for 6bpp, 64Mhz for 3bpp etc.)

>Or is there a way to avoid manually changing the profiles when an app lowers the width to 320 or 640?

As the 320/640 modes have the same sync timing as the 1280 modes there is no easy way to auto detect and switch between them but there is an option to make manual switching a little easier:
In general any profile can have two timing sets and this is used with some systems like the BBC micro (where modes0-6 and mode7 use different clocks) and Apple IIGS (there are 16Mhz and 14Mhz modes) but there are ways to auto detect and switch between those sets.
However there is also a manual mode where pressing SW3 toggles between the two timing sets and I have enabled that with this profile:

[Amiga_1280-test-v2.zip](https://github.com/hoglet67/RGBtoHDMI/files/11639639/Amiga_1280-test-v2.zip)

Set1 = 1280 modes
Set2 = 320/640 modes

Press SW3 to toggle

If you can vary the timing for the 1280 modes e.g. by changing the number of lines per frame by a couple of lines or changing the number of clock cycles per line then it should be possible to auto detect them as the timing will then be different between the standard 320/640 modes and the modified 1280 mode.

It would probably be useful to add the 640x480 mode as well so can you switch to that mode and post the source summary page for that.

mutedsounds, 2023-06-03:
@IanSB You will find attached some preliminary settings I found to view the ECS Productivity 640x480 @ 60 Hz using the 1280 mode. These may not be the optimal settings.
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
However there is an unexpected artefact on a line (this artefact doesn't appear when using OSSC):
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

IanSB, 2023-06-04:
@mutedsounds

I think the glitch is some sort of memory bandwidth contention between the screen DMA and the capture code. I have seen a similar but less significant glitch with the 1280 modes. This is likely because of the higher bandwidth of the 28Mhz pixel clock.
I will have to investigate this but in the meantime you can try varying the following in the settings menu to see if it helps:
Changing the Genlock Line may move the glitch up or down and possibly off screen.
Changing the overclock settings may eliminate or reduce it.

mutedsounds, 2023-06-04:
@IanSB I confirm.
Changing the Genlock Lines moves the glitched line up or down.
Setting the CPU overclock to 100 makes the glitch disappear (at 90 the glitched line is still there).

IanSB, 2023-06-04:
@mutedsounds

It looks like it is caused by the start of video display DMA which due to the ~3.6ms latency affects capture of a line part way down the screen.
Does changing any of the other overclock settings have an effect (i.e. Core or SDRAM) or any combination that results in a lower CPU overclock?

I will see if it is possible to fix this without the overclock but at least that is available as a workaround.

BTW I don't think this glitch would occur with a Pi zero 2W or Pi 3 as they have much higher overall system bandwidth.

IanSB, 2023-07-13:
@mutedsounds

Can you try the Alpha 59E release here:
https://github.com/IanSB/RGBtoHDMI/issues/18#issuecomment-1634837666

This has some changes to the Amiga 2000 profiles that might eliminate the glitches without overclocking.

IanSB, 2023-08-02:
@mutedsounds

The latest beta now has ECS support:
https://github.com/IanSB/RGBtoHDMI/releases

Additional info:
This supports PAL 1280x256 and NTSC 1280x200) plus the 640x480 productivity mode as well as the standard 640 pixel modes.
(Also includes the interlaced variants of those modes)

The 1280 pixel modes only support 6bpp rather than 12bpp used in the 640 pixel modes but from the info I have seen online, the ECS chipset is limited to that in 1280 modes anyway.
Unfortunately it is not possible to auto detect between 640 and 1280 pixel modes so you have to manually select the right timing set using SW3 or the menu option (640x480 should be auto detected)
Set1 = 640 pixel modes
Set2 = 1280 pixel modes

mutedsounds, 2023-12-02:
Hi @IanSB
I apologize for my late reply. I missed the notification from GitHub. The new modes work fine. Thank you very much for your support.
I could get a Pi Zero 2W. Do you know if it is possible to increase the sample rate to 12bpp in 1280 mode with a Pi Zero 2W?

IanSB, 2023-12-02:
@mutedsounds
>I could get a Pi Zero 2W. Do you know if it is possible to increase the sample rate to 12bpp in 1280 mode with a Pi Zero 2W?

No, The GPIOs on all the Pi models are limited to about the same max frequency which is around 16 Mhz @12bpp and 1280 would require around 28Mhz

You can switch between Set1/ Set2 using a voltage level on the unused Vsync input by setting Auto Switch to "Sub + Vsync" rather than "Sub + Manual" (assuming composite sync is used for the actual video signal) so if you can find or generate such a voltage level on a spare output port with a software driver in the Amiga that changed state between 640 and 1280 modes you could get fully automatic switching.

mutedsounds, 2023-12-04:
@IanSB Thanks a lot for your explanation. I was in hope the GPIO rate was improved enough in the Zero 2W.

I don't know if that is actually doable with the CPLD : could there be a way to both edges of the PiCLK, sampling on the rising edge and on the falling edge using parallel processes in the vhdl code, providing 2x12 bits on the Pi side through the remaining unused GPIO ports (0,1,14,15;19,20,21,22;24,25,26,27)?

Thread 328 (2023-06-10):

How to switch between different saved configs?

quadrupedal, 2023-06-10:
How can I have two or more saved configs and easily switch between them?

I can see the "Saved Config" option in the menu, and can change that to "Alt 1" then make changes before saving the configuration, but those settings seem to be applied to all the configs. Changing to a different saved configuration doesn't give me the changes I've made.

My use case is that I have a monitor that can do 1600x1200 at 60Hz only, but will do 50Hz at 800x600, so I thought I would make a "productivity" config with the slightly nicer higher resolution, and a "gaming" config of the lower resolution (scaled up again by the monitor) but at 50Hz for smoothness.

Is this possible?

If it is, is there a way to switch between configs without going through the menu? Basically, once everything is set up, I'd like to use a single button to switch between modes and never see the menu again.

Thanks!

quadrupedal, 2023-06-13:
Ok, thanks. Could we make this a feature request? I'm sure the same issue would affect people who have different monitors, projectors, etc. that they want to switch between without opening up their computer.

In the meantime I'll look into SD card switchers. If one will physically fit then I use that as a workaround, even though having to power down makes it less than ideal.

The monitor in question is a Philips 200P4 (200P4MG/ 00 to be exact), https://www.p4c.philips.com/files/2/200p4mg_00/200p4mg_00_pss_.pdf, which I'm running through a mini HMDI to DVI-D cable. The manual states 800x600@56Hz, but it will go down to 50 in that mode. In 1600x1200 mode it displays a "Cannot display this video mode" error when you do the 50Hz test. It feels like it could do it if it wanted, but someone decided not to let it.

IanSB, 2023-06-13:
@quadrupedal
>Could we make this a feature request?

OK if I can think of an easy way of implementing such a feature.

>The manual states 800x600@56Hz, but it will go down to 50 in that mode. In 1600x1200 mode it displays a "Cannot display this video mode" error when you do the 50Hz test. It feels like it could do it if it wanted, but someone decided not to let it.

Yes, it's a shame more older monitors don't support 50Hz as there is usually no technical reason for such a limitation. One 1600x1200 monitor that fully supports 50Hz with smooth motion is the HP LP2065. There is also the Dell 2007FP from the same era which does display 50hz sources but it does that by doing an internal 50hz to 60Hz conversion so you end up with judder just the same as using 60Hz directly so it is essentially useless for smooth motion etc.

Newer monitors are generally better at supporting 50Hz because they usually support 50Hz HD resolutions but even that isn't guaranteed to work.

Thread 329 (2023-06-17):

Apple IIe Taxan RGB Aux slot video

timmcross, 2023-06-17:
Hello, still loving this product.  I have built so many of these for my retro computers.

My latest is a Taxan RGB adapter for the Apple IIe.  I believe it does TTL 3-bit color with composite sync.  When I connected it to the RGB2HDMI, the screen was rolling on the CGA profile.  I connected the CSYNC to the HSYNC pin.  I found a stable image using the Acorn Atom profile.  The colors are close and I assume they won't be correct since there is no intensity bit.

Could a closer profile be created for it?  I took some screenshots and gathered some log files.  Let me know what else would help.
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\
[Taxan RGB.zip](https://github.com/hoglet67/RGBtoHDMI/files/11777765/Taxan.RGB.zip)

IanSB, 2023-06-17:
@timmcross

Looking at the logs, you don't appear to be using the latest stable release which has a changed profile folder structure so I suggest you update to that first
https://github.com/hoglet67/RGBtoHDMI/releases/tag/20230517_eb620884

Then try the following:
[Taxanprofile.zip](https://github.com/hoglet67/RGBtoHDMI/files/11778891/Taxanprofile.zip)

Unzip the above and put in \Profiles\6-12_BIT_RGB\Apple

Use the new select profile menu to select the profile.

This still has the palette set to RGB which has a limit of 8 colours against the 16 of the standard Apple palette so the colour choice will be restricted unless the output is actually analog RGB, not TTL RGB.

With Apple RGBI monitors, the 16 RGBI values were mapped to a different palette set than CGA and that more closely resembled the apple colour palette but I don't have any details on how the Taxan monitor handled that.

There is a Laser 128 profile which follows the Apple RGBI palette

You need to find out some more info on this setup.
i.e:
Is the output TTL or analog?
If it is only 3 bit TTL did the TAXAN monitor map those 8 levels to different on screen colours from the standard 8 RGB values.
(Might have had a switch to change palette)

You could create an alternative palette to map the 8 values to different colours but as the Apple II palette is 16 colours it is always going to be a compromise.

timmcross, 2023-06-18:
Thanks for that!  I setup the new files on a formatted SD card and tried it with the Taxan profile and the Laser128 palette.
Here is a shot of one of the RGB lines, I appears to be TTL to me but let me know.
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

I also found a separate line with activity on the card so I hooked it up as the intensity line.  Here is a color test.  I think this looks correct.
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

The text is green because of a setting on the card.  I think I can set it to amber, blue, or white as well.  Let me know if you want some other logs or screen shots from this setup.  Thanks again!

IanSB, 2023-06-18:
@timmcross

Looks good, I think the correct palette to use should be "RGBI_(XRGB-NTSC)"
XRGB is what Apple called their version of RGBI with the different palette on the Apple III
(The Laser palette is identical anyway but probably better to use the one with the official Apple name)

Do you know if this board works on 50Hz Apple IIe?

If everything looks OK can you run an auto calibration and post your saved profile and I'll include that in the next release.

IanSB, 2023-06-18:
@timmcross

Also post your wiring details for inclusion in the wiki

timmcross, 2023-06-18:
Sorry, all of my IIe's are 60Hz.  Is it possible to do a PAL mod to an Apple IIe (thinking not...).

And for sake of completeness, my card is technically labelled as a Panasonic Video-7 card yet someone on a forum pointed out to me that it is a replica of the Taxan card.  I can't find any documentation on the Panasonic one I have.
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
[Taxan410-80a.pdf](https://github.com/hoglet67/RGBtoHDMI/files/11782103/Taxan410-80a.pdf)

Here is the pinout:

Card   -   RGB2HDMI CGA adap
1     -     1    GND
2     -     4    Green
3     -     8    Comp Sync
5     -     3    Red
9     -     5    Blue
10   -     6    Intensity

After switching to XRGB, here is a screenshot of the color bars.  Seems that it is a little off.
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

IanSB, 2023-06-18:
@timmcross
>After switching to XRGB, here is a screenshot of the color bars. Seems that it is a little off.

Yes, I just realised the colour are mapped differently so stick with the laser palette for now (Although I might rename that to something more generic in future)

I'll include a 50Hz profile in case it does work with such apple IIe variants.

Closed 2023-12-27.

Thread 335 (2023-07-13):

Which version do i need?

U32Frank, 2023-07-13:
I have an older RGB2HDMI board, [this ](https://github.com/c0pperdragon/Amiga-Digital-Video/tree/master/direct_adapter) one.

The latest release just gives me a black screen. Is there a specific version of the software that i need for this board?

IanSB, 2023-07-14:
@U32Frank

The latest stable release should work with the c0pperdragon board, I just tested it again to confirm that.

Is this a new installation?

If so, either the board is faulty or your have an early revision Amiga 500 or 1000 as some of the signals were missing on those early motherboards and had to be manually wired up.
What Amiga model are you using and what motherboard revision?

U32Frank, 2023-07-14:
I have an Amiga 500 6a

IanSB, 2023-07-14:
@U32Frank
>I have an Amiga 500 6a

That should work.

A few other things to try:

If your Amiga is PAL/50Hz, some monitors won't display 50Hz video although you usually get an "out of range" error message on screen.
Holding down the button during power on will force the output to 60Hz. If that works then select the refresh as 60Hz in the menu to set that permanently.
Also test with another TV / monitor if possible.

To test the SD card has been written correctly and the raspberry Pi zero is booting it properly, unplug the Pi from the board and apply power to it via the micro USB power input connector (socket closest to the corner) using a +5v micro USB power supply (phone charger etc).
You should get a menu screen with "CPLD Not Fitted" at the top which will indicate that it is booting correctly.

Make sure that all the pins are aligned on the Pi when plugging it back in to the board as being "off by one" will very likely damage the Pi when power is applied.
Try another Pi if you have one.
There is also a serial debug output available if you have the necessary USB to serial hardware to hook that up.

Thread 342 (2023-10-05):

Latest release does not let me navigate the OSD menu.

HenrikErlandsson, 2023-10-05:
With switch attached to Rpi 2-pin header,

Long press: toggles scanlines.
Single/double-press: toggles menu on/off.

No way to move the cursor.

Also, default is Acorn Electron with NOT RGB over HDMI. Unhelpful to most users.

Also, card contains 3x config.txt none of which correspond to OSD menu settings which users will want to change as soon as they run the software.

HenrikErlandsson, 2023-10-05:
In :Profiles/Default.txt, set

single_button_mode=1

and thank me later.  It's rather mad that it's default 0, or maybe this hardware driver is purely for the emulation crowd and not even for real Acorn users. I have an Acorn Atom and an Acorn Archimedes (sold my Risc PC sadly) which I programmed.

This is open source software. I'm a GitHub user, and I'm a top coder on any system. I can change the default to a sane one, and no-one will have a problem, isn't that right?

For anyone reading this, then set HDMI mode to RGB with the OSD menu (there is no file on the card to do this, certainly not in the mentioned file).

Black is middle gray, but it scrolls at full framerate and the weird default randomcolor pixel edges are gone. It's a start.

Glad to help.

HenrikErlandsson, 2023-10-05:
In the main menu, change the default to RGB Full, not Limited, and in the Palette menu, change to RGB. Middle gray instead of black is gone, poof.

Not sure why the defaults are set away from this. It's great that this project support all the alternatives to just RGBtoSCART, but if RGBtoHDMI should be a solution, it should replace the jack that's not there anymore!

And not be set to a not RGB system as default, and not prevent menu navigation to fix it as default.

So I've complained (that was an annoying experience.)

I'd like to help. So which files do I edit in the repo to make these the default, and release a new version? I want to save time for all fellow computer users.

No menu nav, Acorn Electron, RGB Limited, and not RGB is about the most unhelpful I can think of.

IanSB, 2023-10-07:
@HenrikErlandsson

What hardware are you trying to run this on?
e.g.
standard RGBtoHDMI
c0pperdragon style simple Amiga board (no CPLD)
CPLD based internal Amiga board (linuxjedi style)
etc.

HenrikErlandsson, 2023-10-08:
I'm running a piece of software on the platform it supports. Specifically, RGBtoHDMI on RPi Zero WH.

I complain about really bad software defaults. The current defaults assume 3 things:
1) If you use HDMI, you do not want RGB over HDMI (contrary to the project name). You must change from the default to get it.
2) Everyone who downloads this archive wants as default to connect it to an Acorn Electron. You must change from the default to not get primary colors as first impression.
3) This solution accepts menu navigation by an RPi header pin connected to a switch, and despite the RPi sitting inside an existing computer case with a keyboard, the default is to use this pin to toggle scanlines, and require attaching a second keyboard via microUSB to navigate the menu.

I did not do that. I edited the file mentioned above.

This let me control the menu and set up RGB over HDMI.

My suggestion at the very least is to allow menu control without plugging a keyboard into the RPi, this will fix 3).

But 1) and 2) are also bad defaults. Because of the name of the project.

IanSB, 2023-10-08:
@HenrikErlandsson

>I'm running a piece of software on the platform it supports. Specifically, RGBtoHDMI on RPi Zero WH.

The primary supported platform is the standard external CPLD based RGBtoHDMI board as described in the wiki on this site which has three buttons and the menus are configured to operate with that.

I later added support with one button operation using long and short presses for a couple of internal Amiga configurations designed by others which are:

1. The c0pperdragon non-CPLD design and variants
This board is automatically detected and the software is automatically configured for one button operation with "Amiga" as the default profile.

2. The linux jedi style CPLD based design and variants.
This appears to the software as a standard three button CPLD board so is not autodetected and thus defaults to standard three button operation and Electron profile. (This project was originally created for the Acorn computers so defaults to those systems)
 To aid in configuring this type of board there is a folder on the SD card "Amiga CPLD readme" which contains a set of files that can be copied over the originals to set the default to one button operation with either Amiga or Amiga 2000 as the default profile. See Amiga_Readme.txt in that folder for more details.

I'm not aware of any other hardware variants that require additional support.

>If you use HDMI, you do not want RGB over HDMI (contrary to the project name). You must change from the default to get it.

The default HDMI output is RGB using DVI signalling protocols for backwards compatibility with DVI monitors. In theory that should work with all HDMI monitors but it was discovered that some HDMI devices like capture cards and a few  more recent 4K TVs don't support DVI backwards compatibility and display wrong colours so the HDMI mode setting was added to allow switching to true HDMI signalling and you can select from four different types.

It is not possible to default to true HDMI signalling because you will get no display at all on a DVI monitor so not be able to change the setting. However I am planning to auto detect which type of monitor is connected and switch the signalling automatically in a future update.

IanSB, 2023-10-26:
@HenrikErlandsson
You still haven't mentioned what hardware you are using but from your description I have assumed an Amiga CPLD RGBtoHDMI and a 4K monitor.

>Currently, the default configuration files are made for users of RGBtoHDMI who want to attach a Blu-Ray or something,

The reason that the HDMI mode is set to "DVI Compatible" is so that old 4:3 lcd monitors work, not Blu Ray!
If it had been set to "HDMI RGB" then DVI monitors would not work at all (black screen).

The vast majority of HDMI monitors are compatible with the default DVI setting and display colours correctly.
A tiny minority of monitors like yours don't display the DVI RGB colours correctly so you have to change the setting.
So most users would not have a problem with the default and you are the only one so far to mention this.

However I have now implemented auto detection of the HDMI mode.
When connected to a DVI monitor it selects DVI Compatible
When connected to a HDMI monitor it selects HDMI RGB

So this should solve your monitor problem without affecting users with old DVI monitors.

>and never want to navigate the menu. These must be a vast minority, which is what makes them bad defaults.

The project is designed for the general purpose three button 12bit converter which is used by the vast majority of users so the settings are defaulted for that:
https://raw.githubusercontent.com/wiki/hoglet67/RGBtoHDMI/images/12bit.jpg

The software cannot tell the difference between this board and the single button Amiga CPLD board which is used by a small number of people so it is not possible to auto configure the buttons which is why the "Amiga_CPLD_Readme" update files must be manually copied.
The only other option would be a separate release file just for the Amiga but even that would still need some manual configuration to select between the original Amiga profile with composite sync and the later Amiga 2000 etc with separate sync.

There is an alpha version of the software here (Alpha 61E) if you want to try the auto HDMI mode detection:
(Note this hasn't had much testing yet)

https://github.com/IanSB/RGBtoHDMI/issues/21#issuecomment-1781599238

Please let me know if this fixes your monitor problem.

HenrikErlandsson, 2023-10-28:
4:3 monitors were before HDMI and DVI. Timeline: VGA, DVI, HDMI, DP. 16:9 came during the VGA period, then there were no more 4:3 monitors. If you doubt me, websearch "history of  monitor connection types" and "when did vga switch to 16:9".

DVI over HDMI is for consumer equipment connected to a TV.

Solution is called RGBtoHDMI, so RGB over HDMI is expected as default.

The files I transferred to the card at date of post showed Acorn Electron as default, once I made the menu button work, and I did so without anything Amiga related. It may very well be that my monitor can display DVI over HDMI just fine, but if the default is Acorn Electron this would explain the wrong colors (primary or close to primary colors).

As for single button OSD navigation, the solution is easy. Simply enable the option. If no button present it works as expected and one is, it works as expected instead of defaulting to toggling scanlines.

You repeat the phrase "a few users". So according to the defaults, we're looking for a headcount of Acorn Electron users possessing a 4:3 computer monitor with HDMI, and who wants to toggle scanlines every day, much more than he wants to use the OSD menu. Is there 1 such user in the world?

Thread 348 (2023-10-21):

CPLD programing error TDO

AiGeekNet, 2023-10-21:
Hi, I have soldered my own issue 4 12-bit board, plugged the hat into a Pi Zero, I see the rainbow screen and CPLD Recovery Menu.

When I select CPLD_v79 and confirm, it return and nothing happened. I get the debug info below, any ideas what I may have done wrong? Thanks so much for any pointers!

Found CPLD: 6-12_BIT_BBC_CPLD_v79
Found CPLD: 3_BIT_BBC_CPLD_v68
Entering poll_keys_only, flags=00000000
Leaving poll_keys_only, result=0008
Entering poll_keys_only, flags=00000000
Leaving poll_keys_only, result=0002
Entering poll_keys_only, flags=00000000
Leaving poll_keys_only, result=0002
Read xsvf file /cpld_firmware/recovery/6-12_BIT_BBC_CPLD_v79.xsvf (length = 53373)
Programming....
CPLD programming: JTAG command = 0xfe (IDCODE)
 TDO Expected = 0xf9604093
 TDO Captured = 0xffffffff
 TDO Mask     = 0x0fffffff
ERROR:  TDO mismatch and exceeded max retries
ERROR at or near XSVF command #8.  See line #8 in the XSVF ASCII file.
Failed, error = 3
Entering poll_keys_only, flags=00000000

IanSB, 2023-10-21:
@AiGeekNet
It's detecting the wrong type of board as you only get that menu with an issue 1-3 board and Issue 4 and later have 3 firmware options. It might be a soldering issue although if you got your CPLD from China it is very likely that it has been recycled and is already programmed with some other firmware which can stop initial reprogramming from working and can also cause the board to be mis-identified.

The fix for that is to cut the three solder bridges JP1, JP2 & JP4 then program the CPLD then remake the bridges.
This is mentioned in the CPLD menu with recent software but I don't think that message shows up for the old Issue 1-3 boards so I'll have to add it in a future release to cover mis-identification.

The programming menu on recent firmware should look like this:
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

AiGeekNet, 2023-10-21:
I have cut three jumers but get the same info and error.  Does it due to my CPLD IC is AWN ?

IanSB, 2023-10-21:
@AiGeekNet
>I have cut three jumers but get the same info and error. Does it due to my CPLD IC is AWN ?

No, I have some with exactly the same batch codes and markings that work.

>Does it due to my board is 6bit ?

No, Issue 4 boards are 8/12 bit. You board is being mis-detected because a pin is held high instead of low.

First test that the jumpers are actually cut using a multimeter, especially JP1 as that isolates the signal that determines the board issue from a CPLD pin.

If you are sure that the jumpers are cut then check the soldering around Pin 9 of the CPLD, Pin 27 of the Pi header, Pin 7 of P5 and R7 (make sure it is the correct value).
These are all connected together and are pulled low by R7 but the software is seeing this line pulled high on power up which is causing the incorrect identification.

See schematic:
https://raw.githack.com/hoglet67/RGBtoHDMI/master/Kicad_6Bit/v4/rgb-to-hdmi.pdf

IanSB, 2025-05-06:
@kennyevo

For some reason LinuxJedi omitted the jumpers from his design so the only real option is to temporarily lift the legs of the CPLD instead.
The pins that have to be disconnected are CLKEN, SPDATA and SPCLK which are Pins 6, 7 and 44 of the CPLD.
See part of this thread which discusses it in relation to a fork of Linux Jedi's design by solarmon.

https://github.com/solarmon/RGBtoHDMI/issues/7#issuecomment-2096717958

Don't forget to resolder them afterwards.

kennyevo, 2025-05-08:
@IanSB

Thank you for your help

Lifting the legs resulted in the new recovery menu screen where I can see the RGB and not just the BBC firmware. Unfortunately I cannot program it, when it wants me to confirm it just blinks and nothing happens, log says:

`Read xsvf file /cpld_firmware/recovery12/6-12_BIT_RGB_CPLD_v95.xsvf (length = 53373)
Programming....
CPLD programming: JTAG command = 0xfe (IDCODE)
Failed, error = 3`

I tried to erase the CPLD, got the following in the log:
`Re-creating /cpld_firmware/Delete_This_File_To_Erase_CPLD.txt
File /cpld_firmware/Delete_This_File_To_Erase_CPLD.txt re-created
Unknown CPLD: identifier = fff
Keycount = 0
CPLD  Design: 3-12_BIT_BBC
CPLD Version: f.f
Early erase of CPLD
Read xsvf file /cpld_firmware/recovery/blank/BLANK.xsvf (length = 157)
Programming....
CPLD programming: JTAG command = 0xfe (IDCODE)
Failed, error = 3
Early erase of CPLD failed`

I guess it's a defect in my good old chinese cpld

IanSB, 2025-05-08:
@kennyevo
>I guess it's a defect in my good old chinese cpld

It could be faulty but if you are sure you have lifted those 3 pins and they aren't making any contact then it could also be soldering issues with the 4 CPLD pins that are connected to the Pi zero for programming.

Examine the soldering and also check the continuity between the following pins on the CPLD and Pi zero:

CPLD pin 9 and Pi zero pin 27
CPLD pin 10 and Pi zero pin 28
CPLD pin 11 and Pi zero pin 38
CPLD pin 24 and Pi zero pin 18

Also check that those CPLD pins are not shorted to adjacent pins which can sometimes not be visible if it is under the CPLD

You can also check that the lifted pins are no longer making contact
Lifted CPLD pin 6 no contact with Pi zero pin 28
Lifted CPLD pin 7 no contact with Pi zero pin 27
Lifted CPLD pin 44 no contact with Pi zero pin 38

kennyevo, 2025-05-09:
@IanSB maybe you could help me with the next step, this is the image I see and auto calibration doesn’t work

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

IanSB, 2025-05-09:
@kennyevo

You aren't getting any sync pulses
Have you selected the "Amiga" profile?

Check the connection between pin 32 of the Amiga's Denise chip and Pin 23 of the CPLD (Amiga sync to CPLD)
Then the connection between CPLD pin 20 and Pi zero pin 16 (CPLD sync out to Pi zero)

Check for open circuit or shorts to adjacent pins

kennyevo, 2025-05-09:
Well, would you think that the CPLD's 23pin was not soldered..... (that was the only leg that wasn't soldered properly)
Thank you again, it looks awesome now :D

Thread 350 (2023-11-03):

4K with Raspberry Pi 4

tyristori, 2023-11-03:
Does RGBtoHDMI support 4k/50hz/60hz when used with Raspberry Pi 4?

IanSB, 2023-11-05:
It didn't but it will on the next beta release due soon:
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

stanstrup, 2024-01-01:
Would someone be kind enough to confirm what is needed for 4K with a C64?

I found this:
* https://www.tindie.com/products/c0pperdragon/vic-ii-dizer/
* https://www.tindie.com/products/c0pperdragon/rgbtohdmi-mono-lumacode/

At the tindie page it says that the only extras that are needed are: "Micro SDcard, Mini HDMI cable, USB power supply".
But the hardware section of this repo lists additional things. Am I right in assuming that the things listed there are build into the rgbtohdmi-mono-lumacode?

IanSB, 2024-01-02:
@stanstrup
>At the tindie page it says that the only extras that are needed are: "Micro SDcard, Mini HDMI cable, USB power supply".

Yes, that is all you need plus a Raspberry Pi of some type. Normally that is a Pi zero but a Pi 4 is required for 4K support @50/60Hz and the cheapest one of those with 1GB memory will work OK with the mono/lumacode board.

The mono/lumacode board has part of the analog board already built into the main PCB and that is just enough to support mono analog sources like Apple II and lumacode like c0pperdragon's VICIIDizer so no additional boards are required.

If you use a Pi zero when connected to a 4K monitor it will output 1080p@50/60Hz by default but you can manually select 4K@25/30Hz which is the maximum that the zero supports. This will give 4K resolution but the motion will be limited to 25 or 30Hz depending if the source computer is 50 or 60Hz

You need the latest beta software from here for 4K support:
https://github.com/IanSB/RGBtoHDMI/releases

Note that using some other RGBtoHDMI board variants with Pi models other than the zero / zero2W requires a 40 way GPIO extender to allow clearance for connectors but the above board should plug into the Pi4 without that.

stanstrup, 2024-01-02:
Thank you! That is super useful information! If you are not well-versed in the Pi ecosystem this can all be a bit confusing.
I guess now I have to see what a c64 looks like in digital 4K!

IanSB, 2024-01-02:
@stanstrup
I just remembered there are few differences with the Pi 4:
The Pi 4 requires a USB-C power supply (the zero uses micro USB power)
The Pi 4 requires a micro HDMI lead, not a mini HDMI lead (Use the HDMI socket closest to the power socket)

tyristori, 2024-01-02:
I've been using c0pperdragon's video enhancement mod with RGBtoHDMI and Pi4. 4K/50hz works great and looks stunning on my LG OLED tv.

I hacked together a riser by soldering two female 2x20 pin headers together so I could fit the RGBtoHDMI board to Pi4. Other option would be to remove network and usb connectors from Pi4.

I added TRRS connector to Analog board pcb so I could use a premade TRRS to TRRS cable.

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

stanstrup, 2024-01-03:
@tyristori Looks very cool! If I understood @IanSB correctly I wouldn't need the extender you made for the particular board I am targeting.

Your comment about TRRS cables made me think about the audio. How is that handled? I cannot see on c0pperdragon's "RGBtoHDMI Mono & LumaCode" board if it has an audio input. So how should I get the audio into the HDMI signal? I have a small s-video/RCA board for the C64 so I have the analogue audio signal but what do I do with it? I can plug it into the RGBtoHDMI board? The Pi? Or would I need to merge them using an HDMI audio embedder (seems at least ~50€) myself?
#340, #254, #225 and #177 would suggest to me that I indeed would need an audio embedder. Also am I right in assuming most TVs won't allow a separate audio source when using HDMI?

@IanSB Also thanks for the additional hints. I think I have those parts lying around.

IanSB, 2024-01-04:
@stanstrup
> I wouldn't need the extender you made for the particular board I am targeting.

That is probably the case but with one caveat (see below)

>Your comment about TRRS cables made me think about the audio. How is that handled?

Audio isn't handled at the moment so you either have to use separate speakers (like a soundbar), an analog audio override connection if your TV / monitor supports that or a HDMI audio embedder.

I am looking at adding audio support in future but it is difficult because there is not much hardware documentation for bare metal programming on the Pi.

Full 4K 50/60Hz support at the moment is very new and has had little testing so it's a good thing you mentioned that as I hadn't actually got around to testing my Pi 4 with an audio embedder (which I have now done)

First, before going down the 4K path you might want to check how your TV/monitor scales 1080p content.
Most TVs use interpolation so 1080p will have soft edges on a 4K monitor and this is most noticeable when using an older PC with a 1080p desktop as window edges etc will be soft compared to a normal 1080p monitor.
However some newer 4K monitors are supposed to have integer scaling for 1080p to 4K by just replicating each 1080p pixel in a group of 2x2 pixels on the 4K monitor which would make a 1080p PC desktop look as sharp as a normal 1080p monitor. (This is the same thing that RGBtoHDMI does for vintage computers).

I don't know how common this is but there is some more info here
https://www.reddit.com/r/integer_scaling/comments/ohpkno/eve_spectrum_worlds_first_computer_monitors_with/
https://shmups.system11.org/viewtopic.php?t=67116
Such a feature might have to be enabled in a menu
If your TV/Monitor does that then there is no point going to 4K as 1080p will look identical and you can stick with a Pi zero.

>Also am I right in assuming most TVs won't allow a separate audio source when using HDMI?

You will need to check your TV's manual.
Some TV's and many monitors have a 3.5mm audio jack input which will override the HDMI audio on one input when connected and that is designed for use with older PCs that had an analog audio output separate from the monitor output but maybe that is less common these days.

I have this audio embedder which is rated for 4K@60Hz:
https://www.aliexpress.com/item/1005005604559797.html

I have tried this and it works but there are some issues which will need investigation:
When the embedder is connected to one of my newer Pi 4 models it works OK but connected to the older one it gets stuck in a reboot loop although I found a way around that by temporarily removing the embedder and forcing the Pi's resolution to Full 4K(Pi4 Only) rather than Auto in the main menu.

Also it is very sensitive to cable quality and length so use HDMI 2.0 rated short cables (I used 50cm from Pi4 to embedder and 1M from embedder to TV)

I also added a small stick on heatsink to the Pi 4's CPU and that might mean you need a GPIO extender depending on the height of the heatsink
Both of these are available from Pi sellers and places like ebay and amazon e.g:
https://thepihut.com/products/40-pin-extra-tall-header-push-fit-version-single-shroud
https://thepihut.com/products/40-pin-extra-tall-header-push-fit-version-no-shroud
https://thepihut.com/products/xl-raspberry-pi-4-heatsink

stanstrup, 2024-01-17:
So I got everything together apart for the audio embedder.
I am getting some garbled output though... Any ideas?
I left my lumafix in there (below the vic-ii-dizer). Could that cause this issue?

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

IanSB, 2024-01-17:
@stanstrup

If it's affecting the S-Video output as well then it is likely that some VICII signal or signals are not connecting properly or being held at the wrong voltage by the lumacode board and maybe putting a different 40 pin socket between the lumcode board and the c64 socket would help to fix that but it's best if you post about issues with the lumacode board itself to c0pperdragon's github:

https://github.com/c0pperdragon/LumaCode/issues

I can really only help with the RGBtoHDMI board although there does seem to be a problem with that as well as your Pi seems to be outputting 4K@30Hz rather than 4K@50hz but it's probably better to look at that once your lumacode board is working.
(Although maybe that would be expected if you are doing initial testing with a zero rather than a Pi4)

BTW I did find some issues with the audio embedder at 4K and there will be a Beta 63 release soon that fixes those.

stanstrup, 2024-01-18:
Thanks. I have ordered some sockets and hope to be able to fix this as soon as I get them.

stanstrup, 2024-03-08:
Turns out in all these trials my vic chip died :(
After replacement all is working well and it looks fantastic.
I don't dare try again to add the lumafix together with this.

Thread 353 (2023-11-21):

Having issues with configuring the RGBToHDMI for the denise adaptor board

ADoozer, 2023-11-21:
Hi all.

posted this on c0pperdragon issues as well so apologies for duplicate post.
(https://github.com/c0pperdragon/Amiga-Digital-Video/issues/70)

I am using the c0pperdragon amiga 500 direct denise adapter (V2) (no CPLD) but every time I boot the pi I see the message "Release buttons for CPLD recovery menu"

I have tested voltages, and the latch chips, I'm seeing the 15khz and 7MHz on pins 11 and 16 (cant remember which way around it is but It looks ok?!), and my monitor reports 50Hz (UK Amiga)

Watching Jan Beta, CRG, brostenen etc on utube, they just download the zip, send it to the SD and it just works.

Pretty sure its just a setup issue?! but no idea where to start looking.

Anywho, Any help greatly appreciated.

Regards Dave.

IanSB, 2023-11-21:
@ADoozer
>I am using the c0pperdragon amiga 500 direct denise adapter (V2) (no CPLD) but every time I boot the pi I see the message "Release buttons for CPLD recovery menu"

That board should work without any additional configuration. (The linuxjedi internal CPLD variant does require some manual configuration)

To get the "Release buttons for CPLD recovery menu" message requires all three buttons to be pressed during powerup and two of those GPIO pins are not even connected to anything on the c0pperdragon board (pins 35 & 37 on the Pi header) so something is wrong with the hardware.
e.g. maybe the zero was plugged in backwards or "off by one" at some time which damaged the GPIOs so it is seeing those inputs as low.

If you have a TTL to USB serial adapter you could connect that to the serial debug output to see what it is detecting and post the resulting output.

Pin 8 on the zero header is TxData and Pin 6 is GND
115200 baud 8 data no parity

ADoozer, 2023-11-21:
Thanks Ian.

Looks like a self inflicted wound.

I was testing on my 4b while i wait for my zero to turn up (hopefully today/tomorrow) and made the poor assumption that all the GPIO was equivalent.

However I now know (after reading the docs) that the higher GPIO pins are internally pulled low at initialisation resulting in "all buttons pressed"

I cant find anything that explicitly says so, but I'm guessing the zero has internal pull ups on the higher GPIO pins at initialisation

Thanks again Ian

Regards Dave

IanSB, 2023-11-22:
@ADoozer

The GPIOs do default as you indicate and I think that is the same for all Pi models but the software does reprogram them to pullups before testing the GPIOs. However those pullups are very weak so maybe they haven't had a chance to fully pullup before the software reads the GPIOs and the time taken for that is probably different between the Pi zero and the Pi 4 as the latter is faster. The standard CPLD board uses strong 1K pullup resistors on the switch inputs so doesn't rely on the internal weak ones which means any difference between Pi models wouldn't be noticeable with that board.

ADoozer, 2023-11-26:
Thanks Ian.

Just confirming the zero worked as advertised with no changes required

Regards Dave

hoglet67, 2023-11-26:
Ian,

The mechanism for controlling GPIO pullups/pulldowns is different on the Pi 4 compared to the other models. So it's possible this is a software bug. Take a look at the code in PiTubeDirect here:
https://github.com/hoglet67/PiTubeDirect/blob/master/src/rpi-gpio.c#L118
```
void RPI_SetGpioPull(rpi_gpio_pin_t gpio, rpi_gpio_pull pull)
{
#if defined(RPI4)
  rpi_reg_rw_t* pull_reg = &RPI_GpioBase->GPPULL[gpio / 16];

  rpi_reg_rw_t pull_copy = *pull_reg;
  pull_copy &= (uint32_t)~(0x3 << ((gpio % 16) * 2));
  pull_copy |= (pull << ((gpio % 16) * 2));
  *pull_reg = pull_copy;
#else
  RPI_GpioBase->GPPUD = pull;
  RPI_WaitMicroSeconds(2); // wait of 150 cycles needed see datasheet

  RPI_GpioBase->GPPUDCLK0 = 1<<gpio;
  RPI_WaitMicroSeconds(2); // wait of 150 cycles needed see datasheet

  RPI_GpioBase->GPPUDCLK0 = 0;
#endif
}
```
You can also configure pullups in the config.txt file using the following syntax:
```
# Configure pullups on D6,D4,D2,D0,nTUBE
gpio=24,22,10,8,17=pu

# Configure pulldowns on D7,D5,D3,D1
gpio=25,23,11,9=pd
```

IanSB, 2023-11-26:
@hoglet67
>The mechanism for controlling GPIO pullups/pulldowns is different on the Pi 4 compared to the other models.

Thanks, you are correct that the pi4 gpio pullup code is missing so I have merged the PiTubeDirect code to fix that.

See here:
https://github.com/hoglet67/RGBtoHDMI/commit/df4ec94542666395423abd11b3e3bdcc823acc18

Thread 359 (2024-01-13):

Is there a way to verify that I soldered the board correctly?

dfroholt, 2024-01-13:
My first attempt at SMD soldering went way better than I expected. At least I think it did. Is there a way to verify that I soldered everything together correctly without an actual computer to test it with?

I powered the unit on and programmed the CPLD without any issues but when I hooked it up to my old Commodore PC10-2 I only get a grey screen and no sync. It's been over 25 years since this computer was powered on. Back then I remember thinking that the monitor stopped working because I did not get an output from the computer.

Now I am thinking that there's an issue with the computer itself. Perhaps the ATI CGA card. OR I messed up the soldering. I would like to know for certain but I don't have any other PCs to test it with. I got a some stock C64s and a couple of Sharp MZ-700 but I don't really know how to use the RGBtoHDMI board with those. The next step would probably be to research this.

I stuck my ocilloscope into the connector on the video card and I can't really see any activity. Pin 3, 4, 5 and 9 seems to be stuck high at around 3.7v. I don't really know what to expect here though but it seems a bit weird to me.

IanSB, 2024-01-13:
@dfroholt
>I got a some stock C64s and a couple of Sharp MZ-700 but I don't really know how to use the RGBtoHDMI board with those.

The C64 will not work with a digital RGBtoHDMI (although it will work with an analog RGBtoHDMI and one of c0pperdragon's lumacode boards) but the Sharp MZ700 will work and there is already a profile available in the software.

The pinout of the sharp RGB connector is shown here:
https://original.sharpmz.org/mz-700/connect.htm

The connections for the MZ700 are shown here:
https://github.com/hoglet67/RGBtoHDMI/wiki/Cables#sharp-mz700-3-bit-rgb-ttl

Note at the moment this profile is set up to use the composite sync output but looking at the above Sharp pinout website that wouldn't work with the MZ800 so I may update that in future to work with separate H and V syncs.

dfroholt, 2024-01-13:
Thanks! I'll try to make a cable for the Sharp. Hopefully it will work!

Closed 2024-01-17.

Thread 362 (2024-02-06):

Heath/Zenith Z-110 - unable to sync

hmb001, 2024-02-06:
For reference, I am trying to connect the Zenith Z-100:
https://z100lifeline.swvagts.com/articles/Z100_Monitors.pdf

The video output connector has a pinout identical to that of a standard PC CGA connector.

I have no problem connecting the output of the Z100 via an MCE2VGA adapter to a VGA monitor - no special settings required, it simply just works.

Not so with the RGBtoHDMI. No matter what settings it try on the RGBtoHDMI adapter, it fails to sync to the incoming signal. The screen just flickers with parts of the image barely visible and jumping all over the place.

The Z-110's video output itself is very configurable:
- horizontal sync can be set to negative (default) or positive polarity
- vertical sync can be set to negative (default) or positive polarity
I have tried both settings, but it makes no difference.

A couple of additional points, which may influence why the RBGtoHDMI adapter is unable to sync:
- the Z100 horizontal scan frequency is 15.75 KHz
- the video output is not exact IBMPC CGA standard - it is 640x225 (vs 640x200 for IBM PC CGA)

Am I correct in assuming that since the RGBtoHDMI adapter is not able to function as a scan doubler, it is necessary to use an HDMI monitor capable of handling a 15.75 KHz horizontal frequency if the RGB video output of the vintage computer is 15.75 KHz? Monitors with this ability are now very difficult to obtain, and this requirement makes the RGBtoHDMI adapter a far less versatile device than the MCE2VGA adapter.

IanSB, 2024-02-08:
@hmb001
>the Z100 horizontal scan frequency is 15.75 KHz
>the video output is not exact IBMPC CGA standard - it is 640x225 (vs 640x200 for IBM PC CGA)

RGBtoHDMI is primarily designed to upscale ~15Khz type sources and is fully configurable for any unusual resoloutions so should be able to work with such a source.

>Am I correct in assuming that since the RGBtoHDMI adapter is not able to function as a scan doubler, it is necessary to use an >HDMI monitor capable of handling a 15.75 KHz horizontal frequency if the RGB video output of the vintage computer is 15.75 KHz

No, that is not correct, RGBtoHDMI is a scaler that will scale the video to the native resolution and refresh rate of the LCD display you are using. e.g. If connected to a 1080p monitor it will scale a 15Khz source to a 4:3 image pillar boxed in 1920x1080 at 50Hz or 60Hz as appropriate usually with integer scaling for a very sharp image.
It should work with any HDMI or DVI monitor and doesn't require the monitor to support 15Khz.

As to why your source doesn't work, do you get a message at the top of the screen when the menu is enabled that says "No Sync Detected?"

Possible causes for that could be:
1. Wrong sync type configured (e.g. source is composite but the profile is configured for separate H/V)
For such a source I would start with the CGA profile but you can change the sync setting in the geometry meny to cycle between the various separate and composite sync options if you haven't already tried that.

2. Sync voltages are not at TTL level (e.g. 1v p-p instead)

3. Faulty RGBtoHDMI
Have you been able to use the board with any other CGA source?

hmb001, 2024-02-08:
There is no error message indicating the device is unable to detect sync. The only error message is that the device is unable to establish genlock.

After a lot of fiddling, what I see are two unstable images of the screen display, one above the other. The lines are badly distorted and compressed together (ie completely illegible) and fill the entire width of the screen.

1. The source is definitely separate H and V sync (both positive) with the standard pin assignments on the connector. On the adapter, I have selected the CGA profile. In the geometry screen, I have manually selected all combinations of H and V sync (in addition to H and V being both positive per the design of the source) with no improvement.

2. All signals generated by the source are driven directly from standard TTL logic.

3. I have not tried the RGBtoHDMI board with any other source... I figured it wasn't designed to work with standard IBM-PC CGA output without use of a monitor capable of 15KHz horizontal sync. However, now that you say it should work I will test with the output of a standard PC CGA board.

IanSB, 2024-02-08:
@hmb001
>After a lot of fiddling, what I see on the monitor are two unstable images of the same screen display, one above the other.

Can you post the source summary page in the info menu
Either a photo or a screencap (press up and down buttons simultaneously in the menu, file in /Captures on SD card)

Also try the create profile menu in the latest beta which attempts to create a profile automatically by analysing the timing.
(This will need valid syncs before you can enter the menu)

Download here:
https://github.com/IanSB/RGBtoHDMI/releases

Select the CGA profile as your base profile then enter the create profile menu and follow the help menus (assuming it can detect syncs).

IanSB, 2024-02-08:
@hmb001

Looking at the schematic of the Z100 video board, the pixel clock is 14112000Hz instead of 14318181Hz so you will need to change the clock frequency setting in the Create Profile menu to match that.

hmb001, 2024-02-08:
Re changing the pixel clock - I will do that, and let you know the outcome.

I have a few other options to dig into this problem further knowing this setup *should* work, like putting a scope on the H and V sync signals to see what is going on there.

hmb001, 2024-02-09:
If I have this right, to create a custom profile:
- Main Menu -> Profile -> Select "Custom"
- Geometry Menu -> select "Clock Frequency" and "Sync Type"

I see no "Create Profile" menu anywhere. For that matter, navigating to a "Create Profile" menu item is not shown anywhere in the Wiki.

Attached are:
- photo of my Geometry menu
- photo of my Source Summary menu
- logic analyzer sample showing V and H sync pulses at input to the RGBtoHDMI board, with expected frequencies.

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

hmb001, 2024-02-10:
Full disclosure - I am using the version of this adapter sold by TexElec.

I hooked up the adapter to a "real" CGA video output card... and I am happy to say it works just fine. This adapter has none of the residual "shimmering" around pixels in a character that I see with the several different FPGA-based RGB-to-VGA adapters I have used.

Having ruled out a hardware problem with my RGB-to-HDMI adapter, I still do not have an answer as to why the CGA-like output of the Zenith Z-100 cannot be displayed. As you pointed out, testing so far seems to indicate the adapter is unable to lock on to the H sync signal. Perhaps there is some subtle issue with the timing of the H sync signal, and the Pi is unable to correctly identify the H sync signal because it is too long or short?

At this point I'm leaning towards dropping this project - perhaps with current programming I happen to have a vintage computer with a CGA-like signal this adapter is incompatible with. As I mentioned I do have a couple of different RGB-to-VGA adapters (both of which do work just fine with the Z100) and I can just continue to us them instead.

IanSB, 2024-02-11:
@hmb001
>Perhaps with the current Pi software I have a vintage computer with a CGA-like signal this adapter is incompatible with.

This is extremely unlikely as the software works with a wide range of refresh rates and sync pulse sizes.
Correct me if I'm wrong as it is difficult to judge from you photo but the time between hsync pulses looks to be around 64uS and the sync pulse width looks to be around 4.7uS which are pretty much standard. (The reading of 103190ns is actually a timeout value meaning no h sync pulse edges have been seen at all.)

>I am using the version of this adapter sold by TexElec.
>I hooked up the adapter to a "real" CGA video output card... and I am happy to say it works just fine.
>Having ruled out a hardware problem with my RGB-to-HDMI adapter

This is almost certainly a hardware issue as there is no reason why sync signals with the timing you posted shouldn't work and produce equally high quality output with an appropriate custom profile. Perhaps the termination on their hsync input is too low resistance for the Z100 to drive or the hsync pin on your cable isn't mating properly with the socket on the converter but you will need to get support from your supplier for that.

IanSB, 2024-02-11:
@hmb001

One final suggestion:
It appears that you can change jumpers on the Z100 to output composite sync on the Vsync output. As that input appears to work judging by 60Hz being detected you could try changing the jumpers then alter the CGA profile to look for composite sync on the vsync input as follows:
Change "Sync Type" in the geometry menu to "Composite" (for negative going composite sync) or "Inverted" (for positive going composite sync)
Change "Sync on G/V" in the sampling menu to "On" which will select composite sync on the Vsync input instead of the Hsync input.

hmb001, 2024-02-11:
The logic analyzer trace I provided was directly at the termination resistor on the adapter board, which would rule out a connector problem. Also, the logic analyzer was able to interpret that signal as a logic "1" although that does not necessarily mean the LS245 input buffer sees the signal as a logic high.

I have not been able to find any PDF schematic for your 6 bit buffer board design (only the Kicad files, which I don't have the app for), but based on the BOM it would seem the buffer board on my TexElec adapter is identical. I looks like all the signals coming into the RGB connector are terminated by a 4.7K load resistor to ground, and to the inputs of an LS245 buffer. I have not traced the signals past the LS245, but given the adapter works fine when connected to another system it is unlikely there is a circuit fault there.

Over the past few days I did try setting the Z100 video output to both negative and positive composite sync, with no success. What I did not do is set the adapter to "Sync on G/V" - I had assumed setting the sync to "composite" would have sufficed for the adapter to figure it out, but apparently not. I will need to give that a try. Also, thank you for the pointer on what the "sync type" setting does - that is not described in the Wiki, and who would have guessed that "inverted" meant positive going composite sync.

IanSB, 2024-02-11:
@hmb001

As you have been experimenting for a while make sure you delete the /Saved_Profiles folder on the SD card or at least use the "restore default configuration" option in case you inadvertently saved messed up settings to the CGA or other profiles which will happen if you used an auto calibration followed by the press menu to save option.

hmb001, 2024-02-17:
I am happy to report I have resolved the problem.

For some inexplicable reason, the H and V signals going to the Z100 external monitor connection are each driven by a TTL open collector driver with a 1K pullup resistor to 5V. This stupid design provides nowhere near enough drive current to get a clean video signal to the RGBtoHDMI adapter.
Fortunately, the Z100 video board provides an optional output connector for just the H and V signals, with each signal driven independently of the above connector driven by a 74LS244 driver. I re-routed the H and V signal outputs to this connector.... and the RGBtoHDMI adapter immediately synced.

Thank you for your encouragement and advice getting this working.

IanSB, 2024-02-18:
@hmb001
>This design provides nowhere near enough drive current to get a clean video signal output

I had noticed that but thought it should be enough for the required voltage swing as it is a 1K pullup on the Z100 and a 4.7K pulldown on RGBtoHDMI which should overall give about a 4V logic high. However if the Hsync open collector output is faulty and not pulling down to ground hard enough then that might explain the issue as well because the Vsync output appears to work. Perhaps Hsync is only pulling down enough for CMOS levels so that would explain why your logic analyser and VGA converter still work.

>RGBtoHDMI adapter immediately synced using the "Tandy 1000 225 line" profile setting
>There is just one one minor issue I still have to figure out, which is that the horizontal width of the display is short by one or two pixels.

Syncing is only the first step. You will get an image but it might have columns of noise on some characters across the screen if the pixel sampling is set incorrectly and other parameters like lines per frame are also likely set incorrectly.

This is a non standard source so you need to setup a custom profile using the latest software version with the "Create Custom Profile" menu and also follow the newly updated (a few days ago) Tutorial on creating a new profile to ensure you get a perfect noise free accurately sampled image.

First download the latest stable release from a couple of days ago:
https://github.com/hoglet67/RGBtoHDMI/releases

Then re-read the newly updated tutorial on creating a custom profile:
https://github.com/IanSB/RGBtoHDMI/wiki/Tutorial-on-Adding-a-New-Profile
(The rest of the wiki has also been updated a few days ago to document recent changes)

I think the Clock Frequency needs to be set to 14112000Hz instead of 14318181Hz as that is the crystal on the schematics and you also need to fill the screen with 'M' or similar as described in the tutorial and if necessary adjust line length to ensure that all characters across the screen are being sampled correctly.

If you get a satisfactory custom profile, please post it here and I will include it in a future release.

hmb001, 2024-02-19:
I will follow your advice and set up a custom profile as my next step.

I would be very happy with the current setup save for **one** issue - the screen is currently only 77 characters wide. As shown in the attached image, the last 3 characters are cut off and the WHT color bar is cut off on the right side. If I set the line length correctly AND set the clock frequency to 14112000 then I get a lot of noise in the displayed characters.

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

IanSB, 2024-02-19:
@hmb001
>If I set the line length correctly AND set the clock frequency to 14112000 then I get a lot of noise in the displayed characters.

It does look OK with the Tandy 1000 defaults so maybe those defaults are already correct and the schematic I've been looking at isn't the correct one for your system.
Maybe you just need to adjust the H offset to centralise the capture area.

hmb001, 2024-02-22:
With the most recent stable firmware release I created a custom profile with the correct dot clock frequency, and display pixel width and height. The display is now perfect!

I have attached the profile file.
[Custom_Profile_0_.txt](https://github.com/hoglet67/RGBtoHDMI/files/14378048/Custom_Profile_0_.txt)

IanSB, 2024-02-22:
@hmb001
>I have attached the profile file.

Thanks for that, I have put it in the "Other" folder named as "Zenith Z110" so it will be included in any future releases.

Did you find the create custom profile menu easy enough to use or does anything need clarifying?

hmb001, 2024-02-22:
The only issue that made me pause for a moment was the entry for "Pixel Height", until I realized that likely in most cases "Pixel Height" = "Number of scan lines". Also it seems "Pixel Height" must be an even number. The Z100 has 225 scan lines, so the entry for this parameter needs to be 226.

Am I correct in assuming the adapter can usually figure out H and V sync polarity? I didn't have to manually enter these parameters when creating the profile - or is that only the case when both H and V sync are positive?

IanSB, 2024-02-22:
@hmb001
>Am I correct in assuming the adapter can usually figure out H and V sync polarity? I didn't have to manually enter these parameters when creating the profile - or is that only the case when both H and V sync are positive

Yes it auto detects and sets the sync polarity using the analyse timing option and can also usually work out if the source is composite or separate H/V sync.

Thread 367 (2024-02-26):

Some settings in Pallette Menu don't work...

gelo291, 2024-02-26:
Hello,
I try to change settings in Pallette Menu, like:
Brightness, Contrast, Saturation etc.,
but whatever I set I can't see any changes on the screen.
Settings are changed and saved properly, but as I said: no changes are visible.
Even when I change Pallette type it is still the same pallette visible.
I use Amiga 50Hz profile.
What could be the problem?
Thanks a lot,
Greg

gelo291, 2024-02-26:
Ok,
thanks a lot, now everything is clear.
To be honest, it is a shame, but what can we do...

Biker1bob, 2024-05-19:
I am using a MegaSTE and I find the colour is off - VERY red - I was trying to make palette changes as well. SO the colour the source provides is the colour we get?? There is no way with the device to make colour adjustments? Then I have a problem with my RGB2HDMI I guess, because this is WAY TOO RED.

IanSB, 2024-05-19:
@Biker1bob

Maybe you have some R, G or B bits either stuck high or low or you have wired them up out of order.
Is there a video test program for the STE similar to the Amiga Test Kit that produces a colour gradient test image like this:

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

Here is a similar example from my test jig that generates video test patterns:
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

If there are any bits wrong they will usually be visible with this kind of test pattern and if not further investigation can be done by examining a screencap of the test pattern (using SW2)
If you don't have such a program then you should be able to use a paint program to paint blocks of each red, green or blue intensity 0-15 in turn in a similar way.

If the bits are all OK then check your monitor's colour temperature setting etc which can usually be set differently for each input.

Biker1bob, 2024-05-21:
This is from the MegaSTE diagnostic cartridge.
The first is the RGB out to VGA
The 2nd is the RGBtoHDMI - something is wrong. But I dont know where to look. I did have an issue before with green and that was a problem with the soldering on the CPLD. But no idea where to look for this red.
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

IanSB, 2024-05-21:
@Biker1bob

Yes, it looks like the bits are being picked up in the wrong order although it's difficult to judge exactly what's wrong from a photo.
Please post a screencap (Press SW2, the file will be in /captures on the SD card)

Biker1bob, 2024-05-21:
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

IanSB, 2024-05-21:
@Biker1bob

Youve got all the red, green and blue groups of 4 bits correct but within each group, nearly all your connections are to the wrong bits:

The Green and Blue channels look to be the same:
Atari bit 0 is connected to RGBtoHDMI bit 3
Atari bit 1 is connected to RGBtoHDMI bit 0
Atari bit 2 is connected to RGBtoHDMI bit 1
Atari bit 3 is connected to RGBtoHDMI bit 2

i.e. they are all rotated by 1

The red channel is different:

Atari bit 0 is connected to RGBtoHDMI bit 2
Atari bit 1 is connected to RGBtoHDMI bit 0
Atari bit 2 is connected to RGBtoHDMI bit 1
Atari bit 3 is connected to RGBtoHDMI bit 3 (The only right one!)

i.e. bit 3 is right but the other three bits are rotated by 1

Biker1bob, 2024-05-21:
OK, thanks.. I will look up the build thread I followed again.. Check all my connections again.

Biker1bob, 2024-05-22:
So not sure what to say .. but the only wires I changed were red 3 to 2 and 2 to 3 - now correct bit 3 to 3 on board and 2 to 2. Colour is now fixed.  Thanks for the direction though. I used a blue and a green wire for those two.. so somehow I got them reversed. Because it is hardwired I have to disconnect everything each time I take the machine apart for anything. I guess the last time I got the wires reversed.

James

Biker1bob, 2024-05-22:
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

IanSB, 2024-05-22:
@Biker1bob
Well that still looks screwed up compared to the analog output but at least the red is now the same at the other two so they are all rotated by 1. This might look somewhat OK on a lot of software that was written for the ST because that only uses 3 bits per colour so you would only be using every other value and that would have the right relative intensities but only at half overall brightness.
If your connections match the build thread then I would have to guess that those wiring instructions are wrong.
I don't have an STE but it is possible whoever came up with the wiring details got confused with the ST connections which are only 9 bits but use the lower bits 0-2 rather than 1-3.
To get it to match the analog output you will have to rotate all the connections by 1.

Biker1bob, 2024-05-22:
https://atari-forum.com/viewtopic.php?p=423189#p423189
Is the thread and this is the diagram I went from. I guess I could review the schematics as well. Nothing was ever posted that this was not a complete and working setup.
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

IanSB, 2024-05-22:
@Biker1bob
That's definitely wrong and would not work properly with the STE profile as you have discovered although it might appear to look vaguely OK without using the gradient test pattern especially if running software designed for the ST.

I can see where the problem has arisen:
Looking at an STE schematic, the pinout of the shifter refers to the least significant bits as R3,G3,B3 instead of R0,G0,B0. I guess that is so that RGB0-RGB2 correspond to the same bit numbering as the ST. However that is very non-standard and that labelling doesn't match the RGBtoHDMI labelling so you can't connect like for like and you would have to connect Atari 2, 1, 0, 3 to RGBtoHDMI 3, 2 ,1, 0

To avoid confusion use the resistor values instead. The highest value resistor is the lowest bit number and the lowest value resistor is the highest bit number so:

RGBtoHDMI R0, G0, B0 should be connected to the 12K resistors
RGBtoHDMI R1, G1, B1 should be connected to the 6.2K resistors
RGBtoHDMI R2, G2, B2 should be connected to the 3K resistors
RGBtoHDMI R3, G3, B3 should be connected to the 1.5K resistors

There is another photo here which appears to be from a different board so the layout is different and not directly useful for you but that matches the above resistor connections:
https://www.sellmyretro.com/uploaded/img/61574_s-l1600.jpg

Biker1bob, 2024-05-22:
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

And we have it. I also posted your last post to the same thread I found the build. This way anyone else can adjust.

Thanks so much!!!

James

IanSB, 2024-05-22:
@Biker1bob
Looks good!
As you can see it's always a good idea to use a gradient test pattern after fitting an RGBtoHDMI as it really shows up any problems very easily.
BTW can you give the latest Alpha65G a try to see if the HDMI audio test works on your monitor:
https://github.com/IanSB/RGBtoHDMI/issues/29#issuecomment-2099613155

Biker1bob, 2024-05-22:
Never tried audio out? is there something I have to wire up?

IanSB, 2024-05-22:
@Biker1bob
>Never tried audio out? is there something I have to wire up?

No, it's just a test of HDMI audio output in preparation for full audio support with a plugin audio capture device which should hopefully be due soon. At the moment it just plays WAV files to check if the HDMI output is compatible with all monitors.

Thread 370 (2024-03-09):

CPLD overheats, shorts Zero Pi

briskspirit, 2024-03-09:
This is not an issue but a reminder to everyone based on my experience.

CPLD is very senseless to ESD! Mine got internal short after I plugged in/out cables.it just start to overheat and burn PCB.

P.S. maybe it’s a good idea to add efuse to the schematics?
Also I would replace resistor arrays with regular resistors as arrays are pretty expensive compared to resistors.

Thank you for the great product!

IanSB, 2024-03-12:
>CPLD is very sensitive to ESD! Mine got internal short after I plugged in/out cables a few times, while touching PCB leads. It just started to overheat and burn PCB. Had to replace CPLD and now it works again.

This can happen occasionally which is why I designed the various buffer boards to protect the inputs of the CPLD against that. Also plugging the CPLD board into the 40 way Pi header while powered up will almost certainly damage either the Pi or the CPLD or both as will plugging them together 'off by one' pin. (I accidentally did both of those a couple of times during development!).

>Also I would replace resistor arrays with regular resistors as arrays are pretty expensive compared to resistors.

The design was optimised to make DIY assembly easy, even with just a soldering iron rather than hot air, especially for those not used to surface mount assembly so through hole parts were used where possible and larger surface mount packages were used where possible too. Hand soldering a few through hole resistor arrays is a lot easier than 15 surface mount resistors. Also for the analog board SOIC packages were chosen where possible as they can be single pin soldered with only one package being TSSOP.
The pre-assembled boards available from the authorised sellers linked in the wiki have been optimised for machine assembly using much smaller components and more surface mount parts so were able to include some additional protection for the CPLD inputs when used without a buffer board.

Thread 373 (2024-03-29):

Red background with and without source

briskspirit, 2024-03-29:
Any idea why that happens? Have I killed CPLD again?

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

IanSB, 2024-03-30:
@briskspirit
> Any idea why that happens? Have I killed CPLD again?

It's possible but it looks like alternate pixels are stuck on red is that correct?
If that's the case it isn't a damaged input but rather a problem with communication between between the CPLD and the Pi zero.
(I assume you have scanlines enabled as well which would result in the black lines between the lines of red/black pixels)

The 6 bit pixels are passed from the CPLD to the Pi two at a time over a 12 bit bus so it looks like one half of the bus has a stuck red data pin. It might be a damaged CPLD or Pi zero pin but it is more likely to be a bad solder joint on the CPLD or it might be a bad connection between the CPLD board and the Pi zero on the 40 way header.
There are two red bits per pixel so the following pins on the 40 way header are used to transfer red data:

1st pixel red hi = 40 way header pin 3 (Q00) CPLD pin 29
1st pixel red lo = 40 way header pin 29 (Q03) CPLD pin 5
2nd pixel red hi = 40 way header pin 24 (Q06) CPLD pin 12
2nd pixel red lo = 40 way header pin 23 (Q09) CPLD pin 13

Check the continuity of those pins between the CPLD board and the Pi zero.
Also check for a bad solder joint on the associated CPLD pins.

For refererence the 12 bit bus which is marked as Q00 to Q11 on the schematic is used as follows:
Q00 R0 HI
Q01 G0 HI
Q02 B0 HI
Q03 R0 LO
Q04 G0 LO
Q05 B0 LO
Q06 R1 HI
Q07 G1 HI
Q08 B1 HI
Q09 R1 LO
Q10 G1 LO
Q11 B1 LO

briskspirit, 2024-03-30:
Interlace isn't enabled and today (after refreshing? idk..) picture have changed to vertical lines.
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

Flashed to BBC - getting white tint. Flashed to YUV - blue-ish background(dark blue).
Tested with all "test color" profiles (BBC, YUV, RGB) - everything looks good!

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

Seems like if color test on all 3 FWs passes - it's not RP-to-CPLD problem.

So red got "stuck" on my buffer board with dsub9 connector? (Which was working fine initially before I put it into 3D printed case and added "UPS" to RP)

IanSB, 2024-03-30:
@briskspirit
>Interlace isn't enabled and today (after refreshing? idk..) picture have changed to vertical lines.

That is still alternate pixels stuck on red

>Seems like if color test on all 3 FWs passes - it's not RP-to-CPLD problem.

The colour test is mainly meant for testing monitors, not the CPLD and it only tests the frame buffer of the Pi, not the CPLD to Pi communication.

Have you tested continuity of the above mentioned pins from the CPLD to the Pi zero?

> added "UPS" to RP

What do you mean by that?

briskspirit, 2024-03-30:
Continuity looks good, tried to re-solder Pi header as I clipped it (thought maybe I have cold joint).
I am kinda giving up with the result that it's faulty Pi Zero W , but everything is fine with Pi Zero 2W. Something broke on Pi side and after header. RIP Pi Zero )

Not sure if this issue should be closed or kept for other people as a reference @IanSB

P.S. by adding "UPS" I meant that I added USB-C charger + 750mAh LiPo battery so I don't need to use USB power while tinkering with my old stuff.

IanSB, 2024-03-30:
@briskspirit
>I am kinda giving up with the result that it's faulty Pi Zero W , but everything is fine with Pi Zero 2W

It looks like the CPLD is OK if it still works with the zero 2W.

If you were using the Zero W with the previous CPLD that shorted and failed, perhaps that also weakened the Pi so it failed as well some time later.

Apart from soldering issues the only other problem I've seen occasionally with the 12 bit bus is intermittent contact on the 40 way header caused by flux wicking into the 40 way socket after soldering and that can be fixed by using iso propyl alcohol on the 40 way pins and socket.

>P.S. by adding "UPS" I meant that I added USB-C charger + 750mAh LiPo battery so I don't need to use USB power while tinkering with my old stuff.

Another option if your monitor has a built in USB hub is to power the Pi from that using a USB to micro USB cable so no separate power supply needed.

Thread 374 (2024-04-03):

Shorted/faulty CPLD?

axmandm, 2024-04-03:
I have an RGBtoHDMI purchased back in 2022. When I tried to use it yesterday, I only got a green output from my BBC Master.

I thought perhaps there was an issue with the Q8/Q9/Q10 output transistors, but a scope showed similar output signals on each (i.e. colour information).

If I select Colour Test as the profile in the Main Menu, I just get a flashing screen (i.e. black, then back to the menu).

I have tried reprogramming the CPLD to RGB/YUV etc, this makes no difference.

Does this sound like a bad CPLD?

IanSB, 2024-04-03:
@axmandm
>I only got a green output from my BBC Master.

Do you mean green text or just a blank green screen?
Is it a digital board with fixed cable or one with the analog extender and interchangeable cables (which can also be used with the BBC)?

>If I select Colour Test as the profile in the Main Menu, I just get a flashing screen (i.e. black, then back to the menu).
>I have tried reprogramming the CPLD to RGB/YUV etc, this makes no difference.

What CPLD was programmed when you got the flashing?
Does the CPLD programming appear to proceed and finish normally as expected? (Which means the CPLD is at least partially working)

>Does this sound like a bad CPLD?

Possibly, but it could be several other things too like monitor problems, corrupted software, broken wires in the DIN plug or the IDC connector getting unplugged from the 12 way header on the CPLD board.

First thing to try would be to make sure the HDMI cable was fully plugged in at both ends (or try another cable or even another monitor if you have one), then update the software to the latest release in case your existing SD card got corrupted in some way. (Reformat the SD card first, don't overwrite the existing files.)
Then check the connections in the 6 way DIN connector and the 12 way IDC connector on the other end of the cable (assuming a digital board).

It might be useful if you posted screencaps of the source summary page and the system summary page in the info menu (make sure a suitable BBC or Master profile is selected).
Press Up and Down simultaneously while in those pages to screencap the output with files saved to the SD card.

frank-f, 2025-01-02:
I have a kinda related question. In an act of interest and boredom I put together one RGBtoHDMI back in 2022 but somehow it wasn't working right away. I debugged it a bit, then got distracted, it went in a drawer and I forgot about it. Now recently while reorganizing things I found it again, hooked it up to a monitor and was instantly reminded, why it was in the drawer. The screen was blank.
It shows a menu and can program the CPLD programs without error if it is blank, but once it's programmed, it's like the thing is dead. Does something need to be hooked up to the inputs for the Menu to work? Or should I be able to use the menu regardless? Is there a way to test if the CPLD works?

IanSB, 2025-01-03:
@frank-f

>Does something need to be hooked up to the inputs for the Menu to work?

No, you should be able to call up the menus even with nothing connected but if one or more important CPLD pins aren't connected properly or are shorted you can get lockups like that.
Try holding down all 3 menu buttons while booting up to get into the CPLD recovery menu which should allow you to use the buttons. Then go to the info menu, use save log and edid and post log.txt from the SD card

frank-f, 2025-01-03:
Thanks for getting back to quickly. The recovery menu works fine, I used it a bunch of times to reprogram the CPLD already. Here's the log, I hope you can spot something wrong in it. :)
[Log.txt](https://github.com/user-attachments/files/18298320/Log.txt)

IanSB, 2025-01-03:
The log shows
CPLD  Design: Simple
CPLD Version: 0.0

This should show the type and version programmed into the CPLD

This means it thinks it is connected to a c0pperdragon style simple interface for the Amiga, not a CPLD and this is detected when the version pin (33 on the CPLD) is pulled low which can happen when using CPLDs already programmed with other unrelated firmware but might also happen if that pin is shorted to an adjacent pin.

>The supply situation was difficult in 2022 so I had ordered it from AliExpress...

CPLDs from that source usually work but are frequently already programmed with unrelated firmware which will stop you from reprogramming them with RGBtoHDMI firmware.

Are you sure the CPLD is being reprogrammed?
After starting the programming procedure you should see:
Identifying
Erasing
Programming
Verifying
Successful rebooting in 5 seconds
With the whole procedure taking about 20 seconds.
Anything else means it's not being reprogrammed.

If that is your problem, you have to cut the three solder jumpers on the underside of the PCB, JP1, JP2 & JP4, try reprogramming again and if successful remake the jumpers with solder bridges (You MUST remake the jumpers for it to work)
After that normal reprogramming should work without having to cut the jumpers.

On your photos it looks like there might be a short between the two pins arrowed which are 14 & 15 (although that would not cause the current issue) and there are shiny areas between other pins although they might all just be reflections of the light source.

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

If the problem isn't to do with the above rogue firmware, you need to check for shorts between each  adjacent pair of pins with a multimeter if possible, especially around pin 33.

frank-f, 2025-02-02:
I'm sorry that it took me this long, but while cutting the jumpers I had accidentally ripped some traces and never had the time (and motivation) to repair them. However, today was the day. After making the necessary connections I went into CPLD the recovery mode, programmed it, connected the jumpers again and ... it's still not working. Programming takes about 20 seconds, just like you described, but afterwards it still says Simple 0.0. I have really triple checked for loose or shorted pins, everything around the CPLD checks out, especially pin 33. Voltage drop between 33 and GND is 0.6V and between 33 and 32 it's 1.7V, so 33 is definitely not shorted. I have no idea anymore.

Thread 379 (2024-05-05):

Which bus line is broken?

venice1200, 2024-05-05:
Hi,
at first, many thanks for this absolut great Project.
I use the software with my Amiga 500 and C64.

Actually I build a PCB for the A500 from Solarmon but can't get the CPLD programmed.
https://github.com/solarmon

```
RGB to HDMI booted
Running GPU capture build. Kernel version: 20240213 e630d36f
Marked framebuffer from 1EB00000 to 1EC00000 as cached
Pi Hardware detected as type 3
CPLD board detected
8/12 bit board detected
Standard board detected
Using PLLA as the sampling clock
PLLA: 2400.000000 ANA1 = 00000001
...
EMMC: BCM2708 controller power-cycled
Unknown CPLD: identifier = dcf
Keycount = 0
CPLD  Design: 3-12_BIT_BBC
CPLD Version: c.f
Loading file /Palettes/Atari_2600_NTSC.bin
```

I have double checked each line/connection but can't find any problems.
Maybe someone can tell me which one of the 12 bus line(s) is the problematic one so i can take a deeper look.

Full log attached.

Cheers & Thx
[2024-05-05_Serial_Log.txt](https://github.com/hoglet67/RGBtoHDMI/files/15213757/2024-05-05_Serial_Log.txt)

IanSB, 2024-05-05:
@venice1200

```
Unknown CPLD: identifier = dcf
```

The CPLD is already programmed with some unknown code and that will stop initial reprogramming with RGBtoHDMI code.
The reprogramming GPIOs are shared with other pins and if the unknown firmware makes those pins outputs it will conflict with the reprogramming sequence. The fix on a normal CPLD board is to cut JP1, JP2 and JP4 to isolate the reprogramming lines, then program the CPLD, then remake those links. If those solder jumpers are on the equivalent Solarmon board then cut them otherwise you will have to cut the relevant tracks.

venice1200, 2024-05-06:
Hi @IanSB,
I have heard about already programmed CPLD.

I will see what I can do.

Many Thanks

Closed 2024-05-06.

Thread 381 (2024-05-08):

C128 80 columns mode via "Analog board"

c0pperdragon, 2024-05-08:
Disclamier: I don't have a C128, so this idea is purely theoretical.

I believe it possible to wire up the 9-pin video port to be used with the 6-pin Analog inputs. This would be very convenient for C128 users as only one RGBtoHDMI is then needed for both output options (80 columns, 40 columns Lumacode). I could also imagine a Y-cable with a switch for maximum convenience. If there would also be a possibility for the RGBtoHDMI to auto-switch profiles this would be nice.

The cable would just use some resistors to combine the digital RGBI signals to get RG, GB, GI to go into R, B, G respectively. The R and B inputs would need to distinguish between 3 levels and the G would need do detect 4 levels. The SYNC input directly uses the monochrome output from the C128.

@IanSB I don't know if you have a C128 in your collection. If yes, I could build such a cable to give this a test. If this works, I would make a new product from this.

IanSB, 2024-05-08:
@c0pperdragon

Yes that should work with an appropriate profile and I do have a C128

c0pperdragon, 2024-05-09:
I changed my mind a bit here. Instead of such a C128-specific cable, I think it is better to make a generic CGA/C128 cable to feed into the Analog board.
For the sync signal, using a resistor (from HSYNC) with a diode to VSYNC should get a combined sync that will be low for several scanlines to denote vertical sync (same what the ZX Spectrum does natively). I guess the RGBtoHDMI can handle this.

This passive circuitry should be suitable for other 4-bit TTL signals as well. Many users may be able to solder up their own cables (or adapters to DB9) when provided with schematics. This would increase the range of applications for the RGBtoHDMI Analog to a point where it really makes sense to have a dedicated integrated board (like the RGBtoHDMI Mono & Lumacode) for analog inputs only.

I am not sure about the additional comparators on the R and B lines, as the 4-level detection is very rarely needed. Leaving this out would keep costs down a bit and it may also be necessary so to fit everything on the board.
When the IDC-socket is placed correctly, this would also directly fit the existing cases.  :-)

IanSB, 2024-05-09:
@c0pperdragon
>For the sync signal, using a resistor (from HSYNC) with a diode to VSYNC should get a combined sync

There is a 1K pulldown on the sync input so I have previously used two diodes to OR H and V sync but that will only work with +ve going syncs.

c0pperdragon, 2024-05-09:
To create a combined sync that can be interpreted by the RGBtoHDMI, it is probably enough to use two resistors. A smaller resistor (lets say 1K) for hsync and a larger one (2k) for hync. These values are large enough to not strain the output too much, but it should allow quite fast signal propagation. This wiring will form a simple 2bit DAC and I believe by choosing the correct compare point and polarity, this should work like an 'OR' or 'AND'.

The same 2-bit DAC can be used to combine G and I to feed into the G line. I will also add an external 1K pulldown resistor here to get the voltages into the detectable range. The R and B lines can be taken directly.

c0pperdragon, 2024-05-10:
Maybe I will turn the whole solution on its head. My real objective here is to provide a solution to use both output modes (native RGBI or lumacode) of the C128 with a single RGBtoHDMI. But instead of forcing the RGBI signal through the 3-pin analog inputs, maybe it is better to decode the lumacode into digital signals instead to use a digital RGBtoHDMI.

So my current vision is now a small device that plugs into the DB9 output and passes most of the signals straight through to the RGBtoHDMI. It also draws power from the RGBtoHDMI as it is not available otherwise. This device has also a short cable with an RCA plug to fetch the lumacode from the modified RF output. The individual lumacode samples are provided on 2 extra data lines to the RGBtoHDMI. The sync signals are either forwared from the VDC or the VICIIdizer and sent on hsync/vsync (vsync being idle in case of lumacode) of the RGBtoHDMI. The RGBtoHDMI should be able to decide which input is present from this sync signal and switch to the necessary profile.
A very important aspect of this solution is the auto-switching capability. Do you know if there is a reliable way to know from looking at the RGBI port alone if the C128 currently runs in 80 columns mode?

IanSB, 2024-05-10:
>A very important aspect of this solution is the auto-switching capability. Do you know if there is a reliable way to know from looking at the RGBI port alone if the C128 currently runs in 80 columns mode?

No, I don't think there is any easy way to detect as both outputs continuously generate sync.
(There are also some programs that make use of both screens)

>The individual lumacode samples are provided on 2 extra data lines to the RGBtoHDMI.

That wouldn't work as the data would have to be fed to the same pins as the 80 column mode plus you would need to switch the sync.

This seems overcomplicated compared to a simple passive adapter that could be switched with an RCA switchbox and would still have to be manually switched.

c0pperdragon, 2024-05-11:
Without auto-switching this would of course be overengineered for no good reason.

Still I would like to come up with some better solution for the C128. Particularly needing two RGBtoHDMI's is a bit cumbersome. Of course if the user wants two screens at the same time, there is no way around it, but most of the time this will not be the case.
The previous idea forces RGBIHV into RGBS for the Analog board. With a simple double-pole / double-throw switch the G and the S line could be switched between inputs.  Maybe I will indeed go with this.
Just to make sure: Do you think the RGBtoHDMI will be able to auto-switch between both inputs. The distinguishing feature will then be the fact that the or-combined csync from the VDC will have a solid vsync pulse that lasts several lines.

jdryyz, 2024-05-14:
👍 I see I did not have to make my own post on this subject. RGBI from a C128 to RG2HDMI was available for a while. So when Lumacode was announced for the 40 col side, I immediately thought all we need now is a way to get both signals into the same RGB2HDMI board and have it sense which is one is being selected.

Would be very cool if this could happen. I understand some but not all the challenges involved. Is it true that a C128's standard A/V and RGBI have active sync at the same time?

I'm just imagining being able to toggle between modes using the 40/80 col switch alone.   :)

c0pperdragon, 2024-05-14:
@jdryyz  Don't set you expectations to high. It is still not possible to squeeze the VDC output into the single lumacode-line for use with the cheap lumacode RGBtoHDMI. You will have to use an RGBtoHDMI with "Analog board" that has the 6-pin connector (3 color lines, 1 sync, GND, +5V).
But if this goes as I intend, you only need to toggle the switch on the Y-cable.

I am now thinking about the physical appearance of this cable. Which of the following options would you think is most convenient?

1. Female DB9 connector with the switch and one RCA-cable going to the lumacode output and one ribbon cable going to the RGBtoHDMI.
2. The switch and some electronics is on a small adapter that plugs directly into the RGBtoHDMI and has two cables to the DB9-connector and the lumacode output respectively.
3. Like 2, but only with sockets to connect your own RCA and DB9 cable of any length you like.

jdryyz, 2024-05-14:
Agreed my expectations are a bit lofty. I was even thinking the electronics to pull this off would be small enough in cram *inside*, making all the necessary connections internally with a single HDMI connector sticking out somewhere.  :)

In all seriousness, I prefer any solution with the least about of bulk.

In the mean time, I will have to fetch me another Pi Zero.

c0pperdragon, 2024-05-14:
I guess, I just found a solution that is most versatile:
Having just a cable for the RGBI output to go to a 6-pin "Analog board". This uses a few resistors that can be easily fitted into the DB9 connector housing. This cable can be used for the C128 as well as other machine with CGA output.
In my store there is already a cable to bring lumacode to the 6-pin "Analog board". So with manual swapping it is then already possible to use the same RGBtoHDMI for both output variants of the C128.
To bring some convenience to this, I will make a simple switchbox that plugs directly into the Analog board and provides two 6-pin inputs to be manually switched over. This switchbox can also come handy if you want to wire up any two machines to a single RGBtoHDMI.

jdryyz, 2024-05-14:
Excellent!

c0pperdragon, 2024-05-16:
After much pondering, I changed my mind again. Now I believe the best solution for the C128 is actually a VDCdigitizer. This would be an interposer board pretty similar to the VICIIdizer and it would also generate a lumacode signal to be decoded by the RGBtoHDMI. For quite some time I thought the VDC output could not be squeezed into the single lumacode wire, but now I think it can be done with a bit of data compression.
For maxium convenience the VDCdigitizer will have a connector to plug the VICIIdizer into it and the signal from there gets directly forwarded  when the VDCdigitizer is not doing anything. So a single RGBtoHDMI (either Mono & Lumacode or Analog) is necessary and everything is auto-switched.

Please follow over to the new discussion thread if you want to participate in this endeavor:
https://github.com/c0pperdragon/LumaCode/issues/19

c0pperdragon, 2024-05-19:
With the VDCdigitizer out of the picture, the previous solution (cable for CGA/C128 to 6-pin Analog) is the most promising again.
To not lose my specializaion on lumacode I will not build such a cable myself, but I will share my ideas so you can build a cable yourself.
@jdryyz do you have the necessary soldering equipment/skills to try this? It would require to use a standard male DB9 connector and some 1K and 2.2K resistors and a 6-pin ribbon cable and IDC plug.

jdryyz, 2024-05-19:
I have the skills but lacking the time right now. I will be engaged in a minor home renovation that I expect to last a month or so.

I can recommend two YouTubers that would be good candidates, however:

Aaron at the Retro Hack Shack:

https://www.youtube.com/@RetroHackShack

Or Mark from the RetroChannel:

https://www.youtube.com/@TheRetroChannel

Both have featured Lumacode in recent videos, and both are C128 users/modders.

timmcross, 2024-05-19:
I would love to assist in testing.  I have made several RGB2HDMI boards but haven't tried a lumacode board yet.  I have a NTSC C128 and would love to have a solution like this.  Should I order some lumacode boards from lscsc?

c0pperdragon, 2024-05-19:
Very nice!
But you will not need a lumacode board, but a fully-featured Analog board (sandwiched under a digital RGBtoHDMI) for my idea.
Also it is completely theoretical still and maybe you need some support from Ian also to make the software work (but probably it can be done with no programming and only by creating a profile).

So my idea was to force the 6 digital signals from the VDC through the 4 inputs pins of the Analog board by combining certain signals with resistors. The RGBtoHDMI should be able to seperate them out again after some voltage calibration.
If you want, I can write up a detailed wiring diagram, but maybe you can also figure out what I meant:
Combine the G signal with 1K resistor and the I signal with a 2.2K resistor and a third 1K ohm resistor to GND and feed this into the G input on the Analog board.
Combine the HSYNC and VSYNC signal with a 1K resistor each and feed this into the SYNC input on the Analog board.
Connect the R and B signals straight to the R and B inputs.

The new sync can be detected as an OR-combination of HSYNC and VSYNC when the threshold level is set correctly.
The combined G signal will have 4 different voltage levels that should be fairly easily seperable.

For making a switch box for this 4-line signal and the single line lumacode signal, you will only need one double-pole-double-throw switch.

timmcross, 2024-05-19:
Ah, ok.  I have built analog boards as well.  I can see where I stand with parts for those right now.  I will look through your post again and see if I understand it.

IanSB, 2024-05-19:
@timmcross
@jdryyz

This will also require some RGBtoHDMI software support for auto profile switching but it may be some time before that happens as I am currently working on audio support although most of the difficult parts of that have now been solved.

c0pperdragon, 2024-05-20:
When the solution should be so specialized that it will only need to support the combination of the C128's DB9 output with lumacode from the VICIIdizer (and not with arbitrary CGA cards), you can utilize the monochrome output signal that is already provided on the DB9. This can be directly fed into the sync input on the Analog board. So you save 3 resistors here.

c0pperdragon, 2024-05-20:
I made a wiring diagram for a minimal solution. When switching to the RGBI inputs, the monochrome pin is used for the sync signal. As far as I see in the C128 schematic this seems to be an XOR-combination of HSYNC and VSYNC. So the RGBtoHDMI may be able to detect this and provide auto-switching between this and the Lumacode signal which uses different sync pulses.

[c128adapter.pdf](https://github.com/hoglet67/RGBtoHDMI/files/15380094/c128adapter.pdf)

idun-project, 2024-05-20:
I started designing a solution for converting and auto-switching the c128's two video modes a few weeks back, and it also includes LumaCode support. So you can use it to switch to an analog CRT/monitor, or to switch between LumaCode and the VDC, which the circuit converts to RGBS. It also provides 64KB VRAM for the VDC.

open-source hardware project here:  https://github.com/idun-project/r2v2

c0pperdragon, 2024-08-12:
I decided to not pursue this idea any longer. Using the digital VDC output to somehow merge 4 bits into a 3-channel RGB for use with an Analog board ist just not worth it. It is just better to use a digital RGBtoHDMI for this.

Closed 2024-08-12.

Thread 385 (2024-06-07):

C128 high-res monochrome on RGBtoHDMI mono & lumacode

c0pperdragon, 2024-06-07:
Nearly all of my customers who buy the VICIIdizer128 also take the RGBtoHDMI Mono & Lumacode board.
I don't know how many of those would also want to somehow utilize this with the VDC. Maybe it would be a nice option to support at least a grayscale picture with this hardware, because a full support will require a second RGBtoHDMI (or some other quite tedious solution as discussed in https://github.com/hoglet67/RGBtoHDMI/issues/381.

The DB9 connector carries a monochrome signal on pin 7 (unused by CGA) with 4 luminance levels. This would be a perfect fit for the RGBtoHDMI Mono & Lumacode. I could just build and sell a simple adapter that plugs into the DB9 and provides an RCA jack. By swapping the cable between this and the lumacode output the user can switch between 40 and 80 columns mode. A simple audio switchbox may also work.

The monochrome signal is created inside the C128 by OR-ing the R,G,B signals together to get a digital color-or-black signal. The emphasis bit is mixed into this and also an XOR-combination of HSYNC and VSYNC.  I don't exactly know how these 4 luma levels would look like. Maybe emphasized black is too close to non-emphasized color. In this case the user will only be able to get 3 levels of grey if he does not want to modify the signal mixing circuitry. Still for many use cases this would be good enough, like for GEOS or most CP/M applications.

@IanSB
Do you want to give this a try if I build the adapter and send this to you? It will require some time because I would order PCBs using the cheapest delivery option.

c0pperdragon, 2024-06-07:
I studied the schematics a bit more and now I am pretty sure that there are only 3 brightnes levels after all.
When R,G,B bits are all zero it is always black, no matter what the intensity bit says.
When either of R,G,B is one, when we get either gray (no intensity bit set) or white (intensity set).

Closed 2025-08-07.

Thread 391 (2024-07-25):

ZX 48k YUV + analog board

luisfcorreia, 2024-07-25:
Hi,

I've just completed assembly of two Analog v3 boards and have them hooked up to my ZX48k Issue 3b

Just asking if this is "normal" and what can I change to make it work reliably.

Image is the keyboard tester program of DiagCart

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

luisfcorreia, 2024-07-25:
It needs a change in pallete and probably some other stuff, closing as not a problem

luisfcorreia, 2024-07-25:
it's getting better but having U and V connected make no difference, this is the best I can get out of it

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

IanSB, 2024-07-25:
@luisfcorreia
Don't mess with the palette or other settings as that will definitely break things.
The only things that could need adjustment are the DAC settings in the sampling menu and then only by small amounts.

The alternating lines in the first image might indicate the U and V are swapped or that all of YUV are connected to the wrong pins so check that first.

It looks like you are running spectrum diagnostics so the best image to display for testing this is the test card as described here:
https://github.com/brendanalford/zx-diagnostics/wiki/Firmware#testcard

If you think you have connected everything correctly, restore the default config then temporarily change the palette from "Spectrum_48K_9Col" to each of the following palettes in turn and screencap the results:

"Test_4_Lvl_G_or_Y",
"Test_4_Lvl_B_or_U",
"Test_4_Lvl_R_or_V",

Post the above screencaps

luisfcorreia, 2024-07-26:
hey, got good and maybe not so good news

luisfcorreia, 2024-07-26:
However, in my crappy LCD composite video monitor, I get this:
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

Please disregard the pixelation and focus on the gradient difference on the color bars.

What I'm getting right now is a full blown color bar with no difference at all

luisfcorreia, 2024-07-26:
About the [wiki](https://github.com/hoglet67/RGBtoHDMI/wiki/Cables#48k-spectrum-analog-yuv)

These are the pinouts that "work for me"TM.

## 48K Spectrum (Analog YUV)
| RGBtoHDMI 6 way IDC |
| --------- |
| Pin 1  GND |
| Pin 2  SYNC |
| Pin 3  U |
| Pin 4  V |
| Pin 5  Y |
| Pin 6  +5V|

luisfcorreia, 2024-07-26:
All this is with a ZX 48K issue 3b
Trying now with an Issue 2, my original machine from 1982
Currently I'm getting no sync detected

IanSB, 2024-07-26:
@luisfcorreia
>Please disregard the pixelation and focus on the gradient difference on the color bars.
>What I'm getting right now is a full blown color bar with no difference at all

That is expected as it only supports 9 colours rather than the 16 (effectively 15) because there aren't enough comparators to distinguish the two bright levels of each colour in the YUV signal and it is would probably be too noisy anyway.

As mentioned in my previous post about this, the only way to get 16 colours cleanly is to use the vLA82S+ with RGB output or one of c0pperdragon's adapters:
https://github.com/hoglet67/RGBtoHDMI/issues/378#issuecomment-2118604160

However you should be getting two levels of white (plus one level of other colours) as shown in the gallery:
https://github.com/hoglet67/RGBtoHDMI/wiki/Gallery-of-Screencaps
and that doesn't look to be the case plus the white text is a bit distorted so you might have to tweak the Y DAC levels and maybe re-run calibration after that

>Trying now with an Issue 2, my original machine from 1982
>Currently I'm getting no sync detected

Some Issue 1 or 2 Boards may require links fitted to bring YUV to the edge connector, check the schematic.
(This is mentioned in the cables section.)

>These are the pinouts that "work for me"TM.

Can you post photos showing your wiring

luisfcorreia, 2024-07-26:
ok, I did have a small issue with wiring and I can confirm documentation is correct.
I'm getting YUV from very near the ULA (on the Issue 3B), will do Issue 2 after some rest.

As per 9 colors versus 15, I'm more then happy with it.

(I still have plans to tinker with FPGA/CPLD based designs)

Closing this as totally ok for now.

Closed 2024-07-26.

Thread 395 (2024-08-12):

Atari ST monochrome mode without internal modification

c0pperdragon, 2024-08-12:
One of my customers has the use case that he only needs the Atari ST in monochrome mode.  His specific machine (a Mega ST) seems to be very space constraint so he would not be able to add the pickup-board under the Shifter.
Ist there any reason why a purely external solution would not work? Just a cable to take hsyc, vsync, mono from the video port and feed it into a digital RGBtoHDMI (via a 16-pin connector).  Looking at the schematic, it seems the mono signal is basically a TTL digital signal.

It would be great if such a solution could also be used with the Mono & Lumacode board, but merging hsync, vsync and mono into one signal is not really feasable, given that the circuitry would need to work without power supply (no power available either from the ST nor from the RGBtoHDMI in this configuration).

IanSB, 2024-08-12:
@c0pperdragon
>Just a cable to take hsyc, vsync, mono from the video port and feed it into a digital RGBtoHDMI

Yes that should work.

 >It would be great if such a solution could also be used with the Mono & Lumacode board

That should also work. You would have to change all the solder bridges to configure the Lumacode board to accept separate H and V syncs and video on three TRRS inputs:
Tip = Mono Video
Ring1 = Hsync
Ring2 = Vsync

This means cutting the track jumpers:
JP5 1-2
JP6 1-2
JP7
JP8

Then add solder bridges to:
JP5 2-3
JP6 2-3

This would also require a new profile.

c0pperdragon, 2024-08-13:
I did some experiments with my signal generator (I don't have an ST) to create some form of 72Hz monochrome analog signal. It seems the 32MHz pixel clock is quite beyond what the RGBtoHDMI Mono & Lumacode can do.
So for the ST, the only option is still a digital RGBtoHDMI, even if only the monochrome mode is needed.
But I will try to offer the aforementioned cable for a non-mod option.

IanSB, 2024-08-13:
@c0pperdragon
>It seems the 32MHz pixel clock is quite beyond what the RGBtoHDMI Mono & Lumacode can do

What multiplier setting did you use?
The YUV firmware has a fixed x8 multiplier so it would not work with that as 32x8 = 256Mhz and the sample clock limit is about 180Mhz. The RGB firmware has an adjustable clock multiplier and setting to x4 would use a clock of 32x4 = 128Mhz which is within the limit. The comparators are rated up to around 100Mhz so should cope with a 32Mhz signal

You can use the existing mono sub-profile from the Atari ST profile as a starting point but will probably need to adjust the analog threshold levels.

c0pperdragon, 2024-08-13:
Using the RGB firmware and setting sample depth to 1 bit totally worked! There is even quite some margin now for setting the sample phase. I guess a real Atari ST will not produce such a perfectly timed signal as my test device, but it will very likely be good enough.
So, to make a solution that fits into the family, I need to make an adapter plug that creates such a mono signal with embedded csync, exposed on an RCA socket. XOR-ing hsync,vsync is good enough, as shown by my demonstration. The real issue now is that the atari video connector provides no power. Maybe I can harvest just enough power from the csync output to drive the circuit.

c0pperdragon, 2025-08-07:
I close this as my current solution for the Atari ST now uses the RGBtoHDMI with analog inputs (6 pin IDC connector) and this works without any active or passive components. Just wiring and plugs.

Closed 2025-08-07.

Thread 403 (2024-09-16):

Color palette issues (lumacode)

sideburn, 2024-09-16:
I’m still having issues with this lumacode / rgbtohdmi on the PAL 65XE

I’ve noticed now that the colors are off. When I bring up Atari Control Picture, the Y should be yellow and it is green. The B for blue is purple. And the R for red is orange. The bottom right corner of the color swatches should be yellow hues and they are green.

I tried adjusting the the settings in color palette and dac settings sample menu but no luck yet. Any ideas ?
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

IanSB, 2024-09-16:
@sideburn

Try adjusting the Pixel H Offset in the sampling menu
(Make sure any other changes you made to try fixing this have been undone)

sideburn, 2024-09-16:
I tried that as well. Photo attached of current settings. I have switched displays to a more modern one. Could it be something to do with the display not handling PAL maybe? I can switch back to the other monitor as a test. On Sep 16, 2024, at 1:42 PM, IanSB ***@***.***> wrote:
@sideburn
Try adjusting the Pixel H Offset in the sampling menu
(Make sure any other changes you made to try fixing this have been undone)

—Reply to this email directly, view it on GitHub, or unsubscribe.You are receiving this because you were mentioned.Message ID: ***@***.***>

sideburn, 2024-09-16:
Current settings :

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

IanSB, 2024-09-16:
@sideburn

G Hi is far too high, it should be around 1.57v  + or - a relatively small amount, not 2.59v. G Mid and G Lo are lower than default but at least they seem plausible values. This means at least one of the 4 voltage levels isn't being detected properly.

I suggest restoring the profile and trying your adjustments again but limit all adjustments to small amounts although I think your underlying problem seems to be a very noisy power supply so getting clean power might be something else to try.

sideburn, 2024-09-16:
Well, I have tried multiple power supplies including a 5 amp battery.
Do you mean to the logic board? I get the same results from the 65xe and the 130xe.
currently i am powering the RGBtoHDMI separately from a 2A usb power supply.
The logic board is powered by a separate 2A supply.

here is what the default settings look like:

￼

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

sideburn, 2024-09-16:
I may have to throw in the towel with this and try a Sophia or some other solution. I have spend days and hours fiddling with it. Changing out machines, power supplies and tweaking all of the params I can think of and the closest I could get was with those higher numbers. but so far no settings that I throw at it get the color palette any closer. Running out of ideas...

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

IanSB, 2024-09-16:
@sideburn
I suppose it's possible that the RGBtoHDMI mono/luma board is faulty/damaged in some way that would cause it to have degraded performance or there is something wrong with the GTIA adapter board but as you were also having some noise issues with the superboard then maybe the former is more likely.

The only suggestion I have is to power the Atari from it's original linear PSU and use a different monitor with a built in USB hub, powering the Pi zero from that via a USB to micro USB cable as that will likely be a reasonably clean supply.  If there is still a problem then it may well be a bad board.

sideburn, 2024-09-16:
Yeah I think the board is bad… I have tried a 130Xe, 65xe, and superboard.. I have tried USB power supplies, wall wart supplies, and my bench power variable power supply all powered from same supply and each powered separately from seperate power supplies. I have also tried 3 different displays. One being an HDMI TV and two being flat panel monitors. I have exhausted all params and the 200/50 DAC settings are the only ones that get me remotely close and no matter what I get sprinkles of noise always in addition to the color palette issues I have now discovered.

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

eightbit0675, 2025-01-27:
I had an issue with wrong colors on the VIC-20 using the lumacode YUV profile. It wasn't until I used the profile named "unterm" that the colors were properly set. I have no idea why that is, but I am not complaining as now it works. Before the colors were all completely wrong and no amount of sampling adjustment could fix it.

When I set the unterm profile (what does that mean anyway?) it programmed the RGB2HDMI and rebooted and everything was perfect.

NTSC VIC-20 btw.

IanSB, 2025-01-27:
@eightbit0675

Unterm means unterminated i.e. 75ohm video termination is disabled. This has the effect of increasing the lumacode signal from about 1v peak to peak to 1.5v peak to peak which increases the noise margin so can be tried if there are problems with the standard terminated profile. It was included for just such situations as yours. (e.g. different PSUs on the VIC and the Pi might have different amounts of noise that affect the lumacode signal.)
Do you know what revision of VIC 20 you have and what issue and type of RGBtoHDMI you are using?

eightbit0675, 2025-01-28:
This is it with disabled video termination. Big difference :)

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

IanSB, 2025-01-28:
@eightbit0675
>Well, I did have to increase saturation from 100 to 165 to get it to look like "how I remember", but the colors are correct and the image is perfect with this profile.

There will be an updated palette based on the vice emulator palette in the next beta release which should be more saturated

>I asked c0pperdragon first and he thought it was weird that YUV did not work properly. It looked like this before:

That is strange, the expected problem would be a noisy image, not clean with wrong colours.

Which software version are you using?
Current Links here:
https://github.com/hoglet67/RGBtoHDMI/wiki/Latest-Software

Note if you install a new version you have to wipe the SD card to ensure all files get updated.

eightbit0675, 2025-01-28:
I've been using Beta 65 on this as well as my MCE2HDMI (Tandy 1000) with no issues (except for what I mention here in regard to the Vic-20). I went back to the Feb official release that rolled up everything up to Beta 64 according to the release notes, and it is the same thing.

I wiped the card each time before switching of course to ensure I have a fresh install, I am a little anal about doing that. I never copy over files ;)

Yeah, the image was pixel perfect, just completely wrong colors. Odd, I know. When I saw this thread with the OP having color issues I felt best to bring this up. I wonder if his problem is the same.

IanSB, 2025-01-28:
@eightbit0675

I can actually reproduce those colours by changing the sampling mode from "6 bits (4 level)" to "6 bits per pixel" (which only detects three levels) in the sampling menu although how that is happening with your setup is unknown.
Do you use lumacode boards with any other computers and if so do the YUV profiles work OK?

eightbit0675, 2025-01-29:
I just found something I think. When I use the profile for YUV (and I am back to the strange colors) and I enter the sampling menu, it is set to "6  bits per pixel" and it cannot be changed. I cannot scroll through any other options.

However, when I am set to "unterm" profile, it is set to "6 bits (4 level)" and the color is accurate, and I CAN scroll through the other options and choose the option that detects only three levels.

Maybe there is something wrong with the YUV profile? Why would it be stuck on 6 bits per pixel and no other option to change?

IanSB, 2025-01-29:
@eightbit0675

When you are in YUV mode can you use the save log and edid option in the info menu and post log,txt

eightbit0675, 2025-01-29:
Attached!

[Log.txt](https://github.com/user-attachments/files/18588925/Log.txt)

IanSB, 2025-01-29:
What type and issue of RGBtoHDMI board are you using? (i.e. mono/lumacode or standard CPLD with analog board) because the log indicates that it thinks it is running on a 6 bit CPLD board which is a very old design:
```
Pi Hardware detected as type 1
CPLD board detected
6 bit board detected
Standard board detected
```
That would explain the problem because 4 level analog used by lumacode is not supported on that old design which is why you can't select 4 level in the menus.

One possible cause for this is that R7 is missing, faulty or not soldered properly (R7 is a 1K resistor near the reset button)

eightbit0675, 2025-01-29:
I'd have to open this to find out. I didn't build it. There is a person on Tindie selling these pre-built. But, before I do that I will email him and see what he says.

eightbit0675, 2025-01-29:
This is the link to the sale page:

https://www.tindie.com/products/rdupuy5000/rgbtohdmi-hdmi-adapter-analog-version-complete/

Says its:

RGBtoHDMI CPLD board
RGBtoHDMI Analog Board

eightbit0675, 2025-01-29:
In the meantime I opened it (I was afraid of cracking the 3D print, but it was OK!)

Looks like R7 missing?

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

eightbit0675, 2025-01-29:
The person on Tindie has reached out and admitted to the error. Very nice person and is sending me a replacement hat with R7 in place.

I appreciate your help Ian, I would have never discovered this without it!

Thread 404 (2024-09-16):

Color is lost and displayed in B/W

clumpwork, 2024-09-16:
I turned on my Apple IIe for the first time in almost a year and noticed that it could no longer display colors. The display is in black and white. Text and graphics are still displayed, but the colors are completely lost. The cable connection is fine.
I have also confirmed that there is no problem with Raspberry Pi Zero. Could this symptom be the result of a CPLD malfunction?
I would like to investigate the cause of the problem, but any advice would be appreciated.

IanSB, 2024-09-16:
Try adjusting the Y Lo DAC value in the sampling menu as suggested in the info menu under "Help NTSC Artifacts"
Also you can try the artifact colour manual override by holding SW2 for a couple of seconds (with no menu on screen) to toggle colour artifacts on/off.

clumpwork, 2024-09-17:
Thank you for your answer.
NTSC artifact detection is working. I have tried toggling color artifacts on and off as you suggested, but the symptoms remain the same. I have tried rebooting the CPLD and updating the software to the latest version, with the same result.

IanSB, 2024-09-17:
@clumpwork
Which profile have you selected?
Are you using an analog board via the phono output or a direct digital pickup?
When you do a long press of SW2 do you get the "NTSC color on" or "NTSC color off" message displayed?
Can you post a screenshot of the showing the graphics (that should be in colour) after "NTSC color on" has been displayed.
Also it's probably worth using the "Save Log and EDID" option in the info menu and posting log.txt from the SD card

clumpwork, 2024-09-18:
Thanks for your comment.
The profile I selected is “Apple IIe TTL”. I used “A direct digital pickup” for the connection, and when I pressed and held SW2, the message “NTSC color on/off” was displayed.
Attached is a screenshot of the graphics are displayed in B/W instead of color and log.txt file .
What I don't understand is that the graphics suddenly changed to B&W, even though they were in the same state as before. I may need to borrow a friend's RGBtoHDMI to see if it is reproducible.
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
[Log.txt](https://github.com/user-attachments/files/17046403/Log.txt)

IanSB, 2024-09-18:
@clumpwork

OK it looks like the colour switching signal (IOU GR) which is connected to Green2 (pin 4 on the 12 way CPLD header) is not working. This could either be due to the wire being disconnected inside the Apple IIe or maybe that input had a bad solder joint on pin 36 of the CPLD or the CPLD is damaged in some way.

clumpwork, 2024-09-19:
Thank you for showing me your detailed analysis.
I have checked the signal from the Apple IIe and there is no problem. There is also no problem with the RGBTOHDMI board, and the signal goes through to pin 36 of the CPLD.
Then the cause of this symptom is probably the last one, the damage of the CPLD.
I will try to replace the CPLD.

clumpwork, 2024-09-29:
I got a new CPLD and replaced the damaged one. The problem was solved. I can now display in color. Thank you!

Thread 405 (2024-10-06):

Sega Megadrive 2 cabling

G4DDS, 2024-10-06:
Have been given a Mega Drive 2 and tried using a SCART lead (with another converter) but would prefer a crystal clear HD picture. From the cables section I see there are no consoles at all, but surely its just as a matter of wiring up the correct lead? The video pin outs have RGB, GND and CSYNC so is it just the same setup as an one of the existing Analog setups (like Amstrad or Spectrum +3):

Pin 1 GND
Pin 2 SYNC
Pin 3 BLUE
Pin 4 GREEN
Pin 5 RED

G4DDS, 2024-10-11:
I've had a go but not making much progress. I have followed the Amstrad wiring and selected that as a profile. I kept getting a blank white screen but I discovered changing the DC coupling to AC (which I believe should only be used with YUV and not RGB) I get some sort of picture:

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

I don't want to spend too much time and effort if I am going down the wrong path with this. Is the Amstrad wiring suitable? Is there another base profile that maybe better to work with?

IanSB, 2024-10-11:
@G4DDS

This isn't really going to work well because the analog board can only discriminate 4 levels each of RGB but the palette of the megadrive has 8 levels each of RGB. With the correct profile you would get a reasonable image but colours might be slightly inaccurate or flickery.

Anyway, here are a couple of base profiles to try:

[NTSC_4LVL_Base.txt](https://github.com/user-attachments/files/17344911/NTSC_4LVL_Base.txt)
[PAL_4LVL_Base.txt](https://github.com/user-attachments/files/17344912/PAL_4LVL_Base.txt)

Put these in \Profiles\6-12_BIT_RGB_Analog\_Base_Profiles and select the PAL or NTSC one as appropriate
These have 4 level palettes selected but you will probably have to adjust the DAC levels for lo, mid and hi depending on the analog video levels output by the megadrive and you will also have to use the Create Custom Profile menu and Analyse Timing etc to get the settings right.

It looks like the video is analog RGB out of the video chip so it wouldn't be possible to pick up the digital bits directly like you can with some systems so the only other alternative would be a c0pperdragon style lumacode board if one was developed.

c0pperdragon, 2024-10-14:
Sorry, but the Mega Drive is just out of reach of my possiblities and the abilities of the lumacode system.

G4DDS, 2025-03-30:
I'll close this issue as I know have an alternative to the RGBotHDMI for the Mega Drive.

Closed 2025-03-30.

Thread 410 (2024-12-12):

Slightly different wiring of a Spectrum 128+ for Analog board

c0pperdragon, 2024-12-12:
The Spectrum 128+ is the only Spectrum that would require a digital RGBtoHDMI. All the others will work with the analog variant. With the lumacode modification, even the 16K/48K variants can use this and show all 16 colors.
You have provided instructions how to combine R,G,B and I to make it somhow work, but this hack will basically cause the ULA pins to be shorted together, which is not so great in my opinion.

Maybe a better way would be to just combine G and I with 1K and 2K resistors to create 4 voltage levels. From this, the state of the I output could always be determined, regardless of the state of the color signals. Maybe this could even be useful to show the gray color if the user wants this.
To stay in the allowed analog range for all 4 combinations, an additional 1K resistor to GND is also needed.

I could build these resistors into the cable, and it would be easier than with diodes because their orientation would not matter.

Can you think of any reason, why this should not work?

IanSB, 2024-12-18:
@c0pperdragon
The ULA pins aren't directly shorted together as there are already some resistors in series with the RGBI out on the 128. A similar diode circuit is implemented in the +2A. Your suggestion might work but I don't have that particular hardware to do any tests.

c0pperdragon, 2024-12-18:
So if the wiring with the diodes is the true and tested variant, I will provide cables that are wired like that.

Closed 2024-12-18.

Thread 412 (2024-12-20):

Oddball request

snhirsch, 2024-12-20:
One of my favorite vintage machines is a Corvus Concept desktop.  It was sold with a Ball Bros. CRT monitor that could mount in landscape or portrait orientation.  A switch on the CPU unit rotates display accordingly.  When configured for landscape, the display is "upside down" with the origin at lower right, scanning to left and upwards.  In portrait, the display origin is upper right, scanning down and to the left.  Short of performing gyrations with the monitor, is there any way to use rgb2hdmi to normalize the output for display?  The video output is an otherwise rather standard video/H/V sync.  I've been able to use it with an older Extron scaler, but that required the referenced gyrations :-).

IanSB, 2024-12-21:
@snhirsch
The Pi has a config.txt option for changing the frame buffer display scan orientation as follows:

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

I have tried all the above options of this by manually adding the setting to the config.txt file and most of them have issues like flickering menus and screen corruption probably due to the way that RGBtoHDMI works.

For the scanning you mention above, the options would seem be
display_hdmi_rotate=2
or
display_hdmi_rotate=0x10000
or
display_hdmi_rotate=0x20000
and they does seem to work enough to get an idea of if they would be useful. These problems might be overcome with some code changes so I will have a look at this sometime.

You could try the above yourself by adding one of the above lines to config.txt in the Common video settings section

Do you have any further info on the Corvus Concept video like number of bits per pixel or resolution?

snhirsch, 2024-12-22:
Thanks for getting back.  I'm not actually have any success in getting a display - rotated or otherwise.  On my Extron 300A scaler, I get a perfect (rotated) image with these parameters:

- Total pixels per line = 928
- Phase = 4
- Hstart = 70
- Vstart = 126
- Active pixels = 720H x 560V

Hsync is positive going @ 35.5KHz.  Vsync is negative @ 30Hz
Monochrome video B&W

With the analog board installed on the rgb2hdmi I tried grounding pins 1,3,5 connected hsync to 2 and video to 4.  It complains about "NO SYNC" and presents a totally garbaged display.  I could get the no sync warning to disappear by backing down the voltage level in sampling, but I'm unable to successfully dial in the geometry.  If I try to set the clock to 35Khz. or change the line length, the screen goes solid green and the unit stops responding.  Not sure where to go at this point.

IanSB, 2024-12-22:
@snhirsch
>Hsync is positive going @ 35.5KHz. Vsync is negative @ 30Hz
>Monochrome video B&W
>With the analog board installed on the rgb2hdmi I tried grounding pins 1,3,5 connected hsync to 2 and video to 4.  It complains about "NO SYNC" and presents a totally garbaged display.

The analog board only has composite sync input with no separate inputs for H/V sync so for full RGB support you would first have to combine the H and V syncs to make composite.
However I recently realised that it would be possible to feed separate H and V and mono video into the analog board in a slightly unusual way because the green input supports sync on green so try the following:
Feed Hsync into the sync input
Feed Vsync into the green input
Feed Video into the blue input.

Set "Palette" to Test 4Lvl B or U in the palette menu (This displays only the blue channel)
Set "Sync type" to +H-V in the geometry menu
Set "Sync on G/V" to Off in the sampling menu (not on as that makes it look for composite sync)
Then adjust the sampling menu DAC levels as follows
DAC A - Disabled
DAC B - Disabled
DAC C RB Hi for video level
DAC D RB Lo Disabled (or can be adjusted for multi level mono video)
DAC-E Sync for hsync level
DAC-F G V Sync for vsync level

Note that a new beta due soon will map the standard mono palettes on the blue channel in a special new mode to support this as the test palette is not really the correct option but it should allow you to test it with the current release.

snhirsch, 2024-12-22:
That's a bit better (see attached screen grab), but I'm not able to dial in the geometry properly.  If I try to set total line length to anything but the default 1000, I lose the entire screen display - menu included - and have to power cycle to get it back.  I do not understand the the difference between H & V size and Max H &V size on the geometry menu.  Nothing I do mitigates against the multiple copies of the display.

And, this is not stable.  If I exit the menu it starts flashing 2x per second.

Here's the capture:
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

And this is what the Extron renders:
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

Any clarifications and/or suggestions appreciated.  It would help if you can clarify which base profile I'm supposed to be using.  There are (2) RGB profiles in the list.

IanSB, 2024-12-22:
@snhirsch
> I do not understand the the difference between H & V size and Max H &V size on the geometry menu.

Once you have setup the above things, you should be using the Create Custom Profile menu which auto sets most things like that to sensible defaults based on the incoming sync timing so you would only need to adjust the number of clock cycles per line or the pixel clock.

However it looks like the pixel clock rate for this screen is quite high and if it is >30Mhz then you will need to reduce the bits per pixel from 6BPP to 3BPP

So, make the above changes, set the Sample mode to 3 bits per pixel in the sampling menu then go into the create custom profile menu and change the clock cycles per line to the correct value or the pixel clock to the correct value (the other will auto adjust based on the sync timing)

You can then make other tweaks like the offsets.

snhirsch, 2024-12-22:
Thanks, I followed your advice and was able to dial in a beautiful display.  Unfortunately it starts flashing on and off when I exit the menu.  So something is still not right.  What I do not understand is why the display is stable when the menu is visible.  If it can lock to it under those circumstances then why not when I exit?

Here's the capture of the flashing display:
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
And here is my saved configuration:
[Custom_Profile_0_.txt](https://github.com/user-attachments/files/18223549/Custom_Profile_0_.txt)
If there's a way to stabilize this it would be great.

IanSB, 2024-12-22:
@snhirsch
>What I do not understand is why the display is stable when the menu is visible. If it can lock to it under those circumstances then why not when I exit?

When the menu is on some code to do with detecting problems with the timing is disabled so you can actually make adjustments without the screen flashing but when the menu is off that code is enabled and that makes the screen flash indicating there is a timing problem. (note when the menu is on every other frame is being dropped and if that happens when the menu is off then the screen will flash)
There are two types of causes for flashing, as detailed in the help menus in the info menu under "help flashing screen". One is due to the screen capture size being too large which can be addressed by reducing the max H and V sizes and the other is timing related.
First try reducing the Max H and V sizes to match the Min sizes or make them only slightly larger (which guarantees that the edges get captured when there is slight timing misalignment).
Currently the max V size is set to 610 which is greater than the number of lines per frame (588) which could cause frame drops.
If that doesn't work then post a screencap of the source summary page (press up and down buttons to screencap the page)

IanSB, 2024-12-23:
@snhirsch
To explain further about the min/max sizes, the min size is set to the actual pixel resolution and the max size is set to the overall active video size including any coloured border. Your particular screen doesn't seem to have any border so they can be set the same but that then means that the H and V offsets in the geometry menu and the Pixel H offset in the sampling menu have to be set very accurately to capture the image so having the max values a few pixels larger than the min can help if there is any misalignment.

snhirsch, 2024-12-23:
Thanks so much for all the help!  I have a crisp, stable display now.  Here are some screen shots and the config file.  Please let me know if anything looks out of place?
[concept.zip](https://github.com/user-attachments/files/18230533/concept.zip)
Just FYI:  I think the wording about "screen size too large.." in the "Flashing Screen" help should be clarified to explicitly mention the exact settings under geometry.  The word "size" is heavily overloaded.  I originally thought it was referring to the frame buffer and didn't quite get it.

The only nit I noticed is that screen capture failed when I tried to grab a full display of the Concept word processor.  When I press the 'down' button it flashes... something on the screen too quickly to read.  In the capture directory I found a 75 byte file that represented the header of a PNG, but was corrupt and could not be viewed.  A grab of the empty screen did work correctly.

snhirsch, 2024-12-23:
I moved on to try rotating the display.  Unfortunately adding:

`display_hdmi_rotate=1`

to config.txt in the root of the SD card has no effect at all.  Am I misunderstanding something?

snhirsch, 2024-12-23:
I made the changes you suggested to sampling and geometry - thanks.  Rotate does take effect when it's ahead of all the other video settings.  It actually looks quite good, but I cannot get it to lock (flashing).  Do I need to transpose the dimensions manually - or should I generate a new configuration?  Recalibrating did not help with the flashing.

Regarding corrupted screen capture - it seems to have something to do with scanlines.  If I turn off scanlines it claims to have captured the image, but there is nothing in the capture directory.  After reverting the rotation mods I'll take another run at it.

IanSB, 2024-12-23:
@snhirsch
 >It actually looks quite good, but I cannot get it to lock (flashing). Do I need to transpose the dimensions manually - or should I generate a new configuration? Recalibrating did not help with the flashing.

I don't think there is anything you can do to get it to work any better at the moment, some code changes will be required.
The main problem is there is too much memory contention causing dropped lines or frames because you have to have one side reading or writing across the memory rather than sequentially and that requires a lot more cycles.

>can I actually log into the Pi Zero when it's running rgb2hdmi? I thought the video code ran on bare metal.

No, you can't log in as it is bare metal and there is no OS.
It does generate a serial log which you can view live by connecting a terminal program to TxD on the 40 way header (115200 baud 8 data 1 stop no parity) or you can save the accumulated log to the SD card using the Save log feature.

snhirsch, 2024-12-26:
Hi, Ian.  I tried using a 180-degree Pi rotation with the Concept landscape mode (more practical for contemporary monitors) and it works perfectly aside from the upside-down rgb2hdmi menus.  Along the way I discovered that Concept video has an extra pixel or two in the horizontal direction and bumped up the 'max' setting accordingly.  This may well have helped with the rotated image but I didn't go back to verify.  I discovered it using one of the Concept's diagnostic features to put up an alignment grid.

Attached is my final working configuration file along with setup and cabling notes.

Thanks SO much for the help and input.  You folks have designed a great gadget!

[concept_setup.zip](https://github.com/user-attachments/files/18253850/concept_setup.zip)

IanSB, 2025-01-01:
@snhirsch
Thanks for the update. I have included your profile in the latest beta65 which I have uploaded on my fork of the project here:
https://github.com/IanSB/RGBtoHDMI/releases

You will still need to edit the config.txt for the rotate and l2cache settings but the profile now makes use of a new setting in the palette menu "Mono Palette" which switches mono usage between the green, blue and red channels so you can then use the standard mono palette with any option and don't need the test palette.

I have updated your profile with that setting and put it in the "Other" section of the profiles so can you test that and confirm it still works.

snhirsch, 2025-01-01:
It's not working properly for me.  The bottom of the display sort of comes and goes periodically - not flashing but simply invisible some of the time.  Also, for some reason my custom saved profiles are not appearing in the select list. I did copy the entire Saved_Profiles tree but it's not recognized.

IanSB, 2025-01-01:
@snhirsch
>It's not working properly for me. The bottom of the display sort of comes and goes periodically - not flashing but simply invisible some of the time

Thanks for the feedback. I'll have to figure out when that got broken.

>Also, for some reason my custom saved profiles are not appearing in the select list. I did copy the entire Saved_Profiles tree but it's not recognized.

Saved profiles are only visible if there is a matching named profile in the Profiles folder tree which there won't be on a new install so put your saved profile in the Profiles folder tree at the same location instead.

snhirsch, 2025-01-04:
Let me know if you need any more information on the "comes and goes" lower screen display.  Certainly strange behavior.  There is no sync instability at all and it looks perfect when the bottom 1/3 of the screen deigns to become visible.

IanSB, 2025-01-11:
@snhirsch
This happened because I made some internal changes so the software which now drives the hardware directly rather than going through the Pi's embedded firmware as that freed up one of the VPU processor cores for other things and those changes can't cope with the rotated image.
However I ultimately intend to solve the rotation by adding dedicated capture code for those orientations which would mean that the menus would always be the right way up so it will be fixed by that but it may be some time as I have other things to address first.

In the meantime, stick with the current stable release and I will @ you when I have a new beta with those features implemented.

mabalmer, 2025-02-27:
Being able to flip the display would be really handy in general -- I have a capture setup where, due to the orientation of two of the cameras involved, the source (an ATEM switch) in OBS is flipped 180º. If I add the RGB2HDMI to that, I have to un-rotate the source to turn the display right-side up.

Thread 418 (2025-02-07):

Can't get a stable picture with NS405 based video card (MFA Microcomputer)

hanshuebner, 2025-02-07:
Hi,

I'm trying to use a rgb2hdmi with the 6-12 bit analog RGB board to capture and display the output of an NS405 based terminal card for the MFA Microcomputer.  Following the instructions, I have set the pixel clock to the 18.181818 Mhz stated in the NS405 data sheet and tried to adjust the sample and geometry settings, but I am unable to get a completely stable picture.  Here is a little video that shows the display instability: https://youtu.be/xSTXlyKJk7E

Does anyone recognize this type of problem and know how to fix it?

Thanks in advance!
Hans

IanSB, 2025-02-09:
@hanshuebner

There are several possibilities:
1. You have the wrong pixel clock. Can you confirm there is an 18.1818 Mhz crystal on the board?
2. The video signal is being chopped up by the pixel clock which means that the clock setting and corresponding H pixel dimensions have to be doubled to sample properly.
3. The signal you are picking up isn't at full logic levels and is a lower voltage. The data sheet for that chip shows it has an intensity bit which can be used with external circuitry to reduce the video level. (This can be worked around by picking up the video signal earlier when it is at TTL levels or using an analog RGBtoHDMI which can be set to any arbitrary voltage levels).

Do you have a schematic for the terminal card showing the video path?

hanshuebner, 2025-02-09:
@IanSB Thank you for getting back!  I've had another look at the NS405 data sheet and the schematic, and I found that the pixel clock is equal to the frequency of the crystal that is installed on the board, which is a 12 Mhz part.  I've tried to use exactly that frequency and doubled it, but both attempts resulted in the picture to be multiplied and unreadable.  The best I can seem to get is this:

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

These are also the settings in the video.

The schematics for the video card is this:

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

The character cell size on the display output is 7x12 pixels, if I am reading the [datasheet](https://ataribits.weebly.com/uploads/5/8/8/6/58865739/ns405_video_controller.pdf) correctly.  The standard resolution of the output at 80x25 characters is 560x300 pixels, although it is possible to change that to 96x29 (672x348).

I've also connected the video card to a multinorm Sharp LCD TV which is very forgiving and displays most signals that are somewhat TV compatible.  It also displays the NS405's output just fine and appears to be stable, but it is hard to be sure as it has a fairly low resolution.

I'm rather lost, so further instructions would be most appreciated.  Thanks in advance!

hanshuebner, 2025-02-09:
I forgot to include the geometry settings:

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

hanshuebner, 2025-02-09:
@IanSB I've wiped the SD Card and installed beta 65.  I've then adjusted the Sync settings to match the profile that I had before so that I could enter the "Create Custom Profile" menu.  There, I set the pixel clock to 12 Mhz and the geometry to 560x300.  With that, the picture is stable and sampled perfectly.  As soon as I leave the setup menu, however, the screen starts flashing between the perfect image and a completely black at about 1 Hz.  Here's my settings so far:

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

Thank you for helping with this!  It seems I'm getting closer, but your further advice will be much appreciated!

IanSB, 2025-02-09:
@hanshuebner
Did you save your new custom profile in the custom profile menu and exit / reboot?
Also posting the source summary page from the info menu would be helpful.

hanshuebner, 2025-02-09:
@IanSB I've rebooted a couple of times.  I've tried a couple further adjustments, but the flashing remains.  Here's the source summary page:

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

hanshuebner, 2025-02-09:
@IanSB  I've adjusted the line length, but the flashing is still the same:

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

IanSB, 2025-02-09:
@hanshuebner
The height and voffset are too large:
voffset + height = 22 + 300 = 322 but there are only 312 lines in a frame so it is running off the end of the screen

This means that 300 is probably not the right value for the height
Font size is 7x11 and there are 25 lines = 11x25 = 275 so set Min and Max height to 278 and adjust voffset to centralise that
The total of voffset and height must be less than 312 by at least several lines

hanshuebner, 2025-02-09:
It is coming together!  I've made the adjustments you suggested and also tuned the DAC-A level a little to get rid of some pixels flickering, and now the picture is completely stable.  I will try to display some text with the intensity attribute set to see if that works or if it requires some more tweaking that I'll probably also need some help with.

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

hanshuebner, 2025-02-09:
I've just reviewed the documentation of the terminal card firmware and it seems that it does not support intensity.  Thus, I think this can be called done and a complete success.

```
sampling=2,2,2,2,2,2,2,0,7,0,5,0,0,0,0,0,1,8,1,0,57,256,256,256,256,16,256,256
geometry=128,22,560,300,560,300,1,2,0,1,12000000,817,5000,342,4,0,0
palette=RGBrgb_(Amstrad)
scanline_level=0
```

This is the  BFZ/MFA 8.4 video card which is part of the MFA Mikrocomputer system, an educational, modular system from Germany based around the 8085 microprocessor.  The profile should probably be called  "BFZ/MFA 8.4 (80x24 mode)".

IanSB, 2025-02-09:
@hanshuebner
The profile info will probably have to come from /saved_profiles (assuming you used save configuration after making those changes), not /profiles as the data shows the line length as 817 and max/min as 300 which were the unadjusted values so can you repost that file data from the right folder

It looks like the hardware is configured for intensity support though as that bit is on pin 25 which is connected to the video circuitry

hanshuebner, 2025-02-09:
@IanSB Here's the right file:
```
sampling=0,0,0,0,0,0,0,0,7,0,5,0,0,0,1,0,1,0,1,0,60,256,256,256,256,36,256,256
geometry=164,31,560,278,560,278,1,2,0,1,12000000,770,5000,342,4,0,0
palette=RGBrgb_(Amstrad)
scanline_level=0
```
I've seen that the intensity output is connected, but the terminal firmware does not appear to have support for controlling it.  I'll ask around if someone has another version.  Note sure if I want to venture into patching the 8048 code myself.

Thank you again for your help!  I'm very happy to have this system on my main retro monitor now!

IanSB, 2025-02-09:
@hanshuebner

Something still not quite right about that as the number of lines per frame in geometry is set to 342 and that should be 312 as shown in the status page. (This was probably set incorrectly during the initial save custom profile because of the error setting the pixel height to 300)
This doesnt actually cause a problem unless there are multiple sub-profiles in a folder to auto select but it should be set correctly and it would have been if the initial pixel height value was correct I think.
I will correct that on the profile I include in the next release.

hanshuebner, 2025-02-09:
@IanSB I've made that adjustment as well and can confirm that the profile still works after I've made that change.

IanSB, 2025-02-09:
@hanshuebner
If you get intensity support working, you need to make the following changes:

In the Palette menu:
Change the palette to "Mono 3 level bright"
(To get green change Output colour to Green)
In the sampling menu
Change the Sample mode to "6 bits per pixel"
Change the clock multiplier to x8 (This should be changed anyway as x4 is low for 12Mhz)
Adjust DAC-A G Hi for the bright threshold
Adjust DAC-B G Lo for the dim threshold (will be lower than DAC-A)

Closed 2025-02-09.

Thread 420 (2025-02-21):

Apple IIc Questions

nick3092, 2025-02-21:
I had a couple questions on the output from the IIc.  First one I think is pretty easy.  I saw another issue where it was reported the IIc output could be run through the DB9 buffer board, but there was no indication as to what the pin mapping would be to do so.  It would make life a little easier as I could just leave the buffer board attached, instead of putting it on and removing it depending on my use case.  So I was curious what the pin mapping would be for that.

Second, I had a question on the way the color output is showing up.  In addition to the RGBtoHDMI, I can also get video out of my IIc via the A2Heaven VGA adapter and a SCART RGB adapter that is an open source design (link below for reference).  When I load up a test lo-res color bar screen, both the RGBtoHDMI and the VGA adapter output similar signals, with some odd vertical color artifacts.  Like green and red lines around the yellow vertical boarder, and some thin odd color bars in between colors (like between light blue and brown, purple and dark green, in the capture below).  However, the IIc SCART RGB renders the colors exactly, with no artifacts.  I also have an Apple IIe with a Video7 RGB card, that with the new profile in the Alpha 66 release, shows the same kind of clean output that the IIc SCART adapter does.

That being said, Is there a way to tweak the Apple IIc profile somehow to put out a clean image like the SCART adapter (and A2e Video7 profile) do without the odd vertical artifacts?  Or what is the SCART adapter doing differently that it can output a much cleaner color screen?

TIA

SCART Schematic:
https://oshwlab.com/yannick.erb/apple-iic-to-rgb_copy

Apple IIc RGBtoHDMI capture:
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

Apple IIc SCART RGB picture from my TV:
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

Apple IIe Video7 RGBtoHDMI capture:
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

IanSB, 2025-02-22:
@nick3092
So I was curious what the pin mapping would be for that.

| 9 Way D-Type  | 15 way D-Type | Notes |
| ------------- | ----- | ----- |
|Pin 1  GND | Pin 13 | GND |
| Pin 6  green2 | Pin 10 | GR - switches graphics on |
| Pin 8  HSYNC | Pin 3 | SYNC - Composite sync |
| Pin 4  GREEN3 | Pin 11 | SEROUT - TTL inverted video |

>Or what is the SCART adapter doing differently that it can output a much cleaner color screen?

I think the SCART adapter is using some of the additional signals on the IIc connector to work out which mode the IIc is displaying (text, lores, hires or dblhires) and it uses a slightly different algorithm for each mode.
e.g. in lores mode the pixels are very chunky and so you can look at each group of 4 sub-pixel patterns and replace that with just one pixel of the appropriate colour exactly but if you applied that algorithm to hires or especially dblhires mode you would end up with a very blocky image so different algorithms can be used for those modes that produce less blocky images but that will have colour fringing.

When decoding the analog composite video output, RGBtoHDMI effectively uses the dblhires algorithm for all modes because it doesn't know which mode is in use so that leads to colour fringing on the lower resolution modes.
That same algorithm is used for the IIc at the moment so you get the same effect. In theory the code could be changed for the IIc to look at some of the additional signals to determine the current mode and switch algorithms but I don't have a IIc so haven't been able to look at that.

Note that a real composite NTSC display will have somewhat similar colour fringing to the RGBtoHDMI output for the same reason.

Closed 2025-03-01.

Thread 430 (2025-05-09):

problems with vertical synchronization

alex3331, 2025-05-09:
Have two computers - Sharp-MZ-700 and MZ-1500. Until recently had the same Acorn Electron Profile working fine for both. I accidentially changed a setting so that somehow MZ-700 still works OK, but MZ-1500 now seems to have good horizontal sync, but the screen turns blank with ~1 hz frequency.
Both computers connected using RGB+HS cable. No wiring was changed. What can it be? Can provide screenshots.
Regards

IanSB, 2025-05-09:
@alex3331
>Until recently had the same Acorn Electron Profile working fine for both

Is this a digital or analog RGBtoHDMI?
Can you post a screencap of the source summary page for both systems (in the info menu)

Why are you using the Electron profile? It has the wrong settings for the Sharp MZ-700

There is an actual Sharp MZ-700 profile.

alex3331, 2025-05-09:
Hello, and thanks for answering. This is digital RGBtoHDMI;  After I switched to Acorn Atom it resumed working normally. I did not know that MZ-700  profile now exists; I did not update software for a few years. Let me try to upgrade  it. Hope I will manage it.
Regards

alex3331, 2025-05-09:
Sorry for a dumb question, but how do I add  the MZ-700 profile? Should I just remake SD card with BETA 65?

IanSB, 2025-05-10:
@alex3331

Yes, wipe the SD card and unzip the latest beta (which is beta66 not beta65)
https://github.com/IanSB/RGBtoHDMI/releases

Note that there is a new way of changing profile. You use the "Select Profile" option at the bottom of the menu, select the computer manufacturer then select the profile.

Note that the MZ-700 profile is setup for PAL timing as that is the system I have.
An NTSC based machine will need some tweaking to the settings because the pixel clock will probably be different.
Also I wired up the cable for composite sync but the MZ700 also has separate sync out. If you wire up with separate sync you will have to change the Sync setting in geometry (which might be your initial problem)

What is the video pinout for the MZ-1500? Based on info found online, the MZ-800 dropped the composite sync out so has to use separate H/V sync so is that the case with the MZ-1500?

Is there a schematic available?

alex3331, 2025-05-10:
Yes, I have manuals and schematics for MZ-700,  MZ-800  and MZ-1500, as well as all these  computers in working state. I use RGBtoHDMI for MZ-700 and MZ-1500. However, MZ-800 has RGBI output and 16 color palette; I played with a couple homemade  DAC devices with no much luck.
Please let me know what you need and I will provide it to you.
Alex

IanSB, 2025-05-10:
@alex3331
>However, MZ-800 has RGBI output and 16 color palette

That will work with RGBtoHDMI with a suitable profile. I can create one for you to test.

First things I need to know
Which of your machines are PAL or NTSC

What are the maximum resolutions and pixel clock frequencies used on those machines.
If you don't know that then what are the frequencies of the crystals on each of the boards?

e.g. The MZ-700 PAL has a crystal of 17.7344Mhz on the CPU board and the pixel clock is 8.8672Mhz which is half that.
I'm guessing that the crystal on an NTSC one will be different.

alex3331, 2025-05-10:
Depending on the region (PAL/NTSC) Sharp computers may have two time bases:
17.7344 MHz this is the dot clock for 640x200 video (MZ-800 only), 8.8672 MHz is the clock for 320x200 video and 3.547 MHz is processor clock

or 14.31818 MHz, with 7.15909 MHz dot clock for 320x200 (MZ-700 and MZ-1500) and 3.5795 processor clock

MZ-700 and MZ-1500 use  the same LSI M60719 for timing, ; the crystal can be swapped and there is PAL/NTSC switch pin.
MZ-800 has different LCI which includes video converter (RGBI output)

alex3331, 2025-05-10:
MZ-1500 Crystal 14.3181   CPU 3.57957 MHz
MZ-700  Crystal 17.73495  CPU 3.54685 MHz
MZ-800 Crystal  17.73945  CPU 3.54687 MHz
as measured

IanSB, 2025-05-10:
@alex3331

Here are some profiles to test:
[Sharp_profiles.zip](https://github.com/user-attachments/files/20140181/Sharp_profiles.zip)

Unzip and put the three folders in:
\Profiles\6-12_BIT_RGB\Camputers_+_Oric_+_Sharp
on the Sd card then reboot the Pi zero after which they should be available in the select profile menu

These profiles are all set up for separate sync rather than composite sync so you will have to make a revised cable using those signals.
If you also connect the intensity bit, such a cable will then work on all three machines (The intensity bit will be ignored on the 700 & 1500)

New cable connection details are here
https://github.com/hoglet67/RGBtoHDMI/wiki/Cables#sharp-mz700--mz1500-3-bit-rgb-ttl--sharp-mz800-4-bit-rgb-ttl

There are separate profiles for the MZ700 and MZ1500 although they should work with with either but that is to allow separate calibrations to be stored if required.

The MZ800 profile is set up for RGBI mode at 640x200 with the others set up for 320x200.
The 50Hz/PAL profiles should work but the 60Hz/NTSC profiles may need some tweaking as they contain some guesswork
The 50Hz or 60Hz sub-profiles should be detected automatically.

At a minimum you will need to run the auto calibration.
A flashing screen indicates something is wrong with the profile timing.

Can you post the source summary page from your 800 PAL and 1500 NTSC machines.

alex3331, 2025-05-10:
Thanks
Need some time to rewire the cables, probably get some DIN PLUGS. Will post everything when ready

alex3331, 2025-05-11:
I unpacked the zip and have 3 folders - MZ-700, MZ-800 and MZ-1500. Should I put them into \Profiles\6-12_BIT_RGB\Camputers_+_Oric_+_Sharp  without transfering files to root?

IanSB, 2025-05-11:
@alex3331

Yes put those three folders in the Camputers+Oric+Sharp sub-folder

alex3331, 2025-05-11:
First test - MZ-1500 with subprofile 60 Hz works perfectly. Will test two others later today and let you know. Thank you for your help
Let me know if you need additional data.
Alex

IanSB, 2025-05-11:
@alex3331

>Picture is perfect, but there is green snow

Have you run the auto calibration? (long press of SW3 or menu option)

Can you post a screencap of the source summary page:
Go to the info & help menu and select source summary, then Press SW2 & SW3 (up & down) together which will screencap the image.
Also screencap the screen without the menu by pressing SW2 (middle button)
The files will be in /captures on the sd card

alex3331, 2025-05-11:
Tested MZ-800. It turns out that MZ-700/50 Hz fits perfectly here . Both resolutions 640x200 and 320x200 look fine. I still need to check 16-color palette(intensity bit), but have no time today. On the other hand, profile MZ-800 does not provide a stable picture neither with 50 or 60 Hz on MZ-800 machine.
I had to swap wires because my DIN connector was mirrored; so now on MZ-700 there is red snow, not green. I will do screen caps tomorrow and send you. I did calibration, but I will repeat the whole thing tomorrow before sending screencaps to you.

IanSB, 2025-05-11:
@alex3331
>Tested MZ-800. It turns out that MZ-700/50 Hz fits perfectly here . Both resolutions 640x200 and 320x200 look fine. I still need to check 16-color palette(intensity bit), but have no time today. On the other hand, profile MZ-800 does not provide a stable picture neither with 50 or 60 Hz on MZ-800 machine.

The info I found online suggested that the MZ-800 had positive going sync pulses and the MZ-700 had negative going sync pulses so I configured them that way but if the MZ-800 gives a stable picture with the MZ-700 profile and doesn't work with the MZ-800 profile (it would be shifted to the right and jittery) then it seems that info is incorrect and the MZ-800 uses the same sync polarity as the MZ-700.

Here is a revised MZ-800 profile with the sync polarity settings changed to be the same as the MZ-700 for you to test:

[New-MZ-800.zip](https://github.com/user-attachments/files/20151664/New-MZ-800.zip)

Replace the Sharp_MZ-800_(HVSync) folder on the SD card with this new one and try again.

You must also delete the "/Saved_Profiles" folder in the root of the SD card (if it exists) as that might contain old settings that would override this new profile.

Note the MZ-700 profile cannot work fully with the MZ-800 because it only samples and displays 320 pixels per line so 640 pixel mode will be missing every other pixel plus it cannot display the intensity bit. Only the MZ-800 profile will sample 640 pixel and display the intensity setting.

>so now on MZ-700 there is red snow, not green

A couple of suggestions:

1. Check that you have actually connected the correct wire (wire 7) from the 12 way connector to Pin 6 on the DIN
2. Check that you haven't swapped the wires to pins 1 and 6 on the DIN as that would connect composite video to the red input on the MZ-700

IanSB, 2025-05-12:
@alex3331
>Do you need me to do anything else with MZ-800?

Have you confirmed that the intensity bit is working for two different levels of each colour?

Did you run an auto calibration? That will optimise the sample timing and the saved result will be in /Saved_profiles on the SD card so if there is an updated file in there, please post it and I will use that as the default in the next release.
(This applies to all the other profiles in PAL or NTSC)

Are you able to test this in NTSC too?
(This uses a different sub-profile which might need some tweaking in the geometry menu to centre the image)

alex3331, 2025-05-12:
Intensity bit is working - I see all 16 colors in a test program. Let me run an auto calibration .  Here it is. Will test in NTSC later.

[Sharp_MZ-800_50Hz.txt](https://github.com/user-attachments/files/20161824/Sharp_MZ-800_50Hz.txt)

alex3331, 2025-05-12:
On MZ-700. After multiple calibrations I see a good improvement; still some red snow, very minimal is observed when R channel is active. On a black or blue screen with only a a few white letters it is almost invisible. In one of the games the rightmost column is red and it has some blinking artifacts and more snow. I attach a few screenshots

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

IanSB, 2025-05-12:
@alex3331

It looks like the red channel is noisy on your system for some reason. My MZ-700 doesn't seem to have any problem with red noise but I don't really have any software to run on it yet.

Try changing the multiplier from x8 to x16 in the sampling menu then re-running the calibration. This will make the calibration more accurate and it might be able to tune out the noise.

alex3331, 2025-05-12:
It was a faulty ground on video cable. No snow now; again thanks a lot for your help. You mentioned you have MZ-700 - I designed a backplane with RAM card, Flash ROM reader/writer and floppy controller. Can share if you are interested.

IanSB, 2025-05-13:
@alex3331
>It was a faulty ground on video cable

Strange that it only affected the red channel but glad you sorted that out.

>I designed a backplane with RAM card, Flash ROM reader/writer and floppy controller. Can share if you are interested

I might be, do you have any more details or photos?

I think the PAL profiles are all sorted out now, so it is only the 60Hz ones to finalise.
You mentioned above that the MZ-700 and MZ-1500 worked at 60Hz but I would like to see a source summary screencap from one of those to confirm the timings are exact plus can you post a calibrated saved profile at 60Hz so I can make that the default.

The 60Hz MZ-800 hasn't been checked yet.

Also the pixel aspect settings in the profiles I posted for 60Hz are not correct:
for the 60Hz MZ-700 and MZ-1500 the Pixel Aspect in geometry should be changed to:
```
H Pixel Aspect = 4
V Pixel Aspect = 5
```
for the 60Hz MZ-800 the Pixel Aspect in geometry should be changed to:
```
H Pixel Aspect = 2
V Pixel Aspect = 5
```
This will result in taller video the same as when viewed at 60Hz on a normal TV

alex3331, 2025-05-13:
per your suggestion tried to switch MZ-700 into 60 Hz mode. It can be switched to this subprofile, but no matter how I save it, when I press menu again - it shows 50 Hz subprofile. 4:5 ratio works and does not influence picture quality. Maybe I need more detailed instructions how to do this

IanSB, 2025-05-13:
@alex3331
>It can be switched to this subprofile, but no matter how I save it, when I press menu again - it shows 50 Hz subprofile

That means the timing is wrong in the 60Hz profile so I need to see the source summary page when outputting 60Hz
To force the 60hz sub profile, set the "Auto Switch to "Off". Then you can manually switch between 50 and 60Hz sub-profiles

alex3331, 2025-05-13:
auto switch off - here is MZ-700 60 Hz. Picture has a lot of artifacts, the display window is down, last line is hardly visible.
Here is the source

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

IanSB, 2025-05-13:
@alex3331

It says frame rate: 50Hz so the computer is outputting 312 line 50Hz PAL timing not 60Hz NTSC timing.
I need to see the source summary when the computer is outputting 60Hz NTSC timing.
Note the Source summary page doesn't live update so the computer must already be outputting 60Hz before selecting the menu.

Thread 436 (2025-06-19):

support.

reapern66, 2025-06-19:
Does this support an ras pi version v1.3.  I couldnt find information on how to connect it to this version of the board for an amiga 500.

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

reapern66, 2025-06-19:
It looks like i need to connect it like this.Can anyone verify this?

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

reapern66, 2025-06-19:
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

IanSB, 2025-06-20:
@reapern66
>Does this support an ras pi version v1.3. I couldnt find information on how to connect it to this version of the board for an amiga 500.

Yes any Pi zero will work and you can connect it the way that is shown in the photo. (Make sure to put some tape on the Pi zero board to avoid shorts)

What type of Amiga card are you using? There may be other ways of connecting it directly to the card.

reapern66, 2025-06-20:
It looks like I may not need to solder this sound addon

RGBtoHDMI RGB2HDMI Adapter Raspberry Pi for Amiga 500 500 Plus 1105

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

PiStorm Amiga 500 PiZeroW RGB Accelerator Game Loader 128gb SD card Whdload

---Switch to HDMI output with one setting change for full HD RTG Amiga experience
---Play MP3 audio files and enjoy a huge MOD music collection

IanSB, 2025-06-23:
You would have to solder the audio board upside down to the back of the Pi zero as shown above to work with the above RGBtoHDMI adapter.

The PiStorm also mentioned above is a different product.

reapern66, 2025-06-23:
Looking over this site if I have the PiStorm I wouldn't have to solder the audio board to the RGBtoHDMI adapter. I am double checking before I do any soldering. =]

https://theoasisbbs.com/upgrading-the-amiga-500-with-pistorm-and-rgb2hdmi/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

reapern66, 2025-06-30:
I've soldered the board upside down and enabled audio in the menu configuration. I checked each solder pin and it made noise. When I try to play a game I do not here audio.

IanSB, 2025-06-30:
What does the system summary menu show for the "Audio:" line
(Go to the Info & Help menu then the System summary menu)

Could you post some photos of your wiring

reapern66, 2025-06-30:
Here is the information Requested. I have the rca input connected to a headset.

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

reapern66, 2025-06-30:
My previous setup was incorrect. Forget about the headset being connected to the input on the audio board. the Headset does not create sound. The RCA output on the amiga 500 works tested.

I have the RCA output on the amiga 500 connected to the input on the audio board. I loaded a video game and I didn't get sound.

If the audio card is Detected why am I receiving this error "No Audio Capture Card detected."

reapern66, 2025-07-01:
I am running 67a with the new kernel and I have sound! I'll follow up about

"
"No Audio Capture Hardware Detected"
or
"Unknown Audio Capture Hardware" if it can partially detect the hardware
"

a little later.

IanSB, 2025-07-01:
>I have sound via HDMI!

This does feel like an intermittent contact somewhere as you have likely moved the Pi zero when replacing the SD card.
If you do get audio loss with the associated error message again, make sure to save the log at the time you see the error message and post it.
I should be able to tell you which pin has lost contact.

Closed 2025-06-26.

Thread 446 (2025-08-09):

Flashing display on PPC640

roddersuk, 2025-08-09:
I've managed to get an LCD display up and running using an RGBtoHDMI on my Amstrad PPC640.
I've tweaked the profile to get the display to fill the screen and iron out the glitches.
However, it still complains that genlock is inhibited and as soon as I close the RGBtoHDMI menu the display starts to flash.
Nothing I've tried manages to obtain genlock so any pointers would be great.
Here's my profile:

[Custom_Profile_0_.txt](https://github.com/user-attachments/files/21700922/Custom_Profile_0_.txt)
and my log

[Log.txt](https://github.com/user-attachments/files/21700944/Log.txt)

roddersuk, 2025-08-10:
I've made a bit of progress.
I started again with the CGA (IBM_New) profile.
I sorted the genlock problem by setting the Resolution to 1024x768 and Refresh to 60Hz.
I tweaked the geometry to eliminate glitches and fill the screen but the display still flashes when I exit the menu.
Here's the latest profile:

[CGA_(IBM_New).txt](https://github.com/user-attachments/files/21704053/CGA_.IBM_New.txt)
and log

[Log.txt](https://github.com/user-attachments/files/21704113/Log.txt)

I'm guessing that this line indicates the problem but I don't know what to do about it:

`Timing exceeds window: H=63694, V=16687947, Lines=262, VSync=0`

roddersuk, 2025-08-31:
Well  I swapped out the 6845 but no joy, still the same behaviour.
I'm confused because all the measurements I take with the stock CGA profile seem to be right but the image is shifted across the screen and it flashes. Could the RGB signals be shifted from the sync? Its too much for my poor brain. I haven't recapped the board but the caps look fine and there are no electrolytics in this area anyway. It's looking more and more like the custom video chip being at fault but I'm not going to find one of those anytime soon.

IanSB, 2025-09-02:
Is the noise burst on the +5v supply of the 6845?
Can you post a screenshot of the hsync pulse and noise on your scope?
Do you get the same noise on the HSync out of the 6845 and the 9 way DIN?

What happens if you disconnect the reset input on the 6845? (i.e. bend out pin if socketed)

IanSB, 2025-09-04:
@roddersuk

The source summary measured timings look correct with 63694ns per line and 262 lines which is CGA standard.
The only thing that looks wrong is the detected sync type which is showing as -H+V when the H syncs shown on the scope traces are postive going (+H).
What to the hsyncs look like on a longer timebase such as one or more frames?

Various settings in the CPLD like sync polarity inversion are controlled by an internal register which is set serially by 3 signals so check that the following are connected and make sure the solder connections on those CPLD pins are good and not shorted to adjacent pins:

40 way header pin 28 to CPLD pin 6
40 way header pin 27 to CPLD pin 7
40 way header pin 38 to CPLD pin 44

You can see those connection details on the schematic:
https://raw.githack.com/hoglet67/RGBtoHDMI/master/Kicad_6Bit/v4/rgb-to-hdmi.pdf

Did you have to cut the 3 solder jumpers on the underside to initially program the CPLD?
If so did you remake them properly as they isolate the above connections.

Thread 453 (2025-09-27):

Yamaha CX5MF (analog RGB) : no sync detected

localhero44, 2025-09-27:
Hi,

So I've bought the analog board and a cable with DIN 8 (for Sinclair QL) from cOpperdragon as I can't build it myself.
I've modified the Sinclair QL DIN 8 pins to match with what I think is needed for the Yamaha CX5M (based on this link : https://www.msx.org/wiki/RGB_(8-pin_DIN_45326)

Yamaha CX5M DIN pinout :

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

So I had these modifications in mind :

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

Here are 3 pins that I think I had to move :

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

First try with the Yamaha CX5MF : I see some horizontal lines but there is clearly a problem.
I get "no sync detected", which is not good obviously.

May I have something wrong with the pin numbers and then with my modification on the cable ?

Regards
David

IanSB, 2025-09-28:
>I get "no sync detected", which is not good obviously.

What profile are you using as a starting point for your custom profile? The above data states that sync is 0.3v p-p so if your base profile is using a higher sync voltage you need to adjust the sync level in the sampling menu to about 0.1v to get locked sync.

Is there any technical info on the timing of the yamaha video output? (resolution, pixel clock frequency etc)

localhero44, 2025-09-29:
Hi Ian,
Thank you for the answer.
I have tried so many things last Saturday, I am not sure to remember but I think I've started with the Sinclair QL profile. I can restart from a unmodified profile if needed.
After my initial post, I've tried the latest beta and got an almost stable image after a lot of trials and errors (still some pixels "moving").
But I've modified parameters I don't understand 🤣

I am not at home now, I could give you more details tonight.
I haven't found the pixel clock frequency in the service manual. The resolution is graphic mode 256 × 192 pixels, 16 colors. Standard resolution for all MSX computers.
The video display processor is TMS9918A.
Note the CX5MF (french version) is the only CX5M with a RGB output (through this DIN connector).

localhero44, 2025-09-29:
My "best" result so far (and image not stable anymore)

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

localhero44, 2025-10-01:
Oh, I thought the analog RGB would be enough as I had seen MSX in the list of computers. But again I am not an expert in video signals and I am completely lost.
I have to say that I have discovered the informations as you asked them.
I hadn't got such problems with digital RGB (for my Oric for example,  I got a perfect image at first try 😀).
And I didn't understand what was lumacode mentioned several times.

But I see a RCA cable with this digitizer, I have an analog RGB signal through a DIN 8. You speak about YUV output, but the CX5MF has analog RGB output.
Am I mixing things?

I had chosen RGB to program the CPLD.
Now I am not sure it was right.

I haven't found the exact technical manual to know the chip that provides this RGB analog output but I will open the computer to try to see 😉

localhero44, 2025-10-01:
I have taken some pictures.
The VDP chip is a TLS9929A

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

IanSB, 2025-10-03:
The TMS9929A has a YUV output so it must be getting converted to RGB by external circuitry

If you connect the analog RGBtoHDMI directly to the YUV pins on the chip you can try the TI99/4A profile

Connections would be as follows:

## TI99/4A
| RGBtoHDMI 6 way IDC | TMS99XX chip | Notes |
| --------- | ------------- | ----- |
| Pin 1  GND | Pin 12 | |
| Pin 2  SYNC | Pin 36 | Same as Y|
| Pin 3  U/BLUE | Pin 35 | |
| Pin 4  Y/GREEN | Pin 36 | |
| Pin 5  V/RED | Pin 38 | |
| Pin 6  +5V| Pin 33 | Powers RGBtoHDMI from the source, do not use a power supply |

Select the "U7 TI-99-4a 50Hz" YUV profile from the "Experimental" folder (not the lumacode one)

You will probably need to make small adjustments to the voltage levels in the sampling menu.
