hoglet67/RGBtoHDMI/kicad_analog_6bit/V3/analog.pdf

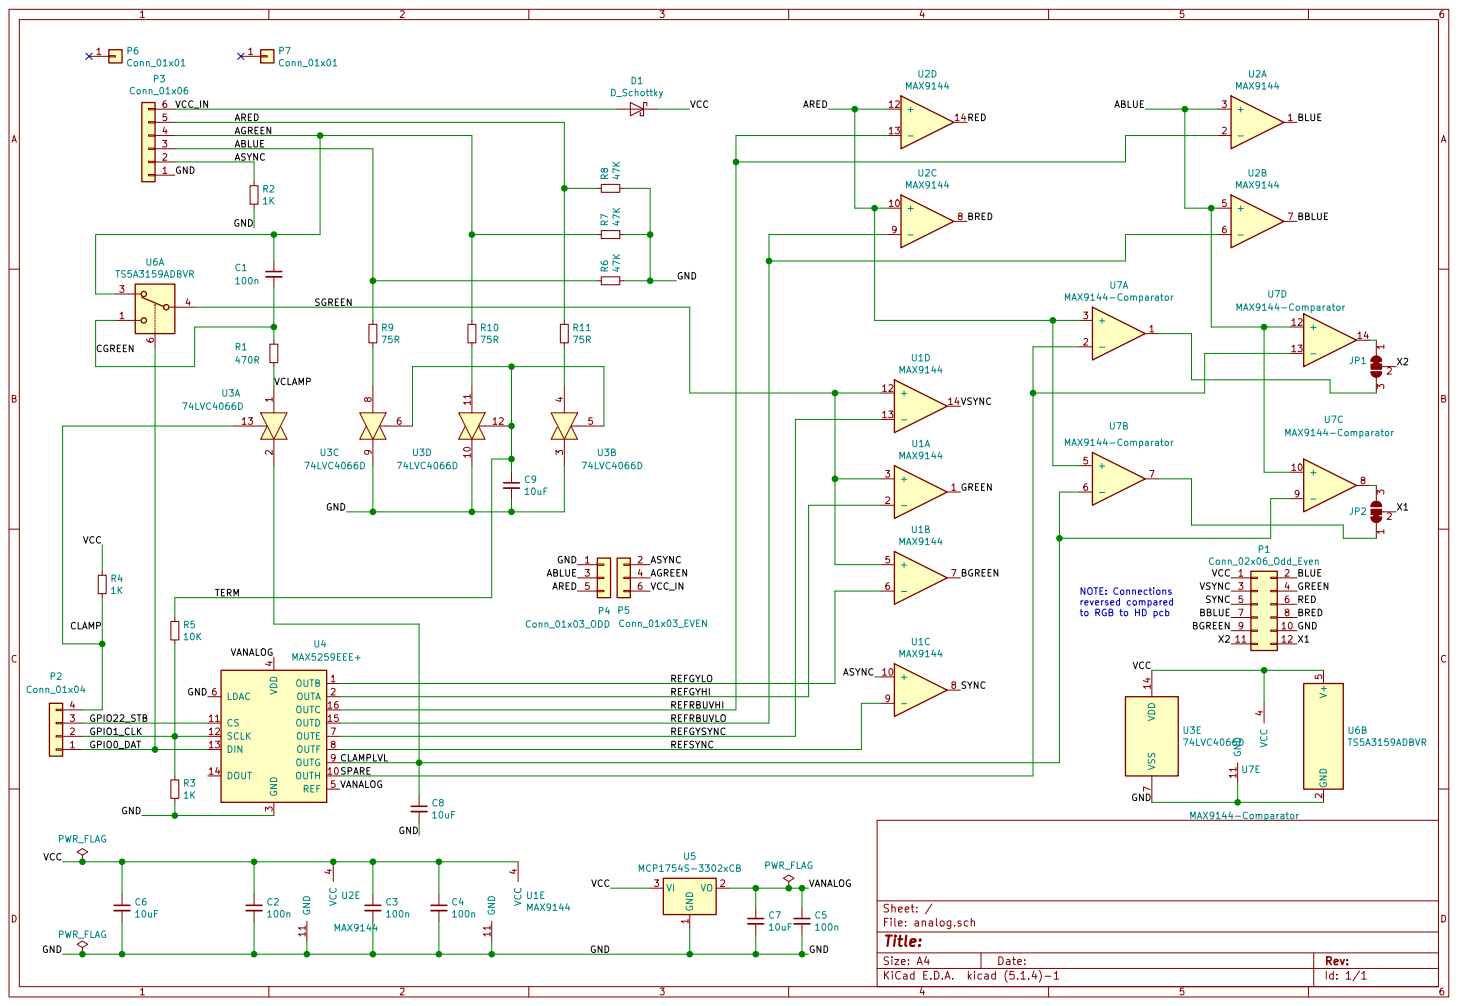
[picture p1: page 1]

3 ABLUE
2 ASYNC

NOTE: Connections
reversed compared
to RGB to HD pcb

1 | REFSYNC
