hoglet67/RGBtoHDMI/kicad_Extender_12_bit_adapter/V2/buffer.pdf

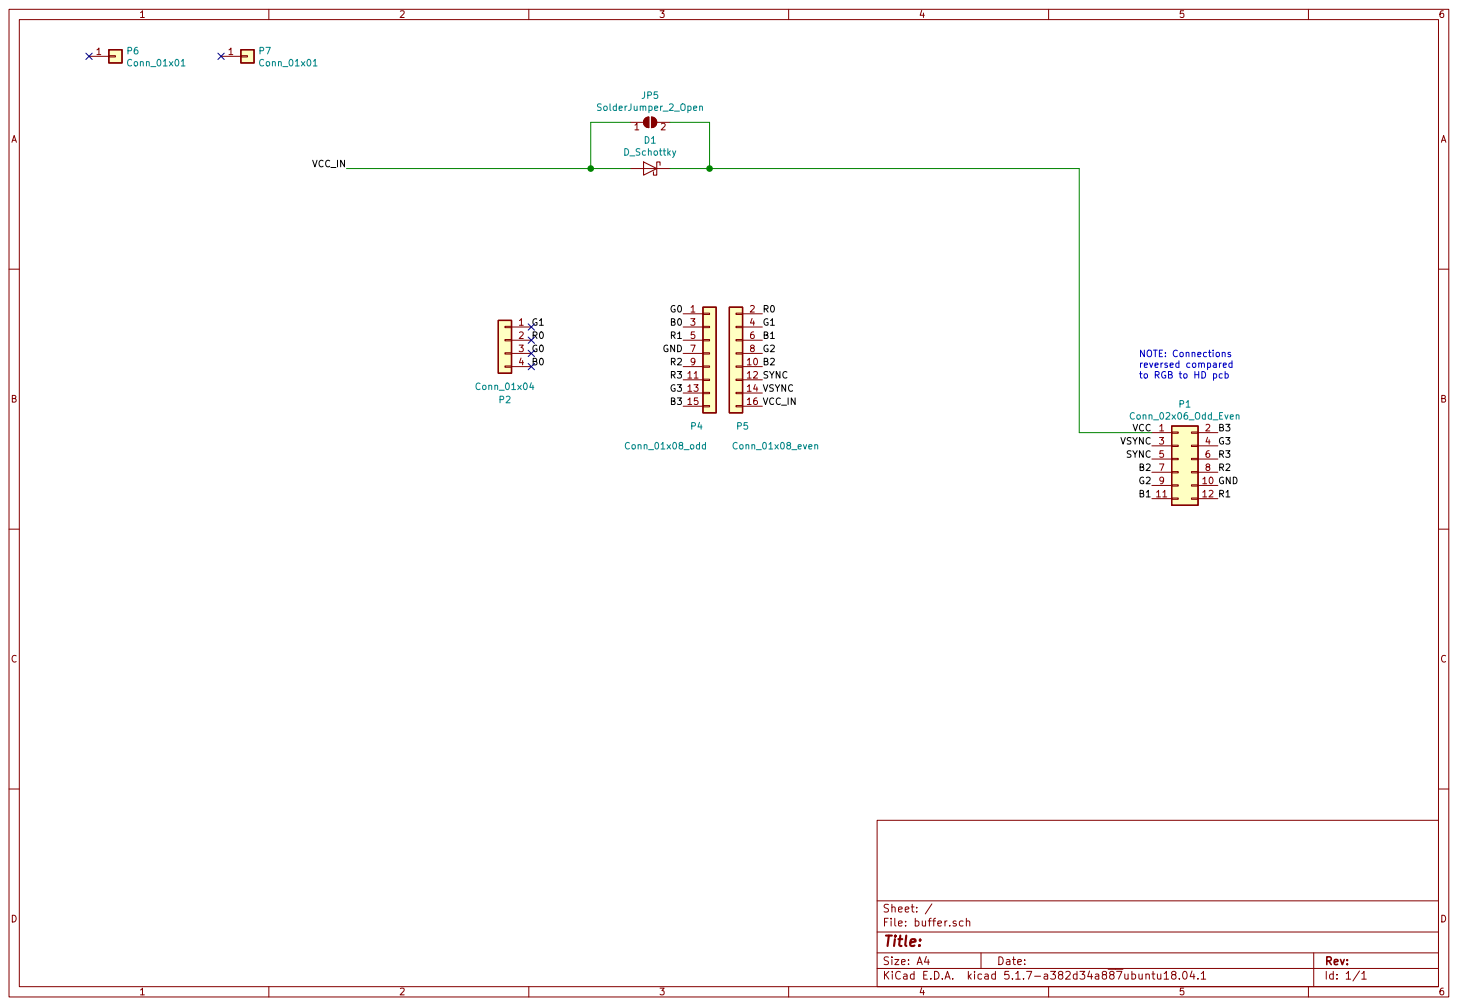
[picture p2: page 1]

NOTE: Connections
reversed compared
to RGB to HD pcb

Id: 1/1 Title: File: buffer.sch Sheet: /
