hoglet67/RGBtoHDMI/kicad_AmigaAdapter/VideoSlot/V1/videoslotadapter.pdf

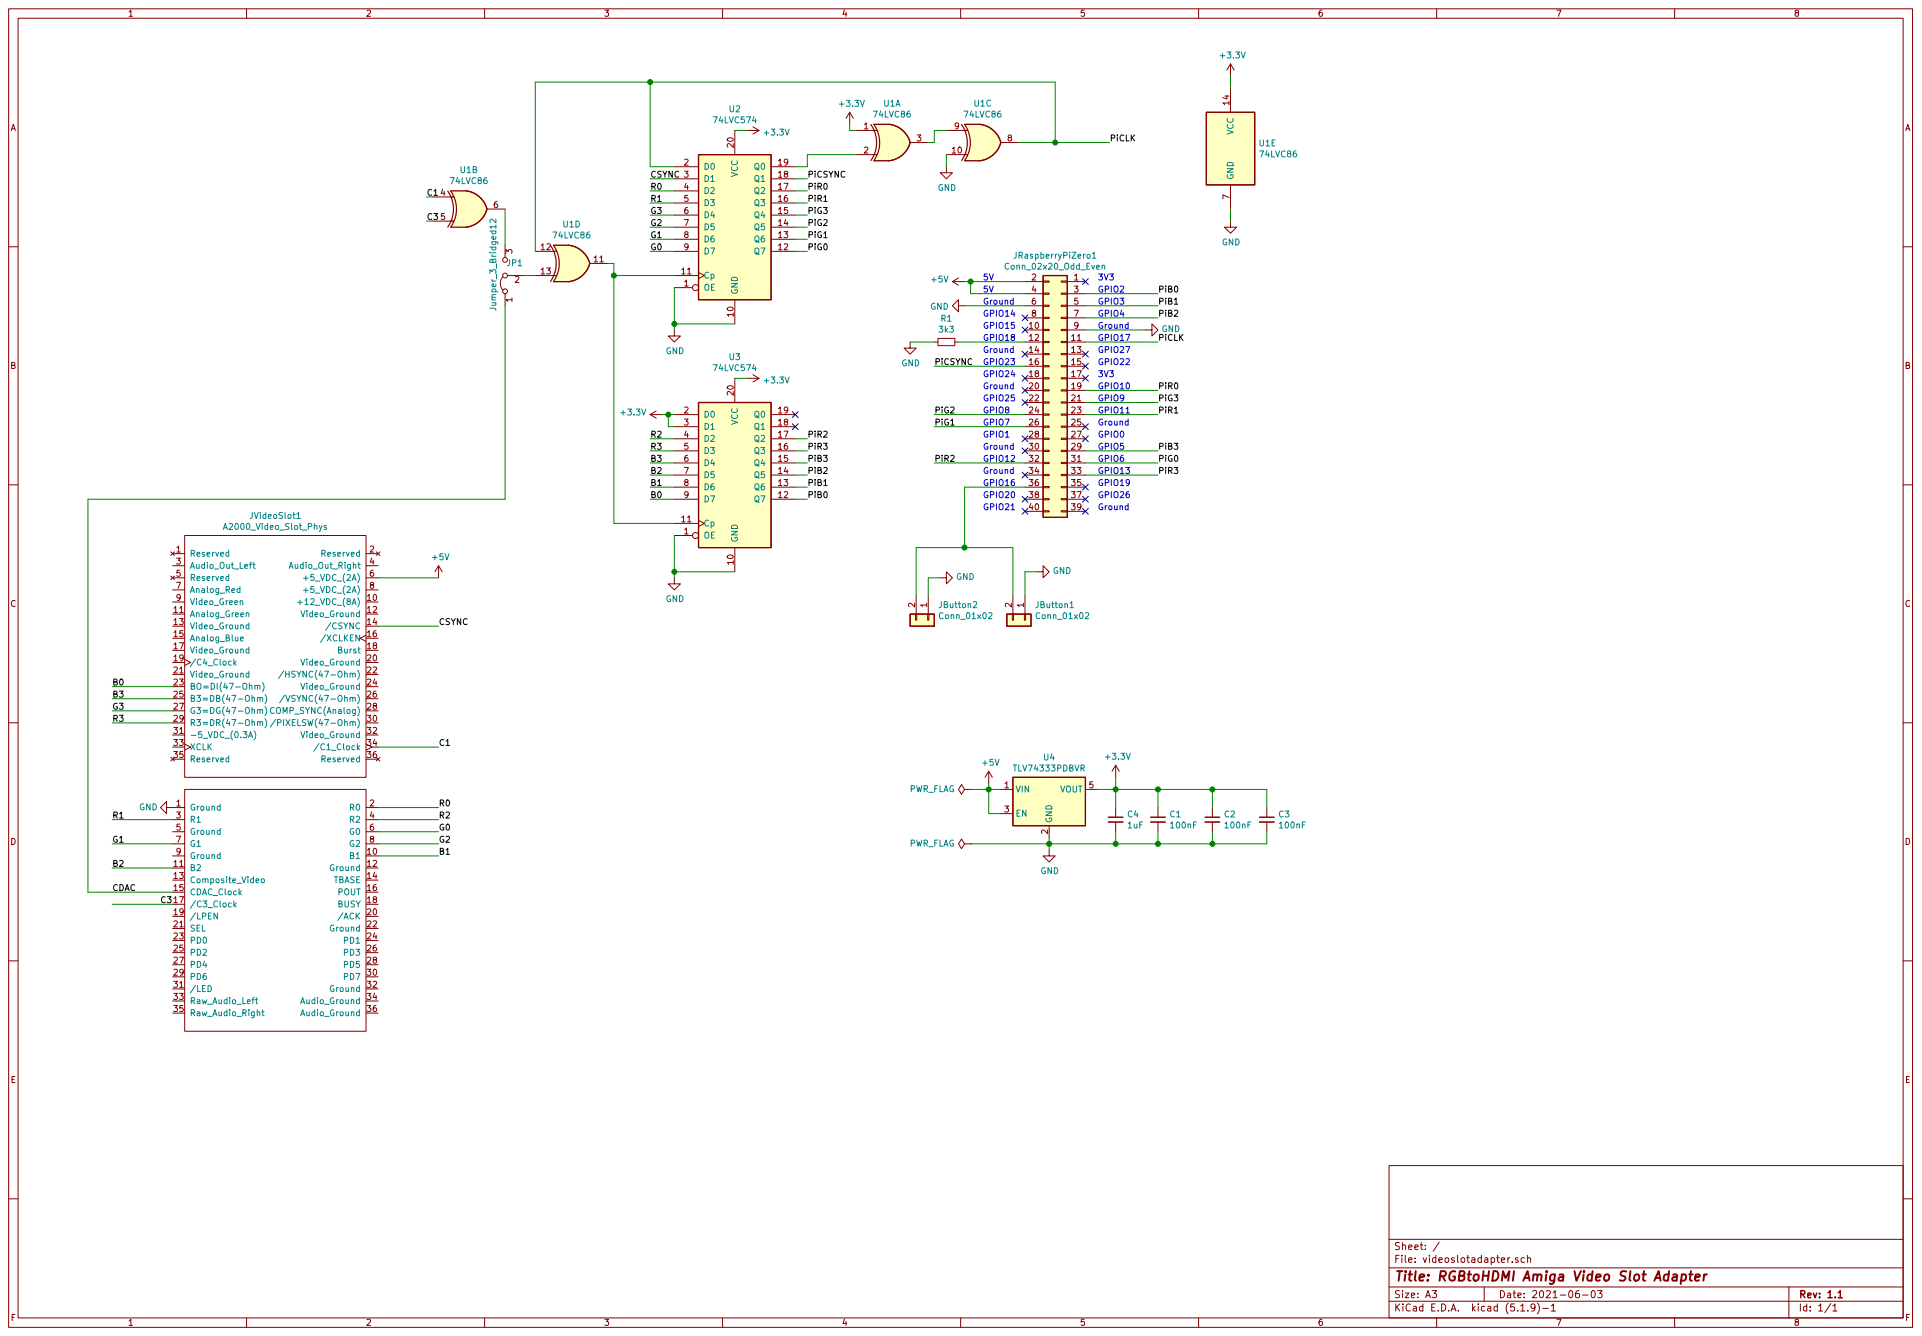
[picture p3: page 1]

File: videoslotadapter.sch Sheet: /
Id: 1/1 Title: RGBtoHDMI Amiga Video Slot Adapter
