hoglet67/RGBtoHDMI/contrib/RichardHallas/RGBtoHDMI_label.pdf

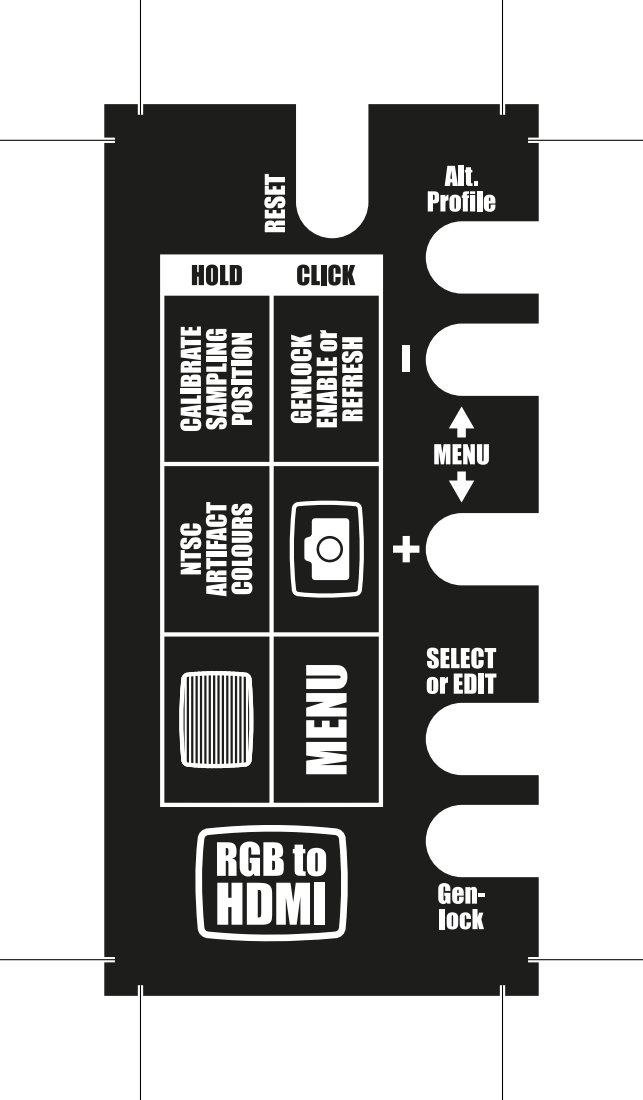
[picture p4: page 1]
