hoglet67/RGBtoHDMI/Kicad_6Bit/v4/rgb-to-hdmi.pdf

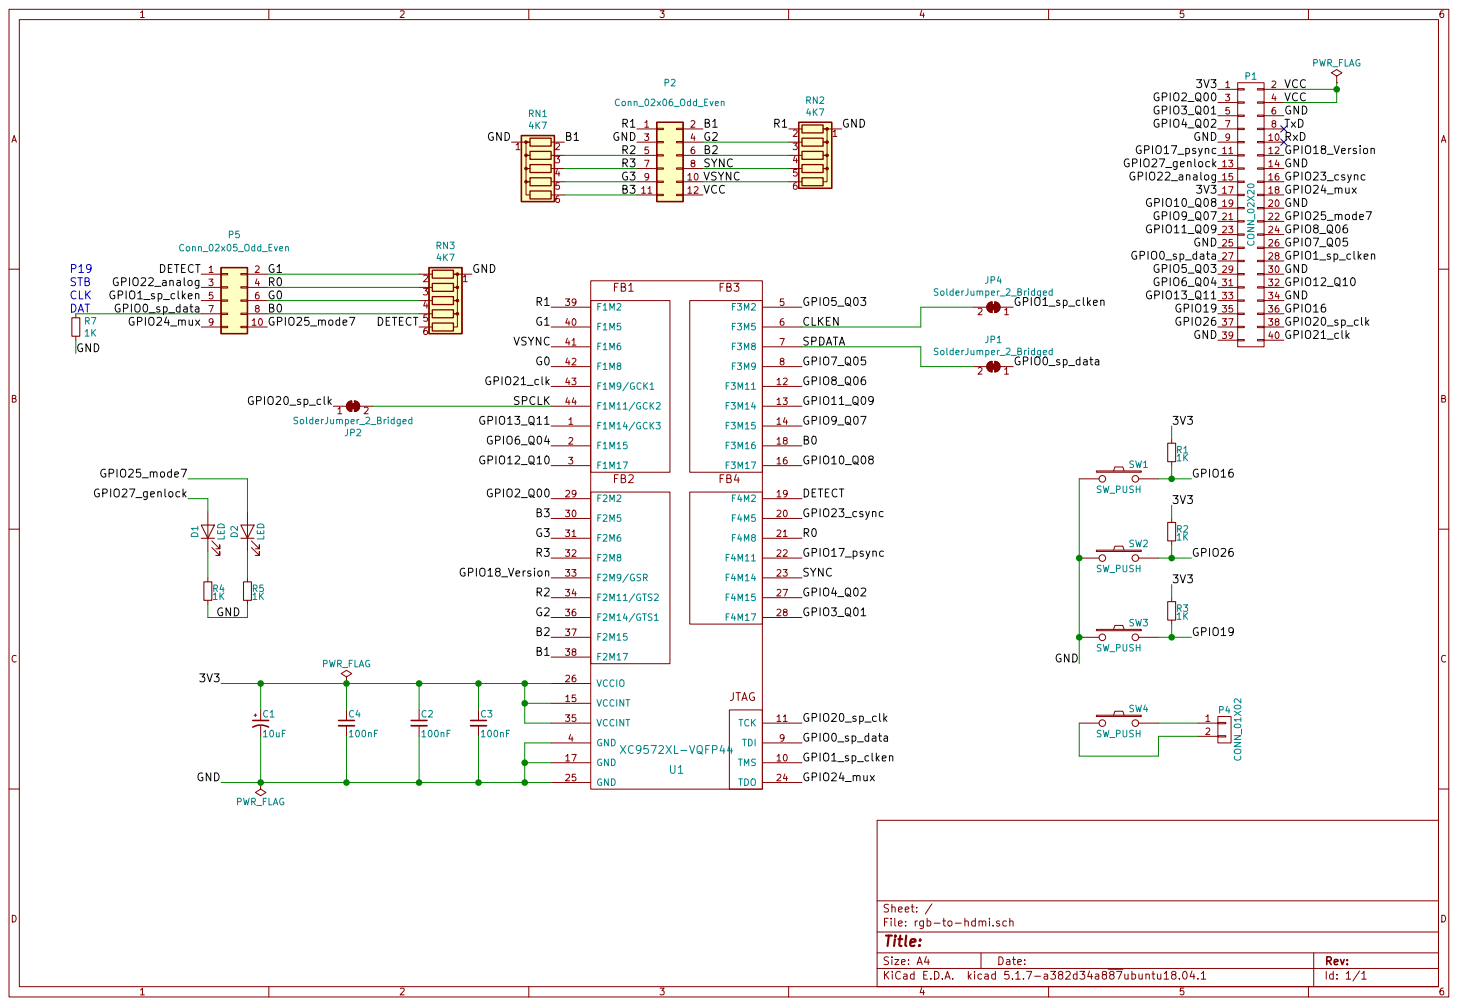
[picture p5: page 1]

File: rgb-to-hdmi.sch Sheet: / C3
