hoglet67/RGBtoHDMI/kicad_AmigaAdapter/Small/deniseadapter.pdf

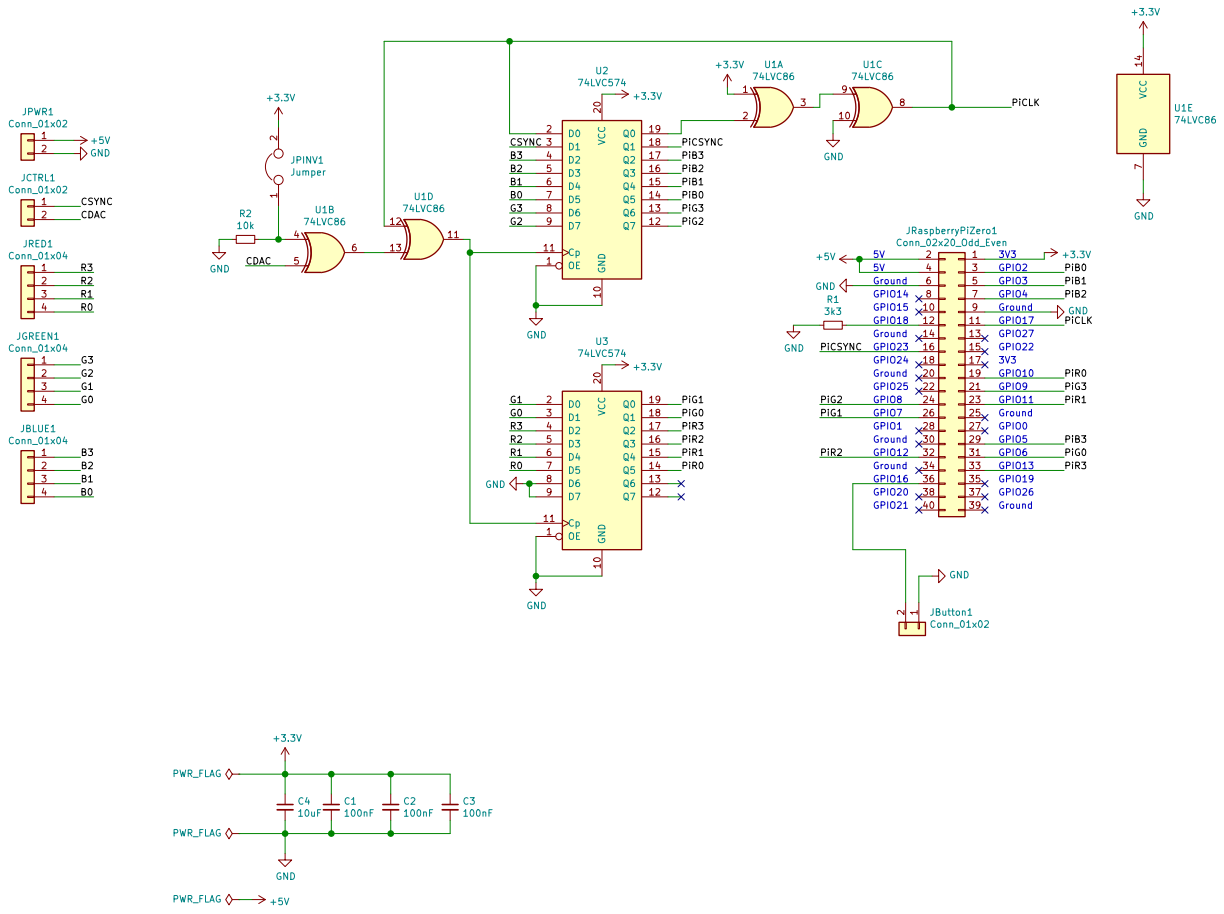
[picture p6: page 1]
