hoglet67/RGBtoHDMI/kicad_AmigaAdapter/V2/deniseadapter.pdf

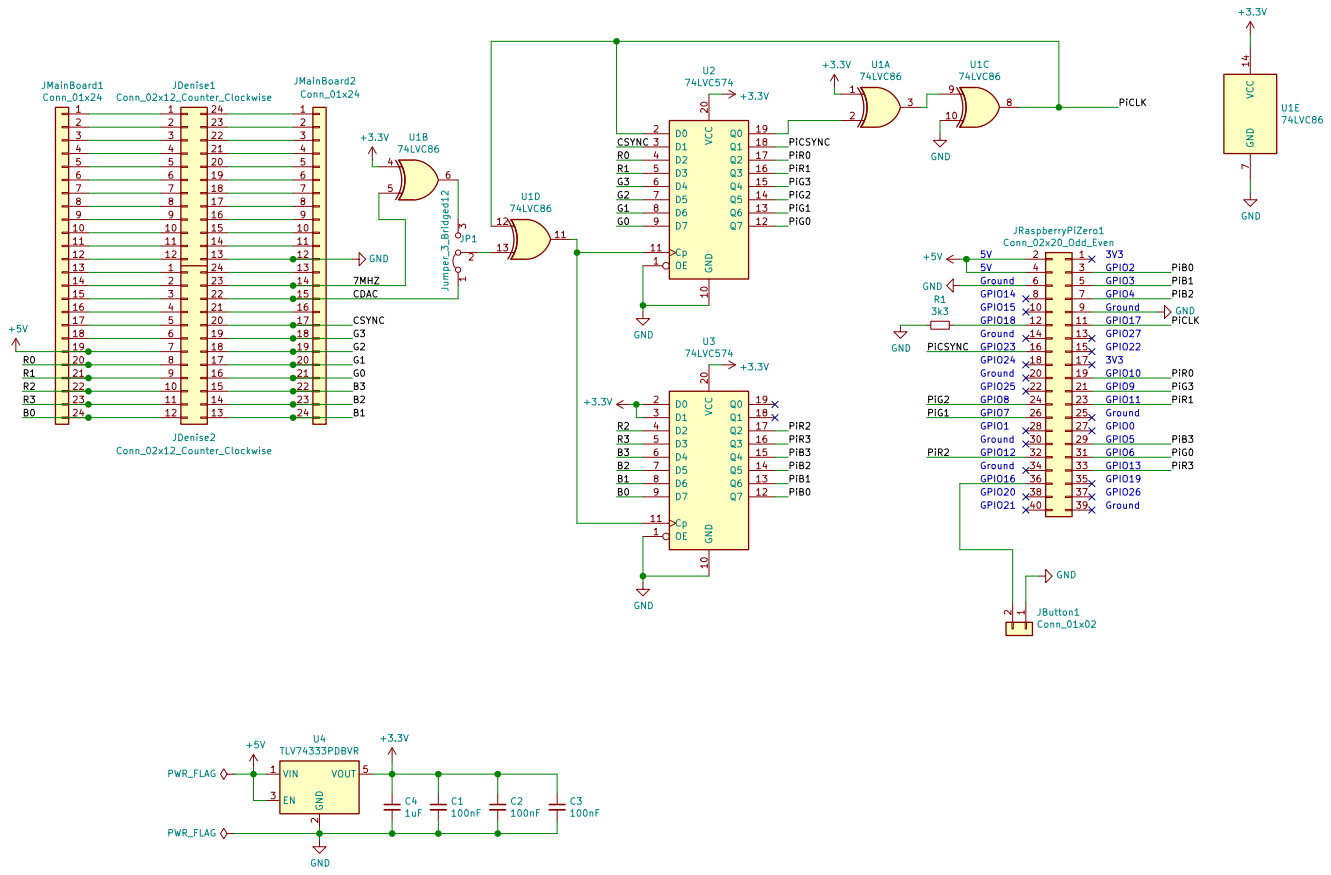
[picture p7: page 1]

2 2 | 23 2
3 3 | 22 3
4 4 | 21 4
5 5 | 20 5
6 6 | 19 6
7 7 | 18 7
8 8 | 17 8
9 9 | 16 9
10 10 | 15 10
11 11 | 14 11
12 12 | 13 12 24 13
