hoglet67/RGBtoHDMI/kicad/v4/rgb-to-hdmi.pdf

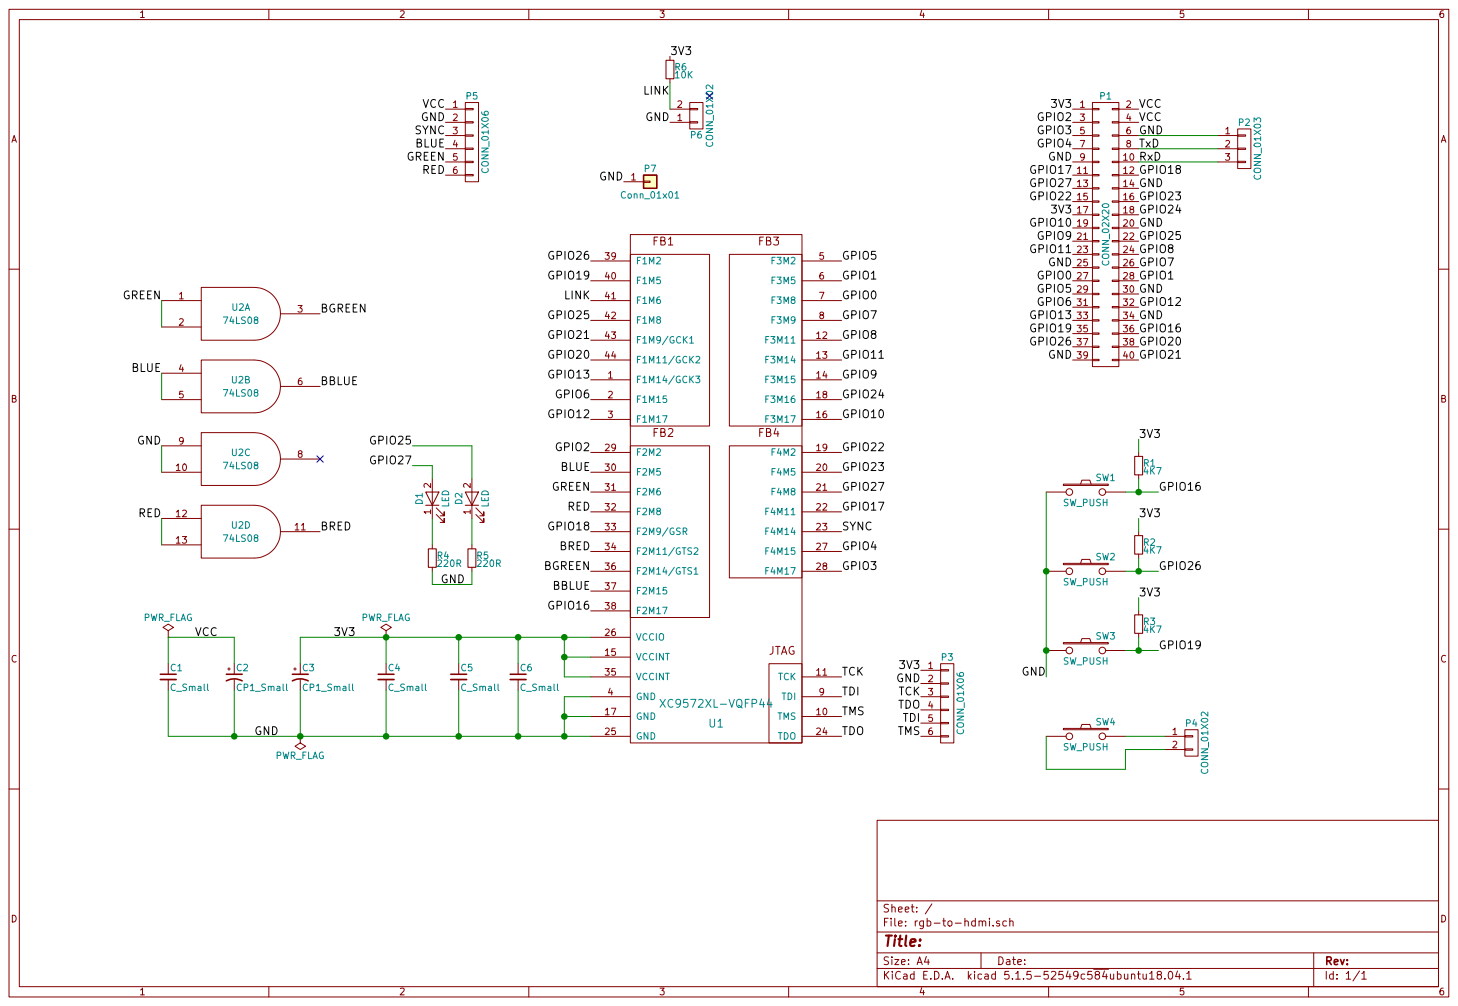
[picture p8: page 1]

File: rgb-to-hdmi.sch Sheet: /
Id: 1/1 Title:
