hoglet67/RGBtoHDMI/kicad_atom/v2/rgb-to-hdmi.pdf

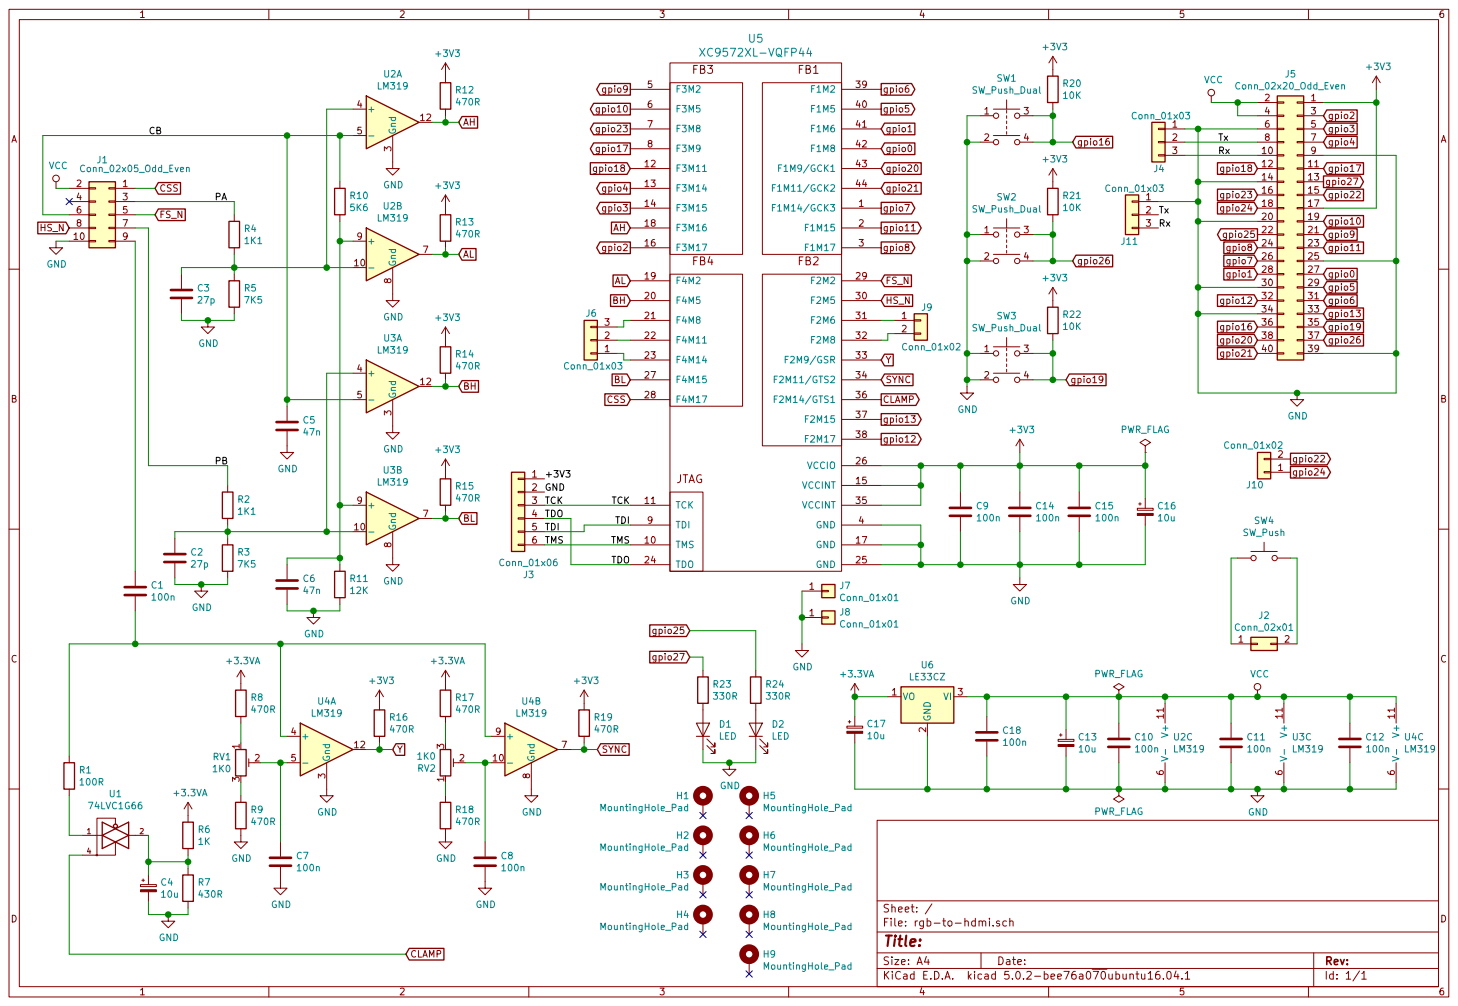
[picture p9: page 1]

12 gpio18 | | 11 gpio17 gpio27 gpio22

File: rgb-to-hdmi.sch Sheet: /
Id: 1/1 Title:
