hoglet67/RGBtoHDMI/vhdl/RGBtoHDMI.ucf

# Global Clock Nets
NET "clk" BUFG=CLK;

# Global Clock Nets
NET "sp_clk" BUFG=CLK;

# 96MHz clock domain
NET "clk" TNM_NET = clk_period_grp_1;
TIMESPEC TS_clk_period_1 = PERIOD "clk_period_grp_1" 5.2ns HIGH;

# 10MHz clock domain
#NET "sp_clk" TNM_NET = clk_period_grp_2;
#TIMESPEC TS_clk_period_2 = PERIOD "clk_period_grp_2" 100ns HIGH;

NET "clk"       LOC = "P43";       # input  gpio21 (gclk)

NET "R3_I"      LOC = "P32";       # input
NET "G3_I"      LOC = "P31";       # input
NET "B3_I"      LOC = "P30";       # input
NET "R2_I"      LOC = "P34";       # input
NET "G2_I"      LOC = "P36";       # input
NET "B2_I"      LOC = "P37";       # input
NET "R1_I"      LOC = "P39";       # input  (was gpio26)
NET "G1_I"      LOC = "P40";       # input  (was gpio19)
NET "B1_I"      LOC = "P38";       # input  (was gpio16)
NET "R0_I"      LOC = "P21";       # input  (was gpio27)
NET "G0_I"      LOC = "P42";       # input  (was gpio25)
NET "B0_I"      LOC = "P18";       # input  (was gpio24)

NET "csync_I"   LOC = "P23";       # input

NET "version"   LOC = "P33";       # input  gpio18 (gsr)
NET "vsync_I"   LOC = "P41";       # input  (connects to vsync)
NET "analog"    LOC = "P19";       # input  gpio22

NET "sp_clk"    LOC = "P44";       # input  gpio20 (gclk)
NET "sp_data"   LOC = "P7";        # input  gpio0  (input only)
NET "sp_clken"  LOC = "P6";        # input  gpio1  (input only)

NET "quad(0)"   LOC = "P29";       # output gpio2
NET "quad(1)"   LOC = "P28";       # output gpio3
NET "quad(2)"   LOC = "P27";       # output gpio4
NET "quad(3)"   LOC = "P5";        # output gpio5
NET "quad(4)"   LOC = "P2";        # output gpio6
NET "quad(5)"   LOC = "P8";        # output gpio7
NET "quad(6)"   LOC = "P12";       # output gpio8
NET "quad(7)"   LOC = "P14";       # output gpio9
NET "quad(8)"   LOC = "P16";       # output gpio10
NET "quad(9)"   LOC = "P13";       # output gpio11
NET "quad(10)"  LOC = "P3";        # output gpio12
NET "quad(11)"  LOC = "P1";        # output gpio13

NET "psync"     LOC = "P22";       # output gpio17
NET "csync"     LOC = "P20";       # output gpio23

NET "quad(0)"   SLOW;
NET "quad(1)"   SLOW;
NET "quad(2)"   SLOW;
NET "quad(3)"   SLOW;
NET "quad(4)"   SLOW;
NET "quad(5)"   SLOW;
NET "quad(6)"   SLOW;
NET "quad(7)"   SLOW;
NET "quad(8)"   SLOW;
NET "quad(9)"   SLOW;
NET "quad(10)"  SLOW;
NET "quad(11)"  SLOW;
NET "psync"     SLOW;
NET "csync"     SLOW;
