hoglet67/RGBtoHDMI/src/osd.c

#include <stdio.h>
#include <stdlib.h>
#include <stdint.h>
#include <string.h>
#include <inttypes.h>
#include <ctype.h>
#include "defs.h"
#include "cpld.h"
#include "geometry.h"
#include "gitversion.h"
#include "info.h"
#include "logging.h"
#include "osd.h"
#include "rpi-gpio.h"
#include "rpi-mailbox.h"
#include "rpi-mailbox-interface.h"
#include "saa5050_font.h"
#include "8x8_font.h"
#include "rgb_to_fb.h"
#include "rgb_to_hdmi.h"
#include "filesystem.h"
#include "fatfs/ff.h"
#include "jtag/update_cpld.h"
#include "startup.h"
#include "vid_cga_comp.h"
#include <math.h>

// =============================================================
// Definitions for the size of the OSD
// =============================================================

#define NLINES         30

#define FONT_THRESHOLD    25

#define LINELEN        42

#define MAX_MENU_DEPTH  4

#define DEFAULT_CPLD_FIRMWARE_DIR "/cpld_firmware/recovery"
#define DEFAULT_CPLD_FIRMWARE_DIR12 "/cpld_firmware/recovery12"
#define DEFAULT_CPLD_UPDATE_DIR "/cpld_firmware/6-12_bit"
#define DEFAULT_CPLD_UPDATE_DIR_3BIT "/cpld_firmware/3_bit"
#define DEFAULT_CPLD_UPDATE_DIR_ATOM "/cpld_firmware/atom"
#define MONO_BOARD_DEFAULT "Commodore_/Commodore_64_Lumacode_"

#define PI 3.14159265f
// =============================================================
// Definitions for the key press interface
// =============================================================

#define LONG_KEY_PRESS_DURATION 25

// =============================================================
// Main states that the OSD can be in
// =============================================================

typedef enum {
   IDLE,          // Wait for button to be pressed
   DURATION,      // Determine whether short or long button press

   MIN_ACTION,    // Marker state, never actually used

   // The next N states are the pre-defined action states
   // At most 6 of these can be bound to button presses (3 buttons, long/short)
   A0_LAUNCH,     // Action 0: Launch menu system
   A1_CAPTURE,    // Action 1: Screen capture
   A2_CLOCK_CAL,  // Action 2: HDMI clock calibration
   A3_AUTO_CAL,   // Action 3: Auto calibration
   A4_SCANLINES,  // Action 4: Toggle scanlines
   A5_NTSCCOLOUR, // Action 5: Toggle ntsc
   A6_SPARE,      // Action 6: Spare
   A7_SPARE,      // Action 7: Spare

   MAX_ACTION,    // Marker state, never actually used
   A1_CAPTURE_SUB,    // Action 1: Screen capture
   A1_CAPTURE_SUB2,    // Action 1: Screen capture
   CLOCK_CAL0,    // Intermediate state in clock calibration
   CLOCK_CAL1,    // Intermediate state in clock calibration
   AUTO_CAL_SAVE, // saving auto calibration result

   NTSC_MESSAGE,
   NTSC_PHASE_MESSAGE,
   TIMINGSET_MESSAGE,
   MENU,           // Browsing a menu
   MENU_SUB,       // Browsing a menu
   PARAM,          // Changing the value of a menu item
   PARAM_SUB,      // Changing the value of a menu item
   INFO            // Viewing an info panel
} osd_state_t;

// =============================================================
// Friendly names for certain OSD feature values
// =============================================================


static char *default_palette_names[] = {
   "RGB",
   "RGBI",
   "RGBI_(CGA)",
   "RGBI_(XRGB-NTSC)",
   "RGBI_(XRGB-Apple)",
   "RGBI_(Spectrum)",
   "RGBI_(Lumacode)",
   "RGBrgb_(Spectrum)",
   "RGBrgb_(Amstrad)",
   "RrGgBb_(EGA)",
   "RrGgBbI_(SAM)",
   "MDA-Hercules",
   "Dragon-CoCo_Black",
   "Dragon-CoCo_Full",
   "Dragon-CoCo_Emu",
   "Atom_MKII",
   "Atom_MKII_Plus",
   "Atom_MKII_Full",
   "Mono_(2_level)",
   "Mono_(3_level)",
   "Mono_(3_level_Bright)",
   "Mono_(4_level)",
   "Mono_(6_level)",
   "Mono_(8_level_RGB)",
   "Mono_(8_level_YUV)",
   "TMS99XX",
   "TMS99XX_(Lumacode)",
   "Spectrum_48K_9Col",
   "Colour_Genie_S24",
   "Colour_Genie_S25",
   "Colour_Genie_N25",
   "Commodore_64",
   "Commodore_64_Rev1",
   "VIC_20",
   "Atari_800_PAL",
   "Atari_800_NTSC",
   "Atari_2600_PAL",
   "Atari_2600_NTSC",
   "Tea1002",
   "Intellivision",
   "Test_4_Lvl_G_or_Y",
   "Test_4_Lvl_B_or_U",
   "Test_4_Lvl_R_or_V",
};

static const char *palette_control_names[] = {
   "Off",
   "In Band Commands",
   "CGA NTSC Artifact",
   "Mono NTSC Artifact",
   "Auto NTSC Artifact",
   "Commodore 64 YUV",
   "Atari GTIA YUV",
   "4 Bit Lumacode",
   "6/8 Bit Lumacode",
   "8 Bit Lumacode"
};

static const char *return_names[] = {
   "Start",
   "End"
};

static const char *genlock_mode_names[] = {
   "On (Locked)",
   "Off (Unlocked)",
   "1000ppm Fast",
   "2000ppm Fast",
   "2000ppm Slow",
   "1000ppm Slow"
};

static const char *deinterlace_names[] = {
   "Weave",
   "Simple Bob",
   "Simple Motion 1",
   "Simple Motion 2",
   "Simple Motion 3",
   "Simple Motion 4",
   "Advanced Motion"
};

#ifdef MULTI_BUFFER
static const char *nbuffer_names[] = {
   "1",
   "2",
   "3",
   "4"
};
#endif

static const char *autoswitch_names[] = {
   "Off",
   "Sub-Profile Only",
   "Sub + BBC Mode 7",
   "Sub + Vsync",
   "Sub + Apple IIGS",
   "Sub + IIGS + Manual",
   "Sub + Manual"
};

static const char *overscan_names[] = {
   "0%",
   "10%",
   "20%",
   "30%",
   "40%",
   "50%",
   "60%",
   "70%",
   "80%",
   "90%",
   "100%"
};

static const char *colour_names[] = {
   "Normal",
   "Monochrome",
   "Green",
   "Amber"
};

static const char *invert_names[] = {
   "Normal",
   "Invert RGB/YUV",
   "Invert G/Y"
};

static const char *scaling_names[] = {
   "Auto",
   "Integer/Sharp",
   "Integer/Soft",
   "Integer/Softer",
   "Interpolate 4:3/Soft",
   "Interpolate 4:3/Softer",
   "Interpolate Full/Soft",
   "Interpolate Full/Softer"
};

static const char *frontend_names_6[] = {
   "3 Bit Digital RGB(TTL)",
   "12 Bit Simple",
   "Atom",
   "6 Bit Digital RGB(TTL)",
   "6 Bit Digital YUV(TTL)",
   "6 Bit Analog RGB Issue 3",
   "6 Bit Analog RGB Issue 2",
   "6 Bit Analog RGB Issue 1A",
   "6 Bit Analog RGB Issue 1B",
   "6 Bit Analog RGB Issue 4",
   "6 Bit Analog RGB Issue 5",
   "6 Bit Analog YUV Issue 3",
   "6 Bit Analog YUV Issue 2",
   "6 Bit Analog YUV Issue 4",
   "6 Bit Analog YUV Issue 5"
};

static const char *frontend_names_8[] = {
   "3 Bit Digital RGB(TTL)",
   "12 Bit Simple",
   "Atom",
   "8/12 Bit Digital RGB(TTL)",
   "8 Bit Digital YUV(TTL)",
   "8 Bit Analog RGB Issue 3",
   "8 Bit Analog RGB Issue 2",
   "8 Bit Analog RGB Issue 1A",
   "8 Bit Analog RGB Issue 1B",
   "8 Bit Analog RGB Issue 4",
   "8 Bit Analog RGB Issue 5",
   "8 Bit Analog YUV Issue 3",
   "8 Bit Analog YUV Issue 2",
   "8 Bit Analog YUV Issue 4",
   "8 Bit Analog YUV Issue 5"
};

static const char *frontend_names_mono_luma[] = {
   "3 Bit Digital RGB(TTL)",
   "12 Bit Simple",
   "Atom",
   "8/12 Bit Digital RGB(TTL)",
   "8 Bit Digital YUV(TTL)",
   "8 Bit Analog RGB Issue 3",
   "8 Bit Analog RGB Issue 2",
   "8 Bit Analog RGB Issue 1A",
   "8 Bit Analog RGB Issue 1B",
   "RGB Issue 4 Mono/Lumacode",
   "RGB Issue 5 Mono/Lumacode",
   "8 Bit Analog YUV Issue 3",
   "8 Bit Analog YUV Issue 2",
   "YUV Issue 4 Mono/Lumacode",
   "YUV Issue 5 Mono/Lumacode"
};

static const char *genlock_speed_names[] = {
   "Slow (333PPM)",
   "Medium (1000PPM)",
   "Fast (2000PPM)"
};

static const char *genlock_adjust_names[] = {
   "48Hz to Unlimited",
   "48Hz to Limit +5%",
   "Profile +-5%",
   "Profile +-2%",
   "Profile +-1%"
};

static const char *fontsize_names[] = {
   "Always 8x8",
   "Auto 12x20 or 8x8"
};

static const char *even_scaling_names[] = {
   "Even",
   "Uneven (3:2>>4:3)"
};

static const char *hdmi_auto_names[] = {
   "Manual",
   "Auto"
};

static const char *screencap_names[] = {
   "Normal",
   "Full Screen",
   "4:3 Crop",
   "Full 4:3 Crop"
};

static const char *phase_names[] = {
   "0 Deg",
   "90 Deg",
   "180 Deg",
   "270 Deg"
};

static const char *fringe_names[] = {
   "Normal",
   "Sharp",
   "Soft"
};

static const char *ntsctype_names[] = {
   "New CGA (Zero 2W)",
   "Old CGA (Zero 2W)",
   "Apple (Zero 2W)",
   "Simple (Old Code)"
};

static const char *hdmi_names[] = {
   "DVI Compatible",
   "HDMI (Auto RGB/YUV)",
   "HDMI (RGB limited)",
   "HDMI (RGB full)",
   "HDMI (YUV limited)",
   "HDMI (YUV full)"
};

static const char *refresh_names[] = {
   "60Hz",
   "EDID 50Hz-60Hz",
   "Force 50Hz-60Hz",
   "Force 50Hz-Any",
   "50Hz"
};

static const char *saved_config_names[] = {
   "Primary",
   "Alt 1",
   "Alt 2",
   "Alt 3",
   "Alt 4"
};

static const char *integer_names[] = {
   "Normal",
   "Maximise"
};


static const char *alt_profile_names[] = {
   "Set 1",
   "Set 2"
};

static const char *pal_odd_names[] = {
   "Off",
   "Blended Colours",
   "All Colours"
};


// =============================================================
// Feature definitions
// =============================================================



static param_t features[] = {
   {        F_AUTO_SWITCH,       "Auto Switch",       "auto_switch", 0, NUM_AUTOSWITCHES - 1, 1 },
   {         F_RESOLUTION,        "Resolution",        "resolution", 0,                    0, 1 },
   {            F_REFRESH,           "Refresh",           "refresh", 0,      NUM_REFRESH - 1, 1 },
   {          F_HDMI_AUTO,  "HDMI Mode Detect",         "hdmi_auto", 0,                    1, 1 },
   {          F_HDMI_MODE,  "HDMI Manual Mode",         "hdmi_mode", 0,        NUM_HDMIS - 1, 1 },
   {  F_HDMI_MODE_STANDBY, "HDMI Grey Standby",      "hdmi_standby", 0,                    1, 1 },
   {            F_SCALING,           "Scaling",           "scaling", 0,      NUM_SCALING - 1, 1 },
   {            F_PROFILE,           "Profile",           "profile", 0,                    0, 1 },
   {       F_SAVED_CONFIG,      "Saved Config",      "saved_config", 0,                    4, 1 },
   {        F_SUB_PROFILE,       "Sub-Profile",        "subprofile", 0,                    0, 1 },
   {            F_PALETTE,           "Palette",           "palette", 0,                    0, 1 },
   {    F_PALETTE_CONTROL,    "Palette Control",   "palette_control", 0,     NUM_CONTROLS - 1, 1 },
   {        F_NTSC_COLOUR,    "Artifact Colour",       "ntsc_colour", 0,                    1, 1 },
   {         F_NTSC_PHASE,         "NTSC Phase",        "ntsc_phase", 0,                    3, 1 },
   {          F_NTSC_TYPE,          "NTSC Type",         "ntsc_type", 0,     NUM_NTSCTYPE - 1, 1 },
   {       F_NTSC_QUALITY,       "NTSC Quality",      "ntsc_quality", 0,       NUM_FRINGE - 1, 1 },
   {      F_PAL_ODD_LEVEL,       "PAL Odd Level",     "pal_oddlevel", -180,             180, 1 },
   {       F_PAL_ODD_LINE,       "PAL Odd Line",       "pal_oddline", 0,      NUM_PAL_ODD - 1, 1 },
   {               F_TINT,               "Tint",              "tint",-60,                  60, 1 },
   {                F_SAT,         "Saturation",        "saturation", 0,                  200, 1 },
   {                F_CONT,           "Contrast",          "contrast", 0,                  200, 1 },
   {              F_BRIGHT,         "Brightness",        "brightness", 0,                  200, 1 },
   {               F_GAMMA,              "Gamma",             "gamma", 10,                 300, 1 },
   {          F_TIMING_SET,         "Timing Set",        "timing_set", 0,                    1, 1 },
   {   F_MODE7_DEINTERLACE,"Teletext Deinterlace","teletext_deinterlace", 0, NUM_M7DEINTERLACES - 1, 1 },
   {  F_NORMAL_DEINTERLACE, "Normal Deinterlace",   "normal_deinterlace", 0,   NUM_DEINTERLACES - 1, 1 },
   {       F_MODE7_SCALING,  "Teletext Scaling",  "teletext_scaling", 0,    NUM_ESCALINGS - 1, 1 },
   {      F_NORMAL_SCALING,    "Normal Scaling",    "normal_scaling", 0,    NUM_ESCALINGS - 1, 1 },
   {          F_DROP_FRAME,"Drop Frame (25/30Hz)",      "drop_frame", 0,                    1, 1 },
   {               F_FFOSD,     "FFOSD Overlay",     "ffosd_overlay", 0,                    1, 1 },
   {         F_SWAP_ASPECT,"Swap Aspect 625<>525",     "swap_aspect", 0,                    1, 1 },
   {       F_OUTPUT_COLOUR,     "Output Colour",     "output_colour", 0,      NUM_COLOURS - 1, 1 },
   {       F_OUTPUT_INVERT,     "Output Invert",     "output_invert", 0,       NUM_INVERT - 1, 1 },
   {           F_SCANLINES,         "Scanlines",         "scanlines", 0,                    1, 1 },
   {      F_SCANLINE_LEVEL,    "Scanline Level",    "scanline_level", 0,                   14, 1 },
   {         F_CROP_BORDER,"Crop Border (Zoom)",       "crop_border", 0,     NUM_OVERSCAN - 1, 1 },
   {      F_SCREENCAP_SIZE,    "ScreenCap Size",    "screencap_size", 0,    NUM_SCREENCAP - 1, 1 },
   {           F_FONT_SIZE,         "Font Size",         "font_size", 0,     NUM_FONTSIZE - 1, 1 },
   {       F_BORDER_COLOUR,     "Border Colour",     "border_colour", 0,                  255, 1 },
   {     F_VSYNC_INDICATOR,  "V Sync Indicator",   "vsync_indicator", 0,                    1, 1 },
   {        F_GENLOCK_MODE,       "Genlock Mode",     "genlock_mode", 0,         NUM_HDMI - 1, 1 },
   {        F_GENLOCK_LINE,      "Genlock Line",      "genlock_line",35,                  312, 1 },
   {       F_GENLOCK_SPEED,     "Genlock Speed",     "genlock_speed", 0,NUM_GENLOCK_SPEED - 1, 1 },
   {      F_GENLOCK_ADJUST,    "Genlock Adjust",    "genlock_adjust", 0,NUM_GENLOCK_ADJUST - 1, 1 },
#ifdef MULTI_BUFFER
   {         F_NUM_BUFFERS,       "Num Buffers",       "num_buffers", 0,                    3, 1 },
#endif
   {     F_RETURN_POSITION,   "Return Position",            "return", 0,                    1, 1 },
   {               F_DEBUG,             "Debug",             "debug", 0,                    1, 1 },
   {      F_BUTTON_REVERSE,    "Button Reverse",    "button_reverse", 0,                    1, 1 },

   {       F_OVERCLOCK_CPU,     "Overclock CPU",     "overclock_cpu", 0,                  200, 1 },
   {      F_OVERCLOCK_CORE,    "Overclock Core",    "overclock_core", 0,                  200, 1 },
   {     F_OVERCLOCK_SDRAM,   "Overclock SDRAM",   "overclock_sdram", 0,                  200, 1 },
   {     F_POWERUP_MESSAGE,   "Powerup Message",   "powerup_message", 0,                    1, 1 },

   {    F_YUV_PIXEL_DOUBLE,  "YUV Pixel Double",  "yuv_pixel_double", 0,                    1, 1 },
   {      F_INTEGER_ASPECT,    "Integer Aspect",    "integer_aspect", 0,                    1, 1 },

   {         F_PROFILE_NUM,"Custom Profile Num",    "profile_number", 0,                  9, 1 },
   {             F_H_WIDTH,       "Pixel Width",       "pixel_width", 120,               1920, 8 },
   {            F_V_HEIGHT,      "Pixel Height",      "pixel_height", 120,               1200, 2 },
   {               F_CLOCK,   "Clock Frequency",   "pixel_frequency", 1000000,    64000000, 1000 },
   {            F_LINE_LEN,       "Line Length", "pixel_line_length",       100,    5000,    1 },
   {            F_H_OFFSET,          "H Offset",    "pixel_h_offset", -256,               256, 4 },
   {            F_V_OFFSET,          "V Offset",    "pixel_v_offset", -256,               256, 1 },

   {            F_FRONTEND,         "Interface",         "interface", 0,    NUM_FRONTENDS - 1, 1 },
   {                -1,                NULL,                NULL, 0,                    0, 0 }
};

// =============================================================
// Menu definitions
// =============================================================


typedef enum {
   I_MENU,     // Item points to a sub-menu
   I_FEATURE,  // Item is a "feature" (i.e. managed by the osd)
   I_GEOMETRY, // Item is a "geometry" (i.e. managed by the geometry)
   I_PARAM,    // Item is a "parameter" (i.e. managed by the cpld)
   I_INFO,     // Item is an info screen
   I_BACK,     // Item is a link back to the previous menu
   I_SAVE,     // Item is a saving profile option
   I_RESTORE,  // Item is a restoring a profile option
   I_UPDATE,   // Item is a cpld update
   I_PICKMAN,  // Item is a pick manufacturer
   I_PICKPRO,  // Item is a pick profile
   I_CALIBRATE,// Item is a calibration update
   I_CALIBRATE_NO_SAVE,// Item is a calibration update without saving
   I_TEST,     // Item is a 50 Hz test option
   I_CREATE,    // Item is create profile menu
   I_SAVE_CUSTOM, //Item is save custom profile
   I_DELETE_CUSTOM //Item is delete custom profile
} item_type_t;

typedef struct {
   item_type_t       type;
} base_menu_item_t;

typedef struct menu {
   char *name;
   void            (*rebuild)(struct menu *this);
   base_menu_item_t *items[];
} menu_t;

typedef struct {
   item_type_t       type;
   menu_t           *child;
} child_menu_item_t;

typedef struct {
   item_type_t       type;
   param_t          *param;
} param_menu_item_t;

typedef struct {
   item_type_t       type;
   char             *name;
   void            (*show_info)(int line);
} info_menu_item_t;

typedef struct {
   item_type_t       type;
   char             *name;
} back_menu_item_t;

typedef struct {
   item_type_t       type;
   char             *name;
} action_menu_item_t;

static void info_source_summary(int line);
static void info_system_summary(int line);
static void info_help_quickstart(int line);
static void info_help_buttons(int line);
static void info_help_calibration(int line);
static void info_help_noise(int line);
static void info_help_flashing(int line);
static void info_help_artifacts(int line);
static void info_help_updates(int line);
static void info_help_custom_profile(int line);
static void info_help_custom_hints(int line);

static void info_cal_summary(int line);
static void info_cal_detail(int line);
static void info_cal_raw(int line);
static void info_save_list(int line);
static void info_save_log(int line);
static void info_credits(int line);
static void info_reboot(int line);

static void info_test_50hz(int line);
static void rebuild_geometry_menu(menu_t *menu);
static void rebuild_sampling_menu(menu_t *menu);
static void rebuild_update_cpld_menu(menu_t *menu);
static void rebuild_manufacturer_menu(menu_t *menu);
static void rebuild_profile_menu(menu_t *menu);

static void analyse_timing(int line);

static info_menu_item_t source_summary_ref      = { I_INFO, "Source Summary",       info_source_summary};
static info_menu_item_t system_summary_ref      = { I_INFO, "System Summary",       info_system_summary};
static info_menu_item_t help_quickstart_ref     = { I_INFO, "Help Quick Start",     info_help_quickstart};
static info_menu_item_t help_buttons_ref        = { I_INFO, "Help Buttons",         info_help_buttons};
static info_menu_item_t help_calibration_ref    = { I_INFO, "Help Calibration",     info_help_calibration};
static info_menu_item_t help_noise_ref          = { I_INFO, "Help Noise",           info_help_noise};
static info_menu_item_t help_flashing_ref       = { I_INFO, "Help Flashing Screen", info_help_flashing};
static info_menu_item_t help_artifacts_ref      = { I_INFO, "Help NTSC Artifacts",  info_help_artifacts};
static info_menu_item_t help_updates_ref        = { I_INFO, "Help Software Updates",info_help_updates};
static info_menu_item_t help_custom_profile_ref = { I_INFO, "Help Create Profile",  info_help_custom_profile};
static info_menu_item_t help_custom_hints_ref   = { I_INFO, "Help Hints and Tips",  info_help_custom_hints};
static info_menu_item_t cal_summary_ref         = { I_INFO, "Calibration Summary",  info_cal_summary};
static info_menu_item_t cal_detail_ref          = { I_INFO, "Calibration Detail",   info_cal_detail};
static info_menu_item_t cal_raw_ref             = { I_INFO, "Calibration Raw",      info_cal_raw};
static info_menu_item_t save_list_ref           = { I_INFO, "Save Profile List",    info_save_list};
static info_menu_item_t save_log_ref            = { I_INFO, "Save Log & EDID",      info_save_log};
static info_menu_item_t credits_ref             = { I_INFO, "Credits",              info_credits};
static info_menu_item_t reboot_ref              = { I_INFO, "Reboot",               info_reboot};


static info_menu_item_t analyse_timing_ref      = { I_INFO, "Analyse Timing",    analyse_timing};

static back_menu_item_t back_ref                     = { I_BACK, "Return"};
static action_menu_item_t save_ref                   = { I_SAVE, "Save Configuration"};
static action_menu_item_t restore_ref                = { I_RESTORE, "Restore Default Configuration"};
static action_menu_item_t cal_sampling_ref           = { I_CALIBRATE, "Auto Calibrate Video Sampling"};
static action_menu_item_t cal_sampling_no_save_ref   = { I_CALIBRATE_NO_SAVE, "Auto Calibrate Video Sampling"};
static action_menu_item_t save_custom_profile_ref    = { I_SAVE_CUSTOM, "Save Custom Profile"};
static action_menu_item_t delete_custom_profile_ref  = { I_DELETE_CUSTOM, "Delete Custom Profile"};
static info_menu_item_t test_50hz_ref                = { I_TEST, "Test Monitor for 50Hz Support",  info_test_50hz};

static menu_t update_cpld_menu = {
   "Update CPLD Menu",
   rebuild_update_cpld_menu,
   {
      // Allow space for max 30 params
      NULL,
      NULL,
      NULL,
      NULL,
      NULL,
      NULL,
      NULL,
      NULL,
      NULL,
      NULL,
      NULL,
      NULL,
      NULL,
      NULL,
      NULL,
      NULL,
      NULL,
      NULL,
      NULL,
      NULL,
      NULL,
      NULL,
      NULL,
      NULL,
      NULL,
      NULL,
      NULL,
      NULL,
      NULL,
      NULL,
      NULL
   }
};

static menu_t manufacturer_menu = {
   "Select Profile",
   rebuild_manufacturer_menu,
   {
      // Allow space for max 30 params
      NULL,
      NULL,
      NULL,
      NULL,
      NULL,
      NULL,
      NULL,
      NULL,
      NULL,
      NULL,
      NULL,
      NULL,
      NULL,
      NULL,
      NULL,
      NULL,
      NULL,
      NULL,
      NULL,
      NULL,
      NULL,
      NULL,
      NULL,
      NULL,
      NULL,
      NULL,
      NULL,
      NULL,
      NULL,
      NULL,
      NULL
   }
};

static menu_t profile_menu = {
   "Select Profile",
   rebuild_profile_menu,
   {
      // Allow space for max 30 params
      NULL,
      NULL,
      NULL,
      NULL,
      NULL,
      NULL,
      NULL,
      NULL,
      NULL,
      NULL,
      NULL,
      NULL,
      NULL,
      NULL,
      NULL,
      NULL,
      NULL,
      NULL,
      NULL,
      NULL,
      NULL,
      NULL,
      NULL,
      NULL,
      NULL,
      NULL,
      NULL,
      NULL,
      NULL,
      NULL,
      NULL
   }
};



static param_menu_item_t profile_ref         = { I_FEATURE, &features[F_PROFILE]          };
static param_menu_item_t saved_ref           = { I_FEATURE, &features[F_SAVED_CONFIG]     };
static param_menu_item_t subprofile_ref      = { I_FEATURE, &features[F_SUB_PROFILE]      };
static param_menu_item_t resolution_ref      = { I_FEATURE, &features[F_RESOLUTION]       };
static param_menu_item_t refresh_ref         = { I_FEATURE, &features[F_REFRESH]          };
static param_menu_item_t hdmi_auto_ref       = { I_FEATURE, &features[F_HDMI_AUTO]        };
static param_menu_item_t hdmi_ref            = { I_FEATURE, &features[F_HDMI_MODE]        };
static param_menu_item_t hdmi_standby_ref    = { I_FEATURE, &features[F_HDMI_MODE_STANDBY]};
static param_menu_item_t scaling_ref         = { I_FEATURE, &features[F_SCALING]          };
static param_menu_item_t overscan_ref        = { I_FEATURE, &features[F_CROP_BORDER]      };
static param_menu_item_t capscale_ref        = { I_FEATURE, &features[F_SCREENCAP_SIZE]   };
static param_menu_item_t border_ref          = { I_FEATURE, &features[F_BORDER_COLOUR]    };
static param_menu_item_t palettecontrol_ref  = { I_FEATURE, &features[F_PALETTE_CONTROL]  };
static param_menu_item_t ntsccolour_ref      = { I_FEATURE, &features[F_NTSC_COLOUR]      };
static param_menu_item_t ntscphase_ref       = { I_FEATURE, &features[F_NTSC_PHASE]       };
static param_menu_item_t ntsctype_ref        = { I_FEATURE, &features[F_NTSC_TYPE]        };
static param_menu_item_t ntscfringe_ref      = { I_FEATURE, &features[F_NTSC_QUALITY]     };
static param_menu_item_t paloddline_ref      = { I_FEATURE, &features[F_PAL_ODD_LINE]     };
static param_menu_item_t paloddlevel_ref     = { I_FEATURE, &features[F_PAL_ODD_LEVEL]    };
static param_menu_item_t tint_ref            = { I_FEATURE, &features[F_TINT]             };
static param_menu_item_t sat_ref             = { I_FEATURE, &features[F_SAT]              };
static param_menu_item_t cont_ref            = { I_FEATURE, &features[F_CONT]             };
static param_menu_item_t bright_ref          = { I_FEATURE, &features[F_BRIGHT]           };
static param_menu_item_t gamma_ref           = { I_FEATURE, &features[F_GAMMA]            };
static param_menu_item_t timingset_ref       = { I_FEATURE, &features[F_TIMING_SET]       };
static param_menu_item_t palette_ref         = { I_FEATURE, &features[F_PALETTE]          };
static param_menu_item_t m7deinterlace_ref   = { I_FEATURE, &features[F_MODE7_DEINTERLACE]};
static param_menu_item_t deinterlace_ref     = { I_FEATURE, &features[F_NORMAL_DEINTERLACE]    };
static param_menu_item_t m7scaling_ref       = { I_FEATURE, &features[F_MODE7_SCALING]      };
static param_menu_item_t normalscaling_ref   = { I_FEATURE, &features[F_NORMAL_SCALING]  };
static param_menu_item_t drop_frame_ref       = { I_FEATURE, &features[F_DROP_FRAME]  };
static param_menu_item_t ffosd_ref           = { I_FEATURE, &features[F_FFOSD]          };
static param_menu_item_t stretch_ref         = { I_FEATURE, &features[F_SWAP_ASPECT]        };
static param_menu_item_t scanlines_ref       = { I_FEATURE, &features[F_SCANLINES]      };
static param_menu_item_t scanlinesint_ref    = { I_FEATURE, &features[F_SCANLINE_LEVEL]   };
static param_menu_item_t colour_ref          = { I_FEATURE, &features[F_OUTPUT_COLOUR]         };
static param_menu_item_t invert_ref          = { I_FEATURE, &features[F_OUTPUT_INVERT]         };
static param_menu_item_t fontsize_ref        = { I_FEATURE, &features[F_FONT_SIZE]       };
static param_menu_item_t vsync_ref           = { I_FEATURE, &features[F_VSYNC_INDICATOR]          };
static param_menu_item_t genlock_mode_ref    = { I_FEATURE, &features[F_GENLOCK_MODE]      };
static param_menu_item_t genlock_line_ref    = { I_FEATURE, &features[F_GENLOCK_LINE]      };
static param_menu_item_t genlock_speed_ref   = { I_FEATURE, &features[F_GENLOCK_SPEED]     };
static param_menu_item_t genlock_adjust_ref  = { I_FEATURE, &features[F_GENLOCK_ADJUST]       };
#ifdef MULTI_BUFFER
static param_menu_item_t nbuffers_ref        = { I_FEATURE, &features[F_NUM_BUFFERS]       };
#endif
static param_menu_item_t autoswitch_ref      = { I_FEATURE, &features[F_AUTO_SWITCH]     };
static param_menu_item_t return_ref          = { I_FEATURE, &features[F_RETURN_POSITION]         };
static param_menu_item_t debug_ref           = { I_FEATURE, &features[F_DEBUG]          };
static param_menu_item_t direction_ref       = { I_FEATURE, &features[F_BUTTON_REVERSE]      };
static param_menu_item_t oclock_cpu_ref      = { I_FEATURE, &features[F_OVERCLOCK_CPU]     };
static param_menu_item_t oclock_core_ref     = { I_FEATURE, &features[F_OVERCLOCK_CORE]    };
static param_menu_item_t oclock_sdram_ref    = { I_FEATURE, &features[F_OVERCLOCK_SDRAM]   };
static param_menu_item_t res_status_ref      = { I_FEATURE, &features[F_POWERUP_MESSAGE]        };
static param_menu_item_t yuv_pixel_ref       = { I_FEATURE, &features[F_YUV_PIXEL_DOUBLE]      };
static param_menu_item_t aspect_ref          = { I_FEATURE, &features[F_INTEGER_ASPECT]         };

static param_menu_item_t profile_num_ref     = { I_FEATURE, &features[F_PROFILE_NUM]   };
static param_menu_item_t h_width_ref         = { I_FEATURE, &features[F_H_WIDTH]       };
static param_menu_item_t v_height_ref        = { I_FEATURE, &features[F_V_HEIGHT]      };
static param_menu_item_t clock_ref           = { I_FEATURE, &features[F_CLOCK]         };
static param_menu_item_t line_len_ref        = { I_FEATURE, &features[F_LINE_LEN]      };
static param_menu_item_t h_offset_ref        = { I_FEATURE, &features[F_H_OFFSET]      };
static param_menu_item_t v_offset_ref        = { I_FEATURE, &features[F_V_OFFSET]      };

#ifndef HIDE_INTERFACE_SETTING
static param_menu_item_t frontend_ref        = { I_FEATURE, &features[F_FRONTEND]       };
#endif

static menu_t custom_profile_menu = {
   "Create Custom Profile",
   NULL,
   {
      (base_menu_item_t *) &back_ref,
      (base_menu_item_t *) &analyse_timing_ref,
      (base_menu_item_t *) &h_width_ref,
      (base_menu_item_t *) &v_height_ref,
      (base_menu_item_t *) &clock_ref,
      (base_menu_item_t *) &line_len_ref,
      (base_menu_item_t *) &h_offset_ref,
      (base_menu_item_t *) &v_offset_ref,
      (base_menu_item_t *) &cal_sampling_no_save_ref,
      //(base_menu_item_t *) &palette_ref,
      (base_menu_item_t *) &profile_num_ref,
      (base_menu_item_t *) &save_custom_profile_ref,
      (base_menu_item_t *) &delete_custom_profile_ref,
      (base_menu_item_t *) &help_custom_profile_ref,
      (base_menu_item_t *) &help_custom_hints_ref,
      NULL
   }
};

static child_menu_item_t update_cpld_menu_ref  = { I_MENU, &update_cpld_menu };
static child_menu_item_t custom_profile_ref = { I_CREATE, &custom_profile_menu };

static menu_t info_menu = {
   "Info & Help Menu",
   NULL,
   {
      (base_menu_item_t *) &back_ref,
      (base_menu_item_t *) &source_summary_ref,
      (base_menu_item_t *) &system_summary_ref,
      (base_menu_item_t *) &cal_summary_ref,
      (base_menu_item_t *) &cal_detail_ref,
      (base_menu_item_t *) &cal_raw_ref,
      (base_menu_item_t *) &help_quickstart_ref,
      (base_menu_item_t *) &help_buttons_ref,
      (base_menu_item_t *) &help_calibration_ref,
      (base_menu_item_t *) &help_artifacts_ref,
      (base_menu_item_t *) &help_flashing_ref,
      (base_menu_item_t *) &help_noise_ref,
      (base_menu_item_t *) &help_updates_ref,
      (base_menu_item_t *) &help_custom_profile_ref,
      (base_menu_item_t *) &help_custom_hints_ref,
      (base_menu_item_t *) &save_list_ref,
      (base_menu_item_t *) &save_log_ref,
      (base_menu_item_t *) &credits_ref,
#ifndef HIDE_INTERFACE_SETTING
      (base_menu_item_t *) &frontend_ref,
#endif
      (base_menu_item_t *) &reboot_ref,
      NULL
   }
};

static menu_t palette_menu = {
   "Palette Menu",
   NULL,
   {
      (base_menu_item_t *) &back_ref,
      (base_menu_item_t *) &palette_ref,
      (base_menu_item_t *) &colour_ref,
      (base_menu_item_t *) &invert_ref,
      (base_menu_item_t *) &border_ref,
      (base_menu_item_t *) &bright_ref,
      (base_menu_item_t *) &cont_ref,
      (base_menu_item_t *) &gamma_ref,
      (base_menu_item_t *) &sat_ref,
      (base_menu_item_t *) &tint_ref,
      (base_menu_item_t *) &palettecontrol_ref,
      (base_menu_item_t *) &ntsccolour_ref,
      (base_menu_item_t *) &ntscphase_ref,
      (base_menu_item_t *) &ntsctype_ref,
      (base_menu_item_t *) &ntscfringe_ref,
      (base_menu_item_t *) &paloddline_ref,
      (base_menu_item_t *) &paloddlevel_ref,
      NULL
   }
};

static menu_t preferences_menu = {
   "Preferences Menu",
   NULL,
   {
      (base_menu_item_t *) &back_ref,
      (base_menu_item_t *) &scanlines_ref,
      (base_menu_item_t *) &scanlinesint_ref,
      (base_menu_item_t *) &stretch_ref,
      (base_menu_item_t *) &overscan_ref,
      (base_menu_item_t *) &m7deinterlace_ref,
      (base_menu_item_t *) &deinterlace_ref,
      (base_menu_item_t *) &m7scaling_ref,
      (base_menu_item_t *) &normalscaling_ref,
      (base_menu_item_t *) &drop_frame_ref,
      (base_menu_item_t *) &capscale_ref,
      (base_menu_item_t *) &yuv_pixel_ref,
      (base_menu_item_t *) &aspect_ref,
      (base_menu_item_t *) &res_status_ref,
      NULL
   }
};


static menu_t settings_menu = {
   "Settings Menu",
   NULL,
   {
      (base_menu_item_t *) &back_ref,
      (base_menu_item_t *) &fontsize_ref,
      (base_menu_item_t *) &vsync_ref,
      (base_menu_item_t *) &genlock_mode_ref,
      (base_menu_item_t *) &genlock_line_ref,
      (base_menu_item_t *) &genlock_speed_ref,
      (base_menu_item_t *) &genlock_adjust_ref,
      (base_menu_item_t *) &nbuffers_ref,
      (base_menu_item_t *) &ffosd_ref,
      (base_menu_item_t *) &hdmi_auto_ref,
      (base_menu_item_t *) &hdmi_ref,
      (base_menu_item_t *) &hdmi_standby_ref,
      (base_menu_item_t *) &return_ref,
      (base_menu_item_t *) &oclock_cpu_ref,
      (base_menu_item_t *) &oclock_core_ref,
      (base_menu_item_t *) &oclock_sdram_ref,
      (base_menu_item_t *) &debug_ref,
      (base_menu_item_t *) &update_cpld_menu_ref,
      NULL
   }
};

static param_menu_item_t dynamic_item[] = {
   { I_PARAM, NULL },
   { I_PARAM, NULL },
   { I_PARAM, NULL },
   { I_PARAM, NULL },
   { I_PARAM, NULL },
   { I_PARAM, NULL },
   { I_PARAM, NULL },
   { I_PARAM, NULL },
   { I_PARAM, NULL },
   { I_PARAM, NULL },
   { I_PARAM, NULL },
   { I_PARAM, NULL },
   { I_PARAM, NULL },
   { I_PARAM, NULL },
   { I_PARAM, NULL },
   { I_PARAM, NULL },
   { I_PARAM, NULL },
   { I_PARAM, NULL },
   { I_PARAM, NULL },
   { I_PARAM, NULL },
   { I_PARAM, NULL },
   { I_PARAM, NULL },
   { I_PARAM, NULL },
   { I_PARAM, NULL },
   { I_PARAM, NULL },
   { I_PARAM, NULL },
   { I_PARAM, NULL },
   { I_PARAM, NULL },
   { I_PARAM, NULL },
   { I_PARAM, NULL }
};

static menu_t geometry_menu = {
   "Geometry Menu",
   rebuild_geometry_menu,
   {
      // Allow space for max 30 params
      NULL,
      NULL,
      NULL,
      NULL,
      NULL,
      NULL,
      NULL,
      NULL,
      NULL,
      NULL,
      NULL,
      NULL,
      NULL,
      NULL,
      NULL,
      NULL,
      NULL,
      NULL,
      NULL,
      NULL,
      NULL,
      NULL,
      NULL,
      NULL,
      NULL,
      NULL,
      NULL,
      NULL,
      NULL,
      NULL,
      NULL
   }
};

static menu_t sampling_menu = {
   "Sampling Menu",
   rebuild_sampling_menu,
   {
      // Allow space for max 30 params
      NULL,
      NULL,
      NULL,
      NULL,
      NULL,
      NULL,
      NULL,
      NULL,
      NULL,
      NULL,
      NULL,
      NULL,
      NULL,
      NULL,
      NULL,
      NULL,
      NULL,
      NULL,
      NULL,
      NULL,
      NULL,
      NULL,
      NULL,
      NULL,
      NULL,
      NULL,
      NULL,
      NULL,
      NULL,
      NULL,
      NULL
   }
};

static child_menu_item_t info_menu_ref        = { I_MENU, &info_menu        };
static child_menu_item_t palette_menu_ref     = { I_MENU, &palette_menu     };
static child_menu_item_t preferences_menu_ref = { I_MENU, &preferences_menu };
static child_menu_item_t settings_menu_ref    = { I_MENU, &settings_menu    };
static child_menu_item_t geometry_menu_ref    = { I_MENU, &geometry_menu    };
static child_menu_item_t sampling_menu_ref    = { I_MENU, &sampling_menu    };
static child_menu_item_t manufacturer_menu_ref = { I_MENU, &manufacturer_menu };

static menu_t main_menu = {
   "Main Menu",
   NULL,
   {
      // Allow space for max 30 params
      NULL,
      NULL,
      NULL,
      NULL,
      NULL,
      NULL,
      NULL,
      NULL,
      NULL,
      NULL,
      NULL,
      NULL,
      NULL,
      NULL,
      NULL,
      NULL,
      NULL,
      NULL,
      NULL,
      NULL,
      NULL,
      NULL,
      NULL,
      NULL,
      NULL,
      NULL,
      NULL,
      NULL,
      NULL,
      NULL,
      NULL
   }
};



// =============================================================
// Static local variables
// =============================================================

static char buffer[LINELEN * NLINES];

static int attributes[NLINES];

// Mapping table for expanding 12-bit row to 24 bit pixel (3 words) with 4 bits/pixel
static uint32_t double_size_map_4bpp[0x1000 * 3];

// Mapping table for expanding 12-bit row to 12 bit pixel (2 words + 2 words) with 4 bits/pixel
static uint32_t normal_size_map_4bpp[0x1000 * 4];

// Mapping table for expanding 12-bit row to 24 bit pixel (6 words) with 8 bits/pixel
static uint32_t double_size_map_8bpp[0x1000 * 6];

// Mapping table for expanding 12-bit row to 12 bit pixel (3 words) with 8 bits/pixel
static uint32_t normal_size_map_8bpp[0x1000 * 3];

// Mapping table for expanding 12-bit row to 24 bit pixel (12 words) with 16 bits/pixel
static uint32_t double_size_map_16bpp[0x1000 * 12];

// Mapping table for expanding 12-bit row to 12 bit pixel (6 words) with 16 bits/pixel
static uint32_t normal_size_map_16bpp[0x1000 * 6];



// Mapping table for expanding 8-bit row to 16 bit pixel (2 words) with 4 bits/pixel
static uint32_t double_size_map8_4bpp[0x1000 * 2];

// Mapping table for expanding 8-bit row to 8 bit pixel (1 word) with 4 bits/pixel
static uint32_t normal_size_map8_4bpp[0x1000 * 1];

// Mapping table for expanding 8-bit row to 16 bit pixel (4 words) with 8 bits/pixel
static uint32_t double_size_map8_8bpp[0x1000 * 4];

// Mapping table for expanding 8-bit row to 8 bit pixel (2 words) with 8 bits/pixel
static uint32_t normal_size_map8_8bpp[0x1000 * 2];

// Mapping table for expanding 8-bit row to 16 bit pixel (8 words) with 16 bits/pixel
static uint32_t double_size_map8_16bpp[0x1000 * 8];

// Mapping table for expanding 8-bit row to 8 bit pixel (4 words) with 16 bits/pixel
static uint32_t normal_size_map8_16bpp[0x1000 * 4];

// Temporary buffer for assembling OSD lines
static char message[MAX_STRING_SIZE];

// Temporary filename for assembling OSD lines
static char filename[MAX_STRING_SIZE * 5];

static char selected_manufacturer[MAX_STRING_SIZE];

// Is the OSD currently active
static int active = 0;
static int old_active = -1;

// Main state of the OSD
osd_state_t osd_state = IDLE;

// Current menu depth
static int depth = 0;

// Currently active menu
static menu_t *current_menu[MAX_MENU_DEPTH];

// Index to the currently selected menu
static int current_item[MAX_MENU_DEPTH];

//osd high water mark (highest line number used)
static int osd_hwm = 0;

static int all_frontends[16] = {0,0,0,0,0,0,0,0,0,0,0,0,0,0,0,0};

// Default action map, maps from physical key press to action
static osd_state_t action_map[] = {
   A0_LAUNCH,    //   0 - SW1 short press
   A1_CAPTURE,   //   1 - SW2 short press
   A2_CLOCK_CAL, //   2 - SW3 short press
   A4_SCANLINES, //   3 - SW1 long press
   A5_NTSCCOLOUR,//   4 - SW2 long press
   A3_AUTO_CAL,  //   5 - SW3 long press
};

#define NUM_ACTIONS (sizeof(action_map) / sizeof(osd_state_t))

// Default keymap, used for menu navigation
static int key_enter     = OSD_SW1;
static int key_menu_up   = OSD_SW3;
static int key_menu_down = OSD_SW2;
static int key_value_dec = OSD_SW2;
static int key_value_inc = OSD_SW3;

// Whether the menu back pointer is at the start (0) or end (1) of the menu
static char config_buffer[MAX_CONFIG_BUFFER_SIZE];
static char save_buffer[MAX_BUFFER_SIZE];
static char default_buffer[MAX_BUFFER_SIZE];
static char main_buffer[MAX_BUFFER_SIZE];
static char sub_default_buffer[MAX_BUFFER_SIZE];
static char sub_profile_buffers[MAX_SUB_PROFILES][MAX_BUFFER_SIZE];
static int has_sub_profiles[MAX_PROFILES];
static char manufacturer_names[MAX_PROFILES][MAX_PROFILE_WIDTH];
static char profile_names[MAX_PROFILES][MAX_PROFILE_WIDTH];
static char sub_profile_names[MAX_SUB_PROFILES][MAX_PROFILE_WIDTH];
static char resolution_names[MAX_NAMES][MAX_NAMES_WIDTH];
static char favourite_names[MAX_FAVOURITES + 1][MAX_PROFILE_WIDTH];
static char current_cpld_prefix[MAX_PROFILE_WIDTH];
static char BBC_cpld_prefix[MAX_PROFILE_WIDTH];
static char RGB_cpld_prefix[MAX_PROFILE_WIDTH];
static char YUV_cpld_prefix[MAX_PROFILE_WIDTH];
static int cpld_prefix_length = 0;

static uint32_t palette_data[256];
static uint32_t osd_palette_data[256];
//static unsigned char equivalence[256];

static char palette_names[MAX_NAMES][MAX_NAMES_WIDTH];
static uint32_t palette_array[MAX_NAMES][MAX_PALETTE_ENTRIES];
static int ntsc_palette = 0;

static int inhibit_palette_dimming = 0;
static int single_button_mode = 0;
static int manufacturer_count = 0;
static int full_profile_count = 0;
static int favourites_count = 0;

static int disable_overclock = 0;
static unsigned int cpu_clock = 1000;
static unsigned int core_clock = 400;
static unsigned int sdram_clock = 450;

static char EDID_buf[32768];
static unsigned int EDID_bufptr = 0;
typedef struct {
   int clock;
   int line_len;
   int clock_ppm;
   int lines_per_frame;
   int sync_type;
   int lower_limit;
   int upper_limit;
   int lower_frame_limit;
   int upper_frame_limit;
} autoswitch_info_t;

static autoswitch_info_t autoswitch_info[MAX_SUB_PROFILES];

static char cpld_firmware_dir[MIN_STRING_SIZE] = DEFAULT_CPLD_FIRMWARE_DIR;

// =============================================================
// Private Methods
// =============================================================

void set_menu_table() {
      int index = 0;
      int frontend = get_parameter(F_FRONTEND);
      main_menu.items[index++] = (base_menu_item_t *) &back_ref;
      main_menu.items[index++] = (base_menu_item_t *) &info_menu_ref;
      if (frontend != FRONTEND_SIMPLE) main_menu.items[index++] = (base_menu_item_t *) &palette_menu_ref;
      main_menu.items[index++] = (base_menu_item_t *) &preferences_menu_ref;
      main_menu.items[index++] = (base_menu_item_t *) &settings_menu_ref;
      main_menu.items[index++] = (base_menu_item_t *) &geometry_menu_ref;
      main_menu.items[index++] = (base_menu_item_t *) &sampling_menu_ref;
      main_menu.items[index++] = (base_menu_item_t *) &custom_profile_ref,
      main_menu.items[index++] = (base_menu_item_t *) &save_ref;
      main_menu.items[index++] = (base_menu_item_t *) &restore_ref;
      if (frontend != FRONTEND_SIMPLE) main_menu.items[index++] = (base_menu_item_t *) &cal_sampling_ref;
      main_menu.items[index++] = (base_menu_item_t *) &test_50hz_ref,
      main_menu.items[index++] = (base_menu_item_t *) &resolution_ref;
      main_menu.items[index++] = (base_menu_item_t *) &refresh_ref;
      main_menu.items[index++] = (base_menu_item_t *) &scaling_ref;
      main_menu.items[index++] = (base_menu_item_t *) &saved_ref;
      main_menu.items[index++] = (base_menu_item_t *) &profile_ref;
      main_menu.items[index++] = (base_menu_item_t *) &autoswitch_ref;
      main_menu.items[index++] = (base_menu_item_t *) &subprofile_ref;
      if (get_parameter(F_AUTO_SWITCH) == AUTOSWITCH_IIGS_MANUAL || get_parameter(F_AUTO_SWITCH) == AUTOSWITCH_MANUAL) main_menu.items[index++] = (base_menu_item_t *) &timingset_ref;
      main_menu.items[index++] = (base_menu_item_t *) &manufacturer_menu_ref;
      if (single_button_mode) main_menu.items[index++] = (base_menu_item_t *) &direction_ref;
      main_menu.items[index++] = NULL;
      if (!any_DAC_detected()) {
          features[F_PALETTE_CONTROL].max = PALETTECONTROL_NTSCARTIFACT_BW_AUTO;
      }
      switch (_get_hardware_id()) {
        case 4:                                  //pi 4
          features[F_OVERCLOCK_CPU].max = 200;
          features[F_OVERCLOCK_CORE].max = 200;
          features[F_OVERCLOCK_SDRAM].max = 200;
          break;
        case 3:                                  //pi zero 2 or Pi 3
          features[F_OVERCLOCK_CPU].max = 200;
          features[F_OVERCLOCK_CORE].max = 100;
          features[F_OVERCLOCK_SDRAM].max = 200;
          break;
         case 2:                                 //pi 2
          features[F_OVERCLOCK_CPU].max = 200;
          features[F_OVERCLOCK_CORE].max = 175;
          features[F_OVERCLOCK_SDRAM].max = 175;
          break;

        default:
          if (core_clock == 250) {               //pi 1
              features[F_OVERCLOCK_CPU].max = 100;
              features[F_OVERCLOCK_CORE].max = 100;
              features[F_OVERCLOCK_SDRAM].max = 175;
          } else {                               //pi zero
              features[F_OVERCLOCK_CPU].max = 75;
              features[F_OVERCLOCK_CORE].max = 175;
              features[F_OVERCLOCK_SDRAM].max = 175;
          }
          break;
      }
}

static void cycle_menu(menu_t *menu) {
   // count the number of items in the menu, excluding the back reference
   int nitems = 0;
   base_menu_item_t **mp = menu->items;
   while (*mp++) {
      nitems++;
   }
   nitems--;
   base_menu_item_t *first = *(menu->items);
   base_menu_item_t *last = *(menu->items + nitems);
   base_menu_item_t *back = (base_menu_item_t *)&back_ref;
   if (get_parameter(F_RETURN_POSITION)) {
      if (first == back) {
         for (int i = 0; i < nitems; i++) {
            *(menu->items + i) = *(menu->items + i + 1);
         }
         *(menu->items + nitems) = back;
      }
   } else {
      if (last == back) {
         for (int i = nitems; i > 0; i--) {
            *(menu->items + i) = *(menu->items + i - 1);
         }
         *(menu->items) = back;
      }
   }
}

static void cycle_menus() {
   cycle_menu(&main_menu);
   cycle_menu(&info_menu);
   cycle_menu(&preferences_menu);
   cycle_menu(&settings_menu);
}

int lumacode_multiplier() {
    switch (get_parameter(F_PALETTE_CONTROL)) {
        default:
            return 1;
            break;
        case PALETTECONTROL_ATARI_GTIA:
        case PALETTECONTROL_C64_LUMACODE:
            return 2;
            break;
        case PALETTECONTROL_ATARI_LUMACODE:
            return 3;
            break;
        case PALETTECONTROL_ATARI2600_LUMACODE:
            return 4;
            break;
    }

}

static void autoset_geometry() {
    geometry_set_value(H_ASPECT, 0);
    geometry_set_value(V_ASPECT, 0);

    geometry_set_value(SYNC_TYPE, capinfo->detected_sync_type & SYNC_BIT_MASK);

    if (get_parameter(F_AUTO_SWITCH) == AUTOSWITCH_MODE7 && geometry_get_value(SYNC_TYPE) < SYNC_COMP) {
        set_parameter(F_AUTO_SWITCH, AUTOSWITCH_OFF);
    }

    int fbsize_x2 = 0;
    if (geometry_get_value(MIN_H_WIDTH) <= 400 ) {
        fbsize_x2 |= SIZEX2_DOUBLE_WIDTH;
    }
    if (geometry_get_value(MIN_V_HEIGHT) <= 262 ) {
        fbsize_x2 |= SIZEX2_DOUBLE_HEIGHT;
    }

/*
    int min_h_width = geometry_get_value(MIN_H_WIDTH);
    int limit_h_width = (((geometry_get_value(LINE_LEN) * 92 / 100) + 4) >> 3) << 3;
    if (min_h_width > limit_h_width) {
        min_h_width = limit_h_width;
       geometry_set_value(MIN_H_WIDTH, min_h_width);
       set_parameter(F_H_WIDTH, min_h_width);
    }
*/

    int line_len_min = lumacode_multiplier() * geometry_get_value(MIN_H_WIDTH) * 109 / 100;
    int line_len_max = lumacode_multiplier() * geometry_get_value(MIN_H_WIDTH) * 176 / 100;
    if (geometry_get_value(LINE_LEN) < line_len_min || geometry_get_value(LINE_LEN) > line_len_max) {
        set_status_message("Line length invalid for pixel width");
    }


    if (geometry_get_value(MIN_V_HEIGHT) > get_lines_per_vsync(0)) {
       geometry_set_value(MIN_V_HEIGHT, (get_lines_per_vsync(0) >> 1) << 1);
       set_parameter(F_V_HEIGHT, (get_lines_per_vsync(0) >> 1) << 1);
    }

    geometry_set_value(FB_SIZEX2, fbsize_x2);
    geometry_set_value(LINES_FRAME, get_lines_per_vsync(0));

    int max_h_width = (((geometry_get_value(LINE_LEN) * 75 / 100 / lumacode_multiplier()) + 4) >> 3) << 3;
    if (max_h_width < geometry_get_value(MIN_H_WIDTH)) {
        max_h_width = geometry_get_value(MIN_H_WIDTH);
    }
    geometry_set_value(MAX_H_WIDTH, max_h_width);

    int max_v_height = (((geometry_get_value(LINES_FRAME) * 90 / 100) + 1) >> 1) << 1;
    if (max_v_height < geometry_get_value(MIN_V_HEIGHT)) {
        max_v_height = geometry_get_value(MIN_V_HEIGHT);
    }
    geometry_set_value(MAX_V_HEIGHT, max_v_height);

    int h_offset = ((((geometry_get_value(LINE_LEN) / lumacode_multiplier() - geometry_get_value(MIN_H_WIDTH)) / 2) + 2) >> 2) << 2;
    geometry_set_value(H_OFFSET, h_offset - get_parameter(F_H_OFFSET));

    int v_offset = ((((geometry_get_value(LINES_FRAME) - geometry_get_value(MIN_V_HEIGHT)) / 2) + 1) >> 1) << 1;
    geometry_set_value(V_OFFSET, v_offset - get_parameter(F_V_OFFSET));
}


static int get_feature(int num) {
    return get_parameter(num);
}

static void set_feature(int num, int value) {
   if (value < features[num].min) {
      value = features[num].min;
   }
   if (value > features[num].max) {
      value = features[num].max;
   }
   switch (num) {

   default:
      set_parameter(num, value);
      break;

   case F_H_OFFSET:
      set_parameter(num, value);
      autoset_geometry();
      break;

   case F_V_OFFSET:
      set_parameter(num, value);
      autoset_geometry() ;
      break;

   case F_H_WIDTH:
      int line_len = geometry_get_value(LINE_LEN);
      int line_len_min = lumacode_multiplier() * value * 110 / 100;
      int line_len_max = lumacode_multiplier() * value * 175 / 100;
      set_parameter(num, value);
      geometry_set_value(MIN_H_WIDTH, value);
      if (line_len < line_len_min) {
          set_feature(F_LINE_LEN, line_len_min);
      } else if (line_len > line_len_max) {
          set_feature(F_LINE_LEN, line_len_max);
      }
      autoset_geometry();
      break;

   case F_V_HEIGHT:
      set_parameter(num, value);
      geometry_set_value(MIN_V_HEIGHT, value);
      autoset_geometry() ;
      break;

   case F_CLOCK:
      value = value - (value % 1000);
      set_parameter(num, value);
      geometry_set_value(CLOCK, value);
      double one_clock_cycle_ns = 1000000000.0f / (double)value;
      int new_line_len = (int) (((double) get_one_line_time_ns() / one_clock_cycle_ns) + 0.5f);
      geometry_set_value(LINE_LEN, new_line_len);
      set_parameter(F_LINE_LEN, new_line_len);
      autoset_geometry();
      break;

   case F_LINE_LEN:
      set_parameter(num, value);
      geometry_set_value(LINE_LEN, value);
      int new_clock = (int) ((1000000000.0f/((double) get_one_line_time_ns() / value)) + 0.5f);
      geometry_set_value(CLOCK, new_clock);
      set_parameter(F_CLOCK, new_clock);
      autoset_geometry();
      break;

   case F_RESOLUTION:
      set_resolution(value, resolution_names[value], 1);
      break;
   case F_REFRESH:
      set_refresh(value, 1);
      break;
   case F_HDMI_AUTO:
      set_hdmi_auto(value, 1);
      break;
   case F_HDMI_MODE:
      set_hdmi_auto(0, 1);
      set_hdmi(value, 1);
      break;
   case F_SCALING:
      set_scaling(value, 1);
      break;
   case F_FRONTEND:
      set_frontend(value, 1);
      break;
   case F_OVERCLOCK_CPU:
      if ((disable_overclock & DISABLE_SETTINGS_OVERCLOCK) == DISABLE_SETTINGS_OVERCLOCK) {
          value = 0;
      }
      set_parameter(num, value);set_parameter(F_OVERCLOCK_CPU, value);
      if ((disable_overclock & DISABLE_PI1_PI2_OVERCLOCK) != DISABLE_PI1_PI2_OVERCLOCK && cpu_clock == 700) {
          set_clock_rate_cpu((cpu_clock + value + 200) * 1000000);    //overclock to 900
      } else {
          set_clock_rate_cpu((cpu_clock + value) * 1000000);
      }
      break;
   case F_OVERCLOCK_CORE:
      if ((disable_overclock & DISABLE_SETTINGS_OVERCLOCK) == DISABLE_SETTINGS_OVERCLOCK) {
          value = 0;
      }
      set_parameter(num, value);
#ifdef RPI4
      if (value > 100) {  //pi 4 core is already 500 Mhz (all others 400Mhz) so don't overclock unless overclock >100Mhz
          set_clock_rate_core((core_clock + value - 100) * 1000000);
      } else {
          set_clock_rate_core(core_clock * 1000000);
      }
#else
      if ((disable_overclock & DISABLE_PI1_PI2_OVERCLOCK) != DISABLE_PI1_PI2_OVERCLOCK && core_clock == 250) {
          set_clock_rate_core((core_clock + value + 150) * 1000000);
      } else {
          set_clock_rate_core((core_clock + value) * 1000000);
      }
#endif
      break;
   case F_OVERCLOCK_SDRAM:
      if ((disable_overclock & DISABLE_SETTINGS_OVERCLOCK) == DISABLE_SETTINGS_OVERCLOCK) {
          value = 0;
      }
      set_parameter(num, value);
      set_clock_rate_sdram((sdram_clock + value) * 1000000);
      break;
   case F_RETURN_POSITION:
      set_parameter(num, value);
      cycle_menus();
      break;
   case F_PROFILE:
      set_parameter(F_SAVED_CONFIG, 0);
      set_parameter(num, value);
      load_profiles(value, 1);
      process_profile(value);
      set_feature(F_SUB_PROFILE, 0);
      set_scaling(get_parameter(F_SCALING), 1);
      break;
   case F_SAVED_CONFIG:
      set_parameter(num, value);
      load_profiles(get_parameter(F_PROFILE), 1);
      process_profile(get_parameter(F_PROFILE));
      set_feature(F_SUB_PROFILE, 0);
      set_scaling(get_parameter(F_SCALING), 1);
      break;
   case F_SUB_PROFILE:
      set_parameter(num, value);
      process_sub_profile(get_parameter(F_PROFILE), value);
      break;
   case F_FONT_SIZE:
      if(active) {
         osd_clear();
         set_parameter(num, value);
         osd_refresh();
      } else {
         set_parameter(num, value);
      }
      break;
   case F_PALETTE_CONTROL:
      set_parameter(num, value);
      int hidden = (value < PALETTECONTROL_NTSCARTIFACT_CGA);
      features[F_NTSC_COLOUR].hidden = hidden;
      features[F_NTSC_PHASE].hidden = hidden;
      osd_update_palette();
      break;
   case F_NTSC_COLOUR:
   case F_OUTPUT_COLOUR:
   case F_OUTPUT_INVERT:
   case F_PAL_ODD_LEVEL:
   case F_PAL_ODD_LINE:
      set_parameter(num, value);
      osd_update_palette();
      break;
   case F_VSYNC_INDICATOR:
      set_parameter(num, value);
      features[F_GENLOCK_MODE].max = (value == 0) ? (NUM_HDMI - 5) : (NUM_HDMI - 1);
      break;
   case F_DEBUG:
      set_parameter(num, value);
      osd_update_palette();
      break;
   case F_AUTO_SWITCH:
      set_parameter(num, value);
      set_menu_table();
      osd_refresh();
      break;
   }
}

static void analyse_timing(int line) {
    set_parameter(F_H_OFFSET, 0);
    set_parameter(F_V_OFFSET, 0);
    geometry_set_value(VSYNC_TYPE, 0);
    geometry_set_value(VIDEO_TYPE, 0);
    set_feature(F_H_WIDTH, get_parameter(F_H_WIDTH));
    set_feature(F_LINE_LEN, get_parameter(F_LINE_LEN));
    line++;
    osd_set(line++, 0, "Geometry parameters have been set based on");
    osd_set(line++, 0, "current video source and menu settings.");
    osd_set(line++, 0, "H & V Offsets have been reset to 0.");
}

// Wrapper to extract the name of a menu item
static const char *item_name(base_menu_item_t *item) {
   switch (item->type) {
   case I_MENU:
   case I_CREATE:
      return ((child_menu_item_t *)item)->child->name;
   case I_FEATURE:
   case I_GEOMETRY:
   case I_UPDATE:
   case I_PARAM:
   case I_PICKPRO:
   case I_PICKMAN:
      return ((param_menu_item_t *)item)->param->label;
   case I_INFO:
   case I_TEST:
      return ((info_menu_item_t *)item)->name;
   case I_BACK:
      return ((back_menu_item_t *)item)->name;
   default:
      // Otherwise, default to a single action menu item type
      return ((action_menu_item_t *)item)->name;
   }
}

// Test if a parameter is a simple boolean
static int is_boolean_param(param_menu_item_t *param_item) {
   return param_item->param->min == 0 && param_item->param->max == 1;
}

// Test if a paramater is toggleable (i.e. just two valid values)
static int is_toggleable_param(param_menu_item_t *param_item) {
   return param_item->param->min + param_item->param->step == param_item->param->max;
}

// Set wrapper to abstract different between I_FEATURE, I_GEOMETRY and I_PARAM
static void set_param(param_menu_item_t *param_item, int value) {
   item_type_t type = param_item->type;
   if (type == I_FEATURE) {
      set_feature(param_item->param->key, value);
   } else if (type == I_GEOMETRY) {
      geometry_set_value(param_item->param->key, value);
   } else {
      cpld->set_value(param_item->param->key, value);
   }
}

// Get wrapper to abstract different between I_FEATURE, I_GEOMETRY and I_PARAM
static int get_param(param_menu_item_t *param_item) {
   item_type_t type = param_item->type;
   if (type == I_FEATURE) {
      return get_feature(param_item->param->key);
   } else if (type == I_GEOMETRY) {
      return geometry_get_value(param_item->param->key);
   } else {
      return cpld->get_value(param_item->param->key);
   }
}

// Toggle a parameter that only has two legal values (it's min and max)
static void toggle_param(param_menu_item_t *param_item) {
   if (get_param(param_item) == param_item->param->max) {
      set_param(param_item, param_item->param->min);
   } else {
      set_param(param_item, param_item->param->max);
   }
}

static const char *get_interface_name() {
    if (eight_bit_detected()) {
        if (mono_board_detected()) {
            return frontend_names_mono_luma[get_parameter(F_FRONTEND)];
        } else {
            return frontend_names_8[get_parameter(F_FRONTEND)];
        }
    } else {
    return frontend_names_6[get_parameter(F_FRONTEND)];
    }
}

static const char *get_param_string(param_menu_item_t *param_item) {
   static char number[16];
   item_type_t type = param_item->type;
   param_t   *param = param_item->param;
   // Read the current value of the specified feature
   int value = get_param(param_item);
   // Convert certain features to human readable strings
   if (type == I_FEATURE) {
      switch (param->key) {
      case F_PROFILE:
         return profile_names[value];
      case F_SAVED_CONFIG:
         return saved_config_names[value];
      case F_SUB_PROFILE:
         return sub_profile_names[value];
      case F_RESOLUTION:
         return resolution_names[value];
      case F_REFRESH:
         return refresh_names[value];
      case F_HDMI_AUTO:
         return hdmi_auto_names[value];
      case F_HDMI_MODE:
         return hdmi_names[value];
      case F_SCALING:
         return scaling_names[value];
      case F_FRONTEND:
         return get_interface_name();
      case F_CROP_BORDER:
         return overscan_names[value];
      case F_OUTPUT_COLOUR:
         return colour_names[value];
      case F_OUTPUT_INVERT:
         return invert_names[value];
      case F_FONT_SIZE:
         return fontsize_names[value];
      case F_PALETTE:
         return palette_names[value];
      case F_PALETTE_CONTROL:
         return palette_control_names[value];
      case F_AUTO_SWITCH:
         return autoswitch_names[value];
      case F_MODE7_DEINTERLACE:
      case F_NORMAL_DEINTERLACE:
         return deinterlace_names[value];
      case F_MODE7_SCALING:
         return even_scaling_names[value];
      case F_NORMAL_SCALING:
         return even_scaling_names[value];
      case F_SCREENCAP_SIZE:
         return screencap_names[value];
      case F_GENLOCK_MODE:
         return genlock_mode_names[value];
      case F_GENLOCK_SPEED:
         return genlock_speed_names[value];
      case F_GENLOCK_ADJUST:
         return genlock_adjust_names[value];
#ifdef MULTI_BUFFER
      case F_NUM_BUFFERS:
         return nbuffer_names[value];
#endif
      case F_RETURN_POSITION:
         return return_names[value];
      case F_NTSC_PHASE:
         return phase_names[value];
      case F_NTSC_TYPE:
         return ntsctype_names[value];
      case F_NTSC_QUALITY:
         return fringe_names[value];
      case F_PAL_ODD_LINE:
         return pal_odd_names[value];
      case F_TIMING_SET:
         return alt_profile_names[value];
      case F_INTEGER_ASPECT:
         return integer_names[value];
      }
   } else if (type == I_GEOMETRY) {
      const char *value_str = geometry_get_value_string(param->key);
      if (value_str) {
         return value_str;
      }
   } else {
      const char *value_str = cpld->get_value_string(param->key);
      if (value_str) {
         return value_str;
      }
   }
   if (is_boolean_param(param_item)) {
      return value ? "On" : "Off";
   }
   sprintf(number, "%d", value);
   return number;
}

static volatile uint32_t *gpioreg;

void osd_display_interface(int line) {
    gpioreg = (volatile uint32_t *)(_get_peripheral_base() + 0x101000UL);
    char osdline[256];
    sprintf(osdline, "Interface: %s", get_interface_name());
    osd_set(line++, 0, osdline);
    sprintf(osdline, "Scaling: %s", scaling_names[get_parameter(F_SCALING)]);
    osd_set(line++, 0, osdline);
    char profile_name[MAX_PROFILE_WIDTH];
    char *position = strchr(profile_names[get_parameter(F_PROFILE)], '/');
    if (position) {
       strcpy(profile_name, position + 1);
    } else {
       strcpy(profile_name, profile_names[get_parameter(F_PROFILE)] + cpld_prefix_length);
    }
    sprintf(osdline, "Profile: %s", profile_name);
    for (int j=0; j < strlen(osdline); j++) {
        if (*(osdline+j) == '_') {
           *(osdline+j) = ' ';
        }
    }
    osd_set(line++, 0, osdline);
    if (has_sub_profiles[get_parameter(F_PROFILE)]) {
        sprintf(osdline, "Sub-Profile: %s", sub_profile_names[get_parameter(F_SUB_PROFILE)]);
        for (int j=0; j < strlen(osdline); j++) {
            if (*(osdline+j) == '_') {
               *(osdline+j) = ' ';
            }
        }
        osd_set(line++, 0, osdline);
    }
#ifdef USE_ARM_CAPTURE
    osd_set(line++, 0, "Warning: ARM Capture Version");
#else
    osd_set(line++, 0, "GPU Capture Version");
#endif
    line++;
    if (get_parameter(F_FRONTEND) != FRONTEND_SIMPLE) {
        osd_set(line++, 0, "Use Auto Calibrate Video Sampling or");
        osd_set(line++, 0, "adjust sampling phase to fix noise");
    }
    line++;
    if (core_clock == 250) { // either a Pi 1 or Pi 2 which can be auto overclocked
        if (disable_overclock) {
            osd_set(line++, 0, "Set disable_overclock=0 in config.txt");
            osd_set(line++, 0, "to enable 9BPP & 12BPP on Pi 1 or Pi 2");
        } else {
            osd_set(line++, 0, "Set disable_overclock=1 in config.txt");
            osd_set(line++, 0, "if you have lockups on Pi 1 or Pi 2");
        }
    }

}

static void info_system_summary(int line) {
   gpioreg = (volatile uint32_t *)(_get_peripheral_base() + 0x101000UL);
   sprintf(message, " Kernel Version: %s", GITVERSION);
   osd_set(line++, 0, message);
   sprintf(message, "   CPLD Version: %s v%x.%x",
           cpld->name,
           (cpld->get_version() >> VERSION_MAJOR_BIT) & 0xF,
           (cpld->get_version() >> VERSION_MINOR_BIT) & 0xF);
   osd_set(line++, 0, message);
   sprintf(message, "      Interface: %s", get_interface_name());
   osd_set(line++, 0, message);

   switch (_get_hardware_id()) {
       case 1:
            if (core_clock == 250) {
               sprintf(message, "      Processor: Pi 1");
            } else {
               sprintf(message, "      Processor: Pi Zero");
            }
            break;
       case 2:
            sprintf(message, "      Processor: Pi 2");
            break;
       case 3:
            sprintf(message, "      Processor: Pi Zero 2 or Pi 3");
            break;
       case 4:
            sprintf(message, "      Processor: Pi 4");
            break;
       default:
            sprintf(message, "      Unknown");
            break;
   }
   osd_set(line++, 0, message);
#ifdef USE_ARM_CAPTURE
   sprintf(message, "          Build: ARM Capture");
#else
   sprintf(message, "          Build: GPU Capture");
#endif
     osd_set(line++, 0, message);
   int ANA1_PREDIV;
#ifdef RPI4
   ANA1_PREDIV = 0;
#else
   ANA1_PREDIV = (gpioreg[PLLA_ANA1] >> 14) & 1;
#endif
   int NDIV = (gpioreg[PLLA_CTRL] & 0x3ff) << ANA1_PREDIV;
   int FRAC = gpioreg[PLLA_FRAC] << ANA1_PREDIV;
   int clockA = (double) (CRYSTAL * ((double)NDIV + ((double)FRAC) / ((double)(1 << 20))) + 0.5);
#ifdef RPI4
   ANA1_PREDIV = 0;
#else
   ANA1_PREDIV = (gpioreg[PLLB_ANA1] >> 14) & 1;
#endif
   NDIV = (gpioreg[PLLB_CTRL] & 0x3ff) << ANA1_PREDIV;
   FRAC = gpioreg[PLLB_FRAC] << ANA1_PREDIV;
   int clockB = (double) (CRYSTAL * ((double)NDIV + ((double)FRAC) / ((double)(1 << 20))) + 0.5);
#ifdef RPI4
   ANA1_PREDIV = 0;
#else
   ANA1_PREDIV = (gpioreg[PLLC_ANA1] >> 14) & 1;
#endif
   NDIV = (gpioreg[PLLC_CTRL] & 0x3ff) << ANA1_PREDIV;
   FRAC = gpioreg[PLLC_FRAC] << ANA1_PREDIV;
   int clockC = (double) (CRYSTAL * ((double)NDIV + ((double)FRAC) / ((double)(1 << 20))) + 0.5);
#ifdef RPI4
   ANA1_PREDIV = 0;
#else
   ANA1_PREDIV = (gpioreg[PLLD_ANA1] >> 14) & 1;
#endif
   NDIV = (gpioreg[PLLD_CTRL] & 0x3ff) << ANA1_PREDIV;
   FRAC = gpioreg[PLLD_FRAC] << ANA1_PREDIV;
   int clockD = (double) (CRYSTAL * ((double)NDIV + ((double)FRAC) / ((double)(1 << 20))) + 0.5);
   sprintf(message, "           PLLA: %4d Mhz", clockA);
   osd_set(line++, 0, message);
   sprintf(message, "           PLLB: %4d Mhz", clockB);
   osd_set(line++, 0, message);
   sprintf(message, "           PLLC: %4d Mhz", clockC);
   osd_set(line++, 0, message);
   sprintf(message, "           PLLD: %4d Mhz", clockD);
   osd_set(line++, 0, message);
   sprintf(message, "      CPU Clock: %4d Mhz", get_clock_rate(ARM_CLK_ID)/1000000);
   osd_set(line++, 0, message);
   sprintf(message, "     CORE Clock: %4d Mhz", get_clock_rate(CORE_CLK_ID)/1000000);
   osd_set(line++, 0, message);
   sprintf(message, "    SDRAM Clock: %4d Mhz", get_clock_rate(SDRAM_CLK_ID)/1000000);
   osd_set(line++, 0, message);
   sprintf(message, "      Core Temp: %6.2f C", get_temp());
   osd_set(line++, 0, message);
   sprintf(message, "   Core Voltage: %6.2f V", get_voltage(COMPONENT_CORE));
   osd_set(line++, 0, message);
   sprintf(message, "SDRAM_C Voltage: %6.2f V", get_voltage(COMPONENT_SDRAM_C));
   osd_set(line++, 0, message);
   sprintf(message, "SDRAM_P Voltage: %6.2f V", get_voltage(COMPONENT_SDRAM_P));
   osd_set(line++, 0, message);
   sprintf(message, "SDRAM_I Voltage: %6.2f V", get_voltage(COMPONENT_SDRAM_I));
   osd_set(line++, 0, message);
}

static void info_help_quickstart(int line) {
   osd_set(line++, 0, "Connect your computer as indicated in");
   osd_set(line++, 0, "the project wiki.");
   osd_set(line++, 0, "");
   osd_set(line++, 0, "Use the Select Profile Menu to select");
   osd_set(line++, 0, "the correct profile for your computer.");
   osd_set(line++, 0, "");
   osd_set(line++, 0, "Select 'Auto Calibrate Video Sampling' to");
   osd_set(line++, 0, "set the optimal sampling phase for your");
   osd_set(line++, 0, "computer. Either select the menu option");
   osd_set(line++, 0, "or use a long press of SW3 (Up).");
   osd_set(line++, 0, "Press SW1 (Menu) when complete to save the");
   osd_set(line++, 0, "new calibration value.");
   osd_set(line++, 0, "");
   osd_set(line++, 0, "If your computer uses 50Hz video refresh,");
   osd_set(line++, 0, "select the 'Test Monitor for 50Hz Support'");
   osd_set(line++, 0, "option and follow the on screen help.");
   osd_set(line++, 0, "");
   osd_set(line++, 0, "Most settings should be set to sensible");
   osd_set(line++, 0, "defaults but you can customise them as");
   osd_set(line++, 0, "required then use 'Save Configuration' to");
   osd_set(line++, 0, "save those changes.");
}

static void info_help_buttons(int line) {
   osd_set(line++, 0, "SW1 short press: Menu on");
   osd_set(line++, 0, "SW1 long press: Scan lines on/off");
   osd_set(line++, 0, "SW1 in menu: select option");
   osd_set(line++, 0, "");
   osd_set(line++, 0, "SW2 short press: Screencap");
   osd_set(line++, 0, "SW2 long press: NTSC/PAL artifacts on/off");
   osd_set(line++, 0, "SW2 in menu: cursor down / increase value");
   osd_set(line++, 0, "");
   osd_set(line++, 0, "SW3 short press depends on setting:");
   osd_set(line++, 0, "Normally: Enable/test genlock");
   osd_set(line++, 0, "When NTSC artifacts on: Select Phase");
   osd_set(line++, 0, "When manual autoswitch: Toggle Set 1/2");
   osd_set(line++, 0, "SW3 long press: Auto calibrate sampling");
   osd_set(line++, 0, "SW3 in menu: cursor up / decrease value");
   osd_set(line++, 0, "");
   osd_set(line++, 0, "Press SW2 + SW3 to screencap in menu");
   osd_set(line++, 0, "Press SW1 + SW3 for soft reset");
   osd_set(line++, 0, "(Useful if Pi not modified for reset)");
   osd_set(line++, 0, "");
   osd_set(line++, 0, "During reset:");
   osd_set(line++, 0, "Hold SW1 for default resolution");
   osd_set(line++, 0, "Hold SW1 + SW2 + SW3 for CPLD menu");
}

static void info_help_calibration(int line) {
   osd_set(line++, 0, "To ensure a noise free image, the sampling");
   osd_set(line++, 0, "phase must be set for your particular");
   osd_set(line++, 0, "hardware. This generally only needs to be");
   osd_set(line++, 0, "done once on each machine with the setting");
   osd_set(line++, 0, "then saved to the SD card.");
   osd_set(line++, 0, "");
   osd_set(line++, 0, "To calibrate, display a still image with");
   osd_set(line++, 0, "lots of detail such as many lines of text");
   osd_set(line++, 0, "or detailed graphics. Then either hold SW3");
   osd_set(line++, 0, "until calibration starts or select the");
   osd_set(line++, 0, "option in the main menu.");
   osd_set(line++, 0, "After calibration, press SW1 to save.");
   osd_set(line++, 0, "You can also manually adjust the phase in");
   osd_set(line++, 0, "the sampling menu.");
   osd_set(line++, 0, "");
   osd_set(line++, 0, "If you are using the same profile with");
   osd_set(line++, 0, "several computers of the same type you may");
   osd_set(line++, 0, "have to re-run the calibration when");
   osd_set(line++, 0, "changing between them as they could be");
   osd_set(line++, 0, "different hardware revisions.");
   osd_set(line++, 0, "Alternatively use 'Saved Config' to");
   osd_set(line++, 0, "store multiple different configurations.");
}

static void info_help_flashing(int line) {
   osd_set(line++, 0, "The screen flashing continuously means");
   osd_set(line++, 0, "either the capture size is too big or");
   osd_set(line++, 0, "the timing of the video source doesn't");
   osd_set(line++, 0, "match any of the profiles in the currently");
   osd_set(line++, 0, "selected autoswitch sub-profile set.");
   osd_set(line++, 0, "");
   osd_set(line++, 0, "Try reducing the min/max sizes and offsets");
   osd_set(line++, 0, "in the geometry menu. For timing problems,");
   osd_set(line++, 0, "a match is determined by the following:");
   osd_set(line++, 0, "1 'Lines per Frame' matches detected");
   osd_set(line++, 0, "2 'Sync Type' matches detected");
   osd_set(line++, 0, "3 PPM error < Clock Tolerance (close to 0)");
   osd_set(line++, 0, "The PPM error is determined by the 'Line");
   osd_set(line++, 0, "Length' and 'Clock Frequency' settings.");
   osd_set(line++, 0, "Adjusting the above will display detected");
   osd_set(line++, 0, "info at the top of the screen and the");
   osd_set(line++, 0, "settings should be adjusted to match.");
   osd_set(line++, 0, "");
   osd_set(line++, 0, "The 'Create Custom Profile' menu can help");
   osd_set(line++, 0, "with changing the above settings on a");
   osd_set(line++, 0, "profile without creating a new one.");
}

static void info_help_noise(int line) {
   osd_set(line++, 0, "When set up correctly the output should");
   osd_set(line++, 0, "be noise free. If you are getting noise");
   osd_set(line++, 0, "try adjusting the following:");
   osd_set(line++, 0, "");
   osd_set(line++, 0, "1. Calibration (See 'Help Calibration')");
   osd_set(line++, 0, "2. If using the analog interface try");
   osd_set(line++, 0, "adjusting the DAC levels in the sampling");
   osd_set(line++, 0, "menu.");
   osd_set(line++, 0, "3. If you are getting alternating vertical");
   osd_set(line++, 0, "columns of noisy and clean pixels across");
   osd_set(line++, 0, "the screen, that means the 'Line Length'");
   osd_set(line++, 0, "(in geometry) is set incorrectly so try");
   osd_set(line++, 0, "adjusting that. A test pattern of vertical");
   osd_set(line++, 0, "lines of black and white pixels is the");
   osd_set(line++, 0, "best option for adjusting that but an");
   osd_set(line++, 0, "alternative is to fill the screen with the");
   osd_set(line++, 0, "letter 'M' or 'W'");
   osd_set(line++, 0, "Use 'Save Configuration' after adjusting");
   osd_set(line++, 0, "(See also 'Help Flashing Screen' & wiki)");
}

static void info_help_artifacts(int line) {
   osd_set(line++, 0, "Apple II, IBM CGA and Tandy CoCo use NTSC");
   osd_set(line++, 0, "artifacts to produce colours.");
   osd_set(line++, 0, "To toggle NTSC artifact emulation on/off");
   osd_set(line++, 0, "use a long press of SW2 or menu option.");
   osd_set(line++, 0, "When NTSC artifacts are on, use a short");
   osd_set(line++, 0, "press of SW3 or menu option to change the");
   osd_set(line++, 0, "artifact phase (There are four possible");
   osd_set(line++, 0, "settings which produce different colours).");
   osd_set(line++, 0, "");
   osd_set(line++, 0, "On the Apple II and Tandy CoCo artifacts");
   osd_set(line++, 0, "will be enabled and disabled automatically");
   osd_set(line++, 0, "but you can override with the above.");
   osd_set(line++, 0, "If Apple II artifacts do not switch");
   osd_set(line++, 0, "automatically, try adjusting the Y lo DAC");
   osd_set(line++, 0, "setting (colour burst detect level).");
   osd_set(line++, 0, "For single core Pi models (e.g. zero) only");
   osd_set(line++, 0, "CGA mono mode is supported for artifacts.");
   osd_set(line++, 0, "Full CGA artifact emulation for the four");
   osd_set(line++, 0, "colour modes and the >1K colours produced");
   osd_set(line++, 0, "by the 8088mph demo requires a multicore");
   osd_set(line++, 0, "Pi model (Zero2W, 3 or 4).");
   osd_set(line++, 0, "This may change in a future update.");
}

static void info_help_updates(int line) {
   osd_set(line++, 0, "Latest stable software is available here:");
   osd_set(line++, 0, "https://github.com/hoglet67/RGBtoHDMI");
   osd_set(line++, 0, "/releases");
   osd_set(line++, 0, "");
   osd_set(line++, 0, "Latest beta software with new features and");
   osd_set(line++, 0, "bug fixes is available here:");
   osd_set(line++, 0, "https://github.com/IanSB/RGBtoHDMI");
   osd_set(line++, 0, "/releases");
   osd_set(line++, 0, "");
   osd_set(line++, 0, "Documentation is available here:");
   osd_set(line++, 0, "https://github.com/hoglet67/RGBtoHDMI/wiki");
   osd_set(line++, 0, "or here:");
   osd_set(line++, 0, "https://github.com/IanSB/RGBtoHDMI/wiki");
   osd_set(line++, 0, "");
   osd_set(line++, 0, "Development / support thread:");
   osd_set(line++, 0, "https://stardot.org.uk/forums/");
   osd_set(line++, 0, "viewtopic.php?f=3&t=14430");
   osd_set(line++, 0, "Help is also available via the issues tab");
   osd_set(line++, 0, "on the above github pages");
}

static void info_help_custom_profile(int line) {
   osd_set(line++, 0, "Either select one of the Base Profiles or");
   osd_set(line++, 0, "a profile that is similar to the source.");
   osd_set(line++, 0, "Fill the source screen with alternating");
   osd_set(line++, 0, "vertical black and white lines or the");
   osd_set(line++, 0, "letter 'M' or 'W' or similar detail.");
   osd_set(line++, 0, "Select 'Create Custom Profile' and press");
   osd_set(line++, 0, "again to analyse sync if requested.");
   osd_set(line++, 0, "Select Analyse Timing on first entry.");
   osd_set(line++, 0, "Set the source H & V pixel resolution.");
   osd_set(line++, 0, "Either set the pixel clock frequency or");
   osd_set(line++, 0, "Line Length (in clock cycles) if known.");
   osd_set(line++, 0, "If not known, adjust the line length until");
   osd_set(line++, 0, "all columns of noise have disappeared");
   osd_set(line++, 0, "or noise appears across the width of the");
   osd_set(line++, 0, "screen. (Confirm that such noise cleans");
   osd_set(line++, 0, "up when selecting Auto Calibration)");
   osd_set(line++, 0, "Use H and V Offset to centre the image.");
   osd_set(line++, 0, "Make changes in other menus if required.");
   osd_set(line++, 0, "Run a final Auto Calibration.");
   osd_set(line++, 0, "Set custom profile number (0-9).");
   osd_set(line++, 0, "Select Save Custom Profile and reboot.");
}

static void info_help_custom_hints(int line) {
   osd_set(line++, 0, "When selecting Create Profile you will get");
   osd_set(line++, 0, "an error if sync not detected so re-select");
   osd_set(line++, 0, "to try to auto detect the sync type.");
   osd_set(line++, 0, "If the source is analog, the sampling menu");
   osd_set(line++, 0, "DAC levels have to be adjusted first to");
   osd_set(line++, 0, "ensure that sync and video are detected.");
   osd_set(line++, 0, "When adjusting the Pixel Width, the Line");
   osd_set(line++, 0, "Length will be clipped to be between 110%");
   osd_set(line++, 0, "and 175% of that value. When changing the");
   osd_set(line++, 0, "Line Length a warning is displayed if the");
   osd_set(line++, 0, "value goes outside that sensible range.");
   osd_set(line++, 0, "When adjusting the Clock, the Line Length");
   osd_set(line++, 0, "will be altered to match the current");
   osd_set(line++, 0, "timing and vice-versa and either value");
   osd_set(line++, 0, "should be adjusted until there are no");
   osd_set(line++, 0, "columns of noise. When getting close to");
   osd_set(line++, 0, "the correct value the columns will reduce");
   osd_set(line++, 0, "in number and be more widely spaced.");
   osd_set(line++, 0, "If the sample phase is not set correctly");
   osd_set(line++, 0, "then the correct line length may result in");
   osd_set(line++, 0, "all pixels being noisy instead of clean.");
}

static void info_credits(int line) {
   osd_set(line++, 0, "Many thanks to our main developers:");
   osd_set(line++, 0, "- David Banks (hoglet) - Original Dev.");
   osd_set(line++, 0, "- Ian Bradbury (IanB) - Current Dev.");
   osd_set(line++, 0, "- Dominic Plunkett (dp11)");
   osd_set(line++, 0, "- Ed Spittles (BigEd)");
   osd_set(line++, 0, "");
   osd_set(line++, 0, "Thanks also to the members of stardot");
   osd_set(line++, 0, "who have provided encouragement, ideas");
   osd_set(line++, 0, "and helped with beta testing.");
   osd_set(line++, 0, "https://stardot.org.uk/forums/");
   osd_set(line++, 0, "viewtopic.php?f=3&t=14430");
}

static void clean_space(char *string) {
int string_length = strlen(string);
    for (int i = 0; i < string_length; i++) {
        if (string[i] == '_' && (string[i + 1] == '_' || string[i + 1] == '/' || string[i + 1] == '\r')) {
            for (int j = i + 1; j < string_length; j++) {
                string[j - 1] = string[j];
            }
        }
        if (string[i] == '_') {
            string[i] = ' ';
        }
    }
}

static void info_save_list(int line) {
char buffer[1024 * 1024];
unsigned int ptr = 0;
    if (mono_board_detected()) {
        ptr += sprintf(buffer, "Profile list for Mono / LumaCode Interface\r\n");
    } else {
        if (any_DAC_detected()) {
        ptr += sprintf(buffer, "Profile list for Analog Interface\r\n");
        } else {
        ptr += sprintf(buffer, "Profile list for Digital Interface\r\n");
        }
    }
    for (int i = 0; i < full_profile_count; i++) {
       ptr += sprintf(buffer + ptr, "%s\r\n", profile_names[i]);
    }
    clean_space(buffer);
    file_save_bin("/Profile_List.txt", buffer, ptr);
    osd_set(line++, 0, "List of profiles for supported computers");
    osd_set(line++, 0, "using current hardware interface saved to");
    osd_set(line++, 0, "SD card as: 'Profile_List.txt'");
}

static void info_save_log(int line) {
   log_save("/Log.txt");
   file_save_bin("/EDID.bin", EDID_buf, EDID_bufptr);
   osd_set(line++, 0, "Log.txt and EDID.bin saved to SD card");
}

static void info_test_50hz(int line) {
static char osdline[256];
static int old_50hz_state = 0;
int current_50hz_state = get_50hz_state();
int apparent_width = get_hdisplay();
int apparent_height = get_vdisplay();
   if (old_50hz_state == 1 && current_50hz_state == 0) {
      current_50hz_state = 1;
   }
   old_50hz_state = current_50hz_state;
   sprintf(osdline, "Current resolution = %d x %d", apparent_width, apparent_height);
   osd_set(line++, 0, osdline);
   if (get_parameter(F_GENLOCK_MODE) == HDMI_EXACT) {
       switch(current_50hz_state) {
          case 0:
               osd_set(line++, 0, "50Hz support is already enabled");
               osd_set(line++, 0, "");
               osd_set(line++, 0, "If menu text is unstable, change the");
               osd_set(line++, 0, "Refresh menu option to 60Hz to");
               osd_set(line++, 0, "permanently disable 50Hz support.");
               break;
          case 1:
               set_force_genlock_range(GENLOCK_RANGE_FORCE_LOW);
               set_status_message(" ");
               osd_set(line++, 0, "50Hz support enabled until reset");
               osd_set(line++, 0, "");
               osd_set(line++, 0, "If you can see this message, change the");
               osd_set(line++, 0, "Refresh menu option to Force 50Hz-60Hz");
               osd_set(line++, 0, "to permanently enable 50Hz support.");
               break;
          default:
               osd_set(line++, 0, "Unable to test: Source is not 50hz");
               break;
       }
   } else {
        osd_set(line++, 0, "Unable to test: Genlock disabled");
   }
   osd_set(line++, 0, "");
   osd_set(line++, 0, "If the current resolution doesn't match");
   osd_set(line++, 0, "the physical resolution of your lcd panel,");
   osd_set(line++, 0, "change the Resolution menu option to");
   osd_set(line++, 0, "the correct resolution.");
}

static void info_reboot(int line) {
   reboot();
}

static void info_source_summary(int line) {
   line = show_detected_status(line);
}

static void info_cal_summary(int line) {
   if (cpld->show_cal_summary) {
      line = cpld->show_cal_summary(line);
   } else {
      sprintf(message, "show_cal_summary() not implemented");
      osd_set(line++, 0, message);
   }
}


static void info_cal_detail(int line) {
   if (cpld->show_cal_details) {
      cpld->show_cal_details(line);
   } else {
      sprintf(message, "show_cal_details() not implemented");
      osd_set(line, 0, message);
   }
}

static void info_cal_raw(int line) {
   if (cpld->show_cal_raw) {
      cpld->show_cal_raw(line);
   } else {
      sprintf(message, "show_cal_raw() not implemented");
      osd_set(line, 0, message);
   }
}

static void rebuild_menu(menu_t *menu, item_type_t type, param_t *param_ptr) {
   int i = 0;
   if (!get_parameter(F_RETURN_POSITION)) {
      menu->items[i++] = (base_menu_item_t *)&back_ref;
   }
   while (param_ptr->key >= 0) {
      if (!param_ptr->hidden) {
         dynamic_item[i].type = type;
         dynamic_item[i].param = param_ptr;
         menu->items[i] = (base_menu_item_t *)&dynamic_item[i];
         i++;
      }
      param_ptr++;
   }
   if (get_parameter(F_RETURN_POSITION)) {
      menu->items[i++] = (base_menu_item_t *)&back_ref;
   }
   // Add a terminator, in case the menu has had items removed
   menu->items[i++] = NULL;
}

static void rebuild_geometry_menu(menu_t *menu) {
   rebuild_menu(menu, I_GEOMETRY, geometry_get_params());
}

static void rebuild_sampling_menu(menu_t *menu) {
   rebuild_menu(menu, I_PARAM, cpld->get_params());
}

static char cpld_filenames[MAX_CPLD_FILENAMES][MAX_FILENAME_WIDTH];

static param_t cpld_filename_params[MAX_CPLD_FILENAMES];
static param_t manufacturer_params[MAX_PROFILES];
static param_t profile_params[MAX_PROFILES];

static void rebuild_update_cpld_menu(menu_t *menu) {
   int i;
   int count;
   char cpld_dir[MAX_STRING_SIZE];
   strncpy(cpld_dir, cpld_firmware_dir, MAX_STRING_LIMIT);
   if (get_parameter(F_DEBUG)) {
       int cpld_design = cpld->get_version() >> VERSION_DESIGN_BIT;
       switch(cpld_design) {
           case DESIGN_ATOM:
                  strncat(cpld_dir, "/ATOM_old", MAX_STRING_LIMIT);
                  break;
           case DESIGN_YUV_TTL:
           case DESIGN_YUV_ANALOG:
                  strncat(cpld_dir, "/YUV_old", MAX_STRING_LIMIT);
                  break;
           case DESIGN_RGB_TTL:
           case DESIGN_RGB_ANALOG:
                  strncat(cpld_dir, "/RGB_old", MAX_STRING_LIMIT);
                  break;
           default:
           case DESIGN_BBC:
                  strncat(cpld_dir, "/BBC_old", MAX_STRING_LIMIT);
                  break;
       }
       log_info("FOLDER %d %s", cpld_design, cpld_dir);
   }
   scan_cpld_filenames(cpld_filenames, cpld_dir, &count);
   for (i = 0; i < count; i++) {
      cpld_filename_params[i].key = i;
      cpld_filename_params[i].label = cpld_filenames[i];
   }
   cpld_filename_params[i].key = -1;
   rebuild_menu(menu, I_UPDATE, cpld_filename_params);
}

static void rebuild_manufacturer_menu(menu_t *menu) {
   int i;
   for (i = 0; i < manufacturer_count; i++) {
      manufacturer_params[i].key = i;
      manufacturer_params[i].label = manufacturer_names[i];
   }
   manufacturer_params[i].key = -1;
   rebuild_menu(menu, I_PICKMAN, manufacturer_params);
}

static void rebuild_profile_menu(menu_t *menu) {
   int i;
   int j = 0;
   if (strcmp(selected_manufacturer, FAVOURITES_MENU) == 0) {
       for (i = 0; i < (favourites_count + 1); i++) {
              profile_params[j].key = i;
              profile_params[j].label = favourite_names[i];
              j++;
       }
   } else {
       for (i = 0; i <= features[F_PROFILE].max; i++) {
          if (strncmp(selected_manufacturer, profile_names[i] + cpld_prefix_length, strlen(selected_manufacturer)) == 0) {
              log_info("Found: %s", profile_names[i]);
              profile_params[j].key = i;
              profile_params[j].label = profile_names[i];
              j++;
          }
       }
       if (full_profile_count > (features[F_PROFILE].max + 1)) {
           for (i = features[F_PROFILE].max + 1; i < full_profile_count; i++) {
              if (strncmp(selected_manufacturer, profile_names[i] + cpld_prefix_length, strlen(selected_manufacturer)) == 0) {
                  log_info("Found other CPLD: %s", profile_names[i]);
                  profile_params[j].key = i;
                  profile_params[j].label = profile_names[i];
                  j++;
              }
           }
       }
   }

   profile_params[j].key = -1;
   rebuild_menu(menu, I_PICKPRO, profile_params);
}

static void redraw_menu() {
   menu_t *menu = current_menu[depth];
   int current = current_item[depth];
   int line = 0;
   base_menu_item_t **item_ptr;
   base_menu_item_t *item;
   if (osd_state == INFO) {
      item = menu->items[current];
      // We should always be on an INFO item...
      if (item->type == I_INFO || item->type == I_TEST) {
         info_menu_item_t *info_item = (info_menu_item_t *)item;
         osd_set_noupdate(line, ATTR_DOUBLE_SIZE, info_item->name);
         line += 2;
         info_item->show_info(line);
      }
   } else if (osd_state == MENU || osd_state == PARAM)  {
      osd_set_noupdate(line, ATTR_DOUBLE_SIZE, menu->name);
      line += 2;
      // Work out the longest item name
      int max = 0;
      item_ptr = menu->items;
      while ((item = *item_ptr++)) {
         int len = strlen(item_name(item));
         if (((item)->type == I_FEATURE || (item)->type == I_GEOMETRY || (item)->type == I_PARAM || (item)->type == I_UPDATE) && (len > max)){
            max = len;
         }
      }
      item_ptr = menu->items;
      int i = 0;
      while ((item = *item_ptr++)) {
         char *mp         = message;
         char sel_none    = ' ';
         char sel_open    = (i == current) ? '>' : sel_none;
         char sel_close   = (i == current) ? '<' : sel_none;
         char *name = (char*) item_name(item);
         *mp++ = (osd_state != PARAM) ? sel_open : sel_none;
         if ((item)->type == I_PICKMAN) {
             if (name[0] == '_') {
                strcpy(mp, name + 1);
             } else {
                strcpy(mp, name);
             }
             if (mp[strlen(mp) - 1] == '_') {
                mp[strlen(mp) - 1] = 0;
             }
             for (int j=0; j < strlen(mp); j++) {
                if (*(mp+j) == '_') {
                   *(mp+j) = ' ';
                }
             }
         } else if ((item)->type == I_PICKPRO) {
             char *index = strchr(name, '/');
             int offset = 0;
             if (index) {
                index++;

                if (strncmp(name, current_cpld_prefix, cpld_prefix_length) != 0) {
                    if (strncmp(name, BBC_cpld_prefix, cpld_prefix_length) == 0) {
                        strcpy(mp, BBC_cpld_prefix);
                        offset = cpld_prefix_length;
                    }
                    if (strncmp(name, RGB_cpld_prefix, cpld_prefix_length) == 0) {
                        strcpy(mp, RGB_cpld_prefix);
                        offset = cpld_prefix_length;
                    }
                    if (strncmp(name, YUV_cpld_prefix, cpld_prefix_length) == 0) {
                        strcpy(mp, YUV_cpld_prefix);
                        offset = cpld_prefix_length;
                    }
                }
             } else {
                 index = name;
             }
             if (index[0] == '_') {
                 strcpy(mp + offset, index + 1);
             } else {
                 strcpy(mp + offset, index);
             }

             if (mp[strlen(mp) - 1] == '_') {
                mp[strlen(mp) - 1] = 0;
             }
             for (int j=0; j < strlen(mp); j++) {
                if (*(mp+j) == '_') {
                   *(mp+j) = ' ';
                }
             }
         } else {
             strcpy(mp, name);
         }

         mp += strlen(mp);
         if ((item)->type == I_FEATURE || (item)->type == I_GEOMETRY || (item)->type == I_PARAM) {
            int len = strlen(name);
            while (len < max) {
               *mp++ = ' ';
               len++;
            }
            *mp++ = ' ';
            *mp++ = '=';
            *mp++ = (osd_state == PARAM) ? sel_open : sel_none;
            if ((item)->type == I_FEATURE && ((param_menu_item_t *)item)->param->key == F_PROFILE) {
                char *index = strchr(get_param_string((param_menu_item_t *)item), '/');
                if (index) {
                    index++;
                } else {
                    index = (char*) get_param_string((param_menu_item_t *)item);
                }
                if (index[0] == '_') {
                    strcpy(mp, index + 1);
                } else {
                    strcpy(mp, index);
                }
            } else {
                strcpy(mp, get_param_string((param_menu_item_t *)item));
            }
            int param_len = strlen(mp);
            if (mp[param_len - 1] == '_') {
                mp[param_len - 1] = 0;
                param_len--;
            }
            for (int j=0; j < param_len; j++) {
               if (*mp == '_') {
                  *mp = ' ';
               }
               mp++;
            }
         }


         *mp++ = sel_close;
         *mp++ = '\0';
         osd_set_noupdate(line++, 0, message);
         i++;
      }
   }
   if (capinfo->bpp != 16) {
       osd_update((uint32_t *) (capinfo->fb + capinfo->pitch * capinfo->height * get_current_display_buffer() + capinfo->pitch * capinfo->v_adjust + capinfo->h_adjust), capinfo->pitch, 1);
   }
}

static int get_key_down_duration(int key) {
   switch (key) {
   case OSD_SW1:
      return sw1counter;
   case OSD_SW2:
      return sw2counter;
   case OSD_SW3:
      return sw3counter;
   }
   return 0;
}

static void set_key_down_duration(int key, int value) {
   switch (key) {
   case OSD_SW1:
      sw1counter = value;
      break;
   case OSD_SW2:
      sw2counter = value;
      break;
   case OSD_SW3:
      sw3counter = value;
      break;
   }
}

void set_auto_name(char* name) {
    scaling_names[0] = name;
}

// =============================================================
// Public Methods
// =============================================================

/*
uint32_t osd_get_equivalence(uint32_t value) {
   switch (capinfo->bpp) {
        case 4:
            return equivalence[value & 0xf] | (equivalence[(value >> 4) & 0xf] << 4) | (equivalence[(value >> 8) & 0xf] << 8) | (equivalence[(value >> 12) & 0xf] << 12)
            | (equivalence[(value >> 16) & 0xf] << 16) | (equivalence[(value >> 20) & 0xf] << 20) | (equivalence[(value >> 24) & 0xf] << 24) | (equivalence[(value >> 28) & 0xf] << 28);
        break;
        case 8:
            return equivalence[value & 0xff] | (equivalence[(value >> 8) & 0xff] << 8) | (equivalence[(value >> 16) & 0xff] << 16) | (equivalence[value >> 24] << 24);
        break;
        default:
        case 16:
            return value;
        break;
   }
}
*/

uint32_t osd_get_palette(int index) {
   if (active) {
      return osd_palette_data[index];
   } else {
      return palette_data[index];
   }
}

int normalised_gamma_correct(int old_value) {
    if (old_value >= 0) {
        double value = (double) old_value;
        double normalised_gamma = 1 / ((double)get_parameter(F_GAMMA) / 100);
        value = value < 0 ? 0 : value;
        value = pow(value, normalised_gamma) * 255;
        value = round(value);
        value = value < 0 ? 0 : value;
        value = value > 255 ? 255 : value;
        return (int) value;
    } else {
        return old_value;
    }
}

double gamma_correct(double value, double normalised_gamma) {
    value = value < 0 ? 0 : value;
    value = pow(value, normalised_gamma) * 255;
    value = round(value);
    value = value < 0 ? 0 : value;
    value = value > 255 ? 255 : value;
    return value;
}

int adjust_palette(int palette) {
    if (get_parameter(F_TINT) !=0 || get_parameter(F_SAT) != 100 || get_parameter(F_CONT) != 100 || get_parameter(F_BRIGHT) != 100 || get_parameter(F_GAMMA) != 100) {
        double R = (double)(palette & 0xff) / 255;
        double G = (double)((palette >> 8) & 0xff) / 255;
        double B = (double)((palette >> 16) & 0xff) / 255;
        double M = (double)((palette >> 24) & 0xff) / 255;

        double normalised_contrast = (double)get_parameter(F_CONT) / 100;
        double normalised_brightness = (double)get_parameter(F_BRIGHT) / 200 - 0.5f;
        double normalised_saturation = (double)get_parameter(F_SAT) / 100;
        double normalised_gamma = 1 / ((double)get_parameter(F_GAMMA) / 100);

        double Y = 0.299 * R + 0.587 * G + 0.114 * B;
        double U = -0.14713 * R - 0.28886 * G + 0.436 * B;
        double V = 0.615 * R - 0.51499 * G - 0.10001 * B;

        Y = (Y + normalised_brightness) * normalised_contrast;
        double hue = get_parameter(F_TINT) * PI / 180.0f;
        double U2 = (U * cos(hue) + V * sin(hue)) * normalised_saturation * normalised_contrast;
        double V2 = (V * cos(hue) - U * sin(hue)) * normalised_saturation * normalised_contrast;

        M = (M + normalised_brightness) * normalised_contrast;

        R = (Y + 1.140 * V2);
        G = (Y - 0.396 * U2 - 0.581 * V2);
        B = (Y + 2.029 * U2);

        R = gamma_correct(R, normalised_gamma);
        G = gamma_correct(G, normalised_gamma);
        B = gamma_correct(B, normalised_gamma);
        M = gamma_correct(M, normalised_gamma);

        return (int)R | ((int)G << 8) | ((int)B << 16) | ((int)M << 24);
    } else {
        return (palette);
    }
}

int colodore_gamma_correct(double value) {
    static double source = 2.8;
    static double target = 2.2;
    value = value < 0 ? 0 : value;
    value = value > 255 ? 255 : value;
    value = pow(255, 1 - source ) * pow(value, source);
    value = pow(255, 1 - 1 / target) * pow(value, 1 / target);
    return (int) round(value);
}

 void create_colodore_colours(int index, int revision, double brightness, double contrast, double saturation, int *red, int *green, int *blue, int *mono) {
    static int mc[] = { 0, 32, 10, 20, 12, 16, 8, 24, 12, 8, 16, 10, 15, 24, 15, 20};
    static int fr[] = { 0, 32, 8, 24, 16, 16, 8, 24, 16, 8, 16, 8, 16, 24, 16, 24};
    static int angles[] = { 0, 0, 4, 12, 2, 10, 15, 7, 5, 6, 4, 0, 0, 10, 15, 0 };

    double sector = 360 / 16;
    double origin = sector / 2;
    double radian = M_PI / 180;
    double screen = 1 / 5;

    brightness -=50;
    contrast /=100;
    saturation *= 1 - screen;

    double y = 0;
    double u = 0;
    double v = 0;

    if (angles[index]) {
        double angle = (origin + angles[index] * sector ) * radian;
        u = cos(angle) * saturation;
        v = sin(angle) * saturation;
    }
    if (revision) {
        y = 8 * mc[ index ] + brightness;
    } else {
        y = 8 * fr[ index ] + brightness;
    }

    y = y * contrast + screen;
    u = u * contrast + screen;
    v = v * contrast + screen;

    double r = y + 1.140 * v;
    double g = y - 0.396 * u - 0.581 * v;
    double b = y + 2.029 * u;

    *red =  colodore_gamma_correct(r);
    *green = colodore_gamma_correct(g);
    *blue = colodore_gamma_correct(b);
    *mono = colodore_gamma_correct(y);
}

int create_NTSC_artifact_colours(int index, int filtered_bitcount) {
    int colour = index & 0x0f;
    int bitcount = 0;
    if (colour & 1) bitcount++;
    if (colour & 2) bitcount++;
    if (colour & 4) bitcount++;
    if (colour & 8) bitcount++;
    double Y = 0;
    double U = 0;
    double V = 0;
    double R = 0;
    double G = 0;
    double B = 0;
    colour = ((colour << (4 - (get_adjusted_ntscphase() & 3))) & 0x0f) | (colour >> (get_adjusted_ntscphase() & 3));

    if (ntsc_palette <= features[F_PALETTE].max) {
        if (colour > 7) colour += 8;
        int RGBY = palette_array[ntsc_palette][colour];
        //if (colour < 0x18) log_info("Using %d, %x for NTSC palette %X",ntsc_palette,colour,  RGBY);
        R = (double)(RGBY & 0xff) / 255.0f;
        G = (double)((RGBY >> 8) & 0xff) / 255.0f;
        B = (double)((RGBY >> 16) & 0xff) / 255.0f;

    } else {
    //log_info("Using internal for NTSC palette");
    double phase_shift = 0.0f;

        switch (colour) {
           case 0x00:
              Y=0     ; U=0     ; V=0     ; break; //Black
           case 0x01:
              Y=0.25  ; U=0     ; V=0.5   ; phase_shift = 6.0f; break; //Magenta
           case 0x02:
              Y=0.25  ; U=0.5   ; V=0     ; phase_shift = 12.0f; break; //Dark Blue
           case 0x03:
              Y=0.5   ; U=1     ; V=1     ; phase_shift = -6.0f; break; //Purple
           case 0x04:
              Y=0.25  ; U=0     ; V=-0.5  ; phase_shift = 12.0f; break; //Dark Green
           case 0x05:
              Y=0.5   ; U=0     ; V=0     ; break; //lower Gray
           case 0x06:
              Y=0.5   ; U=1     ; V=-1    ; phase_shift = -6.0f; break; //Medium Blue
           case 0x07:
              Y=0.75  ; U=0.5   ; V=0     ; phase_shift = 6.0f; break; //Light Blue
           case 0x08:
              Y=0.25  ; U=-0.5  ; V=0     ; phase_shift = 12.0f; break; //Brown
           case 0x09:
              Y=0.5   ; U=-1    ; V=1     ; phase_shift = -6.0f; break; //Orange
           case 0x0a:
              Y=0.5   ; U=0     ; V=0     ; break; //upper Gray
           case 0x0b:
              Y=0.75  ; U=0     ; V=0.5   ; phase_shift = 6.0f; break; //Pink
           case 0x0c:
              Y=0.5   ; U=-1    ; V=-1    ; phase_shift = -6.0f; break; //Light Green
           case 0x0d:
              Y=0.75  ; U=-0.5  ; V=0     ; phase_shift = 6.0f; break; //Yellow
           case 0x0e:
              Y=0.75  ; U=0     ; V=-0.5  ; phase_shift = 6.0f; break; //Aquamarine
           case 0x0f:
              Y=1     ; U=0     ; V=0     ; break; //White
        }

        double hue = phase_shift * PI / 180.0f;

        double U2 = (U * cos(hue) + V * sin(hue));
        double V2 = (V * cos(hue) - U * sin(hue));

        R = (Y + 1.140 * V2);
        G = (Y - 0.395 * U2 - 0.581 * V2);
        B = (Y + 2.032 * U2);

    }

    if (filtered_bitcount == 1) {

        switch(bitcount) {
            case 1:
                R = R * 100 / 100;
                G = G * 100 / 100;
                B = B * 100 / 100;
                break;
            case 2:
                R = R * 50 / 100;
                G = G * 50 / 100;
                B = B * 50 / 100;
                break;
            case 3:
                R = R * 33 / 100;
                G = G * 33 / 100;
                B = B * 33 / 100;
                break;
            case 4:
                R = R * 33 /100;
                G = G * 33 /100;
                B = B * 33 /100;
                break;
            default:
                break;
        }

    }
    if (filtered_bitcount == 2) {
        switch(bitcount) {
            case 1:
                R = R * 125 / 100;
                G = G * 125 / 100;
                B = B * 125 / 100;
                break;
            case 2:
                R = R * 100 / 100;
                G = G * 100 / 100;
                B = B * 100 / 100;
                break;
            case 3:
                R = R * 66 / 100;
                G = G * 66 / 100;
                B = B * 66 / 100;
                break;
            case 4:
                R = R * 66 /100;
                G = G * 66 /100;
                B = B * 66 /100;
                break;
            default:
                break;
        }
    }

    if (filtered_bitcount >= 3) {
        switch(bitcount) {
            case 1:
                R = R * 150 / 100;
                G = G * 150 / 100;
                B = B * 150 / 100;
                break;
            case 2:
                R = R * 125 / 100;
                G = G * 125 / 100;
                B = B * 125 / 100;
                break;
            case 3:
                R = R * 100 / 100;
                G = G * 100 / 100;
                B = B * 100 / 100;
                break;
            case 4:
                R = R * 100 /100;
                G = G * 100 /100;
                B = B * 100 /100;
                break;
            default:
                break;
        }
    }

    R = gamma_correct(R, 1);
    G = gamma_correct(G, 1);
    B = gamma_correct(B, 1);
    Y = gamma_correct(Y, 1);

    return (int)R | ((int)G<<8) | ((int)B<<16) | ((int)Y<<24);
}

int create_NTSC_artifact_colours_palette_320(int index) {
    int colour = index & 0x0f;
    int R = 0;
    int G = 0;
    int B = 0;

    colour = ((colour << (4 - (get_adjusted_ntscphase() & 3))) & 0x0f) | (colour >> (get_adjusted_ntscphase() & 3));

    if (index < 0x10) {
        switch (colour) {
           case 0x00:
              R=0     ; G=0     ; B=0     ; break; //Black
           case 0x08:
              R=0     ; G=117   ; B=108   ; break;
           case 0x01:
              R=0     ; G=49    ; B=111   ; break;
           case 0x09:
              R=0     ; G=83    ; B=63    ; break;
           case 0x02:
              R=123   ; G=52    ; B=0     ; break;
           case 0x0a:
              R=57    ; G=190   ; B=66    ; break;
           case 0x03:
              R=131   ; G=118   ; B=73    ; break;
           case 0x0b:
              R=83    ; G=155   ; B=14    ; break;
           case 0x04:
              R=235   ; G=50    ; B=7     ; break;
           case 0x0c:
              R=210   ; G=196   ; B=153   ; break;
           case 0x05:
              R=248   ; G=122   ; B=155   ; break;
           case 0x0d:
              R=217   ; G=160   ; B=107   ; break;
           case 0x06:
              R=180   ; G=69    ; B=0     ; break;
           case 0x0e:
              R=139   ; G=208   ; B=74    ; break;
           case 0x07:
              R=190   ; G=133   ; B=80    ; break;
           case 0x0f:
              R=152   ; G=173   ; B=20    ; break;
        }
    } else {
        switch (colour) {
           case 0x00:
              R=0     ; G=0     ; B=0     ; break; //Black
           case 0x08:
              R=0     ; G=139   ; B=172   ; break;
           case 0x01:
              R=0     ; G=73    ; B=174   ; break;
           case 0x09:
              R=0     ; G=158   ; B=232   ; break;
           case 0x02:
              R=89    ; G=28    ; B=0     ; break;
           case 0x0a:
              R=0     ; G=188   ; B=155   ; break;
           case 0x03:
              R=99    ; G=116   ; B=158   ; break;
           case 0x0b:
              R=0     ; G=206   ; B=217   ; break;
           case 0x04:
              R=237   ; G=28    ; B=39    ; break;
           case 0x0c:
              R=180   ; G=196   ; B=238   ; break;
           case 0x05:
              R=221   ; G=125   ; B=239   ; break;
           case 0x0d:
              R=188   ; G=210   ; B=255   ; break;
           case 0x06:
              R=255   ; G=73    ; B=0     ; break;
           case 0x0e:
              R=247   ; G=237   ; B=193   ; break;
           case 0x07:
              R=255   ; G=165   ; B=196   ; break;
           case 0x0f:
              R=255   ; G=255   ; B=255   ; break;
        }
    }

    double Y = 0.299 * (double)R + 0.587 * (double)G + 0.114 * (double)B;
    Y = gamma_correct(Y, 1);

    return R | (G << 8) | (B << 16) | ((int)Y << 24);
}

void yuv2rgb(int maxdesat, int mindesat, int luma_scale, int blank_ref, int y1_millivolts, int u1_millivolts, int v1_millivolts, int *r, int *g, int *b, int *m) {

   int desat = maxdesat;
   if (y1_millivolts >= 720) {
       desat = mindesat;
   }

   if (y1_millivolts == blank_ref) {
       u1_millivolts = 2000;
       v1_millivolts = 2000;
   }

   *m = luma_scale * 255 * (blank_ref - y1_millivolts) / (blank_ref - 420) / 100;
   for(int chroma_scale = 100; chroma_scale > desat; chroma_scale--) {
      int y = (luma_scale * 255 * (blank_ref - y1_millivolts) / (blank_ref - 420));
      int u = (chroma_scale * ((u1_millivolts - 2000) / 500) * 127);
      int v = (chroma_scale * ((v1_millivolts - 2000) / 500) * 127);

      //if (y1_millivolts <= 540) { // add a little differential phase shift
      //    double hue = -12 * PI / 180.0f;
      //    u = (int) ((double)u * cos(hue) + (double)v * sin(hue));
      //    v = (int) ((double)v * cos(hue) - (double)u * sin(hue));
      //}

      int r1 = (((10000 * y) - ( 0001 * u) + (11398 * v)) / 1000000);
      int g1 = (((10000 * y) - ( 3946 * u) - ( 5805 * v)) / 1000000);
      int b1 = (((10000 * y) + (20320 * u) - ( 0005 * v)) / 1000000);


      *r = r1 < 1 ? 1 : r1;
      *r = r1 > 254 ? 254 : *r;
      *g = g1 < 1 ? 1 : g1;
      *g = g1 > 254 ? 254 : *g;
      *b = b1 < 1 ? 1 : b1;
      *b = b1 > 254 ? 254 : *b;

      if (*r == r1 && *g == g1 && *b == b1) {
         break;
      }
   }

   //int new_y = ((299* *r + 587* *g + 114* *b) );
   //new_y = new_y > 255000 ? 255000 : new_y;
   //if (colour == 0) {
   //    log_info("");
   //}
   //log_info("Col=%2x,  R=%4d,G=%4d,B=%4d, Y=%3d Y=%6f (%3d/256 sat)",colour,*r,*g,*b, (int) (new_y + 500)/1000, (double) new_y/1000, chroma_scale);

}


void generate_palettes() {

#define bp  0x24    // b-y plus
#define bz  0x20    // b-y zero
#define bz2 0x04    // b-y zero2
#define bm  0x00    // b-y minus
#define rp  0x09    // r-y plus
#define rz  0x08    // r-y zero
#define rz2 0x01    // r-y zero2
#define rm  0x00    // r-y minus
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
