hoglet67/RGBtoHDMI/(commit log)

2017-04-24 Initial version of RGBtoHTML
    [config.txt]
2017-04-24 Added code to copy RGB to framebuffer
2017-04-25 Add a grey background to framebuffer for debugging
2017-04-25 Update core clock to 384MHz, add hdmi settings
    [config.txt]
2017-04-25 Switch to 1920x1080
    [config.txt]
2017-04-25 Make virtual frame buffer same size as physical frame buffer
2017-04-25 Set all outputs to SLOW to reduce noise
    [RGBtoHDMI.ucf]
2017-04-25 Set core_freq to 383.9MHz via mailbox
    [config.txt]
2017-04-26 Switch to software processing of CSYNC to find VSYNC and Odd/Even field
2017-04-26 Removed obsolete VSYNC logic from CPLD, pass through CSYNC to ARM
2017-04-27 Calibrate clock based on VSYNC time
2017-04-30 Freed up a couple of registers
2017-04-30 Extended clock calibration to correctly handle 624-line non-interlaced modes
    [defs.h, rgb_to_hdmi.c]
2017-04-30 Updated active area to 672x540 to be more tolerant of *TV settings
    [config.txt]
2017-04-30 Comment config.txt
    [config.txt]
2017-04-30 Fixes for Pi 3
    [config.txt]
2017-04-30 Custom 1600x1200@50 HDMI mode
    [config.txt]
2017-05-01 Workaround for cache stall issues on Pi3
2017-05-02 Work-in-progress on double buffering - disabled
    [config.txt]
2017-05-18 Switch between 672x540 and 504x540 depending on mode
    [config.txt]
2017-05-18 Dropped PROBE mode as it is now unnecessary, as we can re-initialize the framebuffer multiple times
2017-05-19 Switch over to using the framebuffer interface (channel 1) for initializing the framebuffer
2017-05-25 Auto-calibration: work in progress
2017-05-25 Auto-calibration: work still in progress
2017-05-25 Disable ARM use of L2 cache really helps!
    [config.txt]
2017-05-25 Fix counter pipelining issue
    [RGBtoHDMI.ucf, RGBtoHDMI.vhdl]
2017-05-25 Move all mode 7 sample points in lock-step
2017-05-28 Added support for manual calibration button
2017-06-02 Added timing instrumentation to calibration
2017-06-02 Test nudging sample points +- 1 in mode 7
2017-06-28 Extended calibration to detect Electron
2018-01-23 Added KiCad schematics and pcb (work in progress)
    [rgb-to-hdmi.kicad_pcb, rgb-to-hdmi.sch]
2018-06-04 Added KiCad schematics and pcb (v3)
    [rgb-to-hdmi.kicad_pcb, rgb-to-hdmi.sch]
2018-06-05 KiCad: corrected via size, cleaned up silk screen
    [rgb-to-hdmi.kicad_pcb, rgb-to-hdmi.sch]
2018-06-05 CPLD: Updated to pinout from PCB based design
2018-06-05 KiCad: removed SW2/3 passthrough, use gpio 19/26 instead
    [rgb-to-hdmi.kicad_pcb, rgb-to-hdmi.sch]
2018-06-05 KiCad and CPLD: final small changes to bring SW2/3/link inputs and LED1 output to CPLD (unused)
    [rgb-to-hdmi.kicad_pcb, rgb-to-hdmi.sch]
2018-06-06 KiCad: Removed SW1Out passthrough to save a produce term
    [rgb-to-hdmi.kicad_pcb, rgb-to-hdmi.sch]
2018-06-06 CPLD and Pi Firmware: swapped gpio assignments for gpio20 and gpio23 (sp_clk and sp_data) as prototype had noise spikes on gpio20
    [RGBtoHDMI.ucf, defs.h]
2018-06-06 CPLD: removed SW1 from sp_ref assignment block (prone to noise on prototype)
    [RGBtoHDMI.vhdl]
2018-06-06 KiCad: Brought gpio0/1 into use as extra cpld inputs
    [rgb-to-hdmi.kicad_pcb, rgb-to-hdmi.sch]
2018-06-07 Pi Firmware: Skipped second phase of Mode 7 Cal if ref is zero errors
    [rgb_to_hdmi.c]
2018-06-07 CPLD: replace counter2 with load, saving two macro blocks
    [RGBtoHDMI.vhdl]
2018-06-08 Pi Firmware: refactor cpld specific calibration code into a seperate module
2018-06-08 Pi Firmware: Added calibration code for alternative cpld
2018-06-09 CPLD and Pi Firmware: Revert to Quad starting at GPIO2
    [RGBtoHDMI.ucf, defs.h]
2018-06-09 Pi Firmware: dropped sp_default from normal CPLD driver
2018-06-09 Pi Firmware: tidied up alternative CPLD driver
2018-06-09 Pi Firmware: default to normal CPLD driver
2018-06-09 Pi Firmware: Added version support and cpld driver selection
2018-06-09 Pi Firmware: fix switch press aborting calibration capture
2018-06-09 Pi Firmware: updated switch actions
2018-06-09 Pi Firmware: use configurable half-pixel delay where appropriate in calibration, also introduce config struct
2018-06-10 Pi Firmware: switched over to using SAA50505 font for OSD (work in progress)
2018-06-11 Pi Firmware: fixed minor issues with Cal code, improved formatting
    [cpld.h, rgb_to_hdmi.c]
2018-06-12 KiCad: Juggled R/G/B/S inputs so GSR connects to GPIO18
    [rgb-to-hdmi.kicad_pcb, rgb-to-hdmi.sch]
2018-06-12 CPLD: Juggled GPIO assignments so CPLD pin 33 (GSR) connects to GPIO18 (Version)
2018-06-12 Pi Firmware: Juggled GPIO assignments so CPLD pin 33 (GSR) connects to GPIO18 (Version)
2018-06-12 KiCad: Final set of CPLD pinout changes
    [rgb-to-hdmi.kicad_pcb, rgb-to-hdmi.sch]
2018-06-12 Pi Firmware: Drive LED1 when OSD Active
2018-06-13 KiCad: starting to prepare manufacturing files
    [rgb-to-hdmi.kicad_pcb]
2018-06-13 KiCad: increased via size from 24 to 26 mil
    [rgb-to-hdmi.kicad_pcb]
2018-06-13 KiCad: final cleanup phase
    [rgb-to-hdmi.kicad_pcb]
2018-06-13 KiCad: generated manufacturing files
    [rgb-to-hdmi.gbl, rgb-to-hdmi.gbo, rgb-to-hdmi.gbs, rgb-to-hdmi.gtl, rgb-to-hdmi.gto, rgb-to-hdmi.gts]
2018-06-21 Pi Firmware: in the normal cpld in mode 0..6, sample opposite the max metric
2018-06-22 Pi Firmware: Calibrate VSYNC time after enabling gpclk so CPLD can register csync
2018-06-22 Normal CPLD: de-glitch csync (needs to be low for 3 samples)
    [RGBtoHDMI.vhdl]
2018-06-22 Alternative CPLD: de-glitch csync (needs to be low for 2 samples)
    [RGBtoHDMI.vhdl]
2018-07-08 config.txt comments only
    [config.txt]
2018-07-13 Pi Firmware: fixed some OSD consistentency issues if mode changes while OSD active
    [osd.c, osd.h, rgb_to_hdmi.c]
2018-07-13 Pi Firmware: Allow for double buffering during calibration, much slicker UI in mode 0..6
2018-07-14 Pi Firmware: Swapped the Feature Selection and Manual Calibration buttons over
    [osd.c]
2018-07-15 CPLD: Corrected sampling offset to better centre screen; CPLD version now 0.9
    [RGBtoHDMI.vhdl]
2018-07-15 Pi Firmware: Fixed an issue that caused RHS od Mode 2/5 to be cropped slightly
    [defs.h]
2018-07-15 Pi Firmware: tidy up config.txt, more examples, all use disable_overscan=1
    [config.txt]
2018-07-15 Pi Firmware: Use CEA mode 19 for 1280x720@50p
    [config.txt]
2018-07-15 Pi Firmware: update calibration in cmdline.txt
2018-07-17 Pi Firmware: fix a crash with OSD when DOUBLE_BUFFER undefined
    [osd.c]
2018-07-17 Pi Firmeware: added hdmi_timings example to config.txt
    [config.txt]
2018-07-18 Pi Firmware: Show clock error on info screen
    [osd.c, osd.h, rgb_to_hdmi.c]
2018-07-18 Pi Firmware: fix a short delay that was not working
    [rgb_to_hdmi.c]
2018-07-18 Pi Firmware: Elk detection was broke - fixed now
    [osd.c, osd.h, rgb_to_hdmi.c]
2018-07-23 Pi Firmware: Use FLIP_BUFFER and remove obsolete POLL_VSYNC code
    [defs.h]
2018-07-31 KiCad: v4 minor changes (moved P5 1.8mm, changed name to RGBtoHD)
    [rgb-to-hdmi.kicad_pcb, rgb-to-hdmi.sch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]
2018-10-15 CPLD: increased de-glitching (IanB's issue) but still unresolved
    [RGBtoHDMI.vhdl]
2018-10-15 CPLD: De-glitch both states of csync
    [RGBtoHDMI.vhdl]
2018-10-15 CPLD: Reduce csync de-glitch counter to 2 bits
    [RGBtoHDMI.vhdl]
2018-10-16 Pi Firmware: Updated config fils with 1024x600 and 800x600, and comments on scaling_kernel
    [config.txt]
2018-10-18 Fix OSD so it works with motion adaptive deinterlacing
    [osd.c]
2018-10-18 Bypass motion adaptive deinterlacing during calibration
2018-10-19 Fix misses palette change when OSD cleared (in non DEBUG mode)
    [osd.c]
2018-10-19 Fixed typo in OSD
    [osd.c]
2018-10-21 Fix calibration/OSD glitch in mode 7
2018-10-21 Only write OSD to buffer 0 in frame buffer
2018-10-29 Pi Firmware: CPLD driver aware of version 2.x with extra mode 7 calibration parameter (delay)
2018-10-30 Pi Firmware: Cycle sample points appropriatly if delay used
2018-11-11 Pi Firmware: made diff_N_frames cursor skipping aware of v_offset
    [rgb_to_hdmi.c]
2018-11-13 Pi Firmware: improved debug grid for de-interlacing
2018-11-13 Pi Firmware: fix a recent bug that caused OSD flickering when calibrating modes 0..6
2018-11-15 Pi Firmware: Big rework of the OSD Menus
    [cpld.h, osd.c, osd.h]
2018-11-16 Pi Firmware: Added clocking parameters to support other systems
    [config.txt]
2018-11-16 Pi Firmware: switch to atom configs for testing
    [config.txt]
2018-11-16 Pi Firmware: Atom config 1600x1200 with 3x scaling
    [config.txt]
2018-11-16 Pi Firmware: Atom config 1600x1200 with 2.5x scaling
    [config.txt]
2018-11-17 Pi Firmware: revert to BBC configs as default
    [config.txt]
2018-11-17 Fix bug in commit that allows menus to wrap
    [osd.c]
2018-11-17 Pi Firmware: Atom config 1920x1080 with 2x scaling
    [config.txt]
2018-11-18 Pi Firmware: fixed a bug that possibly corrupted clkinfo.line_len
    [rgb_to_hdmi.c]
2018-11-18 Pi Firmware: implemented capture of N frames and OSD_EXPIRED for delayed exit of OSD
2018-11-18 P Firmware: show vsync during clock calibration
2018-11-19 Pi Firmware: changed to using hdmi_timings in 1600x1200@50 mode
    [config.txt]
2018-11-19 Pi Firmware: maintain exact lock when switching between modes 0..6 and mode 7
2018-11-19 Revert "Pi Firmware: changed to using hdmi_timings in 1600x1200@50 mode"
    This reverts commit 67ff0b059aa60498de916b28fae6428f20b028c8.
    [config.txt]
2018-11-21 Pi Firmware: Fixed a CPLD version fallback bug with the DELAY parameter
    [osd.c]
2018-11-21 Pi Firmware: fixed flickering OSD in auto-calibrate
    [rgb_to_hdmi.c]
2018-11-22 Atom PCB: Prototype (work in progress)
    [rgb-to-hdmi.kicad_pcb, rgb-to-hdmi.sch, rgb-to-hdmi2.kicad_pcb]
2018-11-22 Atom PCB: Prototype (just about complete)
    [rgb-to-hdmi.kicad_pcb, rgb-to-hdmi.sch, rgb-to-hdmi2.kicad_pcb]
2018-11-22 Atom CPLD: Initial version for home-etched prototype
2018-11-22 Atom PCB: Prototype (improved ground routing)
    [rgb-to-hdmi.kicad_pcb]
2018-11-23 Atom CPLD: Reworked for a 57.272MHz clock
    [RGBtoHDMI.vhdl]
2018-11-23 Atom CPLD: Added back in glitch filtering
    [RGBtoHDMI.vhdl]
2018-11-27 Pi Firmware: Started adding support for 8-bit frame buffer
2018-11-27 Pi Firmware: chars_per_line is always in units of 8 pixels, regardless of frame buffer bit depth
2018-11-27 Pi Firmware: OSD now works with 8-bit frame buffer
2018-11-30 Pi Firmware: rework psync edge detection
    [defs.h]
2018-12-03 Improvements and bug fixed for genlock
    [osd.c, rgb_to_fb.h, rgb_to_hdmi.c]
2018-12-03 Reduce hysteresis range by 1 to fix mode change detection
    [rgb_to_hdmi.c]
2018-12-03 Pi Firmware: Correctly handle changes of interlace within a mode
    [defs.h, rgb_to_hdmi.c]
2018-12-03 Pi Firmware: Fix a bug in osd.c set_feature that enabled scanlines
    [osd.c]
2018-12-03 Atom CPLD: Made C/L noise filters configurable
    [RGBtoHDMI.vhdl]
2018-12-03 Pi Firmware: cpld_atom: Added C/L noise filters
    [cpld_atom.c]
2018-12-03 Fix genlock bias bug
    [rgb_to_hdmi.c]
2018-12-04 Pi Firmware: Correct trailing white space
    [rgb_to_hdmi.c]
2018-12-04 Pi Firmware: Correct indentation whitespace
    [rgb_to_hdmi.c]
2018-12-04 Pi Firmware: Remove need to specify n_lines (lines / frame)
2018-12-04 Pi Firmware: calibrate_samling_clock: determine interlace based on number of lines
2018-12-05 Pi Firmware: Use LED1 and a genlock indicator
2018-12-05 Pi Firmware: Improve OSD for the clock cal button (sw2)
2018-12-05 Pi Firmware: renamed Clock Calibration to HDMI Clock Calibration
2018-12-07 Pi Firmware: added clock tolerance to geometry params
    [defs.h, geometry.c, rgb_to_hdmi.c]
2018-12-07 Pi Firmware: A clock tolerance of 0 is treated as unlimited
    [rgb_to_hdmi.c]
2018-12-07 Pi Firmware: also build debug kernel, update copyright
    [config.txt]
2018-12-07 Pi Firmware: HDMI Clock Calibration -> HDMI Calibration
2019-02-05 Increase buffer sizes, fix PPM speed & tidyup
    [osd.c, rgb_to_hdmi.c]
2019-02-25 CPLD: Correct issue with delay in 6 clocks/pixel mode
    [RGBtoHDMI.vhdl]
2019-03-03 Update in band detection to work with 4 and 8 bit buffers (merge capture 4bpp & 8bpp). Also in band can detect multiple lines per frame.
2019-03-04 Add switch to disable multi palette
2019-03-05 Fix OSD issues at half resoloution
    [cpld_atom.c, geometry.c, osd.c]
2019-03-06 Add 8x8 font and revert all previous OSD changes
    [8x8_font.c, cpld_atom.c, geometry.c, osd.c]
2019-03-07 Add Palette Control menu option & restore double samples
2019-03-08 Pi Firmware: Added rate param (CPLD v3.x) to CPLD driver
2019-03-08 Psyncx2 now decodes bits correctly
    [geometry.c]
2019-03-09 Pi Firmware: Make second PSYNC read conditional on the sample width (skip in PSYNC x2 mode)
    [defs.h]
2019-03-09 Fixed: Cursor flashing affects auto calibration (#35)
    [rgb_to_hdmi.c]
2019-03-09 Fixed: Increasing or decreasing FB Height causes a crash (#36)
    [geometry.c]
2019-03-10 Add FB Double height setting to easily switch between single and double height frame buffers
2019-03-10 Pi Firmware: osd.c whitespace (fixed indentation)
    [osd.c]
2019-03-10 Fixed: Calibration errors with half height frame buffers (#40)
    [defs.h, geometry.c, rgb_to_hdmi.c]
2019-03-10 Added screen capture to SD card (middle button)
2019-03-11 Pi Firmware: revert attempt to use cal button for two functions
    [osd.c]
2019-03-11 Pi Firmware: Switched screen capture to LodePNG
2019-03-11 Pi Firmware: Use Pi Framebuffer directly (supports 4 and 8 bpp)
2019-03-11 Genlock improvements & bug fixes
    [osd.c, rgb_to_hdmi.c]
2019-03-11 Rework m7disable and elk settings
    [osd.c, osd.h, rgb_to_hdmi.c, rgb_to_hdmi.h]
2019-03-12 CPLD: Fix long-standing bug concerning offset selection in Mode 0..6
    [RGBtoHDMI.vhdl]
2019-03-13 CPLD: Reverted: Align quad timing back to cycle 0 as before (issues at offset 0)
    [RGBtoHDMI.vhdl]
2019-03-13 Pi Firmware: fixed a minor parameter setting glitch
    [osd.c]
2019-03-14 CPLD: Added sync invert function (now v5.0)
    [RGBtoHDMI.vhdl]
2019-03-14 Pi Firmware: Auto-detect sync polarity, and invert if neccessary (manual merge from Ian)
    [cpld.h, cpld_atom.c, rgb_to_fb.h, rgb_to_hdmi.c]
2019-03-15 Fix V3: Smooth Horizontal Scrolling is broken #34 also optimise fast capture loops
    [defs.h, rgb_to_fb.h, rgb_to_hdmi.c]
2019-03-20 Add auto profile switching system & genlock fix. Also clock and line length now displayed /6 or /8
    [cpld.h, cpld_atom.c, defs.h, geometry.c, osd.c, osd.h, rgb_to_fb.h, rgb_to_hdmi.c]
2019-03-22 Add new menu options for lines per frame, sync type and sub-profile ready for user specified autoswitching
2019-03-22 Support frame buffers larger than capture area
2019-03-22 Added automatic scaling option
    [config.txt]
2019-03-23 Add palette to saved png files. Fixes https://github.com/hoglet67/RGBtoHDMI/issues/46
    [filesystem.c, osd.c, osd.h, rgb_to_hdmi.c]
2019-03-23 remove update_param_range() clipping, replace with silent clipping
    [geometry.c, osd.c]
2019-03-23 Fix calibration/alignment with larger frame buffers
    [rgb_to_hdmi.c]
2019-03-23 Further calibration fixes
2019-03-23 8 bit mode 0 alignment. Fixes https://github.com/hoglet67/RGBtoHDMI/issues/57
    [rgb_to_hdmi.c]
2019-03-24 CPLD: Fixed a bug with half-pixel delay (now v6.2)
    [RGBtoHDMI.vhdl]
2019-03-24 Pi Firmware: Fixed an incorrectly calculated optimized calibration when half=1
2019-03-24 Pi Firmware: Workaround a menu ordering issue when return at end of list
    [osd.c]
2019-03-29 Use clock tolerance to determine autoswitch window & tidy up autoswitch code
    [defs.h, filesystem.c, geometry.c, geometry.h, osd.c, rgb_to_hdmi.c]
2019-03-29 Fix autoswitch sync bug & allow manual selection of sub-profiles by disabling autoswitch
    [defs.h, geometry.c, osd.c, rgb_to_hdmi.c]
2019-03-30 Workaround for genlock causing frame drop with hires modes
2019-03-31 Support separate H and V sync (needs CPLD change) also fix issue with cache preload wasting one line
    [defs.h, osd.c, rgb_to_hdmi.c]
2019-04-04 Integer scaling supports double height frame buffer, change scanlines to write to line above, display clock info in geometry menu
2019-04-04 Updated config files
    [OLD config.txt, default config.txt]
2019-04-04 Resolution and interpolation adjustable from menus also addresses https://github.com/hoglet67/RGBtoHDMI/issues/65
    [defs.h, filesystem.c, filesystem.h, geometry.c, info.c, info.h, osd.c, osd.h]
2019-04-05 Fix FB 4:3 scaling bug
    [filesystem.c, geometry.c]
2019-04-05 Updated config,profile & resolution files without spaces
    [default_config.txt]
2019-04-05 more profile updates
    [config.txt]
2019-04-06 Add vlock adjust setting and power on reset of output mode to auto
    [defs.h, geometry.c, osd.c, osd.h, rgb_to_fb.h, rgb_to_hdmi.c, rgb_to_hdmi.h]
2019-04-07 Increased Pi Config max_framebuffer_size; fixes #72 and maybe also #60
    [config.txt, default_config.txt]
2019-04-08 Fix integer scaling issue with 5:4 1280x1024 monitors
    [geometry.c]
2019-04-08 Kicad: Started work on v2 of Atom PCB
    [rgb-to-hdmi.kicad_pcb, rgb-to-hdmi.sch]
2019-04-08 Kicad: Continued work on v2 of Atom PCB
    [rgb-to-hdmi.kicad_pcb, rgb-to-hdmi.sch, x1.kicad_pcb]
2019-04-08 Add H and V sync timeout also fix OSD font selection bug
    [defs.h, osd.c, rgb_to_fb.h, rgb_to_hdmi.c]
2019-04-08 Fix white flash when menu turned on with scanlines enabled
    [osd.c, rgb_to_fb.h, rgb_to_hdmi.c]
2019-04-09 Fix sync detection bug
    [rgb_to_hdmi.c]
2019-04-09 Fix scanline palette bug
    [osd.c]
2019-04-09 Improve white flash fix
    [osd.c]
2019-04-09 Kicad: Atom v2: rotated idc connector by 180
    [rgb-to-hdmi.kicad_pcb, rgb-to-hdmi.sch]
2019-04-09 Kicad: Atom v2: used correct footprint for IDC header
    [rgb-to-hdmi.kicad_pcb, rgb-to-hdmi.sch]
2019-04-09 Kicad: Atom v2: made board 100 wide by 80 deep
    [rgb-to-hdmi.kicad_pcb]
2019-04-09 Kicad: Atom v2: cutouts/holes for EVA73G case
    [rgb-to-hdmi.kicad_pcb, rgb-to-hdmi.sch]
2019-04-09 Kicad: Atom v2: fixed overhanging components (big change)
    [rgb-to-hdmi.kicad_pcb, rgb-to-hdmi.sch]
2019-04-09 Kicad: Atom v2: centred IDC connector again
    [rgb-to-hdmi.kicad_pcb, rgb-to-hdmi.sch]
2019-04-09 Fix flash on screen capture message
    [filesystem.c]
2019-04-09 Kicad: Atom v2: tidying up
    [rgb-to-hdmi.kicad_pcb]
2019-04-10 Kicad: Atom v2: Added LEDs
    [rgb-to-hdmi.kicad_pcb, rgb-to-hdmi.sch]
2019-04-10 Kicad: Atom v2: Moved serial connector
    [rgb-to-hdmi.kicad_pcb, rgb-to-hdmi.sch]
2019-04-10 Kicad: Atom v2: Cleaned up silk screen
    [rgb-to-hdmi.kicad_pcb]
2019-04-10 Kicad: Atom v2: Swapped D1 and D2
    [rgb-to-hdmi.kicad_pcb]
2019-04-10 Kicad: Atom v2: Labelled serial connector
    [rgb-to-hdmi.kicad_pcb]
2019-04-10 Kicad: Atom v2: Added 3-pin test connector to CPLD, plus ground points
    [rgb-to-hdmi.kicad_pcb, rgb-to-hdmi.sch]
2019-04-10 Kicad: Atom v2: Fixed 3v3 ring
    [rgb-to-hdmi.kicad_pcb]
2019-04-10 Kicad: Atom v2: Added 2-pin test connector to CPLD
    [rgb-to-hdmi.kicad_pcb, rgb-to-hdmi.sch]
2019-04-10 Kicad: Atom v2: Added 2-pin test connector to Pi
    [rgb-to-hdmi.kicad_pcb, rgb-to-hdmi.sch]
2019-04-10 Kicad: Atom v2: Used a right angled tactile switch for reset
    [rgb-to-hdmi.kicad_pcb, rgb-to-hdmi.sch]
2019-04-10 Kicad: Atom v2: Corrected some 3D models
    [rgb-to-hdmi.kicad_pcb]
2019-04-10 Add capture folders and fix a bug with restore config
    [filesystem.c, filesystem.h, osd.c, rgb_to_hdmi.c]
2019-04-10 Kicad: Atom v2: Fixed some 3d models
    [rgb-to-hdmi.kicad_pcb]
2019-04-10 Remove invert setting from sampling menu & tweak save config messages
    [osd.c]
2019-04-10 Fix save config message bug
    [osd.c]
2019-04-11 Kicad: Atom v2: Moved IDC connector as much as possible
    [rgb-to-hdmi.kicad_pcb]
2019-04-11 Kicad: Atom v2: Added small plane for VCC
    [rgb-to-hdmi.kicad_pcb]
2019-04-11 Atom CPLD: Updated .ucf file for PCB v2
2019-04-11 Fix property order issue on file saving
    [filesystem.c]
2019-04-11 Kicad: Atom v2: Reduced board size to 77mm x 99mm
    [rgb-to-hdmi.kicad_pcb]
2019-04-11 Kicad: Atom v2: More scrunching up
    [rgb-to-hdmi.kicad_pcb]
2019-04-11 Kicad: Atom v2: More scrunching up (nearing the end...)
    [rgb-to-hdmi.kicad_pcb]
2019-04-11 Kicad: Atom v2: Reduced board size to 77mm x 98mm
    [rgb-to-hdmi.kicad_pcb]
2019-04-11 Kicad: Atom v2: Silk screen cleanup
    [rgb-to-hdmi.kicad_pcb]
2019-04-12 Kicad: Atom v2: Update board mounting holes to M2.5
    [rgb-to-hdmi.kicad_pcb, rgb-to-hdmi.sch]
2019-04-12 Kicad: Atom v2: Tighten corner notches to 1mm of posts
    [rgb-to-hdmi.kicad_pcb]
2019-04-12 Kicad: Atom v2: Added version to PCB
    [rgb-to-hdmi.kicad_pcb]
2019-04-12 Kicad: Atom v2: Aligned switches wrt PCB mount holes
    [rgb-to-hdmi.kicad_pcb]
2019-04-12 Kicad: Atom v2: Tweaked resistor positions around switches
    [rgb-to-hdmi.kicad_pcb]
2019-04-12 Kicad: Atom v2: Enlarged RV holes, so Bourns 3306P will fit
    [rgb-to-hdmi.kicad_pcb]
2019-04-12 Kicad: Atom v2: Reduced board size to 77mm x 97mm
    [rgb-to-hdmi.kicad_pcb]
2019-04-12 Kicad: Atom v2: Added alt position for J4
    [rgb-to-hdmi.kicad_pcb, rgb-to-hdmi.sch]
2019-04-12 Kicad: Atom v2: Added push button alignment holes for drilling panel
    [rgb-to-hdmi.kicad_pcb, rgb-to-hdmi.sch]
2019-04-12 Kicad: Atom v2: Tidy silk screen
    [rgb-to-hdmi.kicad_pcb]
2019-04-12 Kicad: Atom v2: Tidy silk screen; generate gerbers
    [rgb-to-hdmi.kicad_pcb]
2019-04-12 Kicad: Atom v2: Added manufacturing data
    [rgb-to-hdmi.gbl, rgb-to-hdmi.gbo, rgb-to-hdmi.gbs, rgb-to-hdmi.gtl, rgb-to-hdmi.gto, rgb-to-hdmi.gts]
2019-04-12 Kicad: Atom v2: Added missing footprint
2019-04-13 Kicad: Atom v2: Solder Mask Clearance/Width = 0.15mm/0.40mm
    [rgb-to-hdmi.kicad_pcb, rgb-to-hdmi.sch]
2019-04-13 Kicad: Atom v2: Final changes, added 0.1uF input cap for 3.3V regulator
    [rgb-to-hdmi.kicad_pcb, rgb-to-hdmi.sch]
2019-04-13 Kicad: Atom v2: Updated manufacturing data
    [AtomVideoToHDMI.gbl, AtomVideoToHDMI.gbo, AtomVideoToHDMI.gbs, AtomVideoToHDMI.gko, AtomVideoToHDMI.gtl, AtomVideoToHDMI.gto, AtomVideoToHDMI.gts, AtomVideoToHDMI.xln]
2019-04-13 Add output colour and invert
    [osd.c, osd.h, rgb_to_hdmi.c, rgb_to_hdmi.h]
2019-04-14 Fix white flash during calibration
    [osd.c, rgb_to_hdmi.c]
2019-04-14 Rework sync loss detection to fix ZX80/81 issue
    [rgb_to_hdmi.c]
2019-04-16 Auto size frame buffers for double width
2019-04-16 Workaround for frame buffer resizing issue
    [geometry.c, rgb_to_hdmi.c]
2019-04-16 Reduce menu widths to allow longer profile names & fix error introduced in fb adjustment
    [osd.c, rgb_to_hdmi.c]
2019-04-20 Genlock improvements, capture line code tidy up & double width vsync marker & debug lines fix
    [defs.h, osd.c, osd.h, rgb_to_fb.h, rgb_to_hdmi.c, rgb_to_hdmi.h]
2019-04-20 fix accidental reversion of https://github.com/hoglet67/RGBtoHDMI/commit/c431f237bae3d5f6a4dccacbe9b95252df56f726
    [rgb_to_hdmi.c]
2019-04-20 Switch 3/6bpp and 4/8bpp table selection logic
2019-04-20 Implement cpld->old_firmware_support() fixes: https://github.com/hoglet67/RGBtoHDMI/issues/68
    [cpld.h, cpld_atom.c, defs.h, geometry.c, osd.c, rgb_to_hdmi.c]
2019-04-21 Implement font size option. Addresses: https://github.com/hoglet67/RGBtoHDMI/issues/92
    [osd.c, osd.h, rgb_to_hdmi.c, rgb_to_hdmi.h]
2019-04-23 Revert back to percentage scale (81/100)
    [osd.c]
2019-04-24 Fix palette flash when navigating OSD
    [osd.c]
2019-04-24 Another osd flash fix
    [osd.c]
2019-04-24 Temporary workaround for 24Mhz mode 7 and Labyrinth
    [rgb_to_hdmi.c]
2019-04-25 Pi Firmware: Prevent autoswitch being engaged with the Atom CPLD (#91)
    [rgb_to_hdmi.c]
2019-04-26 Pi Firmware: Fix occasional/obscure loss of palette change mailbox message
    [osd.c, rgb_to_hdmi.c, rpi-mailbox-interface.c]
2019-04-26 Pi Firmware: Add back HDMI Calibration (short vs long press) (#49)
    [osd.c]
2019-04-26 Pi Firmware: Implemented configurable button actions (#66)
2019-04-28 Update property interface for FB to use 64x64 workaround
    [defs.h, rgb_to_hdmi.c]
2019-04-28 Pi Firmware: Fix a possible bug in gpclk_init when gpclk already running, tidy up CM constants
    [rgb_to_hdmi.c]
2019-04-29 Pi Firmware: Add ARM/VC memory to Useful Info
2019-04-29 Pi Firmware: Use 32MB alignment for frame buffer to work around bug with Pi 2/3
    [rgb_to_hdmi.c]
2019-04-29 Pi Firmware: Updated config.txt for Pi 2/3
    [config.txt, default_config.txt]
2019-04-29 Build: correct names a debug kernels in config files
    [config.txt, default_config.txt]
2019-04-30 Pi Firmware: Added a flush function to the UART driver
2019-04-30 Pi Firmware: Flush UART before changing PLLC rate
2019-04-30 Pi Firmware: fixed a bug in cpld_atom params
    [cpld_atom.c]
2019-05-02 Kicad: Atom v2: Added pdf schematic
2019-05-06 Sort profiles and resolutions. Addresses https://github.com/hoglet67/RGBtoHDMI/issues/103
    [filesystem.c]
2019-05-06 Allow CPLD driver to provide a default profile (#91)
2019-05-10 Atom CPLD: Added jedec file for Atom board
2019-05-15 Add capture area option and fix double size 4:3 scaling bug
    [geometry.c, geometry.h, osd.c, osd.h, rgb_to_hdmi.c]
2019-05-16 Switch order of maximum and minimum
2019-06-18 Pi Firmware: corrected newlines in XAPP058 debugging messages
    [micro.c]
2019-06-19 Pi Firmware: Switch from MODE7 to MUX for TDO
2019-10-18 First attempt at 6 bit PCB
    [rgb-to-hdmi.kicad_pcb, rgb-to-hdmi.sch]
2019-10-18 Fix incorrect in system programming GPIO assignments
    [rgb-to-hdmi.kicad_pcb, rgb-to-hdmi.sch]
2019-10-19 Move some vias to avoid shorting hazard with IDC cable
    [rgb-to-hdmi.kicad_pcb]
2019-10-19 Fix GND plane plus other minor tweaks
    [rgb-to-hdmi.kicad_pcb]
2019-10-20 Add gerbers
    [rgb-to-hdmi-B_Cu.gbl, rgb-to-hdmi-B_Mask.gbs, rgb-to-hdmi-B_SilkS.gbo, rgb-to-hdmi-Edge_Cuts.gm1, rgb-to-hdmi-F_Cu.gtl, rgb-to-hdmi-F_Mask.gts, rgb-to-hdmi-F_SilkS.gto, rgb-to-hdmi.drl]
2019-10-21 Swap JP4, change P3 side & add more silk screen info
    [rgb-to-hdmi-B_Cu.gbl, rgb-to-hdmi-B_Mask.gbs, rgb-to-hdmi-B_SilkS.gbo, rgb-to-hdmi-Edge_Cuts.gm1, rgb-to-hdmi-F_Cu.gtl, rgb-to-hdmi-F_Mask.gts, rgb-to-hdmi-F_SilkS.gto, rgb-to-hdmi.drl]
2019-10-21 Tweaks to vias and silk screen
    [rgb-to-hdmi-B_Cu.gbl, rgb-to-hdmi-B_Mask.gbs, rgb-to-hdmi-B_SilkS.gbo, rgb-to-hdmi-Edge_Cuts.gm1, rgb-to-hdmi-F_Cu.gtl, rgb-to-hdmi-F_Mask.gts, rgb-to-hdmi-F_SilkS.gto, rgb-to-hdmi.drl]
2019-10-22 Initial circuit for analog interface. Should support Amstrad CPC464, Spectrum+2A/3 and monochrome composite
    [analog.kicad_pcb, analog.sch]
2019-10-23 Add rough layout of components for 3d pcb view
    [analog.sch]
2019-10-24 Analog board updated with MAX9201, terminators and rough pcb layout
    [analog.kicad_pcb, analog.sch]
2019-11-10 Change DAC and use VSYNC as monochrome video input (requires V6.5 CPLD)
    [analog.kicad_pcb, analog.sch]
2019-11-12 Issue 2 rgbtohd board with 3 control bits added
    [rgb-to-hdmi.kicad_pcb, rgb-to-hdmi.sch]
2019-11-12 All tracks routed on analog board
    [analog.kicad_pcb, analog.sch]
2019-11-12 Fix some overlapping courtyards
    [analog.kicad_pcb]
2019-11-12 Add JP2, J4 & Groundplane
    [analog.kicad_pcb, analog.sch]
2019-11-13 Move 3 pin data header
    [rgb-to-hdmi.kicad_pcb]
2019-11-13 Move 3 pin data header + add silk screen
    [analog.kicad_pcb, analog.sch]
2019-11-13 Tweak ground plane
    [analog.kicad_pcb]
2019-11-14 Add P19 pin
    [rgb-to-hdmi.kicad_pcb, rgb-to-hdmi.sch]
2019-11-14 Add P19 pin and new jumpers
    [analog.kicad_pcb, analog.sch]
2019-11-15 Change DAC to TLC5620 and add software controllable termination
    [analog.kicad_pcb, analog.sch]
2019-11-15 Change analog switch
    [analog.kicad_pcb, analog.sch]
2019-11-15 Add second DAC footprint and change regulator
    [analog.kicad_pcb, analog.sch]
2019-11-17 Change CLK to CLKEN
    [rgb-to-hdmi.kicad_pcb, rgb-to-hdmi.sch]
2019-11-17 Add more config jumpers
    [analog.kicad_pcb, analog.sch]
2019-11-18 Move RGB connector
    [rgb-to-hdmi.kicad_pcb]
2019-11-18 Move RGB socket
    [analog.kicad_pcb, analog.sch]
2019-11-21 Six bit issue 2 pcb gerbers
    [rgb-to-hdmi-B_Cu.gbl, rgb-to-hdmi-B_Mask.gbs, rgb-to-hdmi-B_SilkS.gbo, rgb-to-hdmi-Edge_Cuts.gm1, rgb-to-hdmi-F_Cu.gtl, rgb-to-hdmi-F_Mask.gts, rgb-to-hdmi-F_SilkS.gto, rgb-to-hdmi.drl]
2019-11-21 Tidy analog folder
    [analog.sch]
2019-11-21 Change comparators to MAX9144 or MAX9108, finalise gerbers and rename project path
    [analog-B_Cu.gbl, analog-B_Mask.gbs, analog-B_SilkS.gbo, analog-Edge_Cuts.gm1, analog-F_Cu.gtl, analog-F_Mask.gts, analog-F_SilkS.gto, analog.drl]
2019-11-25 Add new resolutions and fix scaling bug
    [geometry.c, rgb_to_hdmi.c]
2019-11-25 Add resolution change warning, change config.txt and fix bug in osd update
    [config.txt]
2019-11-26 Add calibration to main menu and confirmation to restore default
2019-11-26 Fix issue with osd bank selection in mode 7 & change DAC levels in TTL mode
    [rgb_to_hdmi.c]
2019-11-27 Add screencap scaling and rename capture size as source size to avoid confusion
    [filesystem.c, geometry.c, geometry.h, osd.c]
2019-11-28 Fix typo in menu item label
    [osd.c]
2019-11-30 Improve scaling, change source size to overscan, add spectrum palettes, add setup modes, add info to calibration summary
2019-12-02 Fix enum and parameter names
    [geometry.c, geometry.h]
2019-12-03 New version of Atom YUV CPLD to work with 6 bit board (includes invert bit for 6847 direct connection)
    [RGBtoHDMI.ucf, RGBtoHDMI.vhdl]
2019-12-03 Update software to support Atom and 6847 in general on 6 bit board
2019-12-04 New driver for yuv6847 CPLD
2019-12-04 Support for new driver. Also split profiles into separate folders for each CPLD
2019-12-04 Fix Vsync detection bug
    [rgb_to_hdmi.c]
2019-12-04 Add Pi temp/voltage to info menu
2019-12-04 Update defaults
    [config.txt, default_config.txt]
2019-12-04 New 6 bit RGB CPLD with analog board auto detect
2019-12-04 Update YUV CPLD for 6 bit board
2019-12-04 Update YUV CPLD for 6 bit board #2
2019-12-04 Change "frontend" to "interface". Also fix cosmetic issue during calibration
    [cpld_atom.c, cpld_yuv.c, osd.c]
2019-12-05 Generate the three cpld_rgb drivers from a single source file
2019-12-06 First attempt at RGB/YUV board with clamp
    [analog.kicad_pcb, analog.sch]
2019-12-07 Terminator and decoupling caps added plus pcb layout
    [analog.kicad_pcb, analog.sch]
2019-12-08 Fix screencaps in 4bpp mode such as mode 7
    [filesystem.c]
2019-12-08 Issue 2 analog board with MAX 5259
    [analog.sch]
2019-12-08 Issue 2 analog board part2
    [analog-B_Cu.gbl, analog-B_Mask.gbs, analog-B_SilkS.gbo, analog-Edge_Cuts.gm1, analog-F_Cu.gtl, analog-F_Mask.gts, analog-F_SilkS.gto, analog.drl]
2019-12-08 rename to kicad_analog_6bit
    [analog-B_Cu.gbl, analog-B_Mask.gbs, analog-B_SilkS.gbo, analog-Edge_Cuts.gm1, analog-F_Cu.gtl, analog-F_Mask.gts, analog-F_SilkS.gto, analog.drl]
2019-12-08 Fix screencap fractional scaling
    [filesystem.c, geometry.c]
2019-12-08 Fix for 4 bit screencap with odd numbered frame buffer width
    [filesystem.c]
2019-12-08 Add small overscan for cases where integer scaling doesn't quite fit
    [rgb_to_hdmi.c]
2019-12-10 Add pixel aspect ratio enforcement and fix pi overscan bug
    [geometry.c, geometry.h, osd.c, rgb_to_hdmi.c]
2019-12-12 Add h and v out of tolerance detection to cope with Oric startup also inhibit Vsync when analog board connected
    [cpld_rgb.c, rgb_to_hdmi.c]
2019-12-12 Add vertical capture range clipping to avoid capturing during vsync
    [geometry.c, rgb_to_hdmi.c, rgb_to_hdmi.h]
2019-12-12 Fix off by 1 error in info
    [rgb_to_hdmi.c]
2019-12-16 YUV CPLD updated to V3.1 for combined RGB/YUV board
2019-12-17 Update common VHDL with support for new RGB/YUV board (RGB7.1 / YUV3.1)
2019-12-17 Add support for new RGB/YUV board
2019-12-20 Fix interlaced bug in sync time measurement
    [rgb_to_hdmi.c]
2019-12-21 Add more info in calibration summary
2019-12-22 Fix MAX_CPLD_FILENAMES again (incorrect merge?)
    [defs.h]
2019-12-22 Split calibration summary menu
2019-12-22 Fix mode 7 uneven scaling bug
    [geometry.c, osd.c, rgb_to_hdmi.c]
2019-12-22 Improve mode7 fix to work at all resoloutions
    [geometry.c, osd.c]
2019-12-23 Fix Pi overscan calculation bug
    [rgb_to_hdmi.c]
2019-12-23 Fix Pi overscan bug properly
    [rgb_to_hdmi.c]
2019-12-28 vhdl_YUV: fix recent bug in filtering (v5.2)
    [RGBtoHDMI.vhdl]
2019-12-30 vhdl_YUV: fix hang when sync threshold too low (v5.8)
    [RGBtoHDMI.vhdl]
2019-12-31 Fix issue with equivalence table on original Atom board
    [osd.c]
2019-12-31 vhdl_YUV: rework design: 71 -> 63 macro cells (v5.9)
    [RGBtoHDMI.vhdl]
2019-12-31 vhdl_YUV: rework design: 63 -> 57 macro cells (v5.A)
    [RGBtoHDMI.vhdl]
2019-12-31 vhdl_YUV: Add sync edge and delay to scan chain (v6.0)
2019-12-31 vhdl_YUV: Revert to original clamp timing (v6.1)
    [RGBtoHDMI.vhdl]
2020-01-04 YUV CPLD V7.0 with adjustable clamp
2020-01-04 Add support for YUV cpld v7.0 with adjustable clamp and add confirmation to cpld update
2020-01-05 Fix save profile bug that sometimes stopped changes from being saved
    [filesystem.c]
2020-01-05 Update Atom 50Hz TTL profiles
2020-01-05 YUV CPLD v7.1 with improved clamping times
2020-01-05 YUV CPLD v7.2 with further increased clamping times.
2020-01-06 vhdl_YUV: Pipeline the sample signals to reduce the product terms (v7.3)
2020-01-06 vhdl_YUV: Make each clamping interval identical (128 clocks) (v7.4)
2020-01-06 vhdl_YUV: Express clamp_counter more efficiently (v7.5)
2020-01-06 Add Auto clamp type option
2020-01-09 Fix sync not detected issue
    [geometry.c]
2020-01-09 Fix spectrum palette regression
    [osd.c]
2020-01-09 vhdl_YUV: Extend offset to 7 bits and eliminate fixed delay (v8.0)
    [RGBtoHDMI.vhdl, cpld_yuv.c]
2020-01-10 vhdl_YUV: Fix sync dection bug when sync out of range (v8.1)
    [RGBtoHDMI.vhdl]
2020-01-10 Pi Firmware: Compensate for fixed delay in YUV CPLD versions < 8
    [cpld_yuv.c]
2020-01-11 Fix menu corruption when changing overscan in mode 7. Also add border colour in setup modes
    [geometry.c, rgb_to_hdmi.c]
2020-01-11 Fix issue with screen captures when OSD enabled
    [geometry.c]
2020-01-12 Tweak screen capture in menus to show correct cursor position
    [osd.c]
2020-01-15 Fix scaling bug, limit uneven scaling to 3:2, change some menu names
    [cpld_rgb.c, cpld_yuv.c, filesystem.c, geometry.c, osd.c]
2020-01-15 Fix capture_id not correct after profile change
    [filesystem.c]
2020-01-28 Add multiple Pi support at any CPU frequency also fix issue with PLLA on Pi2/3
    [config.txt, default_config.txt]
2020-02-03 Fix equivalence lookup in 4bpp mode
    [osd.c]
2020-02-03 Fix osd mask with equivalences & teletext sync length
    [rgb_to_hdmi.c]
2020-02-04 Shorten some palette names
    [osd.c]
2020-02-04 config.txt: run Pi3+ at 1200MHz
    [config.txt, default_config.txt]
2020-02-07 Write cpld type to volume ID to recover from programming failure
    [cpld_null.c, cpld_null.h, filesystem.c, filesystem.h, osd.c, rgb_to_hdmi.c]
2020-02-07 Detect that RGB cpld has been programmed into BBC board and fail safely
    [osd.c, rgb_to_hdmi.c]
2020-02-07 Set mux = 1 during vsync detection to keep clamp pulses active
2020-02-08 BBC CPLD v6.6 rebuilt; RGB CPLD v7.2: remove swap_bits
    [RGBtoHDMI.vhdl]
2020-02-08 Change value of R5 from 2K2 to 10K
    [rgb-to-hdmi.kicad_pcb, rgb-to-hdmi.sch]
2020-02-08 vhdl_atom: removed v1 ucf file to avoid confusion, all boards are v2
    [RGBtoHDMI.ucf]
2020-02-08 Remove OLD config/cmdline files that are not needed in git
    [OLD config.txt]
2020-02-09 Profiles: Tested OBBC/BBC Atom profiles agains Prime's Colour Board
2020-02-10 Change RN1&2 to 4K7
    [rgb-to-hdmi.kicad_pcb, rgb-to-hdmi.sch]
2020-02-11 Support renamed profile folders & fix termination on/off
    [cpld_rgb.c, cpld_yuv.c, osd.c]
2020-02-11 Fix hang when h pixel aspect = 0 and v pixel aspect = 0 in geometry menu
    [geometry.c]
2020-02-12 Save separate frontend setting for each CPLD
    [config.txt]
2020-02-14 Force clock tolerance to 0 in all setup modes
    [geometry.c]
2020-02-22 Add new input coupling option with AC/DC 75R & high impedance combinations. Also support issue 2 & 3 analog board
    [cpld_rgb.c, cpld_yuv.c, osd.c, osd.h]
2020-02-22 New 6/8 bit Issue 3 'Hat' using CPLD pins previously connected to switches
    [rgb-to-hdmi-B_Cu.gbl, rgb-to-hdmi-B_Mask.gbs, rgb-to-hdmi-B_SilkS.gbo, rgb-to-hdmi-Edge_Cuts.gm1, rgb-to-hdmi-F_Cu.gtl, rgb-to-hdmi-F_Mask.gts, rgb-to-hdmi-F_SilkS.gto, rgb-to-hdmi.drl]
2020-02-22 New 6/8 bit Issue 3 analog board with AC/DC switch and optional enhanced U/V discrimination
    [analog.kicad_pcb, analog.sch]
2020-02-22 Reorder input coupling so AC/DC switching works without passing through termination
2020-02-22 Update V3 hat pcb
    [rgb-to-hdmi.kicad_pcb, rgb-to-hdmi.sch]
2020-02-23 Fix issue with loss of sync detection with noise / crosstalk on sync inputs
    [defs.h]
2020-02-24 Add IDC header for analog input
    [analog.kicad_pcb, analog.sch]
2020-02-25 Add template version of Issue 3 board
    [rgb-to-hdmi-B_Cu.gbl, rgb-to-hdmi-B_Mask.gbs, rgb-to-hdmi-B_SilkS.gbo, rgb-to-hdmi-Edge_Cuts.gm1, rgb-to-hdmi-F_Cu.gtl, rgb-to-hdmi-F_Mask.gts, rgb-to-hdmi-F_SilkS.gto, rgb-to-hdmi.drl]
2020-02-26 Update 6/8 bit pcbs
    [rgb-to-hdmi-B_Cu.gbl, rgb-to-hdmi-B_Mask.gbs, rgb-to-hdmi-B_SilkS.gbo, rgb-to-hdmi-Edge_Cuts.gm1, rgb-to-hdmi-F_Cu.gtl, rgb-to-hdmi-F_Mask.gts, rgb-to-hdmi-F_SilkS.gto, rgb-to-hdmi.drl]
2020-02-27 Update V3
    [analog.kicad_pcb, analog.sch]
2020-02-28 Update V3 6/8 bit hat (standard version)
    [rgb-to-hdmi-B_Cu.gbl, rgb-to-hdmi-B_Mask.gbs, rgb-to-hdmi-B_SilkS.gbo, rgb-to-hdmi-Edge_Cuts.gm1, rgb-to-hdmi-F_Cu.gtl, rgb-to-hdmi-F_Mask.gts, rgb-to-hdmi-F_SilkS.gto, rgb-to-hdmi.drl]
2020-02-28 Update V3 6/8 bit hat (template version)
    [rgb-to-hdmi-B_Cu.gbl, rgb-to-hdmi-B_Mask.gbs, rgb-to-hdmi-B_SilkS.gbo, rgb-to-hdmi-Edge_Cuts.gm1, rgb-to-hdmi-F_Cu.gtl, rgb-to-hdmi-F_Mask.gts, rgb-to-hdmi-F_SilkS.gto, rgb-to-hdmi.drl]
2020-02-28 Update V3 analog interface with 6 way IDC support.
    [analog-B_Cu.gbl, analog-B_Mask.gbs, analog-B_SilkS.gbo, analog-Edge_Cuts.gm1, analog-F_Cu.gtl, analog-F_Mask.gts, analog-F_SilkS.gto, analog.drl]
2020-02-28 Add new TTL buffer with 6 way connector compatible with the analog board
    [buffer-B_Cu.gbl, buffer-B_Mask.gbs, buffer-B_SilkS.gbo, buffer-Edge_Cuts.gm1, buffer-F_Cu.gtl, buffer-F_Mask.gts, buffer-F_SilkS.gto, buffer.drl]
2020-02-28 Update TTL buffer
    [buffer-B_Cu.gbl, buffer-B_Mask.gbs, buffer-B_SilkS.gbo, buffer-Edge_Cuts.gm1, buffer-F_Cu.gtl, buffer-F_Mask.gts, buffer-F_SilkS.gto, buffer.drl]
2020-02-28 Update gerbers
    [analog-B_Cu.gbl, analog-B_Mask.gbs, analog-B_SilkS.gbo, analog-Edge_Cuts.gm1, analog-F_Cu.gtl, analog-F_Mask.gts, analog-F_SilkS.gto, analog.drl]
2020-02-28 Add gerber zip
2020-02-28 Update TTL V1 board
    [buffer-B_Cu.gbl, buffer-B_Mask.gbs, buffer-B_SilkS.gbo, buffer-Edge_Cuts.gm1, buffer-F_Cu.gtl, buffer-F_Mask.gts, buffer-F_SilkS.gto, buffer.drl]
2020-02-28 Update analog V3 board
    [analog-B_Cu.gbl, analog-B_Mask.gbs, analog-B_SilkS.gbo, analog-Edge_Cuts.gm1, analog-F_Cu.gtl, analog-F_Mask.gts, analog-F_SilkS.gto, analog.drl]
2020-02-28 Extend P4 pads on analog board
    [analog-B_Cu.gbl, analog-B_Mask.gbs, analog-B_SilkS.gbo, analog-Edge_Cuts.gm1, analog-F_Cu.gtl, analog-F_Mask.gts, analog-F_SilkS.gto, analog.drl]
2020-02-28 Extend P4 pads on TTL board
    [analog-B_Cu.gbl, analog-B_Mask.gbs, analog-B_SilkS.gbo, analog-Edge_Cuts.gm1, analog-F_Cu.gtl, analog-F_Mask.gts, analog-F_SilkS.gto, analog.drl]
2020-02-28 Add gerber zips
2020-03-01 Update 6/8 bit boards with identity resistor
    [rgb-to-hdmi-B_Cu.gbl, rgb-to-hdmi-B_Mask.gbs, rgb-to-hdmi-B_SilkS.gbo, rgb-to-hdmi-Edge_Cuts.gm1, rgb-to-hdmi-F_Cu.gtl, rgb-to-hdmi-F_Mask.gts, rgb-to-hdmi-F_SilkS.gto, rgb-to-hdmi.drl]
2020-03-07 Fix sync timing issues
    [defs.h, rgb_to_hdmi.c]
2020-03-10 Revert sync loss counter
    [cpld_rgb.c, cpld_yuv.c, defs.h]
2020-03-10 Remove 'INFO:' from logging and reduce lock status logging to 6 chars+CR/LF so it will fit in the 8 char mini uart transmit FIFO
2020-03-16 Fix default resolution and scaling settings and add 800x480 resolutions
    [osd.c, rgb_to_hdmi.c]
2020-03-16 Fix issue 1 analog board termination
    [cpld_rgb.c]
2020-03-16 Fix incorrect horizontal size and double size setting at low resolutions such as 640x480 & 800x480
    [geometry.c]
2020-03-17 Fix overscan calculation error at some resolutions
    [geometry.c, rgb_to_hdmi.c]
2020-03-19 Rename HDMI Calibration to Enable Genlock
2020-03-30 Add screencap size & reboot on no HDMI
    [filesystem.c, geometry.c, osd.c, osd.h, rgb_to_hdmi.c]
2020-03-30 V3 case drilling layout
    [rgb-to-hdmi-B_Cu.gbl, rgb-to-hdmi-B_Mask.gbs, rgb-to-hdmi-B_SilkS.gbo, rgb-to-hdmi-Edge_Cuts.gm1, rgb-to-hdmi-F_Cu.gtl, rgb-to-hdmi-F_Mask.gts, rgb-to-hdmi-F_SilkS.gto, rgb-to-hdmi.drl]
2020-03-30 remove oldv3
    [rgb-to-hdmi.kicad_pcb, rgb-to-hdmi.sch]
2020-03-30 Update 3 bit buffer layout
    [buffer-B_Cu.gbl, buffer-B_Mask.gbs, buffer-B_SilkS.gbo, buffer-Edge_Cuts.gm1, buffer-F_Cu.gtl, buffer-F_Mask.gts, buffer-F_SilkS.gto, buffer.drl]
2020-03-30 6 bit buffer layout
    [buffer-B_Cu.gbl, buffer-B_Mask.gbs, buffer-B_SilkS.gbo, buffer-Edge_Cuts.gm1, buffer-F_Cu.gtl, buffer-F_Mask.gts, buffer-F_SilkS.gto, buffer.drl]
2020-03-30 8 bit buffer layout
    [buffer-B_Cu.gbl, buffer-B_Mask.gbs, buffer-B_SilkS.gbo, buffer-Edge_Cuts.gm1, buffer-F_Cu.gtl, buffer-F_Mask.gts, buffer-F_SilkS.gto, buffer.drl]
2020-03-30 PC buffer layout
    [buffer-B_Cu.gbl, buffer-B_Mask.gbs, buffer-B_SilkS.gbo, buffer-Edge_Cuts.gm1, buffer-F_Cu.gtl, buffer-F_Mask.gts, buffer-F_SilkS.gto, buffer.drl]
2020-03-30 remove old TTL layout
    [buffer-B_Cu.gbl, buffer-B_Mask.gbs, buffer-B_SilkS.gbo, buffer-Edge_Cuts.gm1, buffer-F_Cu.gtl, buffer-F_Mask.gts, buffer-F_SilkS.gto, buffer.drl]
2020-04-02 Fix rounding error with chars_per_line
    [geometry.c]
2020-04-09 Fix HDMI not working on bootup with some SD cards
    [geometry.c, rgb_to_hdmi.c]
2020-04-10 Update 6 bit buffer
    [buffer-B_Cu.gbl, buffer-B_Mask.gbs, buffer-B_SilkS.gbo, buffer-Edge_Cuts.gm1, buffer-F_Cu.gtl, buffer-F_Mask.gts, buffer-F_SilkS.gto, buffer.drl]
2020-04-10 Update 8 bit buffer
    [buffer-B_Cu.gbl, buffer-B_Mask.gbs, buffer-B_SilkS.gbo, buffer-Edge_Cuts.gm1, buffer-F_Cu.gtl, buffer-F_Mask.gts, buffer-F_SilkS.gto, buffer.drl]
2020-04-26 Fix clipping error with chars per line and add pitch size to source summary
    [geometry.c, rgb_to_hdmi.c]
2020-05-04 kicad: Added PDF schematic of 3-bit board
2020-05-04 kicad: Added PDF schematic of 6-bit board
2020-05-04 kicad: Added PDF schematic of V3 analog board
2020-05-21 Fix scanlines when NTSC artifacting
    [osd.c]
2020-05-21 Additional NTSC scanline fix
    [osd.c]
2020-05-26 Add CPLD erase function by deleting file (no button presses required)
2020-05-26 Fix Configuration restored message
    [rgb_to_hdmi.c]
2020-06-23 Update RGB CPLD to inhibit clamp pulse in DC mode
2020-06-24 Update YUV CPLD: Remove UV Filter, add clamp disable, Sync source switch and 4 level YUV support
2020-07-02 Add support for M62364 DAC on new analog board
2020-07-06 Change PAL switch to behave differently in 3 and 4 level modes
2020-07-07 Add colour burst detection to auto switch NTSC artifact on/off
2020-07-07 Fix NTSC artifact disable bug
    [osd.c, rgb_to_hdmi.c]
2020-07-09 Fix display of final calibration value in YUV mode
    [cpld_yuv.c]
2020-07-11 Add flywheel vertical sync to eliminate vertical jitter caused by thermal drift of vsyncs generated by RC monostables
    [defs.h, geometry.c, geometry.h, rgb_to_fb.h, rgb_to_hdmi.c]
2020-07-12 Fix scaling issue when h or v offsets went negative
    [geometry.c]
2020-07-14 Add Commodore 64 support and tweak vertical sync jitter correction
    [geometry.c, osd.c, osd.h, rgb_to_fb.h, rgb_to_hdmi.c]
2020-07-15 Improve NTSC artifact auto switching
2020-07-16 Fix issue with h scaling on widescreens
    [geometry.c]
2020-07-19 Remove recalibration on lock fail (not required as continuous recalibration)
    [rgb_to_hdmi.c]
2020-07-26 Rework overscan setting into zoom option 0%-100% in 10% steps (interpolation only) Also rename scaling settings
    [geometry.c, osd.c, osd.h, rgb_to_hdmi.c]
2020-07-27 Add 12BPP capture & 16BPP frame buffer support
2020-07-27 Fix some bugs with 12 BPP capture
    [cpld_yuv.c, osd.c]
2020-07-27 Rework osd responsiveness changes
    [osd.c, osd.h]
2020-07-30 Add interlaced video support and improve 12 bit capture / 16BPP frame buffer
2020-08-06 Adapter board to attach the RPi to the Amiga's Denise chip.
    [deniseadapter.kicad_pcb, deniseadapter.sch]
2020-08-07 Initial support for c0pperdragon's Amiga board
2020-08-10 Fix simple board detection, sync detection and yuv offset bugs
    [cpld_yuv.c, rgb_to_hdmi.c]
2020-08-11 Set pullups / pulldowns for key switches and auto detect pins
2020-08-11 Fix font selection bug
    [osd.c]
2020-08-13 Add switch connector and slightly re-arrange xor gates
    [deniseadapter.kicad_pcb, deniseadapter.sch]
2020-08-13 Add single button menu operation option
2020-08-13 User GPIO 16 for the button. Create gerber files.
    [deniseadapter.kicad_pcb, deniseadapter.sch]
2020-08-13 Add button reverse option for single button mode
    [osd.c]
2020-08-14 Add one button mode file
2020-08-18 Fix interpolated scaling issue with 720x576 mode
    [geometry.c]
2020-08-18 Add divider workaround for v7.5 cpld
    [cpld_rgb.c]
2020-08-22 Fix high pixel rate HDMI outputs like 2560x1440
    [defs.h, geometry.c, osd.c, osd.h, rgb_to_hdmi.c]
2020-08-23 Only filter equalising pulses in interlaced vsync mode
2020-09-01 Add screencap option to single button mode
2020-09-01 Add vertical stretch option & tweak one button mode
2020-09-07 Fix hsync timing calculation
    [rgb_to_hdmi.c]
2020-09-07 Add 12 bit pcb design
    [rgb-to-hdmi.csv, rgb-to-hdmi.kicad_pcb, rgb-to-hdmi.sch]
2020-09-07 Add 12 bit extender board
    [buffer-B_Cu.gbl, buffer-B_Mask.gbs, buffer-B_SilkS.gbo, buffer-Edge_Cuts.gm1, buffer-F_Cu.gtl, buffer-F_Mask.gts, buffer-F_SilkS.gto, buffer.drl]
2020-09-08 Fix some screencap bugs
    [filesystem.c, geometry.c]
2020-09-09 Add scanline inhibit message and fix double width screencap issue
    [geometry.c, osd.c]
2020-09-12 Fix capture scaling issue
    [geometry.c]
2020-09-13 Hide Issue 1 & 2 analog board support
    [cpld_rgb.c, cpld_yuv.c, osd.c]
2020-09-15 Move single button mode detection to default.txt
2020-09-15 Rename Overscan to Crop Border and V adjust to Swap Aspect
    [osd.c]
2020-09-15 Fix screencap crash bug
    [filesystem.c]
2020-09-16 Restore analog board selection except for issue 4
    [cpld_rgb.c, cpld_yuv.c, osd.c, osd.h]
2020-09-18 Fix inverted clock edge detection in simple mode
    [cpld_simple.c]
2020-09-20 Force AC coupling with Issue 1 & 2 analog boards
    [cpld_rgb.c, cpld_yuv.c]
2020-09-22 Fix auto profile switching with composite sync
    [osd.c]
2020-09-22 Amiga adapter with support for SuperDenise
    [deniseadapter.kicad_pcb, deniseadapter.sch]
2020-09-22 Tweak auto refresh setting
    [config.txt]
2020-09-23 Fix sync polarity detection with sync on Y/G
    [cpld_rgb.c, cpld_yuv.c]
2020-09-23 Change SW1 power on resolution recovery in simple mode
2020-09-23 Update pi frame rate message
2020-09-26 Read EDID info to determine 50Hz support
2020-09-28 Update EDID and auto 50Hz support
2020-09-29 Fix CPLD recovery mode key scan
    [rgb_to_hdmi.c]
2020-09-29 Fix timing issue with EGA vsync detection
    [cpld_rgb.c]
2020-09-30 Remove framedrop leeway
2020-09-30 Update labyrinth workaround for 12 Mhz divider set to 6
    [rgb_to_hdmi.c]
2020-09-30 Fix "all offsets" issues
    [cpld_rgb.c, cpld_yuv.c]
2020-09-30 Don't update DACs when switching to Vsync
2020-10-02 Limit CPLD clock to 200Mhz and lowest auto display frequency to 48Hz
2020-10-02 Update RGB V7 VHDL to fix mux bug
    [RGBtoHDMI.vhdl]
2020-10-03 Fix problem with 16bpp frame buffer in CPLD recovery mode
    [rgb_to_hdmi.c]
2020-10-03 Fix status line in recovery menu
    [rgb_to_hdmi.c]
2020-10-03 Fix 3 bit firmware folder issue
    [osd.c]
2020-10-03 Fix half pixel bit setting with V9 cpld
    [cpld_rgb.c, rgb_to_hdmi.c]
2020-10-04 Disable clamp signal in TTL 1 bit mode
2020-10-04 Fix some issues with mode 7 calibration on V9 CPLD and with x6 multiplier & update some text
    [cpld_atom.c, cpld_rgb.c, cpld_yuv.c]
2020-10-04 Workaround calibration issue with very overclocked CPLD
    [cpld_rgb.c]
2020-10-04 Improve 24Mhz mode 7 auto calibration
2020-10-05 Update Electron profiles including mux setting on 3 bit board
2020-10-06 Rework continuous calibration to use absolute rather than relative updates which caused problems due to rounding errors
    [rgb_to_hdmi.c]
2020-10-07 Improvements to continuous calibration
2020-10-08 Fix some problems with continuous calibration
    [defs.h, rgb_to_hdmi.c]
2020-10-10 Fix hang when displaying Calibration Summary in 12BPP mode
    [cpld_rgb.c, cpld_yuv.c]
2020-10-11 Add 50Hz monitor test option
2020-10-11 Add confirmation keypress to 50Hz test
2020-10-11 Add further info to test 50Hz menu
2020-10-12 Change acceptable vsync window from fixed 10uS to vsync_comparison_lo & vsync_comparison_hi
    [rgb_to_hdmi.c]
2020-10-13 Fix scaling reboot bug
    [rgb_to_hdmi.c]
2020-10-13 Limit 50hz support on pre 2010 monitors except HP
2020-10-14 Improvements to 50Hz test menu and scaling/resolution settings
2020-10-14 Comment out debug messages in genlock loop - caused frame drops & reinitialisation when in debug build
2020-10-15 Reduce continuous calibration average from 250 to 125 frames
2020-11-03 Add support for BBC CPLD 7.8 & RGB CPLD 9.2 + new analog board with BU2506 DAC
2020-11-03 Fix screencap with interlaced sources
    [osd.c, rgb_to_hdmi.c]
2020-11-04 Fix osd issue with interlaced video
    [rgb_to_hdmi.c]
2020-11-04 Update 12 bit extender to V2
    [buffer-B_Cu.gbl, buffer-B_Mask.gbs, buffer-B_SilkS.gbo, buffer-Edge_Cuts.gm1, buffer-F_Cu.gtl, buffer-F_Mask.gts, buffer-F_SilkS.gto, buffer.drl]
2020-11-04 Update PC buffer to V2
    [buffer-B_Cu.gbl, buffer-B_Mask.gbs, buffer-B_SilkS.gbo, buffer-Edge_Cuts.gm1, buffer-F_Cu.gtl, buffer-F_Mask.gts, buffer-F_SilkS.gto, buffer.drl]
2020-11-05 Fix some issues with CPLD version detection
    [cpld_rgb.c, rgb_to_hdmi.c]
2020-11-07 Hide 9 & 12 bit samples in analog mode
2020-11-08 Add Issue 5 analog board driver to YUV mode
    [cpld_yuv.c]
2020-11-08 Fix calibration logging
2020-11-10 Allow +-1 line when autoswitch matching frame length
2020-11-12 Fix main menu single button issue
    [osd.c]
2020-11-12 Fix issue with clock tolerance compensation code
    [rgb_to_hdmi.c]
2020-11-15 Add issue 4 manufacturing files
    [rgb-to-hdmi-B_Cu.gbl, rgb-to-hdmi-B_Mask.gbs, rgb-to-hdmi-B_SilkS.gbo, rgb-to-hdmi-Edge_Cuts.gm1, rgb-to-hdmi-F_Cu.gtl, rgb-to-hdmi-F_Mask.gts, rgb-to-hdmi-F_SilkS.gto, rgb-to-hdmi.drl]
2020-11-16 Added PDF schematics for 12-bit interface and 12-bit extended
2020-11-23 Fix issue with incorrect clipping of offsets when multiplier changed
    [cpld_rgb.c]
2020-11-24 Fix issue with odd/even sampling & support latest BBC cpld
    [cpld_rgb.c, defs.h]
2020-11-25 Fix final error display + minor logging issue
    [cpld_rgb.c]
2020-12-09 Fix issue with 8uS hsync pulses on BBC micro (Starquake)
    [rgb_to_fb.h, rgb_to_hdmi.c]
2020-12-13 Denise Adapter without IC sockets for installation with soldered wires.
    [deniseadapter.kicad_pcb, deniseadapter.sch]
2020-12-14 Add DAC volt values
2021-01-02 Rework NTSC artifact code
    [geometry.c, osd.c, rgb_to_hdmi.c]
2021-01-08 Add HDMI mode setting
    [config.txt, default_config.txt]
2021-01-09 Add option to disable resolution status message on power up
2021-01-09 Update swap aspect option
    [geometry.c]
2021-01-11 Fix timing calculation when cpu speed changed
    [rgb_to_hdmi.c]
2021-01-11 Add files via upload
    Add BOM
    [deniseadapter_bom.ods]
2021-01-12 Remove requirement for default_config.txt
    [config.txt, default_config.txt]
2021-01-13 further fix for cpu speed time calculations
    [rgb_to_hdmi.c]
2021-01-14 Fix issue with 1440(1920) mode
    [geometry.c, osd.c, rgb_to_hdmi.c, rgb_to_hdmi.h]
2021-01-14 Fix issue with refresh not saving
    [osd.c]
2021-01-19 Fail more gracefully if sub-profile default.txt missing
    [filesystem.c, osd.c]
2021-01-19 Fix overscan update bug
    [rgb_to_hdmi.c]
2021-01-19 Display interface info on powerup & system status + missing default.txt bugfixes
    [filesystem.c, osd.c, osd.h, rgb_to_hdmi.c]
2021-01-19 Hide interface setting & stop button reverse saving
    [defs.h, osd.c]
2021-01-20 Fix saved config issue
    [rgb_to_hdmi.c]
2021-01-22 Increase frame timeout
2021-01-30 Test for increased pixel width during mode 7 calibration
2021-01-31 Improve speed of 12bpp diff calculation during calibration
2021-02-02 Atari ST unbuffered pickup
    [atari-pickup-B_Cu.gbr, atari-pickup-B_Mask.gbr, atari-pickup-B_SilkS.gbr, atari-pickup-Edge_Cuts.gbr, atari-pickup-F_Cu.gbr, atari-pickup-F_Mask.gbr, atari-pickup-F_SilkS.gbr, atari-pickup.drl]
2021-02-02 Atari ST buffered pickup
    [atari-pickup-B_Cu.gbr, atari-pickup-B_Mask.gbr, atari-pickup-B_SilkS.gbr, atari-pickup-Edge_Cuts.gbr, atari-pickup-F_Cu.gbr, atari-pickup-F_Mask.gbr, atari-pickup-F_SilkS.gbr, atari-pickup.drl]
2021-02-06 Initial add of Amiga video slot adapter board
    [videoslotadapter.kicad_pcb, videoslotadapter.sch]
2021-02-06 Fix restore config not working with alt profiles
    [filesystem.c, filesystem.h, osd.c]
2021-02-06 Fix screencap osd issue
    [osd.c]
2021-03-05 add interactive bom
2021-04-14 V1.01 layout updates to inlcude 47pf capacitor, ground extra floating pins on U5
    [videoslotadapter.kicad_pcb, videoslotadapter.sch]
2021-04-17 Fix single button mode not working in CPLD recovery mode
    [cpld_null.c]
2021-04-17 Add separate recovery mode for 8 & 12 bit boards
2021-04-17 Fix osd not updating sometimes in 16bpp mode
    [rgb_to_hdmi.c]
2021-04-17 Fix erasing CPLD hang
    [rgb_to_hdmi.c]
2021-04-20 Amiga buffered pickup board for external RGBtoHDMI
    [Amiga_External-B_Cu.gbr, Amiga_External-B_Mask.gbr, Amiga_External-B_Paste.gbr, Amiga_External-B_SilkS.gbr, Amiga_External-Edge_Cuts.gbr, Amiga_External-F_Cu.gbr, Amiga_External-F_Mask.gbr, Amiga_External-F_Paste.gbr]
2021-04-27 Add extra Amiga profiles for 50Hz with NTSC crystal
2021-05-04 Add experimental HDMI DPMS support
    [config.txt]
2021-05-04 Add RGBI Laser 128 & Apple X-RGB palettes
2021-05-06 Add Laser 128 profile
2021-05-07 Fix divider setting bug
    [cpld_yuv.c]
2021-05-13 Add grey screen detection (Amiga) & fix Invert Y bug
    [defs.h, geometry.c, osd.c, rgb_to_hdmi.c, rgb_to_hdmi.h]
2021-05-13 Palette fix for NTSC ARTIFACT
    [osd.c]
2021-05-18 Update Laser128 profile
2021-05-20 Fix horizontal double pixel when hscale is an odd number (x3, x5 etc)
    [rgb_to_hdmi.c]
2021-05-21 Rework NTSC artifact detection and add auto artifact for Tandy coco 1 & 2
    [defs.h, osd.c]
2021-05-21 Add some #defines for clarity in assembler
2021-05-21 Fix 320 pixel ntsc artifact & refactor ntsc code
    [geometry.c, osd.c]
2021-05-23 Fix issues with new NTSC artifact code that stopped Tandy CoCo profiles working
    [geometry.c]
2021-05-23 Fix issue with 6847 palettes background colour
    [osd.c]
2021-05-24 Update yuv driver
2021-05-28 Finalise support for Apple IIc line by line artifact switching
2021-06-12 V1.1 Updates to improve picture quality and eliminate the need for excessive overclocking
    [videoslotadapter.kicad_pcb, videoslotadapter.sch]
2021-06-16 Rearrange bit flags and add single button timing set switch
2021-06-17 Reduce display time for timing set switch
2021-06-18 Fix issue with saving sampling phase >7 on 6847 profiles
    [cpld_yuv.c]
2021-06-30 Add Apple IIGS auto switching support and fix some artifact switching bugs
    [cpld_yuv.c, defs.h, osd.c, rgb_to_hdmi.c]
2021-07-07 Further support for 1bpp vsync and auto config sample phasing
2021-07-07 Ignore flashing cursors when auto calibrating
2021-07-07 Optimise line capture loop and fix edge bug in NTSC artifact mode
    [defs.h]
2021-07-08 Fix some bugs with CPLD driver
    [cpld_rgb.c]
2021-07-08 Fix more bugs with RGB CPLD driver
    [cpld_rgb.c]
2021-07-12 NTSC artifact fix defs
    [defs.h]
2021-07-15 Ignore cyan on first couple of pixels in coco artifact mode
2021-07-16 Update led status when no video connected
2021-07-18 Improve 90/270 degree sample phase selection
2021-07-18 Fix black character colour on some 6847 palettes
    [osd.c, osd.h]
2021-07-23 Fix sync detection PLL recalibration
    [rgb_to_fb.h, rgb_to_hdmi.c]
2021-07-24 fix led flicker rate
2021-07-28 Add save config option to auto calibration
2021-07-28 Add calibration reminder
2021-07-30 Increase timeout after calibration
2021-08-02 Fix timing and detection issues with Apple IIGS
    [defs.h]
2021-08-07 Fix issue with divider changing during auto calibrate in mode 7
    [osd.c, rgb_to_hdmi.c]
2021-08-16 Only reduce frame buffer width if min_h_width >533
2021-08-16 Swap B1 and R1 for 9/12bpp into 16bit frame buffer
    [osd.c]
2021-08-17 Add FFOSD support to 9/12bpp capture into 8bpp frame buffer
2021-09-17 Update ABC80.txt
    Updated clk to 11980800Hz and profile to Monochrome
2021-10-30 Update config.txt for Pi zero 2W support
    [config.txt]
2021-10-31 Further updates to config.txt
    [config.txt, default_config.txt]
2021-10-31 fix assembly warnings
2021-11-06 Fix Atari 800 double width sample count
2021-11-06 Exclude Sam Couple from zero 2W profile filter
2021-11-07 Prioritise 3 wide zero error window over single zero error ( issue #247 )
    [cpld_rgb.c]
2021-11-07 Fix issue with osd update during CPLD programming on Pi zero 2W
    [osd.c, osd.h]
2021-11-07 Improve calibration window handling and display window errors
    [cpld_rgb.c, rgb_to_hdmi.c]
2021-11-07 Fix calibration display
2021-11-15 Add vasm assembler for videocore IV
2021-11-16 Fix stall issue with 12bpp capture into an 8bpp frame buffer
2021-11-16 Mark all samples with FINAL_BIT at end of capture
2021-11-16 Update RPI2 support
    [config.txt]
2021-11-16 Add arm capture build option
2021-11-16 Run Arm capture on Pi 1
    [config.txt]
2021-11-16 Run old CPLDs on ARM build only
2021-11-17 Fix Pi4 SD card not working
    [defs.h, rgb_to_hdmi.c]
2021-11-18 Workarounds to get Pi4 running on PLLA
    [rgb_to_hdmi.c]
2021-11-19 Fix RAM speed value
    [info.c, info.h]
2021-11-19 Fix pll calculation on Pi4
    [defs.h, osd.c, rgb_to_hdmi.c]
2021-11-19 Fix Pi2 screen start
    [defs.h]
2021-11-21 Try x12 multiplier in mode7 calibration if either errors or window errors are non zero
    [cpld_rgb.c]
2021-11-21 Change assembly code to use variable peripheral base
2021-11-22 Update scripts
    [config.txt, default_config.txt]
2021-11-22 Improve mode7 auto calibration range + add auto overclock option for Pi 2 & 3
    [config.txt, default_config.txt]
2021-11-24 Update Arm conditional build options
2021-11-24 Update Arm build options and old CPLD folders
2021-11-24 Add build option for ARM capture on Pi4 and add ARM version of config.txt
    [configA.txt]
2021-11-24 Update build options
    [configA.txt]
2021-11-25 Update ARM build limits
2021-11-26 fix prediv not present on pi4
    [rgb_to_hdmi.c]
2021-11-28 Revert to PLLD and change core divider as well as per divider
    [rgb_to_hdmi.c]
2021-11-28 Update 1600x1200@50Hz definition to use specific timing rather than CVT (Fixes glitch in rpi4)
2021-11-28 Disable unaligned access (may not work across armv6-v8 on same binary)
    [rgb_to_hdmi.c]
2021-12-01 Fix display of refresh rate
    [rgb_to_hdmi.c]
2021-12-04 Fix 10.3 compiler string warnings
    [defs.h, filesystem.c, osd.c]
2021-12-07 Fix display list issue stopping resolutions 1024x768 & lower from working at 16bpp
    [rgb_to_hdmi.c]
2021-12-07 Increase delay before rebooting
    [rgb_to_hdmi.c]
2021-12-07 Improve disable_overclock feature
    [config.txt, configA.txt, default_config.txt]
2021-12-07 Filter out PaxHeader folders
2021-12-08 Fix regression that caused a hangup on double reboot
    [rgb_to_hdmi.c]
2021-12-09 Update config.txt files
    [config.txt, configA.txt, default_config.txt]
2021-12-09 Rename to "Inverted composite"
    [geometry.c]
2021-12-15 Fix OSD not displayed on screencaps in 4 & 8 bpp modes
    [osd.c]
2021-12-16 Add batch files to switch between GPU and ARM capture
2021-12-16 Fix powerup message not working on some configurations
    [defs.h, rgb_to_fb.h, rgb_to_hdmi.c]
2021-12-17 Fix startup message in interlaced mode
    [rgb_to_hdmi.c]
2021-12-17 Further fix of startup message
    [rgb_to_hdmi.c]
2021-12-18 Update config files to workaround unprogrammed otp zeros
    [config.txt, configA.txt, default_config.txt]
2021-12-18 Ensure top bits of frame buffer address match
2021-12-18 Fix framebuffer logging and display_list_offset
    [rgb_to_hdmi.c]
2021-12-19 Set top bits of screen buffer pointer correctly in 16bpp mode
    [rgb_to_hdmi.c]
2021-12-20 Fix osd update for screencap and reboot warning
    [filesystem.c, osd.c, rgb_to_hdmi.c]
2021-12-20 Update Analog V3 board with changed component values from wiki
    [analog.kicad_pcb, analog.sch]
2021-12-31 Add 50Hz Intellivision profile
2022-01-15 Add C128 profile for 60Hz PETSCII Robots
2022-01-15 Move timer start
2022-01-22 Add full CGA artifact decoding using reenigne's code (Requires multicore Pi such as Pi zero 2W - doesn't work on original Pi zero)
    [defs.h, osd.c, osd.h, rgb_to_fb.h, rgb_to_hdmi.c, vid_cga_comp.c, vid_cga_comp.h]
2022-01-24 Fix YUV & RGB incorrect bit order in NTSC artifact code
    [rgb_to_hdmi.c, vid_cga_comp.c]
2022-02-14 Fix grey screen standby not working on c0pperdragon board
2022-03-09 swap r and b bits in artifact processing
    [vid_cga_comp.c]
2022-03-12 Initial assembler version of NTSC artifact code
2022-03-27 Make vsync polarity detection switchable
2022-05-10 Fix issue with simple mode detected in CPLD mode
    [cpld.h, rgb_to_hdmi.c]
2022-05-14 Clock fixer initial schematic
    [Clock_fixer.kicad_pcb, Clock_fixer.sch]
2022-05-16 Updated clock fixer circuit
    [Clock_fixer.kicad_pcb, Clock_fixer.sch]
2022-05-22 Update clock fixer schematic
    [Clock_fixer.kicad_pcb, Clock_fixer.sch]
2022-06-09 Fix incorrect sampling mode selection in analog mode
    [cpld_rgb.c]
2022-11-27 Fix multicore ntsc artifact on PI4
    [defs.h, rgb_to_hdmi.c]
2022-12-07 Fix issue with 1600x1200 unable to genlock to 61Hz
    [config.txt, configA.txt, default_config.txt]
2022-12-21 Fix v11 compiler build issues
    [vid_cga_comp.c, vid_cga_comp.h]
2023-02-24 Update resolution and config files
    [config.txt, configA.txt, default_config.txt]
2023-02-24 Add auto detect support for 2560x1440 monitors and improve auto overscan settings in 16bpp modes to reduce video DMA bandwidth
2023-02-24 Fix issue with overscan settings not changing frame buffer
    [rgb_to_hdmi.c]
2023-02-25 Refactor autoswitch, debug, powerup message & num buffers
2023-02-25 Refactor vsync indicator, scanlines, scanline level, output colour & output invert
    [geometry.c, osd.c, rgb_to_hdmi.c, rgb_to_hdmi.h]
2023-02-25 Refactor crop border, swap aspect, screencap size, mode7 scaling and normal scaling
    [filesystem.c, geometry.c, geometry.h, osd.c, rgb_to_hdmi.c]
2023-02-25 Refactor palette, tint, saturation, contrast, brightness gamma, return position, button reversal
    [osd.c, osd.h, rgb_to_hdmi.c, vid_cga_comp.c]
2023-02-28 Fix profile save bug
    [filesystem.c]
2023-03-01 Fix mode7 width bug with 16bpp overscan adjustment
    [geometry.c]
2023-03-01 Further mode7 width bugfix
    [geometry.c]
2023-03-01 Fix mode7 OSD not clearing under certain conditions
    [osd.c]
2023-03-02 Rework cpld name prefix handling
    [cpld_atom.c, cpld_null.c, cpld_rgb.c, cpld_simple.c, cpld_yuv.c, defs.h, filesystem.c, filesystem.h]
2023-03-02 Fix bug that stopped dedicated Atom converter from loading its profile
    [osd.c]
2023-03-02 Move CPLD menu to settings and restore Test 50Hz to main menu
2023-03-03 Fix CPLD recovery menu
    [osd.c]
2023-03-03 Add 4K@25-30Hz resolution and update 1920x2160 resolution
2023-03-03 Genlock now works with half frame rate modes
2023-03-03 Ensure stable phase relationship between source and Pi syncs when 4K 25Hz or 30Hz output in use
2023-03-03 Drop alternate frames when display is 4K@ 25/30Hz to prevent tearing
    [rgb_to_hdmi.c]
2023-03-07 Add CPLD not fitted detection
    [rgb_to_hdmi.c]
2023-03-08 Add soft reset option using SW1 & SW3
    [rgb_to_fb.h, rgb_to_hdmi.c]
2023-03-08 Fix saved profile message
    [osd.c]
2023-03-10 Added 6-bit digital profile for Pico Atom VGA with Dave's latest firmware
2023-03-10 Improve CPLD not fitted detection
    [defs.h, osd.c, rgb_to_hdmi.c]
2023-03-10 Update GPU/ARM switching
2023-03-10 Update ARM capture message
2023-03-12 Fix some updated compiler build errors
    [cpld_simple.c, filesystem.c, logging.c, osd.c, rgb_to_hdmi.c, update_cpld.c]
2023-03-17 Set alignment offset to 0 during calibration only when in BBC mode
2023-03-22 Improve hsync polarity detection to work with composite sync and ensure sync timing measured with correct sync polarity
    [rgb_to_hdmi.c]
2023-03-23 Add some stubs to fix compiler warnings
    [armc-cstubs.c]
2023-03-23 Correct arm stubs
2023-03-24 Fix some overscan issues in 16bpp mode with double width capture
    [geometry.c]
2023-03-24 Fix screencaps with cropped borders in 16bpp mode
    [filesystem.c]
2023-04-16 Add mono board detection and update palette generation
2023-04-20 Update profiles for mono board
2023-04-20 Add mono board detection
2023-06-27 Update Laser 128 profile
2023-07-22 Improve Swap Aspect, fix integer scaling issue & add 3 level mono bright palette
    [geometry.c, osd.c, osd.h]
2023-07-22 Fix autoswitch not working with 4K monitor @25/30Hz
    [defs.h, rgb_to_hdmi.c]
2023-07-25 Fix cursor detection on Commodore 128
    [rgb_to_hdmi.c]
2023-07-29 Fix 6847 palette generation
    [osd.c]
2023-07-30 Fix widescreen integer scaling issue
    [geometry.c]
2023-09-16 Fix Apple II direct connection artifact switching
2023-09-18 Reboot immediately if no HDMI connection
    [rgb_to_hdmi.c]
2023-09-18 Fix scalines not working with Atari 800
    [geometry.c, osd.c]
2023-10-12 Add atari 2600 palettes + increase lines per frame tolerance
    [geometry.c, osd.c, osd.h]
2023-10-16 Fix some issues with offset calculation in create profile menu
    [osd.c]
2023-10-18 Fix scanlines not working on C64
    [osd.c]
2023-10-21 Add profile creation hints page & fix screen redraw when changing size
    [osd.c, rgb_to_hdmi.c]
2023-10-26 Fix lumacode H offset
    [geometry.c, osd.c, osd.h]
2023-10-26 Workaround scaling issue on 4K monitors
    [geometry.c]
2023-10-29 Fix no profile matched message
    [rgb_to_hdmi.c]
2023-11-05 Turn on mode 7 led on bootup
2023-11-06 Fix clipping of capture size with non standard number of lines
    [filesystem.c, rgb_to_hdmi.c]
2023-11-08 Add film mode 25/30Hz
2023-11-10 Change film mode to drop frame & fix frame detection
    [osd.c, osd.h, rgb_to_hdmi.c]
2023-11-11 Fix vsync width measurement when sync inverted
    [rgb_to_hdmi.c]
2023-11-11 Fix screencap message when scanlines enabled
    [filesystem.c, osd.c]
2023-11-12 Work around inverted sync measurement
    [rgb_to_hdmi.c]
2023-11-13 Fix incorrect sync polarity detection during hot plugging
    [cpld_rgb.c, cpld_yuv.c, rgb_to_hdmi.c]
2024-01-12 Fix some issues with low cost 4K audio embedder
    [osd.c]
2024-02-08 Fix monitor power up EDID issue
    [osd.c]
2024-02-08 Further monitor power up fixes + fix auto scaling
    [geometry.c, osd.c, rgb_to_hdmi.c]
2024-02-08 Fix scaling issue with 15Khz modes
    [geometry.c]
