hoglet67/RGBtoHDMI/(notices)

Notices in the files:
kicad_analog_6bit/V2/analog.kicad_pcb:
MAX5259 DAC Issue 2 ©2019 IanB
Kicad_6Bit/v4/rgb-to-hdmi.kicad_pcb:
© 2018-20
kicad_Extender_3_bit_buffer/V1/buffer.kicad_pcb:
Issue 1 ©2020 IanB
Kicad_Atari_ST_12Bit_UnBuffered_Pickup/V1/atari-pickup.kicad_pcb:
Issue 1 (C) 2021 IanB
kicad_Extender_PC_buffer/V2/buffer.kicad_pcb:
Issue 2 ©2020 IanB
kicad_atom/v2/rgb-to-hdmi.kicad_pcb:
(c) 2019 Hoglet
kicad_analog_6bit/V1/analog.kicad_pcb:
MAX9144 / MAX9108 Issue 1 ©2019 IanB
kicad_analog_6bit/V3/analog.kicad_pcb:
MAX5259 DAC Issue 3 ©2020 IanB
kicad/v4/rgb-to-hdmi.kicad_pcb:
© 2018
